ppsilv/Orion68/docs/VGA/pinout_PI_pico_2_01.jpg

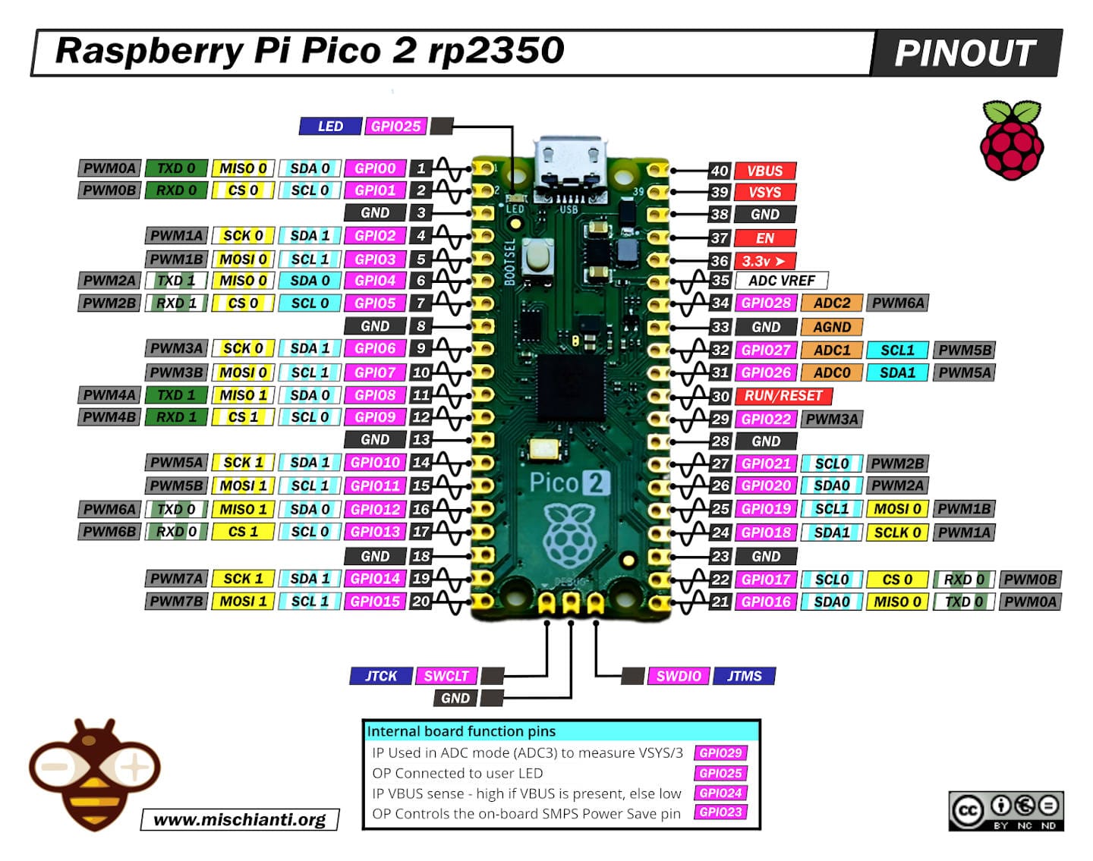
docs/VGA/pinout_PI_pico_2_01.jpg
