ppsilv/Orion68/docs/VGA/pinout_PI_pico_2.jpg

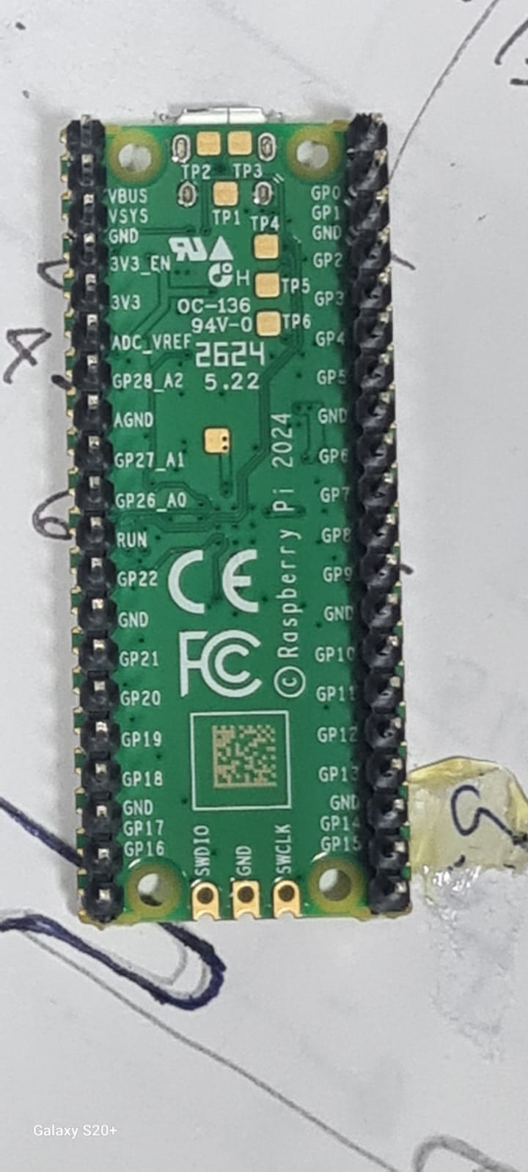
docs/VGA/pinout_PI_pico_2.jpg
