ppsilv/Orion68/README.md

# Orion68
Orion68 a litle system for mc68000

-software

|--dev

|    |--kernel -----> Ambiente de compilação do kernel e de aplicações para o kernel usando libc_pic

|    |--orioncore---> Ambiente de compilação do orioncor e de aplicações para o orioncore usando libcbios nopic

|--include

|--lib

|--libs

     |--libc_pic
     
     |--libm68
     
     |--liborion

2025/10/12: aparentemente essa foi a última versão que kernel carregou e rodou duart.elf
