ppsilv/Orion68/hardware/schematics/Readme.md

Terminação Passiva no Backplane:

    Mantenha o barramento "limpo" nas placas periféricas.
    No final do barramento físico (Slot 9), coloque as redes resistivas de 10k.
    Isso garante que, mesmo com o Orion68K vazio, os sinais críticos de controle não fiquem flutuando.

A Interface de Disco (MIDE/IDE):

    Hardware: Dois 74HC245 fazendo a ponte entre o barramento de dados do 68000 e o conector IDE.
    Byte-Swap: Desenhe as conexões invertidas entre os 245 e o conector (D15-D8 do 68k no D7-D0 do IDE).
    Atenção: No esquema, coloque uma nota bem visível sobre essa inversão para que, no futuro, você saiba que o acesso aos registros de 8 bits do IDE será feito via endereços pares (UDS ativo).
