ppsilv/Orion68/software/src/kernel/Docs/structure.md

## 🎯 **Resposta Curta:**

**A VFS (Virtual File System) e os drivers (NULL, zero, serial) DEVEM ficar no KERNEL.**

O que fica na **lib para usuário** são as **wrappers** (`fopen()`, `fwrite()`, `read()`, etc.) que fazem chamadas de sistema (syscalls) para o kernel.

---

## 🏗️ **Arquitetura Correta:**

```
+------------------------------------------+
|           PROGRAMA DE USUÁRIO             |
|  fopen(), fread(), fwrite(), fclose()     | ← Biblioteca C (libc)
+------------------+-----------------------+
                   | syscall (trap)
                   ↓
+------------------------------------------+
|              KERNEL (Orion68DOS)          |
|  sys_open(), sys_read(), sys_write()      | ← Sistema de Chamadas
+------------------+-----------------------+
|  VFS Layer (abstração)                    | ← Gerencia todos os arquivos
|  - mount points                           |
|  - file descriptors                       |
+------------------+-----------------------+
|  Drivers (device files)                   | ← Driver específico do hardware
|  - driver_null.c                          |
|  - driver_zero.c                          |
|  - driver_serial.c                        |
|  - driver_disk.c                          |
+------------------+-----------------------+
|           HARDWARE                        |
|  - UART, Disco, NULL, Zero               |
+------------------------------------------+
```

---

## 📚 **O que cada camada faz:**

### **1. Kernel: VFS + Drivers**

```c
// NO KERNEL (Orion68DOS):

// ============================================================
// VFS Layer - Gerencia todos os arquivos
// ============================================================
typedef struct {
    char name[32];
    int (*open)(const char *path, int flags);
    int (*read)(int fd, void *buf, size_t count);
    int (*write)(int fd, const void *buf, size_t count);
    int (*close)(int fd);
    // ...
} vfs_ops_t;

typedef struct {
    vfs_ops_t *ops;
    void *private_data;  // Dados específicos do driver
    int ref_count;
} file_handle_t;

// Tabela de arquivos abertos (no kernel)
file_handle_t file_table[MAX_FILES];

// ============================================================
// Drivers (implementam as operações VFS)
// ============================================================

// Driver NULL - /dev/null
int null_open(const char *path, int flags) { return 0; }
int null_read(int fd, void *buf, size_t count) { return 0; }  // Sempre 0 bytes
int null_write(int fd, const void *buf, size_t count) { return count; } // "Suce$$o"

vfs_ops_t null_ops = {
    .open = null_open,
    .read = null_read,
    .write = null_write,
    .close = null_close,
};

// Driver ZERO - /dev/zero
int zero_read(int fd, void *buf, size_t count) {
    memset(buf, 0, count);  // Preenche com zeros
    return count;
}

vfs_ops_t zero_ops = {
    .read = zero_read,
    // write não implementado (retorna erro)
};

// Driver SERIAL - /dev/ttyS0
int serial_open(const char *path, int flags) {
    // Inicializa UART
    uart_init();
    return 0;
}

int serial_read(int fd, void *buf, size_t count) {
    // Lê da UART
    return uart_read(buf, count);
}

int serial_write(int fd, const void *buf, size_t count) {
    // Escreve na UART
    return uart_write(buf, count);
}

vfs_ops_t serial_ops = {
    .open = serial_open,
    .read = serial_read,
    .write = serial_write,
    .close = serial_close,
};

// ============================================================
// Tabela de drivers registrados no VFS
// ============================================================
typedef struct {
    const char *path;
    vfs_ops_t *ops;
} device_table_t;

device_table_t devices[] = {
    {"/dev/null", &null_ops},
    {"/dev/zero", &zero_ops},
    {"/dev/ttyS0", &serial_ops},
    // ...
};

// ============================================================
// Chamadas de sistema (syscalls)
// ============================================================
int sys_open(const char *path, int flags) {
    // Procura o driver pelo path
    for (int i = 0; i < NUM_DEVICES; i++) {
        if (strcmp(path, devices[i].path) == 0) {
            // Encontrou! Abre o arquivo
            int fd = find_free_fd();
            file_table[fd].ops = devices[i].ops;
            file_table[fd].ops->open(path, flags);
            return fd;
        }
    }
    return -1;  // Arquivo não encontrado
}

int sys_read(int fd, void *buf, size_t count) {
    if (fd < 0 || fd >= MAX_FILES) return -1;
    if (file_table[fd].ops == NULL) return -1;
    return file_table[fd].ops->read(fd, buf, count);
}

int sys_write(int fd, const void *buf, size_t count) {
    if (fd < 0 || fd >= MAX_FILES) return -1;
    if (file_table[fd].ops == NULL) return -1;
    return file_table[fd].ops->write(fd, buf, count);
}

int sys_close(int fd) {
    if (fd < 0 || fd >= MAX_FILES) return -1;
    if (file_table[fd].ops == NULL) return -1;
    file_table[fd].ops->close(fd);
    file_table[fd].ops = NULL;
    return 0;
}
```

---

### **2. Biblioteca de Usuário (libc)**

```c
// NA LIBC (biblioteca do usuário):

// ============================================================
// Wrappers para syscalls (em assembly ou C)
// ============================================================
int open(const char *path, int flags) {
    // Chama syscall SYS_OPEN
    return syscall(SYS_OPEN, path, flags);
}

int read(int fd, void *buf, size_t count) {
    return syscall(SYS_READ, fd, buf, count);
}

int write(int fd, const void *buf, size_t count) {
    return syscall(SYS_WRITE, fd, buf, count);
}

int close(int fd) {
    return syscall(SYS_CLOSE, fd);
}

// ============================================================
// Funções de alto nível (usam as syscalls)
// ============================================================
FILE *fopen(const char *path, const char *mode) {
    int flags = mode_to_flags(mode);
    int fd = open(path, flags);
    if (fd < 0) return NULL;
    
    FILE *f = malloc(sizeof(FILE));
    f->fd = fd;
    // ... inicializa buffer, etc.
    return f;
}

size_t fread(void *ptr, size_t size, size_t nmemb, FILE *stream) {
    return read(stream->fd, ptr, size * nmemb);
}

size_t fwrite(const void *ptr, size_t size, size_t nmemb, FILE *stream) {
    return write(stream->fd, ptr, size * nmemb);
}

int fclose(FILE *stream) {
    int result = close(stream->fd);
    free(stream);
    return result;
}
```

---

### **3. Programa de Usuário**

```c
// PROGRAMA DE USUÁRIO (usa a libc):

#include <stdio.h>   // fopen, fread, etc.
#include <unistd.h>  // read, write (syscalls)

// Usando funções de alto nível (libc)
void test_high_level() {
    FILE *f = fopen("/dev/ttyS0", "r");
    if (f) {
        char buffer[256];
        fread(buffer, 1, 256, f);
        printf("Lido: %s\n", buffer);
        fclose(f);
    }
}

// Usando syscalls diretamente (também funciona)
void test_low_level() {
    int fd = open("/dev/null", O_WRONLY);
    if (fd >= 0) {
        write(fd, "Isso vai pro /dev/null", 22);
        close(fd);
    }
}
```

---

## ⚖️ **Por que no KERNEL e não na lib?**

| Razão | Explicação |
|---|---|
| **Privilégio** | Drivers acessam hardware (requer privilégio) |
| **Isolamento** | Um driver com bug não deve travar o sistema |
| **Compartilhamento** | Múltiplos processos usam o mesmo driver |
| **Segurança** | O kernel controla quem acessa o quê |
| **Uniformidade** | Todos os arquivos usam a mesma interface (VFS) |

---

## 🔍 **O que fica na lib do usuário?**

+-------------------------------+-----------+-------------------------------------+
| Componente | Onde fica | Exemplo |
|---|---|---|
| **VFS + Drivers** | KERNEL | open(), read(), write() syscalls |
+-------------------------------+-----------+-------------------------------------+
| **Syscall Wrappers**          | LIBC      | open(), read(), write() (funções C) |
|                               | TRAPS     | chamam as traps do SO               |
+-------------------------------+-----------+-------------------------------------+
| **Bufferização**              | LIBC      | fread(), fwrite() (com buffer)      |
+-------------------------------+-----------+-------------------------------------+
| **Formatação**                | LIBC      | printf(), scanf()                   |
+-------------------------------+-----------+-------------------------------------+
| **Gerenciamento de arquivos** | LIBC      | FILE* (malloc, etc.)                |
+-------------------------------+-----------+-------------------------------------+
---

## 🎯 **Cenário: Seu Orion68DOS**

**Seu sistema DEVE ter:**

```c
// NO KERNEL:
vfs_t vfs;                    // VFS no kernel
device_table_t devices[];     // Drivers no kernel
sys_open(), sys_read(), etc.; // Syscalls no kernel

// NA LIBC:
int open() { return syscall(SYS_OPEN, ...); }
int read() { return syscall(SYS_READ, ...); }
FILE *fopen() { ... }         // Usa open() syscall
```

**NÃO faça:**

```c
// NUNCA! (driver na lib do usuário)
// Isso quebra a segurança e o isolamento
int serial_write(...) {
    // Acessa hardware diretamente da lib!
    UART_DATA = data;  // ← ISSO É PERIGOSO!
}
```

---

## 💡 **Conclusão:**
+----------------------------------+----------------+----------------------------------------+
| Componente | Deve ficar no..| Por quê? |
|---|---|---|
| **VFS** | Kernel | Gerencia todos os arquivos do sistema  |
| **Drivers (NULL, ZERO, SERIAL)** | Kernel | Acessam hardware e recursos do sistema |
| **Syscalls (open, read, write)** | Kernel | Entrada para o kernel |
| **Wrappers (libc)** | Lib de usuário | Interface amigável para programas |
| **Bufferização (fopen, fread)**  | Lib de usuário | Performance (cache) |
+----------------------------------+----------------+----------------------------------------+
**Essa separação é FUNDAMENTAL para qualquer sistema operacional!** 🎯

## kernel structure
orion68dos/
├── kernel/
│   ├── include/
│   │   ├── limits.h     ← Coloque aqui
│   │   └── errno.h      ← Coloque aqui (opcional)
│   └── lib/
│       └── strtol.c
└── ...
