ppsilv/Orion68/docs/DriverInterfaceKernel.odt

Isso é **exatamente** o que o Linux faz e é uma sacada genial. Vou te mostrar como implementar isso no seu Orion68 de forma simples, sem precisar de ELF relocável completo (que é o que o Linux faz de verdade). Você tem **duas abordagens**:

## Abordagem 1: Tabela de símbolos "na mão" (mais simples e didática)

Em vez de exportar via ELF relocável, você cria uma **tabela de ponteiros para funções** com nomes, e o kernel disponibiliza essa tabela para os drivers. O driver faz `lookup("kmalloc")` e recebe o ponteiro.

### Passo 1: Estrutura da tabela

```c

/* kexports.h */

#ifndef KEXPORTS_H

#define KEXPORTS_H

#include <stdint.h>

typedef struct {

const char *nome;

void *endereco;

} kexport_t;

/* O driver chama isso para pegar o endereço de uma função do kernel */

void *kexport_lookup(const char *nome);

#endif

```

### Passo 2: Macro para registrar símbolos

```c

/* kexports.c */

#include "kexports.h"

#include <string.h>

#include <stddef.h>

/* Tabela em .data, preenchida pelo linker via seção .kexports */

extern kexport_t __kexports_start[];

extern kexport_t __kexports_end[];

void *kexport_lookup(const char *nome) {

kexport_t *p = __kexports_start;

while (p < __kexports_end) {

if (strcmp(p->nome, nome) == 0) {

return p->endereco;

}

p++;

}

return NULL;

}

```

### Passo 3: Macro para o kernel exportar

```c

/* kexports.h (continuação) */

#define EXPORT_SYMBOL(nome) \

static kexport_t __kexport_##nome \

__attribute__((section(".kexports"), used)) = { \

#nome, (void *)&nome \

}

```

Uso no kernel:

```c

/* kfunctions.c */

void *kmalloc(uint32_t size) { ... }

EXPORT_SYMBOL(kmalloc);

void kernel_puts(const char *s) { ... }

EXPORT_SYMBOL(kernel_puts);

void kernel_putchar(char c) { ... }

EXPORT_SYMBOL(kernel_putchar);

```

### Passo 4: Linker script coleta a seção

No seu `kernel.ld`, adicione:

```ld

.kexports : {

__kexports_start = .;

KEEP(*(.kexports))

__kexports_end = .;

} > USERRAM :text

```

### Passo 5: O driver consulta

Como o driver vai ser um **processo separado**, você precisa decidir como ele **acessa** essa tabela. Duas opções:

**Opção A: o kernel passa o endereço da tabela via syscall**

```c

/* no driver (user mode) */

typedef struct { const char *nome; void *endereco; } kexport_t;

kexport_t *tabela = (kexport_t *)sys_get_kexports();

void *kmalloc_ptr = NULL;

for (int i = 0; tabela[i].nome; i++) {

if (strcmp(tabela[i].nome, "kmalloc") == 0) {

kmalloc_ptr = tabela[i].endereco;

break;

}

}

```

Mas isso exige que o driver **possa ler a memória do kernel**, o que é OK no seu caso (sem MMU, tudo compartilha o mesmo espaço).

**Opção B: o kernel expõe uma syscall `kexport_lookup(nome)`**

```c

/* no driver (user mode) */

void *kmalloc_ptr = (void *)sys_kexport_lookup("kmalloc");

```

Isso é mais limpo e não expõe a tabela inteira. O kernel faz o lookup e devolve o ponteiro.

**Recomendo a Opção B** — é mais elegante e mais parecido com o que o Linux faz (o kernel resolve os símbolos, o módulo não precisa varrer nada).

Para o Orion68, dado o estágio atual:

| Abordagem | Complexidade | Quando usar |

| **Tabela de símbolos + `sys_kexport_lookup`** | Baixa | Agora, para aprender o conceito |

| **ELF relocável + relocação** | Alta | Depois, quando quiser o "estilo Linux" de verdade |

**Recomendo começar pela Abordagem 1 (Opção B)**. É simples, didática, e te dá 90% do benefício. Você:

1. Cria a tabela `.kexports` no kernel

2. Exporta `kmalloc`, `kernel_puts`, `kernel_putchar`, etc.

3. Adiciona uma syscall `sys_kexport_lookup(nome)` que devolve o ponteiro

4. O driver (rodando como processo) chama a syscall e guarda o ponteiro

5. O driver chama a função do kernel **diretamente** pelo ponteiro

Isso é **exatamente** o que o Linux faz, só que sem o ELF relocável. O driver pega o endereço via syscall em vez de via relocação no carregamento.

## Detalhe importante: chamar função do kernel de user mode

Se o driver roda em **modo usuário**, chamar diretamente uma função do kernel (via ponteiro) **pode não funcionar** se:

- A função do kernel usa instruções privilegiadas

- A função do kernel acessa a pilha do supervisor (SSP), não a do usuário

- A função do kernel depende de estar em modo supervisor

No seu caso, como você **não tem MMU** e provavelmente **tudo roda em supervisor** (você mesmo confirmou antes), chamar direto funciona. Mas se um dia você implementar modo usuário de verdade, vai precisar que essas funções sejam **syscalls** (trap) em vez de chamadas diretas.

**Ou seja**: a tabela de exportados é útil para **drivers que rodam em modo supervisor** (kernel modules). Para **drivers que rodam em modo usuário**, o acesso tem que ser via **syscall** (trap), não via ponteiro direto.

## Exemplo completo, mínimo

```c

/* kexports.h */

#ifndef KEXPORTS_H

#define KEXPORTS_H

#include <stdint.h>

typedef struct {

const char *nome;

void *endereco;

} kexport_t;

void *kexport_lookup(const char *nome);

#define EXPORT_SYMBOL(nome) \

static kexport_t __kexport_##nome \

__attribute__((section(".kexports"), used)) = { \

#nome, (void *)&nome \

}

#endif

```

```c

/* kexports.c */

#include "kexports.h"

#include <string.h>

extern kexport_t __kexports_start[];

extern kexport_t __kexports_end[];

void *kexport_lookup(const char *nome) {

kexport_t *p = __kexports_start;

while (p < __kexports_end) {

if (strcmp(p->nome, nome) == 0)

return p->endereco;

p++;

}

return NULL;

}

```

```ld

/* kernel.ld -- dentro de SECTIONS */

.kexports : {

__kexports_start = .;

KEEP(*(.kexports))

__kexports_end = .;

} > USERRAM :text

```

```c

/* kfunctions.c */

#include "kexports.h"

void *kmalloc(uint32_t size) { /* ... */ }

EXPORT_SYMBOL(kmalloc);

void kernel_putchar(char c) { /* ... */ }

EXPORT_SYMBOL(kernel_putchar);

```

```c

/* syscall no kernel */

void *sys_kexport_lookup(const char *nome) {

return kexport_lookup(nome);

}

```

```c

/* driver (user mode) */

void *(*meu_kmalloc)(uint32_t);

void driver_init(void) {

meu_kmalloc = (void *(*)(uint32_t))syscall(SYS_KEXPORT_LOOKUP, "kmalloc");

if (!meu_kmalloc) {

/* erro: kmalloc nao exportado */

}

void *p = meu_kmalloc(100);

/* ... */

}

```

## Resumindo

- **Kernel exporta** funções via macro `EXPORT_SYMBOL` numa seção `.kexports`.

- **Tabela** é coletada pelo linker e varrida em runtime.

- **Driver** pega o endereço via **syscall** `sys_kexport_lookup(nome)` (ou via tabela exposta, se preferir).

- **Driver chama** a função diretamente pelo ponteiro — funciona porque não há MMU e tudo está em supervisor.

- **Estilo Linux** (ELF relocável + relocação no `insmod`) é o próximo nível, bem mais complexo.

Isso te dá o mesmo poder do Linux (drivers carregáveis que usam funções do kernel) com **muito menos** código. Quando você tiver tempo e quiser o desafio, aí sim parte para o ELF relocável de verdade.

Se quiser, te ajudo a implementar a syscall `sys_kexport_lookup` e adaptar o `spawn` para passar a tabela de exports para o driver.
