ppsilv/Orion68/docs/SegundoHardDisk.odt

Boa pergunta — e a resposta é mais simples do que parece, porque aqui você não está sujeito às limitações reais de um dispositivo ATA físico. No ata.c os registradores são "feios" (offsets ímpares, CYL_HIGH/CYL_LOW/SECTOR_NUM em vez de LBA direto) porque isso é herança do padrão ATA real, com barramento de 16 bits e byte lane fixo. No seu caso, o Pico2W é firmware seu dos dois lados — você define o protocolo do zero, então pode fazer algo bem mais limpo.

## Por que menos registradores bastam

O SD card já é endereçado nativamente por LBA (bloco), não por CHS. Então você não precisa imitar CYL_HIGH/CYL_LOW/SECTOR_NUM — pode ter direto 3 ou 4 bytes de LBA.

## Mapa de registradores sugerido (base 0xFF9100)

Offset | Nome | R/W | Descrição
+0x00 | SD_REG_DATA | R/W | porta de dados, 1 byte por acesso
+0x01 | SD_REG_LBA0 | W | bits 0–7 do setor
+0x02 | SD_REG_LBA1 | W | bits 8–15
+0x03 | SD_REG_LBA2 | W | bits 16–23
+0x04 | SD_REG_LBA3 | W | bits 24–31 (opcional — só se seu cartão passar de 8GB com 24 bits)
+0x05 | SD_REG_COMMAND / SD_REG_STATUS | W / R | comando ao escrever, status ao ler (igual o ATA_REG_COMMAND/ATA_REG_STATUS do seu ata.c)

Isso dá 6 registradores, cabendo tranquilamente em qualquer faixa que seu 74HC138 decodifique (mesmo a menor faixa de A19-A21 sobra muito espaço).

## Bits sugeridos para COMMAND/STATUS

#define SD_CMD_READ_SECTOR 0x20 // mesmo valor do ATA_CMD_READ_SECTORS, só por familiaridade

#define SD_CMD_WRITE_SECTOR 0x30

#define SD_ST_BUSY 0x80

#define SD_ST_DATA_READY 0x08

#define SD_ST_ERROR 0x01

Você pode até reaproveitar os mesmos bits do ATA_ST_* que já tem — não precisa reinventar.

## O ponto que exige atenção: o BUSY tem que ser de verdade

Isso é o detalhe mais importante e mais fácil de esquecer: no ATA real, o BUSY reflete o hardware fazendo a operação de fato. No seu caso, o Pico2 é quem precisa simular esse comportamento corretamente no firmware:

1. 68k escreve LBA0..LBA3.
2. 68k escreve COMMAND (READ, por exemplo).
3. Pico2 imediatamente deve marcar BUSY=1 no registrador de status (antes de começar a ler o cartão SD).
4. Pico2 lê o setor do SD (isso pode levar alguns ms).
5. Quando os 512 bytes estiverem prontos num buffer interno do Pico, ele seta BUSY=0 e DATA_READY=1.
6. Só então o 68k começa a ler SD_REG_DATA 512 vezes.

Se o Pico não simular esse atraso de forma síncrona com o registrador de status, o seu ATA_WAIT() no lado do 68k vai ler dado lixo (igual aconteceria com um HD real se você ignorasse o BUSY).

## Uma vantagem que você pode aproveitar: 16 bits por acesso

No ata.c seu ATA_REG_DATA de 16 bits só funciona em modo 16-bit por causa de limitação do CF real. No Pico2 você controla os dois lados, então pode simplesmente sempre usar 16 bits no SD_REG_DATA (256 leituras em vez de 512) — mais rápido, sem precisar do go_8bits_mode()/ide_bus_mode que existe só por causa de compatibilidade com hardware ATA de verdade.

## Estrutura de código (paralela ao ata.c)

struct sd_drive drives[SD_MAX_DRIVES];

#define SD_REG_BASE 0x00FF9100

#define SD_REG_DATA ((volatile uint16_t *) (SD_REG_BASE + 0x00))

#define SD_REG_LBA0 ((volatile uint8_t *) (SD_REG_BASE + 0x02))

#define SD_REG_LBA1 ((volatile uint8_t *) (SD_REG_BASE + 0x03))

#define SD_REG_LBA2 ((volatile uint8_t *) (SD_REG_BASE + 0x04))

#define SD_REG_LBA3 ((volatile uint8_t *) (SD_REG_BASE + 0x05))

#define SD_REG_STATUS ((volatile uint8_t *) (SD_REG_BASE + 0x06))

#define SD_REG_COMMAND ((volatile uint8_t *) (SD_REG_BASE + 0x06))

Se quiser, o sd_read_sector()/sd_write_sector() ficam quase idênticos aos do ata.c, só troca o loop de 512 bytes por 256 words e não precisa do go_8bits_mode().

Pergunta antes de eu detalhar mais: você já tem definido o protocolo de comunicação entre o 68k e o Pico2 na ponta física (é bus paralelo tipo o do ATA, ou é SPI/algo serial "traduzido" para parecer bus paralelo pro 68k)? Isso muda um pouco como o BUSY precisa ser tratado no firmware do Pico.

Ótimo, 16+ endereços dá espaço de sobra. Agora dá pra fechar o desenho completo — e tem um ponto de arquitetura importante que aparece exatamente por causa do /DTACK ser controlado por GPIO do Pico.

## O ponto-chave: DTACK rápido ≠ operação rápida

Você pode atrasar o /DTACK à vontade, mas nunca deve atrasá-lo pelo tempo todo de uma leitura de setor do SD (isso pode levar alguns ms). Se você travar o 68k inteiro (via DTACK) por 2-5ms esperando o SD responder, o sistema todo congela — inclusive interrupções, o systick, etc.

Então a divisão de trabalho fica assim, igual você já faz com o ATA_WAIT():

1. DTACK rápido (microssegundos) — cobre só "o Pico leu/escreveu o byte que estava nesse endereço agora". Isso é hardware puro, sempre rápido.
2. BUSY em software (como hoje) — cobre "o SD está de fato lendo o cartão físico". O 68k continua fazendo polling no SD_REG_STATUS, exatamente como o ATA_WAIT() já faz.

Ou seja: escrever no COMMAND retorna rápido (DTACK imediato), o Pico começa a operação de SD em background, e o BUSY no status só cai quando o setor já está pronto num buffer interno do Pico.

## Mapa de registradores final (8 bits cada, endereçável pelas linhas A0-A3+ que você tem)

Addr | Nome | R/W | Descrição
0x0 | SD_REG_DATA | R/W | 1 byte por acesso — porta de dados do setor
0x1 | SD_REG_LBA0 | W | LBA bits 0–7
0x2 | SD_REG_LBA1 | W | LBA bits 8–15
0x3 | SD_REG_LBA2 | W | LBA bits 16–23
0x4 | SD_REG_LBA3 | W | LBA bits 24–31
0x5 | SD_REG_SECTOR_COUNT | W | quantos setores (deixa fixo em 1 por enquanto, mas já sobra espaço pra multi-setor depois)
0x6 | SD_REG_COMMAND / SD_REG_STATUS | W / R | igual seu ATA_REG_COMMAND/ATA_REG_STATUS

7 registradores usados, sobram 9+ endereços livres pra crescer (ex: um SD_REG_DRIVE_SELECT no futuro, já que seu drives[ATA_MAX_DRIVES] sugere que você quer suportar múltiplos dispositivos um dia).

## Fluxo de uma leitura de setor (visto do 68k)

*SD_REG_LBA0 = (uint8_t)(lba);

*SD_REG_LBA1 = (uint8_t)(lba >> 8);

*SD_REG_LBA2 = (uint8_t)(lba >> 16);

*SD_REG_LBA3 = (uint8_t)(lba >> 24);

*SD_REG_SECTOR_COUNT = 1;

*SD_REG_COMMAND = SD_CMD_READ_SECTOR;

while (*SD_REG_STATUS & SD_ST_BUSY) { } // igual seu ATA_WAIT(), mas aqui é o SD de fato trabalhando

if (*SD_REG_STATUS & SD_ST_ERROR) { /* trata erro */ }

for (int i = 0; i < 512; i++) {

buffer[i] = *SD_REG_DATA;

}

Reparou que isso é quase idêntico ao seu ata_read_sector() de hoje — a diferença é que aqui o BUSY é 100% real (o Pico está lendo o cartão), e não precisa do ATA_DELAY() arbitrário porque o /DTACK já garante que cada acesso individual é válido no momento certo.

## Do lado do firmware do Pico

Isso é bem parecido com o que você já fez no seu sistema atual de transferência de arquivo via PIO/FIFO (onde o Orion68DOS pede byte a byte e o Pico alimenta o FIFO) — mesma filosofia: um núcleo (ou a PIO) dedicado a responder o barramento rápido o suficiente pra não perder ciclo do 68k, enquanto o trabalho pesado (aqui, acesso ao SD; lá, TCP/IP) roda por fora, alimentando um buffer.

Faz sentido eu detalhar como estruturar esse lado do Pico (decodificação de endereço via GPIO, quando gerar o /DTACK pra cada tipo de registrador, e como organizar o buffer de 512 bytes)?

Adicionei tudo no final do próprio ata.c, mantendo o padrão que você já usa:

- sd_detect() — espelha o ata_detect()
- sd_read_sector(int sector, char *buffer) / sd_write_sector(int sector, const char *buffer) — mesma assinatura das funções ATA, só troca o BUSY-polling artificial (ATA_DELAY) pelo BUSY real do Pico
- sd_init(), sd_disk_status(), sd_disk_initialize() — espelham ata_init/ata_disk_status/ata_disk_initialize, usando drives[1] em vez de drives[0]

No seu diskio.c, o pdrv decide pra qual conjunto de funções chamar — exatamente como você já sabia:

DSTATUS disk_status(BYTE pdrv) {

switch (pdrv) {

case 0: return ata_disk_status();

case 1: return sd_disk_status();

}

return STA_NOINIT;

}

DRESULT disk_read(BYTE pdrv, BYTE *buff, LBA_t sector, UINT count) {

switch (pdrv) {

case 0: return ata_read_sector(sector, (char *)buff) ? RES_OK : RES_ERROR;

case 1: return sd_read_sector(sector, (char *)buff) ? RES_OK : RES_ERROR;

}

return RES_PARERR;

}

Duas coisas pra verificar antes de testar:

1. Offsets dos registradores — deixei espaçados de 1 byte (SD_REG_BASE + 0x0, +0x1, +0x2...). Se suas linhas de endereço para o Pico estiverem ligadas do mesmo jeito que estão pro ATA_REG_BASE (a partir de A1, pulando A0), você vai precisar multiplicar todos os offsets por 2, senão o Pico vai ver os endereços errados.
2. SD_ST_BUSY real — o SD_WAIT() aqui não tem o ATA_DELAY() de segurança que o ATA_WAIT() tem, porque assumi que o BUSY do Pico é confiável desde o primeiro ciclo depois do COMMAND. Se na prática o Pico levar alguns microssegundos pra sequer levantar o BUSY depois do comando, pode ser que o 68k já passe pelo while antes do bit subir — nesse caso, um pequeno delay entre escrever COMMAND e checar STATUS pela primeira vez resolve.

Principais mudanças em relação ao original:

- Char vs bloco separados dentro de "drivers" — bloco agora tem ide e sd, char ficou com os cinco dispositivos de stream.
- IRQ subindo — a linha tracejada da direita representa a interrupção voltando dos drivers char até o scheduler (tick do systick, dado do teclado chegando, etc.), coisa que não existia no diagrama anterior.
- fatfs entrou como camada entre vfs e o bloco — reflete que quem fala sertor/LBA é o driver, não o VFS.
- net stack entrou entre vfs/syscalls e o w5100 — sem essa camada a aplicação não teria como usar o chip de rede como socket.
- Seta direta syscalls → scheduler — cobre sleep/yield, que hoje não passam pelo task creator.

O que ficou de fora de propósito (pra não virar sopa de setas): o caminho exato char→syscalls (fica implícito, já que char não passa por VFS/FatFS) e a ligação de w5100 de volta pra rede — isso eu deixaria pra um segundo diagrama só de rede, se um dia você for implementar a pilha TCP/IP de verdade.

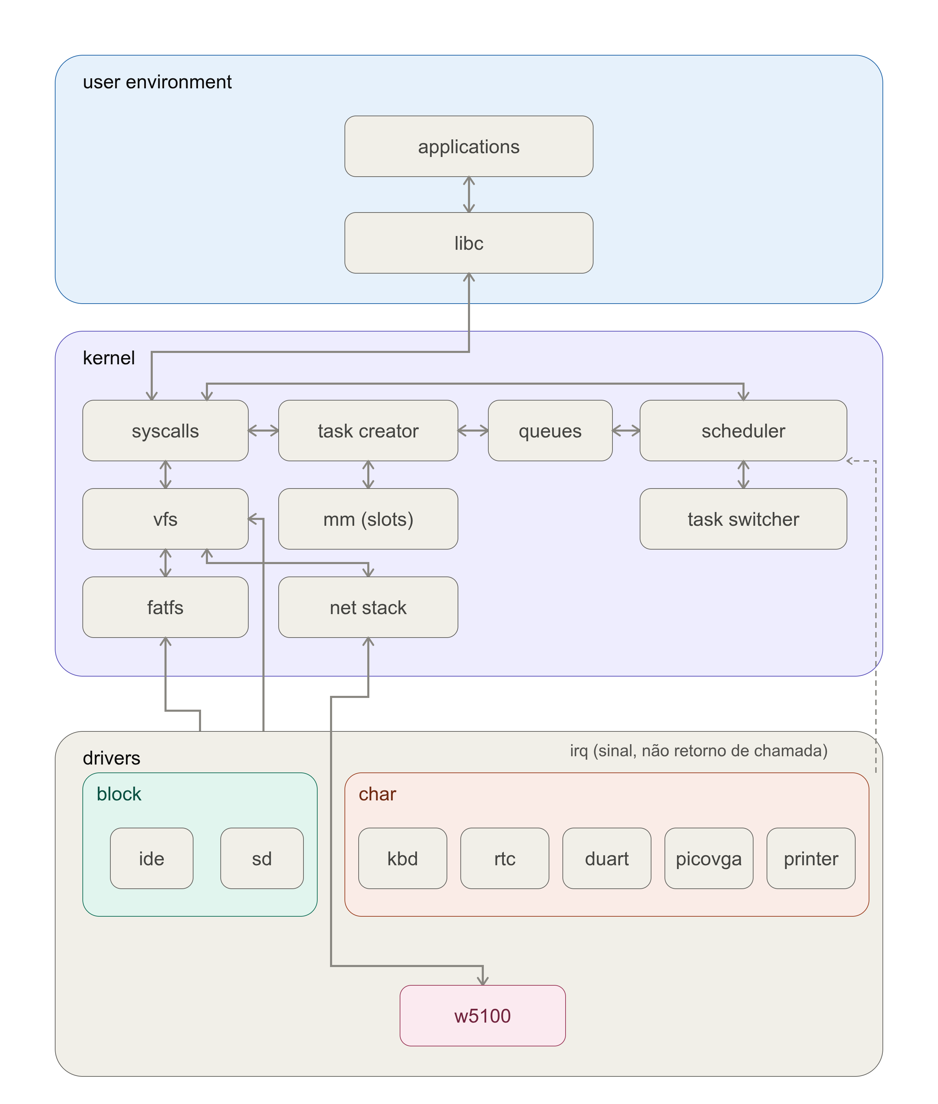
[picture p3: figure]
