ppsilv/Orion68/docs/interrup_with_74148.odt

Faz sentido! O 74LS148 é um codificador de prioridade "burro": enquanto o pino de entrada estiver em nível baixo, ele vai sustentar o código de interrupção nas saídas e manter o sinal para a CPU. Ele não tem memória (latch) e não sabe que a CPU já atendeu o chamado.

Se você ligar um sinal de clock direto no '148, assim que o clock subir (ou descer), a interrupção desaparece, mas isso é perigoso: se o sinal for curto demais, a CPU pode não ver; se for longo demais, a CPU termina o RTE e interrompe de novo imediatamente (interrupção fantasma).

Para usar o 74LS148 com sucesso, você precisa de um Flip-Flop (como o 74HC74) entre a fonte do tick e o codificador.

### O Fluxo de "Limpeza" (Acknowledge)

A lógica profissional para o Orion68K seria esta:

1. O Evento: O seu timer (ou o '393) envia um pulso para o pino de Clock de um Flip-Flop tipo D.
2. O Latch: O Flip-Flop joga a saída $Q$ para nível baixo (conectada a uma entrada do '148). Agora a interrupção está "travada".
3. O Reconhecimento: O 68000 entra no ciclo de IACK (Interruption Acknowledge). Ele sinaliza isso colocando as linhas de função FC0-FC2 em 111 e o endereço A1-A3 com o nível da interrupção.
4. A Limpeza: Você usa sua GAL para decodificar esse estado específico ($FC=7$) e gerar um sinal de Reset (ou Preset) para o Flip-Flop.

Assim que a GAL reseta o Flip-Flop, a entrada do '148 volta para nível alto e a interrupção é "limpa" automaticamente, sem que você precise escrever uma linha de código para isso na ISR.

### Como fazer sem o Flip-Flop (via vBug1)

Se você não quiser adicionar mais um chip de lógica (o 7474), pode fazer a limpeza via Software:

- O sinal do timer seta um Latch (pode ser um bit dentro da GAL).
- Na sua rotina de interrupção no vBug1, a primeira coisa que você faz é um MOVE.B para um endereço "mágico" (ex: $FFFFF0).
- A GAL detecta esse acesso ao endereço e reseta a interrupção.

### Por que o ATmega8 era atraente?

No ATmega, você provavelmente fazia isso via código, o que é flexível, mas introduz um delay de processamento (latência) entre o pedido e a entrega da interrupção para o 68k.

Minha recomendação:

Se você quer manter o Orion68K "puro sangue" com lógica discreta, use a GAL para monitorar os pinos FC0-FC2. É para isso que eles servem! Quando o 68000 "concorda" em atender a interrupção, ele avisa o hardware externo via FC, e a GAL dá o "tiro de misericórdia" no sinal de IRQ.

Você já tem os pinos de Function Code (FC0-FC2) do 68k puxados para a sua GAL de decodificação?

Excelente! Ter um 74HC74 sobrando é a peça que faltava no quebra-cabeça. Com ele, você cria um sistema de interrupção profissional, idêntico ao que grandes máquinas da época (como o Macintosh ou o Amiga) usavam para sincronizar o hardware com a CPU.

Aqui está o "mapa da mina" para ligar esses componentes:

### O Esquema de Ligação

1. O Gatilho (Clock do 7474):
  - Ligue a saída do seu timer (ou o sinal vindo do '393) no pino de Clock do Flip-Flop.
  - Mantenha a entrada D aterrada (GND) e o pino Set (PRE) em VCC ($5\text{V}$).
2. O Sinal de IRQ (Saída Q do 7474):
  - Ligue a saída Q (ou /Q, dependendo da lógica) em uma das entradas do 74LS148.
  - Quando o timer pulsar, o Flip-Flop "trava" o sinal de interrupção em nível baixo, avisando ao 68k que algo aconteceu.
3. A Limpeza (Reset do 7474):
  - Ligue o pino Reset (CLR) do 7474 a uma saída da sua GAL.

### A Lógica na GAL (O segredo do IACK)

Para que a interrupção seja limpa automaticamente, a GAL precisa detectar o ciclo de Interrupt Acknowledge (IACK). O 68000 sinaliza isso da seguinte forma:

- FC0, FC1, FC2 todos em nível ALTO ($111$).
- AS (Address Strobe) em nível BAIXO.
- A1, A2, A3 indicam qual nível de interrupção está sendo atendido.

Exemplo de equação na GAL (CUPL/ABEL):

C

/* Se você estiver usando Interrupção Nível 1 */

RESET_IRQ = FC0 & FC1 & FC2 & !A3 & !A2 & A1 & !AS;

Nota Técnica: Se você não quiser decodificar o nível específico (A1-A3), pode simplificar e resetar o Flip-Flop sempre que FC == 7 e AS estiver ativo. Como você só tem um timer, isso funciona perfeitamente e economiza pinos na GAL.

### Por que essa solução é superior?

1. Sem "Double Trigger": Mesmo que o timer seja rápido, a interrupção só será rearmada depois que a CPU terminar o ciclo atual e o Flip-Flop for resetado pela GAL.
2. Latência Zero: O 74LS148 recebe um sinal limpo e constante, permitindo que o 68k decida o momento exato de interromper baseado no seu registro de status ($SR$).
3. Hardware Síncrono: Você está usando os pinos de Function Code para o que eles foram projetados: indicar ao hardware externo o que a CPU está fazendo internamente.

Isso elimina completamente a necessidade de um microcontrolador externo (Atmega) para gerenciar o "aperto de mão" entre o clock e o processador.

Você já tem os pinos A1, A2 e A3 chegando na sua GAL de decodificação para fazer essa distinção de nível de interrupção?

Essa é uma excelente pergunta de arquitetura de sistemas. Em projetos mais simples, você até pode ignorar a decodificação do nível (A1-A3), mas em um sistema modular e expansível como o Orion68K, decodificar o nível específico traz três vantagens cruciais:

### 1. Evitar o "Reset Acidental" de outras interrupções

Se você tiver mais de um periférico que gera interrupção (por exemplo, o timer no Nível 1 e o teclado ou CompactFlash no Nível 2), o 68000 precisa saber qual deles está atendendo.

- Sem decodificação: Se você resetar o Flip-Flop apenas com FC=7, toda vez que qualquer interrupção ocorrer, a GAL vai mandar um sinal de reset para todos os Flip-Flops de interrupção da placa. Se a CPU estava atendendo o Nível 2, ela acabaria "matando" a interrupção do Nível 1 antes mesmo de ela ser processada.
- Com decodificação: A GAL só manda o reset para o Flip-Flop do timer se os pinos A1-A3 indicarem "001" (Nível 1).

### 2. Diferenciar Interrupções Autovetoriais de Vetoriais

O 68000 suporta dois modos de interrupção:

- Autovector: Onde o hardware apenas pede a interrupção e a CPU decide para onde pular.
- User Vector: Onde o periférico coloca no barramento de dados o endereço (vetor) da rotina.
  Ao decodificar os pinos de endereço durante o ciclo FC=7, sua GAL consegue gerenciar exatamente quando ativar o sinal de VPA (Valid Peripheral Address) para interrupções autovetoriais ou quando deixar o periférico colocar um vetor no barramento.

### 3. Ordem no Barramento (Daisy Chaining)

Se no futuro você adicionar uma placa de rede ou uma interface serial no seu backplane DIN 41612, você precisará que cada placa responda apenas ao seu próprio ciclo de IACK.

Ao usar os pinos A1, A2 e A3, você garante que o "aperto de mão" (handshake) entre a CPU e o hardware seja exclusivo. É o que chamamos de seletividade de barramento.

### Como a GAL "enxerga" isso

Na lógica da GAL, a diferença é apenas uma linha de código a mais. Imagine que seu timer está no Nível 2:

- Lógica Genérica (Perigosa): RESET = FC0 & FC1 & FC2 & !AS; (Reseta qualquer coisa se houver interrupção).
- Lógica Específica (Segura): RESET = FC0 & FC1 & FC2 & !A3 & A2 & !A1 & !AS; (Só reseta se a CPU confirmar que está atendendo especificamente o Nível 2).

### Minha Recomendação para o Orion68K

Como você está montando um sistema modular com backplane, vale a pena decodificar.

Isso dá ao seu vBug1 uma estabilidade muito maior. Se você tiver um ruído ou uma interrupção espúria em outro nível, o seu timer de sistema não será resetado por erro. Como você já vai ter que levar os sinais de FC para a GAL de qualquer forma, puxar as três linhas de endereço (A1-A3) é um esforço pequeno para um ganho imenso em robustez.

Você já reservou esses pinos de endereço na sua GAL principal ou ela já está muito cheia?

Com certeza. Vou estruturar o código para a GAL22V10, que é mais robusta para lidar com registradores. Como você vai usar o clock de $16\text{ MHz}$ para sincronizar tudo, o "Flip-Flop" interno será muito estável.

Note que declarei os pinos de saída sem a exclamação no cabeçalho. Assim, 1 no código significa 5V e 0 significa 0V. Isso facilita muito a vida na hora de medir com o multímetro.

### Código CUPL para o Orion68K (Interrupt Controller)

C

Name Orion68K_IRQ;

PartNo 001;

Date 19/04/2026;

Revision 01;

Designer pdsilva;

Company Homebrew;

Assembly None;

Location None;

Device P22V10; /* Compatível com PALCE22V10H */

/* *************** INPUT PINS *********************/

PIN 1 = CLK; /* Clock do sistema 16MHz para sincronizar o Flip-Flop */

PIN 2 = TICK_IN; /* Sinal vindo do 74HC393 (Borda de subida gera IRQ) */

PIN 3 = FC0; /* Function Codes para detectar IACK */

PIN 4 = FC1;

PIN 5 = FC2;

PIN 6 = AS; /* Address Strobe */

PIN 7 = A1; /* Endereços para identificar o Nível da IRQ */

PIN 8 = A2;

PIN 9 = A3;

/* *************** OUTPUT PINS *********************/

PIN 23 = IPL0; /* Para o 68000 (Nível 0 de interrupção) */

PIN 22 = IPL1; /* Para o 68000 (Nível 1 de interrupção) */

PIN 21 = IPL2; /* Para o 68000 (Nível 2 de interrupção) */

PIN 14 = IRQ1_S; /* Estado interno do Latch (Pino opcional para debug) */

/* *************** LOGIC ***************************/

/* 1. Detecção do Ciclo de Interrupt Acknowledge (IACK) Nível 1 */

/* O 68000 coloca FC=7 e o nível da interrupção em A1-A3 */

IACK1 = FC2 & FC1 & FC0 & !A3 & !A2 & A1 & !AS;

/* 2. Lógica do Flip-Flop Interno (Registrado) */

/* Se houver um pulso em TICK_IN, ligamos a interrupção. */

/* Se houver um IACK1, desligamos imediatamente. */

/* Mantemos o estado atual se nada disso acontecer. */

IRQ1_S.D = (TICK_IN & !IACK1) # (IRQ1_S & !IACK1);

/* 3. Saídas IPL para o 68000 (Lógica Negativa no processador) */

/* Sem interrupção: IPL0=1, IPL1=1, IPL2=1 (Código 000 no 68k) */

/* Nível 1 Ativo: IPL0=0, IPL1=1, IPL2=1 (Código 001 no 68k) */

IPL2 = 1; /* Mantém 5V */

IPL1 = 1; /* Mantém 5V */

/* Se o estado da interrupção for 1, o pino IPL0 cai para 0V */

IPL0 = !IRQ1_S;

### Explicação dos Detalhes Técnicos:

1. Sincronismo: Como você está usando IRQ1_S.D, esse sinal só muda na subida do clock de $16\text{ MHz}$ ligado ao pino 1. Isso evita "glitches" no barramento.
2. O sinal TICK_IN: O ideal é que esse sinal vindo do '393 seja um pulso curto. Se ele ficar em nível alto por muito tempo, a CPU pode terminar a interrupção e encontrar o sinal de "set" ainda ativo, disparando a interrupção de novo. Se notar isso, podemos ajustar a lógica para detectar apenas a borda.
3. A1-A3: O código está configurado para responder especificamente ao Nível 1. Se o seu vBug1 estiver configurado para outro nível, basta mudar a combinação de A1-A3 na linha do IACK1.
4. Tensão de saída: Como declaramos IPL0 = !IRQ1_S, quando a interrupção "acorda" (IRQ1_S = 1), a conta lógica resulta em zero, e a GAL aterra o pino físico, exatamente o que a corrente do 68k precisa para detectar o pedido.

Agora é só compilar no WinCUPL e gravar na sua PALCE22V10H. Como está a pinagem na sua placa? Esses pinos que eu sugeri batem com o que você já tem roteado?
