ppsilv/Orion68/docs/layout_orion68.odt

Boa iniciativa — separar "onde o código é escrito/compilado" de "o que efetivamente vai pro cartão" é exatamente a mesma distinção que existe em qualquer SO real (fonte do kernel Linux vs. / de uma instalação rodando). Aqui vão as duas árvores:

## 1. Árvore de desenvolvimento (repositório GitHub)

Orion68/

├── apps/ # programas de teste/utilitários (duart.c, etc)

├── docs/

├── include/ # headers compartilhados (elf.h, fileio.h, slots.h...)

│

├── kernel/

│ ├── drivers/ # drivers "de alto nível", chamam orioncore por baixo

│ │ ├── ata.c

│ │ ├── fatfs/ # FatFS de terceiros, vendorizado

│ │ └── console.c

│ ├── elf/

│ │ ├── loader_pic.c # (ou elfload+elfreloc_m68k, sua escolha atual)

│ │ └── elfreloc_m68k.c

│ ├── mm/

│ │

│ ├── proc/

│ │ ├── task_create.c # Task_CreateFromElf

│ │ └── spawn.c

│ ├── scheduler/

│ │ ├── ctx_switch.s # OS_StartHighRdy, OS_TickISR

│ │ ├── os_yield.s

│ │ └── scheduler.c

│ ├── sync/

│ │ └── mutex.c

│ ├── syscall/

│ │ ├── syscall_table.c # dispatch via D0

│ │ └── syscall_trap.s # TRAP #0 handler

│ └── vfs/

│ ├── vfs.c # open/read/write/ioctl unificados

│ └── inode.c # struct inode em memória (cache)

│ └── slots.c # Slots_Alloc/Slots_BaseAddr

│

├── libs/

│ ├── klib/ # utilitários só do KERNEL (não expostos a user space)

│ ├── libc/ # libc68k_pic — fopen, printf, malloc...

│ ├── libio/ # I/O de alto nível (puts, putchar...)

│ ├── libm/ # matemática

│ ├── librtc/

│ └── libvideo/

│

├── orioncore/ # bootstrap em ROM/EEPROM (antiga "BIOS")

│ ├── boot.S # primeiro código a rodar, inicializa hardware mínimo

│ ├── vectors.S # tabela de vetores de exceção do 68k

│ └── drivers_raw/ # acesso cru a hardware (serial, ATA, RTC, vídeo)

│ ├── ata_raw.c

│ ├── serial_raw.c

│ ├── rtc_raw.c

│ └── video_raw.c

│

│

├── shell/

│ ├── shell.c # parsing, prompt

│ ├── redir.c # redirecionamento

│ ├── pipeline.c # pipes

│ └── builtins/ # cd, ls, etc

│

│

│

├── tools/ # scripts de build, mkfs, elf2bin, linker scripts

│ └── linker/

│ └── app.ld

│

│

└── Makefile

## 2. Árvore de deploy (o que vai gravado no cartão CompactFlash)

/ (raiz do FatFS, montada pelo orioncore no boot)

├── KERNEL.BIN # imagem do kernel, carregada pelo orioncore

│

├── BIN/ # executáveis .elf prontos pra rodar

│ ├── SHELL.ELF

│ ├── DUART.ELF

│ └── ...

│

├── DEV/ # arquivos de METADADO de device (não são "arquivos" de verdade)

│ ├── SERIAL0 # baudrate=9600 / databits=8 / parity=none...

│ ├── RTC0

│ └── VIDEO0

│

├── ETC/ # configuração do sistema

│ ├── BOOT.CFG # o que o orioncore/kernel carrega automaticamente

│ └── AUTOEXEC # comandos rodados pelo shell no login/boot

│

├── HOME/ # área do usuário

│

└── TMP/

## Por que separei assim

- orioncore/ fica fora da árvore de deploy — ele não é um "arquivo" no disco, é gravado direto na EEPROM/flash, fisicamente separado do cartão CF. Só existe no repositório de desenvolvimento.
- KERNEL.BIN é o único binário "especial" no deploy — o orioncore sabe carregar especificamente esse arquivo (ou nome fixo equivalente) pra iniciar o resto do sistema.
- DEV/ reflete exatamente a ideia que discutimos: arquivos que são metadado de configuração, lidos uma vez no open(), não dados de fluxo real.
- Mantive nomes em maiúsculas de até 8 caracteres na árvore de deploy — se seu FatFS não tiver suporte a nomes longos habilitado, isso evita qualquer restrição de 8.3; se você já tem LFN habilitado, pode usar nomes mais descritivos (serial0.cfg, boot.cfg) sem problema.

Quer que eu ajuste alguma pasta (por exemplo, se seu slots.c deveria ficar em outro lugar, ou se o shell vai ter subpastas de builtins mais elaboradas)?
