ppsilv/Orion68/docs/memory_map.odt

ORION68K MEMORY MAP

1MB I/O I/O 0xF00000 | FFFFFF F00000
Free address space 0x8FFFFF | EFFFFF 600000
Slot 5 1MB RAM RAM 0x500000 | 5FFFFF 500000
Slot 4 1MB RAM RAM 0x400000 | 4FFFFF 400000
Slot 3 1MB RAM RAM 0x300000 | 3FFFFF 300000
Slot 2 1MB RAM RAM 0x200000 | 2FFFFF 200000
Slot 1 1MB RAM RAM 0x100000 | 1FFFFF 080000
Slot 0 64KB ROM 32KWords of rom ROM 0x000000 | 07FFFF 000000
