ppsilv/Orion68/docs/proj_description.odt

## Sobre o hardware — seu projeto está ficando muito interessante

Pelo que você descreveu, o Orion68 já parece um computador modular completo:

CPU

- baseado na Motorola 68000

Memória

- ROM: 16 MB → planejando 64 MB
- SRAM: 1 MB → planejando 2–3 MB

Glue logic

- GAL
- 74HC138

Comunicação

- 4 portas seriais com XR16C554 Quad UART

Expansão

- backplane com 96 pinos
- até 5 ou 9 placas

Vídeo

- interface experimental com Raspberry Pi Pico

Isso é praticamente a arquitetura de mini-computadores modulares clássicos.

## Uma ideia legal para o projeto

Já que você escolheu Orion68, poderia nomear as placas também:

Exemplo:

Orion68-CPU
placa da CPU

Orion68-MEM
placa de RAM/ROM

Orion68-IO
UART / portas seriais

Orion68-VID
placa de vídeo com Pico

Orion68-BP
backplane

Isso é exatamente como sistemas antigos faziam (VME, Multibus, etc).

# 1️⃣ Interface CompactFlash para 68000

A CompactFlash funciona em modo IDE, então ela pode ser ligada quase diretamente ao barramento.

## Conceito

A CF é vista como um dispositivo IDE de 16 bits.

Conexões principais:

68000 CompactFlash

D0–D15 <----> D0–D15

A1–A3 ----> A0–A2

/AS + decode ----> /CS0

/RW ----> /IORD /IOWR

RESET ----> RESET

Como o 68000 usa UDS/LDS em vez de A0, normalmente fazemos:

A1 → CF A0

A2 → CF A1

A3 → CF A2

## Decodificação típica

Exemplo de endereço:

E00000 – E0000F

Mapa interno:

E00000 DATA

E00002 ERROR / FEATURES

E00004 SECTOR COUNT

E00006 SECTOR NUMBER

E00008 CYLINDER LOW

E0000A CYLINDER HIGH

E0000C DRIVE / HEAD

E0000E STATUS / COMMAND

## Circuito mínimo recomendado

Componentes:

CompactFlash socket

74HC245 (buffer de dados)

74HC138 (decode de endereço)

GAL (chip select)

Sinais importantes:

DTACK → gerado quando CF responde

IORD → leitura

IOWR → escrita

Perfeito. Agora estamos entrando na parte realmente interessante de arquitetura de computadores. Vou montar isso pensando especificamente no Orion68, usando o Motorola 68000, de forma que seja realista de construir em hardware.

# 2️⃣ Vídeo estilo workstation 1987 (framebuffer real)

Em vez de usar um chip de vídeo clássico, uma workstation normalmente usa framebuffer na RAM.

Arquitetura simples:

CPU 68000

│

│ memory bus

│

+----+--------------------+

| Framebuffer RAM |

| (ex: 512 KB) |

+----+--------------------+

│

│

Video Controller

│

│

VGA output

Hoje você pode fazer o controlador de vídeo com:

- Raspberry Pi Pico
- ou um CPLD/FPGA.

## Resolução recomendada

Para começar:

640 x 480

8 bits por pixel

Memória necessária:

640 × 480 × 1 byte

= 307200 bytes

≈ 300 KB

Então:

512 KB framebuffer

é perfeito.

## Mapeamento de memória

C00000 – C7FFFF Framebuffer (512 KB)

## Escrita de pixel

Exemplo em C:

uint8_t *fb = (uint8_t*)0xC00000;

fb[y*640 + x] = color;

Isso é muito simples e muito rápido.

# 3️⃣ Sistema de boot estilo BIOS

Computadores dos anos 80 tinham um firmware tipo BIOS.

Estrutura típica:

RESET

│

├─ inicializar hardware

│

├─ testar RAM

│

├─ detectar dispositivos

│

├─ inicializar vídeo

│

├─ inicializar storage

│

└─ carregar sistema operacional

## Fluxo de boot Orion68

ROM Monitor

│

│

detect CF card

│

read sector 0

│

load bootloader

│

jump to OS
