ppsilv/Orion68/docs/Raspi_pi_pico.odt

Sim — essa arquitetura que você descreveu é muito boa e é exatamente como muitos periféricos clássicos funcionavam com o MC68000. Usar A1–A6 como índice de registrador e D0–D7 como barramento de dados cria um periférico de 64 registradores de 8 bits, o que já é bastante espaço para controlar vários subsistemas dentro do RP2040.

Vou estruturar isso para ficar claro.

# 1️⃣ Interface proposta (excelente)

Barramento entre 68000 e RP2040:

A1–A6 → endereço de registrador (64 registradores)

D0–D7 ↔ dados

R/W → direção

/AS → início do ciclo

/LDS → byte baixo válido

CS → seleção do dispositivo

DTACK ← acknowledge

Total de pinos aproximado:

A1–A6 6

D0–D7 8

R/W 1

/AS 1

/LDS 1

CS 1

DTACK 1

20 pinos

Isso cabe tranquilamente no RP2040.

# 2️⃣ Espaço de registradores

Com A1–A6 você tem:

2^6 = 64 registradores

Exemplo de mapa:

00 SYS_STATUS

01 SYS_CONTROL

02 TIMER0_LOW

03 TIMER0_HIGH

04 TIMER1_LOW

05 TIMER1_HIGH

06 IRQ_STATUS

07 IRQ_ENABLE

08 GPIO_DATA

09 GPIO_DIR

10 VGA_CMD

11 VGA_DATA

12 SD_CMD

13 SD_DATA

14 I2C_CMD

15 I2C_DATA

Ainda sobrariam muitos registradores.

# 3️⃣ Escrita na RAM interna do RP2040 (VRAM)

Sua ideia de usar registradores para escrever na memória interna do RP2040 é exatamente o que GPUs antigas faziam.

Exemplo de registradores:

20 VRAM_ADDR_LOW

21 VRAM_ADDR_HIGH

22 VRAM_DATA

23 VRAM_CTRL
24 VIDEO_PAGE_DISPLAY
25 VIDEO_PAGE_DRAW
26 VIDEO_SWAP

Fluxo no MC68000:

MOVE.B #$00,VRAM_ADDR_LOW

MOVE.B #$10,VRAM_ADDR_HIGH

MOVE.B #$FF,VRAM_DATA

O RP2040 grava esse byte na VRAM interna.

# 4️⃣ Melhor ainda: auto-incremento

Você pode criar um registrador que auto incrementa o endereço de VRAM.

Assim o 68000 escreve blocos rapidamente.

VRAM_ADDR_LOW

VRAM_ADDR_HIGH

VRAM_DATA_AUTO

Então o código vira:

loop:

MOVE.B (A0)+,VRAM_DATA_AUTO

DBRA D0,loop

Isso é muito eficiente.

# 5️⃣ VGA controlado pelo RP2040

O RP2040 pode gerar VGA com:

PIO

DMA

RAM interna

Arquitetura:

MC68000 → registradores → RP2040

RP2040 → framebuffer → VGA

O 68000 apenas atualiza a memória de vídeo via registradores.

# 6️⃣ Exemplo de modos gráficos possíveis

Com os 264 KB de RAM do RP2040:

Modo texto:

80x30 caracteres

Modo gráfico simples:

320x240 8-bit

Ou:

640x480 4-bit

# 7️⃣ Detecção do ciclo

O PIO do RP2040 pode observar:

CS = 0

/AS = 0

/LDS = 0

Então:

1. lê A1–A6
2. verifica R/W
3. executa operação
4. gera DTACK

# 8️⃣ Latência

O MC68000 aceita wait states facilmente.

Então o RP2040 pode responder em:

200–400 ns

Sem problemas.

# 9️⃣ O resultado arquitetural

Você cria basicamente um chipset completo:

MC68000

│

│ barramento

│

Pico 2 (RP2350)
├ VGA
├ framebuffer A
├ framebuffer B
├ SD card
├ timers
├ interrupções
├ periféricos

├ GPIO

├ I2C

└ sensores

# 🔟 Uma pequena recomendação

Eu acrescentaria um registrador:

FIFO_DATA

Implementando um FIFO entre o 68000 e o RP2040.

Isso facilita muito para:

- enviar comandos
- transferir dados
- streaming de vídeo.

MC68000

│

├ RAM

├ UARTs

│

└ RP2040

├ VGA

├ SD card

├ timers

├ interrupções

├ I2C

└ sensores

✅ Conclusão:
Sua ideia de interface A1–A6 + D0–D7 + sinais de controle é perfeita para ligar o 68000 ao RP2040 e criar um chipset moderno com poucos pinos.

💡 Se quiser, posso também te mostrar um truque usado em placas 68000 modernas que permite ao RP2040 gerar VGA 640×480 usando menos de 10 pinos e apenas resistores, sem DAC nenhum — é um circuito absurdamente simples e muito elegante.

Perfeito — com essa interface o MC68000 pode acessar a SRAM interna do RP2350 através de registradores de ponte (window registers). Essa técnica é muito usada em GPUs e controladores antigos: o CPU não vê a RAM diretamente, ele escreve endereço + dados em registradores e o chip faz a gravação interna.

Vou mostrar uma implementação limpa.

# 1️⃣ Interface física (como você definiu)

Barramento:

A1–A6 → índice de registrador

D0–D7 ↔ dados

R/W → leitura ou escrita

/AS → ciclo de barramento

/LDS → byte válido

CS → seleciona o Pico

DTACK ← acknowledge

Isso dá 64 registradores de 8 bits.

# 2️⃣ Registradores para acesso à SRAM

Reserve alguns registradores para formar um ponteiro de memória.

Exemplo:

00 MEM_ADDR0 (bits 7..0)

01 MEM_ADDR1 (bits 15..8)

02 MEM_ADDR2 (bits 23..16)

03 MEM_DATA

04 MEM_DATA_AUTO

Isso permite endereçar até:

16 MB

Muito mais do que a SRAM real do Pico.

# 3️⃣ Escrita simples na memória

Fluxo no MC68000:

1️⃣ escrever endereço

MOVE.B #$34,MEM_ADDR0

MOVE.B #$12,MEM_ADDR1

MOVE.B #$00,MEM_ADDR2

Endereço interno:

0x001234

2️⃣ escrever dado

MOVE.B #$AA,MEM_DATA

O RP2350 grava:

sram[0x001234] = 0xAA

# 4️⃣ Escrita sequencial (muito mais rápida)

Crie um registrador com auto incremento:

MEM_DATA_AUTO

Funcionamento:

write data

store byte

addr++

Exemplo no 68000:

MOVE.B #$00,MEM_ADDR0

MOVE.B #$20,MEM_ADDR1

MOVE.B #$00,MEM_ADDR2

loop:

MOVE.B (A0)+,MEM_DATA_AUTO

DBRA D0,loop

Isso permite copiar blocos grandes.

# 5️⃣ Leitura da memória

Mesma lógica.

Registrador:

MEM_DATA

Quando o 68000 lê:

MOVE.B MEM_DATA,D0

O Pico faz:

D0 = sram[address]

# 6️⃣ Mapeamento de registradores (exemplo)

Com A1–A6:

00 MEM_ADDR0

01 MEM_ADDR1

02 MEM_ADDR2

03 MEM_DATA

04 MEM_DATA_AUTO

08 VIDEO_PAGE

09 VIDEO_SWAP

10 TIMER0

11 TIMER1

20 GPIO_DATA

21 GPIO_DIR

Ainda sobra bastante espaço.

# 7️⃣ Lógica dentro do Pico

Quando ocorre um ciclo:

CS = 0

AS = 0

LDS = 0

Fluxo:

reg = A1..A6

if write:

data = D0..D7

execute(reg,data)

if read:

data = read_register(reg)

colocar em D0..D7

Depois:

DTACK = 0

para finalizar o ciclo.

# 8️⃣ Implementação típica do registrador MEM_DATA_AUTO

Pseudo-código:

case MEM_DATA_AUTO:

if write:

sram[mem_addr] = data

mem_addr++

if read:

data = sram[mem_addr]

mem_addr++

# 9️⃣ Performance

Mesmo com barramento de 8 bits, isso funciona bem porque:

- o MC68000 pode operar com wait states
- o Pico executa a gravação em poucos ciclos

Para transferências grandes você pode atingir taxas boas.

# 🔟 Arquitetura resultante

MC68000

│

│ registradores

│

Pico 2

│

SRAM interna

│

framebuffer

O 68000 enxerga a SRAM como uma janela controlada por registradores.

✅ Essa técnica tem várias vantagens:

- usa poucos pinos
- interface simples
- permite acessar qualquer região da SRAM
- fácil de expandir para vídeo, buffers, etc.

💡 Existe um refinamento muito usado em hardware gráfico antigo:
criar duas janelas de memória simultâneas (por exemplo SRC_ADDR e DST_ADDR) para permitir operações como blit e copy block diretamente no Pico. Isso transforma o Pico numa pequena GPU 2D para o 68000. Se quiser, posso te mostrar essa arquitetura porque ela encaixa perfeitamente no seu sistema.
