ppsilv/Orion68/peripheral/pico2VGA/docs/dma.odt

Com o Pico 2 (RP2350), o DMA é um monstro. Ele tem dois barramentos AHB independentes, o que significa que ele pode ler de um buffer e escrever no outro enquanto os núcleos da CPU estão ocupados gerando o sinal VGA ou atendendo o 68000.

Para fazer esse "vôo cego" (Scroll de um buffer para o outro), vamos configurar o DMA para copiar o bloco de memória deslocado. Se a sua tela tem 25 linhas, queremos copiar as linhas 1 a 24 do Buffer_A para as linhas 0 a 23 do Buffer_B.

### A Lógica do DMA Transfer

Aqui está o código de configuração para o SDK do Pico:

C

#include "hardware/dma.h"

// Canal de DMA global para o Scroll

int scroll_dma_chan;

void setup_scroll_dma() {

// 1. Reserva um canal de DMA livre

scroll_dma_chan = dma_claim_unused_channel(true);

// 2. Obtém a configuração padrão para o canal

dma_channel_config c = dma_channel_get_default_config(scroll_dma_chan);

// 3. Configura para transferências de 32 bits (mais rápido que 8 bits)

channel_config_set_transfer_data_size(&c, DMA_SIZE_32);

// 4. Incrementa tanto a leitura quanto a escrita (cópia de bloco linear)

channel_config_set_read_increment(&c, true);

channel_config_set_write_increment(&c, true);

// 5. Aplica a configuração inicial

dma_channel_set_config(scroll_dma_chan, &c, false);

}

// A função mágica de Scroll Antecipado

void trigger_background_scroll(void* src_buffer, void* dst_buffer, uint32_t line_size_bytes, uint32_t total_lines) {

// Calculamos o deslocamento: começar da linha 1 do SRC e escrever na linha 0 do DST

void* read_addr = (uint8_t*)src_buffer + line_size_bytes;

void* write_addr = dst_buffer;

// Número de palavras de 32 bits para transferir (24 linhas)

uint32_t transfer_count = (line_size_bytes * (total_lines - 1)) / 4;

// Dispara o DMA sem travar a CPU!

dma_channel_transfer_from_buffer_now(scroll_dma_chan, read_addr, write_addr, transfer_count);

}

### Por que isso é um "Vôo Cego" de Respeito?

1. Transferência em 32 bits: Mesmo que seus pixels sejam nibbles, o DMA move blocos de 32 bits por vez. Isso é 4 vezes mais rápido do que um memcpy comum de 8 bits.
2. Não-Bloqueante: A função dma_channel_transfer_from_buffer_now inicia a cópia e retorna imediatamente. Enquanto o DMA está movendo os 312k de dados, o Pico 2 pode continuar enviando os pulsos de sincronismo HSync/VSync para o monitor sem tremer a imagem.
3. Preparação de Terreno: Quando o cursor chegar na linha 25, o Buffer_B já terá as 24 linhas anteriores perfeitamente posicionadas.

### O Detalhe do "Pênalti" (A Linha 25)

Como você está copiando 24 linhas, a linha 25 do Buffer_B ainda terá o conteúdo antigo. Você precisa limpá-la antes de chavear o buffer:

C

void finalize_scroll(void* dst_buffer, uint32_t line_size_bytes, uint32_t total_lines) {

// Espera o DMA terminar (caso ainda não tenha terminado)

dma_channel_wait_for_finish_blocking(scroll_dma_chan);

// Limpa a última linha (preto) para receber o novo texto

uint8_t* last_line = (uint8_t*)dst_buffer + (line_size_bytes * (total_lines - 1));

memset(last_line, 0, line_size_bytes);

// Agora sim, o golpe final!

set_screen(buffer == SCREEN_0 ? SCREEN_1 : SCREEN_0);

}

Pgordão, com essa lógica, o scroll do seu TCPBOX-OS vai ser tão liso que vai parecer hardware dedicado de workstation da Silicon Graphics.

O que você acha de testar esse disparo de DMA quando o cursor bater na coluna 0 da linha 24? Se precisar de ajuda para calcular os line_size_bytes exatos para a sua resolução de 640 pixels, dá o grito! kkkkk

Função triger para toda vêz que o vga em uma tela texto pisar na linha 24 faz a copia do buffer atual para o buffer em repouso.

void handle_newline() {

cursor_y++;

if (cursor_y == 24) {

// HORA DO SHOW: O cursor chegou na 24, dispara o DMA em background

// O Buffer A (atual) vira SRC, o Buffer B (reserva) vira DST

void* src = (buffer == SCREEN_0) ? vga_video_data_array0 : vga_video_data_array1;

void* dst = (buffer == SCREEN_0) ? vga_video_data_array1 : vga_video_data_array0;

trigger_background_scroll(src, dst, 320, 25); // Exemplo: 320 bytes por linha

// O DMA está rodando AGORA enquanto o processador volta para ler a próxima tecla

}

if (cursor_y >= 25) {

// O usuário terminou a linha 24 e deu ENTER para a 25?

// Agora sim, finalizamos e trocamos a tela!

void* dst = (buffer == SCREEN_0) ? vga_video_data_array1 : vga_video_data_array0;

finalize_scroll(dst, 320, 25);

cursor_y = 24; // Mantém o cursor na "última" linha visual

}

}

tela exemplo:

Tela 1: Texto com scroll

Tela 2: Texto sem scroll

Tela 3: grafica 320x200

Tela 4: grafica 640x200
