ppsilv/Orion68/peripheral/pico2VGA/docs/i2c.odt

Usar os pinos GP26 e GP27 que pertencem ao barramento I2C1.

Para usar esses pinos em C com o Pico SDK, você precisa inicializar o hardware i2c1 e dizer ao SDK que esses pinos específicos devem ser tratados como funções I2C (e não como GPIOs comuns ou entradas analógicas ADC).

### 💻 Exemplo em C (Pico SDK)

Este código configura o I2C1 nos pinos 26 e 27, define uma frequência de 100 kHz e tenta ler o ID de um dispositivo escravo.

C

#include <stdio.h>

#include "pico/stdlib.h"

#include "hardware/i2c.h"

// Definindo os pinos e a instância correta

#define I2C_PORT i2c1

#define PIN_SDA 26

#define PIN_SCL 27

int main() {

stdio_init_all();

// 1. Inicializa o I2C1 a 100kHz

i2c_init(I2C_PORT, 100 * 1000);

// 2. Configura a função dos pinos para I2C

gpio_set_function(PIN_SDA, GPIO_FUNC_I2C);

gpio_set_function(PIN_SCL, GPIO_FUNC_I2C);

// 3. Habilita os pull-ups internos (útil se o módulo não tiver)

gpio_pull_up(PIN_SDA);

gpio_pull_up(PIN_SCL);

printf("I2C inicializado nos pinos GP26 (SDA) e GP27 (SCL)\n");

while (true) {

// Exemplo: Varredura ou leitura de dados aqui

uint8_t data;

int ret = i2c_read_blocking(I2C_PORT, 0x3C, &data, 1, false);

if (ret >= 0) {

printf("Dispositivo respondendo no endereço 0x3C!\n");

}

sleep_ms(1000);

}

return 0;

}

### ⚠️ Notas Importantes para esses pinos:

1. Compartilhamento com ADC: Os pinos GP26 e GP27 também são canais de entrada analógica (ADC0 e ADC1). Quando você usa gpio_set_function(..., GPIO_FUNC_I2C), o Pico desliga a leitura analógica para priorizar a comunicação digital.
2. CMakeLists.txt: Não esqueça de adicionar hardware_i2c na seção target_link_libraries do seu arquivo CMake, senão o código não irá compilar.
3. Tensão: Lembre-se que o Pico opera a 3.3V. Se o seu sensor I2C for de 5V, você precisará de um conversor de nível lógico para não danificar o GP26/27.

Raspberry Pi Pico: Lendo EDID via I2C em C

Se o negócio é performance bruta e controle direto de hardware, vamos de C com o SDK oficial do Raspberry Pi Pico. No mundo dos sistemas embarcados, o C é o "rei" .

Para ler o I2C no Pico usando C, utilizaremos a biblioteca hardware/i2c.h.

### 1. Preparação do Código em C

Aqui está um exemplo funcional para ler os 128 bytes do EDID (endereço 0x50) e despejá-los no terminal serial:

C

#include <stdio.h>

#include "pico/stdlib.h"

#include "hardware/i2c.h"

// Definições de Hardware

#define I2C_PORT i2c0

#define SDA_PIN 4

#define SCL_PIN 5

#define ADDR_MONITOR 0x50

int main() {

stdio_init_all();

// Inicializa o I2C a 100kHz (padrão DDC)

i2c_init(I2C_PORT, 100 * 1000);

gpio_set_function(SDA_PIN, GPIO_FUNC_I2C);

gpio_set_function(SCL_PIN, GPIO_FUNC_I2C);

// Habilita Pull-ups internos (útil se não tiver resistores externos)

gpio_pull_up(SDA_PIN);

gpio_pull_up(SCL_PIN);

uint8_t edid_data[128];

while (true) {

printf("\nTentando ler monitor no endereco 0x%02x...\n", ADDR_MONITOR);

// No I2C do monitor, enviamos o ponteiro 0x00 para começar do início da memória

uint8_t reg = 0x00;

int ret = i2c_write_blocking(I2C_PORT, ADDR_MONITOR, &reg, 1, true);

if (ret < 0) {

printf("Erro: Monitor nao respondeu (NACK).\n");

} else {

// Lê os 128 bytes do bloco EDID

i2c_read_blocking(I2C_PORT, ADDR_MONITOR, edid_data, 128, false);

printf("Dados recebidos:\n");

for (int i = 0; i < 128; i++) {

printf("%02x ", edid_data[i]);

if ((i + 1) % 16 == 0) printf("\n");

}

}

sleep_ms(5000); // Aguarda 5 segundos para a próxima leitura

}

}

### 2. O arquivo CMakeLists.txt

Para compilar isso, você precisa configurar o CMake para incluir a biblioteca de hardware:

CMake

cmake_minimum_required(VERSION 3.13)

include(pico_sdk_import.cmake)

project(read_vga_project C CXX ASM)

pico_sdk_init()

add_executable(read_vga main.c)

# Linkar as bibliotecas necessárias

target_link_libraries(read_vga pico_stdlib hardware_i2c)

pico_add_extra_outputs(read_vga)

### 3. Considerações Críticas (O "Pulo do Gato")

Ao trabalhar com C no Pico para I2C, fique atento a estes pontos que costumam travar o código:

- Pinos: Verifique se os pinos que você escolheu no código (GP4 e GP5) correspondem fisicamente ao barramento i2c0. Se usar GP2/GP3, por exemplo, o código não funcionará sem trocar a porta.
- Timeouts: A função i2c_read_blocking pode travar o processador se o barramento ficar "preso" em nível lógico baixo. Em um ambiente de produção, usamos versões com timeout.
- Nível Lógico: Novamente, lembre-se: o Pico é 3.3V. Se você injetar os 5V diretos do pino 9 do VGA nos pinos de dados sem um divisor de tensão ou level shifter, há um risco real de queimar o GPIO do Pico.

### Como testar:

1. Compile e gere o arquivo .uf2.
2. Arraste para o Pico em modo BOOTSEL.
3. Abra um monitor serial (como o PuTTY ou o Serial Monitor do VS Code) na porta COM do Pico para ver os bytes hexadecimais aparecendo.
