ppsilv/Orion68/peripheral/pico2VGA/docs/LDS_UDS.odt

Barramento de Dados 68000: Byte Alto e Baixo

Vamos lá, esse é o teste real para ver se a lógica do 68000 "clicou" na sua cabeça. Usando o seu exemplo exato:

### O Cenário

- Endereço 0x0001: Contém o dado 0x34.
- Ação: Ler 8 bits (Byte) do endereço 0x0001.

### A Resposta

1. Qual sinal ativa? Ativa o $\overline{LDS}$ (Lower Data Strobe).
2. Em quais bits do barramento de dados o 0x34 aparece? Ele aparece nos bits D0 a D7 (o byte baixo do barramento de 16 bits).

### Por que isso acontece? (A anatomia do 68k)

O 68000 enxerga a memória em "Words" (16 bits), mas ele as organiza de forma Big-Endian. Imagine que o processador olha para o endereço 0x0000 e vê uma Word inteira composta pelos endereços 0x0000 e 0x0001.

- O byte PAR (0x0000) é o "Upper Byte" e viaja pelos fios D15-D8. Ele é controlado pelo $\overline{UDS}$.
- O byte ÍMPAR (0x0001) é o "Lower Byte" e viaja pelos fios D7-D0. Ele é controlado pelo $\overline{LDS}$.

### Como ficaria a Tabela de Verdade para o seu exemplo:

Endereço | Dado | No Barramento de 16 bits | Sinal Ativado
0x0000 | 12 | Aparece em D15-D8 | $\overline{UDS}$
0x0001 | 34 | Aparece em D7-D0 | $\overline{LDS}$
0x0002 | 56 | Aparece em D15-D8 | $\overline{UDS}$
0x0003 | 78 | Aparece em D7-D0 | $\overline{LDS}$

### Onde o seu projeto com o Pico entra nisso?

Se o seu Raspberry Pi Pico estiver conectado apenas aos pinos D0-D7 do 68000 (usando um 74HC245), o 68000 só conseguirá "falar" com ele através de endereços ÍMPARES (0x0001, 0x0003, etc.).

Se o código do 68000 tentar escrever no endereço 0x0000 (Par), o dado vai sair pelos fios D15-D8, e como o seu Pico não estaria ligado neles, o dado se perderia no "vazio".

Dica de mestre: Se você quer usar apenas 8 bits no Pico, mapeie o endereço do periférico na sua GAL para um endereço ímpar. Assim, toda vez que o software do 68000 escrever naquele endereço, o sinal $\overline{LDS}$ será ativado, o 74HC245 abrirá os dados de D7-D0, e o Pico receberá o valor certinho.

Faz sentido essa separação entre o que é o "endereço na memória" e "qual fio o dado usa"? Se quiser, posso te mostrar como a GAL deve filtrar isso para o Pico não ler lixo quando o 68000 estiver falando com o endereço par.
