ppsilv/Orion68/software/dev/kernel/Docs/syscall.odt

Vou ser honesto: eu não "conheço" um OrionOS com syscalls definidas — o que eu tenho é tudo que você foi me contando ao longo das nossas conversas (VFS com open/read/write, redirecionamento com >/>>, FatFS com atributos tipo f_chmod, RTC, o scheduler que acabamos de ligar com sleep/yield indo direto pro scheduler e spawn passando pelo task creator/elfload). Baseado nisso, monto uma proposta de tabela de dispatch por D0 — não é a lista "oficial", é o que dá pra deduzir do que você já construiu, pra você ajustar.

## Processo / task (usa o scheduler que acabamos de ligar)

# | nome | assinatura | o que faz

0 | SYS_EXIT | exit(int code) | chama OS_TaskExit()
1 | SYS_SPAWN | spawn(char *path) | carrega um .elf via seu loader/elfload e cria a task
2 | SYS_SLEEP | sleep(int ticks) | bloqueia a task atual (OS_TaskBlock) por N ticks do systick
3 | SYS_YIELD | yield(void) | força OS_Schedule sem sair da fila de prontas
4 | SYS_WAIT | wait(int pid) | (futuro) espera uma task filha terminar

## Arquivo / VFS (bloco e char passam pelo mesmo caminho — "tudo é arquivo")

# | nome | assinatura | o que faz

10 | SYS_OPEN | open(char *path, int flags) | resolve no VFS; se for /dev/algo, cai no driver char; senão vai pro FatFS
11 | SYS_CLOSE | close(int fd) | libera o descritor
12 | SYS_READ | read(int fd, void *buf, int len)
13 | SYS_WRITE | write(int fd, void *buf, int len)
14 | SYS_SEEK | seek(int fd, int offset, int whence) | só faz sentido pra arquivo de bloco, não pra char
15 | SYS_IOCTL | ioctl(int fd, int cmd, void *arg) | pra configuração específica de driver que não é ler/escrever (baud rate da DUART, modo de vídeo da picoVGA)
16 | SYS_DUP | dup(int fd_old, int fd_new) | pro seu redirecionamento >/>> no shell
17 | SYS_UNLINK | unlink(char *path) | apaga arquivo (FatFS)
18 | SYS_CHMOD | chmod(char *path, int attrs) | bate com o f_chmod/RDO-HID-SYS que você já validou funcionar

## Tempo

# | nome | assinatura | o que faz

20 | SYS_GETTIME | gettime(struct tm *out) | lê a RTC
21 | SYS_SETTIME | settime(struct tm *in) | ajusta a RTC

## O que fica de fora de propósito

- Sem fork — como você não tem MMU e o isolamento é por slot fixo de 256K, fork não tem muito sentido; spawn/exec cobre o caso de uso real que você quer.
- Sem malloc via syscall — cada task já ganha seu slot inteiro na criação; se um dia você quiser heap dinâmico dentro do slot, isso pode ficar só na libc (um sbrk interno da task), sem precisar de trap.
- Threads — você mencionou que quer suporte a threads, mas isso é uma decisão de design que ainda falta (threads dividem o mesmo slot/endereço, task não). Prefiro não inventar SYS_THREAD_CREATE sem saber se pra você "thread" significa dividir o slot da task pai ou é outro conceito.

Quer que eu detalhe primeiro a assinatura em C de alguma dessas structs (tipo struct tm pro RTC, ou os flags do open), ou prefere fechar a lista de nomes/números primeiro e deixar os detalhes de assinatura pra quando for implementar cada trap?

=
