ppsilv/Orion68/software/src/kernel/Docs/videobios.odt

SPECIAL CHARACTERS / CONTROL CODES

Standard ASCII is implemented for the main character set. Extended ASCII codes are implemented the same as for DOS. Control codes are standard ASCII where applicable - other codes added to allow control of the screen. The full implementation is shown below:

Video display control codes:
Hex (Decimal) and meaning
01 (01) - Cursor home (Standard ASCII)
02 (02) - Define cursor character (2nd byte is the curs character, or 00 to turn off) <--New for 3.0
03 (03) - Cursor blinking
04 (04) - Cursor solid
05 (05) - Set graphics pixel (next two bytes = x,y) <--New for 3.0
06 (06) - Reset graphics pixel (next two bytes = x,y) <--New for 3.0
08 (08) - Backspace (Standard ASCII)
09 (09) - Tab (Standard ASCII)
0A (11) - Linefeed (Standard ASCII)
0C (12) - Clear screen (Standard ASCII)
0D (13) - Carriage return (Standard ASCII)
0E (14) - Set column 0 to 79 (2nd byte is the column number) or 0 to 39 for a 40 char line
0F (16) - Set row 0 to 24 (2nd byte is the row number)
10 (16) - Delete start of line
11 (17) - Delete to end of line
12 (18) - Delete to start of screen
13 (19) - Delete to end of screen
14 (20) - Scroll up
15 (21) - Scroll down
16 (22) - Scroll left
17 (23) - Scroll right
18 (24) - Set font attribute for the current line (see elsewhere on this page (http://searle.x10host.com/MonitorKeyboard/index.html#FontAttributes) for details) <--New for 3.0
1A (26) - Treat next byte as a character (to allow PC DOS char codes 1 to 31 to be displayed on screen)
1B (27) - ESC - reserved for ANSI sequences
1C (28) - Cursor right
1D (29) - Cursor Left
1E (30) - Cursor up
1F (31) - Cursor down
20 (32) to 7E (126) - Standard ASCII codes
7F (127) - Delete
80 (128) to FF (255) - PC (DOS) extended characters

So, to print "Hello" at column 18, row 10 on the monitor in BASIC would be as follows:
PRINT CHR$(14) ; CHR$(17) ; CHR$(15) ; CHR$(9) ; "HELLO"

Some ANSI/VT100 escape sequences have been implemented to allow programs such as Wordstar etc. to run on the CPM machine. The ones implemented are shown below (Esc = character 1B Hex, 27 decimal):
Esc[Line;ColumnH or Esc[Line;Cf moves cursor to that coordinate
Esc[J=clear from cursor down
Esc[1J=clear from cursor up
Esc[2J=clear complete screen
Esc[K = erase to end of line
Esc[1K = erase to start of line
Esc[L = scroll down
Esc[M = scroll up
Esc- = turn off ANSI interpreter - NEEDED IF USING GRAPHICS otherwise char 1B can't be sent to the display <--New for 3.0

The above example can also be implemented using escape sequences instead...
PRINT CHR$(27) ; "[18;10H" ; "HELLO"

The character font is not the same as supplied by Daryl. I recreated the complete normal and bold fonts from a bitmap of 8x8 characters for a CGA PC display (using a small VB program). Most appear identical, so I assume we used a similar source. However, I have included all characters, including those normally reserved for control codes.

ASCII codes 00 to 1F (and 7F) are reserved for control. However, the character map also has display characters with these values. These characters can be displayed by sending code 1A (26 decimal) before sending the code for the character. This prefix tells the display processor to store the actual character into the display and not treat it as a control code.
eg. in BASIC, to display the heart symbol (at 03) you can use the following...
PRINT CHR$(26) ; CHR$(3)

FONT ATTRIBUTES

Each line can have it's own font defined. Cannot have mixed font types on the same line.
This can be:
40 Character normal
80 Character normal
40 Character bold
80 Character bold
40 Character normal double-height
80 Character normal double-height
40 Character bold double-height
80 Character bold double-height
