ppsilv/Orion68/software/dev/orioncore/README.md

Orioncor: Nessa versão carrega o kernel.sys que executa 3 task A,B e C.
