ppsilv/Orion68/software/dev/orioncore/apps_env_orioncor/apps_orioncor/README.md

## 2026-09-08
        Orioncor: seu shell roda aplicação nopic
        para rodar aplicação fPIC tem que carregar um shell compilado nopic que
        esteja preparado para rodar aplicação fPIC.

##  2026-09-08
#   Applications on this directory are compiling an running OK
        all aplications here works well when you press Delete when
        orioncore start to run, this is offline mode of the system
        you can run software from harddisk to start, configure
        system.
