ppsilv/Orion68/hardware/schematics/board_mem/RELEASE.md

Pitfalls para Rev.: B
 pino 29 memoria at28c256 não tem configuração para VCC
