ppsilv/Orion68/docs/SchematicDescriptions.odt

① - CPU reset

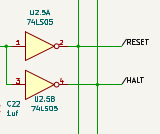
[picture p12: figure]

Figure: 1

The reset system for M68K must held the cpu at least 300ms in zero state.

CPU HALT and RESET pins receive the same signal at begining but from a 74LS05 diferent pins, this means that the reset signal is applied to 2 pins of 74LS05. See figure 1.

When Atmega8 receive a ZERO in PC4 it will wait at least 300ms and them assert PC5 to ONE.

② The /VPA signal is generated whan FC0,FC1 and FC2 are all in ONEs states.

③ The CHIP U2.2 must have:
* Motherboard code wk/year project code(4 digits) rev(letter+number A0)

* Bios code wk/year project code(4 digits) rev(letter+number A0)

*

① ② ③ ④ ⑤ ⑥ ⑦ ⑧ ⑨ ⑩
⑪ ⑫ ⑬ ⑭ ⑮ ⑯ ⑰ ⑱ ⑲ ⑳

㉑ ㉒ ㉓ ㉔ ㉕ ㉖ ㉗ ㉘ ㉙ ㉚
㉛ ㉜ ㉝ ㉞ ㉟

㊱ ㊲ ㊳ ㊴ ㊵
㊶ ㊷ ㊸ ㊹ ㊺
㊻ ㊼ ㊽ ㊾ ㊿
