ppsilv/Orion68/peripheral/pico2VGA/docs/pinout_vga.odt

Pinagem VGA DB15: Guia Completo

Entender a pinagem de um conector VGA (DB15) é essencial para quem precisa consertar cabos, criar adaptadores ou entender como o sinal de vídeo analógico funciona.

Embora o padrão digital (HDMI/DisplayPort) domine hoje, o VGA ainda é o "guerreiro" em muitos projetores e monitores industriais. O conector é tecnicamente um DE-15 (3 linhas de 5 pinos), mas popularmente chamado de DB15.

### Pinagem Detalhada (Padrão de Cores)

Aqui está o que cada pino faz e as cores de fio mais comuns encontradas dentro de um cabo padrão:

Pino | Função | Descrição | Cor Comum
1 | RED | Vídeo Vermelho (75 ohm) | Vermelho (Grosso/Coaxial)
2 | GREEN | Vídeo Verde (75 ohm) | Verde (Grosso/Coaxial)
3 | BLUE | Vídeo Azul (75 ohm) | Azul (Grosso/Coaxial)
4 | ID2/RES | Reservado (ou Monitor ID 2) | —
5 | GND | Terra (Geral/Digital) | Preto
6 | RGND | Terra do Vermelho | Malha do Vermelho
7 | GGND | Terra do Verde | Malha do Verde
8 | BGND | Terra do Azul | Malha do Azul
9 | KEY/PWR | +5V DC (Alimentação DDC) | Amarelo ou Laranja
10 | SGND | Terra do Sincronismo | Branco
11 | ID0/RES | Reservado (ou Monitor ID 0) | —
12 | SDA | Dados I²C (DDC) | Verde (fino)
13 | HSYNC | Sincronismo Horizontal | Cinza ou Marrom
14 | VSYNC | Sincronismo Vertical | Roxo ou Transparente
15 | SCL | Clock I²C (DDC) | Amarelo (fino)

### Dicas para Manutenção ou Soldagem

1. Sinais Analógicos de Cor (1, 2, 3): Esses fios costumam ser mini-coaxiais. A "alma" (fio central) vai no pino, e a malha externa (blindagem) vai no pino de terra correspondente (6, 7 e 8). Isso evita fantasmas na imagem.
2. Sincronismo (13 e 14): Se a imagem está "rolando" ou não fixa na tela, o problema geralmente está nestes dois pinos. Eles são sinais TTL que dizem ao monitor onde cada quadro começa.
3. DDC (Canal de Dados): Os pinos 12 e 15 permitem que o monitor diga ao computador qual é a sua resolução nativa. Sem eles, o Windows pode identificar o monitor apenas como "Monitor Genérico PnP" e limitar a resolução.

Nota: Se você estiver montando um cabo e a imagem ficar amarelada, o pino 3 (Azul) provavelmente está com solda fria ou rompido. Se ficar ciano (azul-piscina), o pino 1 (Vermelho) falhou.
