ppsilv/Orion68/docs/elfload_SO.odt

Você não está errado — o modelo que descreveu é exatamente correto, e bate mais com Windows/DLL do que com Linux/.so mesmo, porque Windows tradicionalmente não usa GOT dinâmica calculada em runtime com resolução de nome complexa a cada carga — ele usa uma tabela de importação (IAT) que aponta pra endereços que o loader do sistema já sabe de antemão (ou resolve uma vez, no LoadLibrary), e depois é só ligação direta. É praticamente o seu cenário.

## Onde seu elfload já ajuda, e onde falta uma peça

Seu elfreloc_m68k.c (o el_applyrela que escrevemos) já faz a parte mecânica certa: percorre as entradas de relocação, olha o tipo (R_68K_GOT16O), e escreve um valor no slot da GOT. O que falta é só de onde vem esse valor quando o símbolo não é interno ao programa.

Hoje, o código assume (via r_addend + task_base) que o símbolo já é conhecido dentro do próprio binário. Pra símbolo de uma lib compartilhada, a entrada de relocação teria um símbolo indefinido (st_shndx == SHN_UNDEF na tabela de símbolos) — ou seja: "essa GOT slot precisa do endereço de printf, mas printf não está definido aqui dentro, vai procurar em outro lugar".

## O fluxo completo, seguindo exatamente sua ideia

1. Boot do kernel: carrega libc.so (ou o nome que você quiser) uma vez, endereço físico fixo, monta a tabela nome_da_função → endereço em memória do kernel
2. elfload carregando o programa: ao encontrar uma relocação GOT16O cujo símbolo é SHN_UNDEF, em vez de calcular task_base + valor_interno, ele lê o nome do símbolo (você já faz isso no seu process_relocations antigo — sym_name via strtab_offset) e dispara uma trap nova (SYS_RESOLVE_SYMBOL ou algo assim), passando o nome
3. Kernel responde com o endereço já conhecido daquela função (lookup na tabela montada no boot)
4. elfload escreve esse endereço no slot da GOT — pronto, ligação feita, sem nunca reabrir o arquivo da lib

## O ajuste concreto que falta em el_applyrela

case R_68K_GOT16O:

if (símbolo é SHN_UNDEF) {

uint32_t addr = trap_resolve_symbol(sym_name); // nova syscall

*patch_addr = addr;

} else {

*patch_addr = rela->r_addend + ctx->base_load_paddr; // caso atual, símbolo interno

}

break;

Isso exige que el_applyrela também tenha acesso à tabela de símbolos (symtab/strtab) pra ler o nome — hoje ele só recebe a entrada de relocação (Elf_RelA), não o contexto de símbolos completo. É uma extensão de assinatura, não um redesenho.

## Um atalho que seu sistema (sem ASLR, sem MMU) te permite, mais simples que tudo isso

Como você mesmo notou antes: seus endereços são fixos e conhecidos. Isso significa que você nem precisa de lookup em runtime — poderia resolver isso em tempo de link, criando uma "lib de import" no seu toolchain (um .a fininho com só declarações extern apontando pros endereços fixos conhecidos da libc.so residente), e o m68k-elf-ld já resolveria isso estaticamente, sem trap nenhuma, sem elfload precisar saber nada de símbolo externo em runtime. Isso é mais parecido com "linkagem estática contra endereço fixo" do que com dynamic linking de verdade — mais simples de implementar, ao custo de exigir recompilação se o endereço da lib mudar algum dia.

Pergunta prática pra decidir o esforço: você prevê que o endereço/versão da libc.so residente vá mudar com frequência (o que justificaria o lookup dinâmico via trap), ou ela seria "gravada uma vez, endereço fixo pra sempre" nessa fase do projeto (o que justificaria o atalho mais simples)?
