ppsilv/Orion68/docs/Gal_boot.odt

Sobre o seu mapa de memória, você tocou no ponto clássico do MC68000: ele exige que os vetores de reset (SSP e PC) estejam no endereço $000000 na inicialização, mas para rodar um sistema operacional como o CP/M-68K, é muito mais prático ter RAM no início do mapa.

Para resolver isso com uma GAL22V10, precisamos implementar um Flip-Flop de sobreposição (Overlay).

### A Lógica do Projeto

1. Estado de Reset: No momento do hardware reset, um sinal (que chamaremos de BOOT_MODE) deve ser ativado. Enquanto ele estiver ativo, qualquer acesso à faixa baixa ($000000) é desviado para a ROM.
2. Troca de Contexto: Assim que o código da ROM rodar as primeiras instruções, ele faz um acesso a um endereço específico de I/O (ou uma escrita em um registrador) que desativa o BOOT_MODE.
3. Estado Normal: Com o BOOT_MODE desativado, a SRAM assume o endereço $000000 e a ROM fica fixa em $E00000.

### Sugestão de Arquivo GALasm

Assumindo que você usará uma saída da GAL para manter o estado do "Boot" (usando um pino como registrador/flip-flop):

GAL16V8

ORION68K

; Entradas

; 1 2 3 4 5 6 7 8 9 10

4MHZ A20 A21 A22 A23 AS RW RESETIN BOOTIN GND

; Saídas (Pinos 12 a 19)

; 11 12 13 14 15 16 17 18 19 20

NC D1 DTACK RESET RD KILLBT IOCS RAMCS ROMCS VCC

;EQUATIONS

; Saída para "matar" o boot no 74HC74 (Pino 15)

; Ativa quando acessa o espaço de I/O em F00000

KILLBT = A23 & A22 & A21 & A20 & !AS

; ROM_CS (Ativa em 0xE00000 ou em 0x000000 se BOOTIN=1)

; Nota: Usei BOOTIN (vinda do 74HC74) no lugar de BOOT interno

; ROM_CS (Ativa em E00000 ou no endereço 0 se BOOTIN=1)

!ROMCS = !AS & A23 & A22 & A21 & !A20 # !AS & !A23 & !A22 & !A21 & !A20 & BOOTIN

; RAM_CS (Ativa se for área 000000-1FFFFF E NÃO for a janela de BOOT da ROM)

!RAMCS = !AS & !A23 & !A22 & !A21 & !BOOTIN # !AS & !A23 & !A22 & !A21 & A20

; Exemplo de IOCS para periféricos em F00000

!IOCS = A23 & A22 & A21 & A20 & !AS

; Na GAL16V8 modo registrado: Pino 1 = Clock (4MHz), Pino 11 = /OE (GND)

; Criamos um "shift register" interno

; D1 vai a zero assim que o AS desce, mas sincronizado com o clock

D1.R = AS

; DTACK só desce um ciclo de clock depois de D1

DTACK.R = D1

RESET = !RESETIN

!RD = RW

DESCRIPTION

Decodificador combinacional para Orion68k usando Flip-Flop externo.

Mudanças:

O Mapa de Memória do Orion68 ficou assim:

Faixa de Endereço Dispositivo Sinal Ativo

0x000000 - 0x0FFFFF ROM (se BOOT=1) / RAM (se BOOT=0) !ROMCS / !RAMCS

0x100000 - 0x1FFFFF RAM (Sempre) !RAMCS

0xE00000 - 0xEFFFFF ROM (Sempre - Espaço de BIOS) !ROMCS

0xF00000 - 0xFFFFFF I/O (CH376, VGAPico, etc) !IOCS

Síntese

galasm orion68kV1_0.pld

Gravação

minipro -p GAL16V8B -w orion68kV1_0.jed

Logo no início do seu código de inicialização (em Assembly ou C), após configurar o básico, você deve "matar" o sinal de boot para liberar a RAM:

C

// Se a lógica da GAL for desarmar o BOOT no primeiro acesso a I/O:

#define DUMMY_IO_BASE 0xF00000

volatile uint16_t *kill_boot = (uint16_t *)DUMMY_IO_BASE;

void _start() {

// Configurações iniciais de hardware...

// O primeiro acesso ao espaço de I/O (F00000)

// fará o pino BOOT da GAL ir para 0.

*kill_boot = 0;

// Agora a RAM está disponível em 0x000000

}

### Observações Técnicas:

- Tensão: Lembre-se que se estiver usando componentes de tensão diferente (ex: Pi Pico 3.3V vs 68000 5V), a GAL22V10 (se for a série C ou VC) costuma tolerar bem, mas verifique os níveis lógicos $V_{IH}$ e $V_{IL}$ no datasheet.
- A20: Note que usei A20 na lógica da RAM para limitar os 2 MB. Como $2^{21} = 2$ MB, os pinos A21, A22 e A23 devem estar em 0 para acessar essa faixa.
- Reset: O pino BOOT.AR (Asynchronous Reset) na GAL garante que, assim que a tensão subir e o sinal de Reset for acionado, o sistema comece obrigatoriamente lendo a ROM.

### 1. A Técnica do Espelhamento (A mais segura)

Como no seu mapa de memória a ROM também está em 0xE00000, você faz o seguinte:

1. O sistema reseta e começa em 0x000000 (Modo BOOT ativo).
2. A primeira instrução do seu código de BIOS deve ser um Salto Absoluto para o endereço correspondente na faixa alta.
  - Exemplo: Se o código está em 0x000008, você pula para 0xE00008.
3. A partir daí, o 68000 está executando o código através do endereço 0xE00000.
4. Agora você pode desativar o sinal de BOOT tranquilamente. A ROM em 0x000000 vai sumir e a RAM vai aparecer lá, mas como o processador está "olhando" para a ROM através do endereço 0xE00000, ele não toma um susto.
5. Depois disso, você pode carregar os vetores de interrupção na RAM (0x000000 em diante) e seguir a vida.

Sua lógica está 100% correta. O processo é exatamente esse "malabarismo" entre os endereços.

Sobre a sua dúvida crucial (onde será a próxima instrução?): se você simplesmente disparar o acesso ao I/O que desliga o BOOT, o PC (Program Counter) do 68000 ainda estará apontando para um endereço baixo (ex: 0x000102). No momento em que o pino BOOT muda de 1 para 0, a ROM "some" dali e entra a RAM. Se você não tiver copiado o código exatamente para a mesma posição na RAM, o processador vai ler lixo e travar (crash).

Existem duas formas clássicas de resolver isso no Orion68:

### 1. A Técnica do Espelhamento (A mais segura)

Como no seu mapa de memória a ROM também está em 0xE00000, você faz o seguinte:

1. O sistema reseta e começa em 0x000000 (Modo BOOT ativo).
2. A primeira instrução do seu código de BIOS deve ser um Salto Absoluto para o endereço correspondente na faixa alta.
  - Exemplo: Se o código está em 0x000008, você pula para 0xE00008.
3. A partir daí, o 68000 está executando o código através do endereço 0xE00000.
4. Agora você pode desativar o sinal de BOOT tranquilamente. A ROM em 0x000000 vai sumir e a RAM vai aparecer lá, mas como o processador está "olhando" para a ROM através do endereço 0xE00000, ele não toma um susto.
5. Depois disso, você pode carregar os vetores de interrupção na RAM (0x000000 em diante) e seguir a vida.

### 2. A Técnica da Cópia Identica (Shadowing)

1. Você copia o trecho do código de inicialização da ROM para a RAM (no mesmo endereço relativo).
2. Executa o acesso ao I/O.
3. A memória troca sob os pés do processador, mas como o código que estava na ROM é idêntico ao que você acabou de copiar para a RAM, a próxima instrução que ele buscar será exatamente a que deveria ser.

### Exemplo de fluxo no código (Assembly/C):

Para o seu projeto, recomendo a Opção 1. Veja como seria a lógica do código de boot:

Snippet de código

ORG $000000

DC.L $10000 ; Stack Pointer inicial

DC.L START ; Endereço de Reset

START:

; 1. Pular para a ROM no endereço alto imediatamente

JMP $E00000 + CONTINUA.L

CONTINUA:

; 2. Aqui o PC já está na casa do 0xE00000...

; 3. Agora acessamos o I/O para matar o BOOT

MOVE.B #0, $F00000 ; Isso dispara o clock na GAL, BOOT vai para 0

; 4. Agora 0x000000 é RAM e 0xE00000 continua sendo ROM.

; 5. Podemos copiar os vetores de interrupção da BIOS para a RAM.

LEA $E00000, A0 ; Origem (ROM)

LEA $000000, A1 ; Destino (RAM)

; ... rotina de cópia ...

### O impacto no Hardware (GAL)

Certifique-se de que a sua equação da ROM_CS na GAL mantenha a ROM ativa no endereço E00000 independentemente do estado do pino de BOOT. No código que passei anteriormente, a linha:

ROM_CS = !( (!AS * A23 * A22 * A21 * !A20) + ... )

Garante exatamente isso! O endereço que começa com 1110 (E) sempre ativará a ROM, permitindo que você "fuja" para lá antes de puxar o tapete do endereço 0x000000.

Como estão as conexões do seu vgapico? Se ele estiver mapeado no espaço de I/O (0xF00000), o primeiro comando que você enviar para ele (como um comando de "Clear Screen" ou "Init") já pode servir automaticamente como o gatilho para desligar o modo de boot, economizando código!

Peço desculpas pelo "nó"! No mundo do silício, às vezes a gente tem tantas opções que acaba tropeçando nelas. Vamos desatar esse nó agora mesmo.

Existem duas formas de usar o 74HC74. A que eu sugeri por último é a mais "limpa" para o design do Orion68. Veja a diferença:

### A sua ideia inicial (Clock Externo)

Você usaria o 74HC74 para criar um pulso de clock que entra na GAL.

- Problema: A GAL ainda precisaria estar no modo "Registrado" (Flip-Flops internos ligados). Você teria dois Flip-Flops em série (um no 74HC74 e outro na GAL). É redundante e gasta mais energia e pinos.

### A minha sugestão (Sinal de Estado Externo)

O 74HC74 assume o papel de "cérebro" do estado de Boot, e a GAL vira apenas uma "calculadora" de endereços.

Como funciona na prática:

1. O 74HC74 guarda o segredo: Ele sozinho decide se o sistema está em MODO_BOOT (1) ou MODO_NORMAL (0).
2. A GAL obedece: Ela recebe esse sinal do 74HC74 em um pino de entrada comum (como se fosse um pino de endereço).
3. Vantagem Máxima: Se você quiser mudar a lógica de quem ativa a RAM ou a ROM no futuro, você só mexe no código da GAL. O hardware do 74HC74 fica lá, quietinho, fazendo o papel dele de "chave liga-desliga".

### Por que isso simplifica sua vida no Protoboard?

Se você usar o 74HC74 como a "chave", a sua GAL22V10 fica no modo Combinacional. Isso é ótimo porque:

- Não precisa se preocupar com o Pino 1 (Clock) da GAL. Todos os pinos de 1 a 11 viram entradas comuns.
- A lógica fica imune a problemas de temporização (skew) entre o clock da CPU e o clock da GAL.
- Você pode medir com um multímetro a saída do 74HC74 e saber exatamente em que modo o Orion68 está.

### Como conectar o 74HC74 para o Orion68:

1. Sinal de RESET: Conecte no pino PRE (Preset) do 74HC74. Quando a tensão de Reset cair (Low), a saída Q vai para 1 imediatamente. (O modo Boot está ligado).
2. Sinal de Gatilho (Kill): Conecte uma saída da GAL (ex: IO_SELECT) no pino CLK do 74HC74.
3. Sinal de Dados (D): Aterre o pino D (GND).
4. A Mágica: Quando o 68000 acessar o I/O, a GAL dá um pulso no CLK do 74HC74. Ele olha para o pino D, vê que é 0, e joga esse 0 para a saída Q. O Boot morreu.

### O novo (e definitivo) código da GAL:

Plaintext

CHIP ORION_LOGIC GAL22V10

; --- Entradas ---

PIN 1 AS

PIN 2 A23

PIN 3 A22

PIN 4 A21

PIN 5 A20

PIN 6 BOOT_STATE ; <--- Vem do pino Q do 74HC74!

PIN 7 RW

; --- Saídas ---

PIN 14 ROM_CS

PIN 15 RAM_CS

PIN 16 KILL_BOOT_TRIG ; <--- Vai para o CLK do 74HC74

EQUATIONS

; Ativa quando o 68000 acessa o espaço F00000

KILL_BOOT_TRIG = !(A23 * A22 * A21 * A20 * !AS)

; ROM_CS: Ativa no endereço E00000 OU no 000000 se o 74HC74 disser que é BOOT

ROM_CS = !( (!AS * A23 * A22 * A21 * !A20) + \

(!AS * !A23 * !A22 * !A21 * !A20 * BOOT_STATE) )

; RAM_CS: RAM de 2MB, mas respeita o espaço da ROM se BOOT_STATE for 1

RAM_CS = !( (!AS * !A23 * !A22 * !A21) * !(BOOT_STATE * !A20) )

Ficou mais claro agora? Você usa o melhor dos dois mundos: a robustez física do flip-flop 74HC74 para guardar o estado e a flexibilidade da GAL para gerenciar a memória.

O que acha dessa separação de tarefas para o Orion68?
