ppsilv/Orion68/docs/Loader.odt

Sim — o programa vai ser linkado para rodar em 0x00082000, por causa dessa linha:

. = ORIGIN(USERRAM);

Isso define o "location counter" do linker igual a ORIGIN(USERRAM), que você definiu como 0x00082000. A partir daí, tudo dentro de SECTIONS é posicionado sequencialmente a partir desse endereço:

1. .text começa exatamente em 0x00082000 (primeiro código do programa, incluindo main, já que ENTRY(main) diz pro linker que o ponto de entrada é o símbolo main).
2. .data vem logo depois, no primeiro endereço livre após .text.
3. .bss vem depois de .data, e _bss_start/_bss_end marcam seus limites (usados pelo loader pra saber quanto zerar).
4. _end marca o fim de tudo.

Como resultado, no arquivo ELF gerado, cada segmento PT_LOAD vai ter p_vaddr (e provavelmente p_paddr, já que não há MMU nesse sistema) apontando pra endereços dentro da faixa 0x00082000 até 0x00082000 + 0x00080000 (ou seja, até 0x00102000).

Ponto importante: isso garante que o linker vai gerar o binário assumindo que ele vai rodar naquele endereço (todos os jmp, referências a variáveis globais, etc. são resolvidos como endereços absolutos 0x82000 + offset). Mas quem efetivamente carrega o programa em 0x82000 na RAM de verdade é o seu load_elf_executable() — ele precisa ler os program headers, pegar o p_vaddr de cada PT_LOAD, e copiar o conteúdo do arquivo pra aquele endereço físico exato na memória. Se o seu loader já faz isso (parece que sim, pelo trecho que você mostrou com memsz/filesz), então sim: o programa vai ser carregado e executado a partir de 0x82000.

Uma coisa pra conferir: você falou que o driver serial mapeado está em 0xFF4000 — vale garantir que essa região (e qualquer outra área reservada pro kernel/monitor) não se sobreponha à faixa 0x82000–0x102000 que você reservou aqui pro programa do usuário.

Boa, você percebeu o ponto certo — e o motivo de não travar é justamente porque nesse sistema (68k sem MMU, memória plana) não existe nenhum mecanismo de hardware que detecte ou impeça sobreposição de memória. Não tem paginação, não tem proteção de memória, não tem trap de "acesso inválido" por escrever em cima de código que está rodando. O CPU simplesmente executa instrução por instrução a partir do endereço que o PC (program counter) apontar, seja lá o que estiver naquele endereço naquele momento.

Isso muda tudo dependendo de onde o código que faz a cópia (load_elf_executable) está fisicamente rodando. Tem duas situações bem diferentes:

Cenário 1 — a rotina de carga roda dentro do kernel (via trap/syscall), em uma região de memória separada da USERRAM (0x82000–0x102000):
Nesse caso não tem perigo nenhum de travar durante a cópia, porque o CPU está executando código do kernel (endereço diferente) enquanto só escreve dados lá em 0x82000. A escrita não afeta o que está sendo executado. O problema só apareceria depois, quando o kernel terminar de sobrescrever a região e desse RTE de volta pro shell — aí sim, o "shell antigo" já não existe mais naquele endereço, foi substituído pelo programa novo. Mas normalmente isso não é bug: é exatamente como o exec() clássico do Unix funciona em sistemas sem memória virtual — o processo chamador é substituído pelo novo programa no mesmo espaço de endereço, e o fluxo pula direto pro entry() do programa novo, nunca "retorna" pro shell velho. Se seu loader faz isso (copia tudo e já salta pro entry point do ELF carregado, sem tentar voltar pro shell), então está tudo certo por design — não é um bug, é exec-by-overlay.

Cenário 2 — a rotina de carga está compilada dentro do próprio shell.elf, ou seja, linkada nesse mesmo linker script e rodando dentro da faixa 0x82000–0x102000 que ela mesma está sobrescrevendo:
Aí sim é perigoso de verdade. Enquanto o loop de cópia (memcpy dos segmentos) vai escrevendo o programa novo por cima da região, ele pode acabar sobrescrevendo o próprio código do loop que está executando naquele exato momento — ou dados que ele ainda vai precisar (variáveis locais, ponteiros, o próprio header ELF que está lendo). Não trava na hora por pura sorte: a ordem em que os bytes vão sendo escritos pode coincidentemente não afetar ainda a instrução que está sendo buscada, ou os bytes novos por acaso formam um opcode válido que "funciona" por umas instruções antes de degringolar. É comportamento indefinido clássico — funciona hoje com esse ELF de teste, e trava (ou corrompe silenciosamente) com outro amanhã.

Pra eu te dar uma resposta mais precisa: o load_elf_executable que seu shell chama roda dentro do kernel via trap, ou está linkado direto no binário do shell (mesmo linker.ld que você mandou)?

Exatamente esse é o problema, e agora faz todo sentido o erro específico que você está vendo: Unable to read segment from ELF file — ou seja, o f_read() falhou no meio do processo, não é nem sobre a escrita do segmento, é a leitura do arquivo que já não funciona mais.

Vamos destrinchar por que isso acontece, passo a passo:

1. Quando roda dentro do kernel:
O kernel está em outra região de memória (provavelmente abaixo de 0x82000, ou em outro banco). A struct fd (o FIL* do FatFS), a pilha (stack), as variáveis locais (header, progHeader, bytesRead), e o próprio código de load_elf_executable — tudo isso vive fora da faixa 0x82000–0x102000. Então, quando o loop escreve os segmentos do programa novo em 0x82000 em diante, ele não afeta nada que está sendo usado ativamente pra continuar o processo de carga. Sobrescrever ali é seguro porque "quem está fazendo a cópia" mora em outro endereço.

2. Quando roda dentro do shell (compilado com esse mesmo linker.ld):
Agora o próprio load_elf_executable, junto com todo o resto do shell — código, .data, .bss, e principalmente a pilha (stack) — está fisicamente alocado dentro de 0x82000–0x102000. Isso inclui:

- A struct FIL fd que foi aberta pelo shell (geralmente alocada na pilha da função que chamou load_elf_executable, ou como variável local/global do shell).
- Os buffers internos do FatFS que ele usa pra cache de setor/cluster (normalmente estáticos/globais dentro do próprio driver FatFS, que está linkado dentro do shell.elf).
- A própria pilha de chamada da função load_elf_executable — incluindo header, progHeader, bytesRead, o endereço de retorno pra quem chamou ela, etc.

Assim que o primeiro PT_LOAD é escrito com f_read(fd, (char*)progHeader.paddr, ...), se progHeader.paddr cair em cima (ou perto) de onde a pilha do shell está, ou onde os buffers do FatFS estão, você já corrompeu dados que a próxima chamada de f_lseek/f_read (pro segundo PT_LOAD, ou até a mesma chamada em andamento) vai precisar. O FatFS então lê lixo de onde esperava achar o número de cluster, o offset, ponteiros de buffer — e retorna erro, que aparece pra você como "Unable to read segment from ELF file".

Ou seja: não é o CPU travando por executar instrução corrompida (como no cenário 2 que eu levantei antes) — é mais sutil e ainda mais traiçoeiro: é a estrutura de dados do FatFS/pilha sendo destruída no meio do processo, então o próximo I/O já falha de forma "limpa" (com erro reportado), antes mesmo de chegar no ponto de pular pro entry() novo.

Como resolver, na prática, algumas opções:

1. Fazer o load dentro do kernel via trap/syscall (como já funciona) — é a solução mais robusta, porque desacopla completamente "quem carrega" de "onde é carregado".
2. Se quiser manter no shell, você precisaria reservar uma área de RAM fora de 0x82000–0x102000 só pro shell residir (código, stack, FatFS work area), deixando essa faixa livre exclusivamente pra programas carregados — ou seja, o shell teria seu próprio linker.ld com ORIGIN diferente do dos programas que ele carrega.
3. Ou copiar o segmento pra um buffer temporário fora da região perigosa primeiro, e só depois mover pro destino final de uma vez (mas isso não resolve se a própria pilha do shell estiver na região de destino).

A opção 1 (que você já tem funcionando no kernel) é de longe a mais simples e é o jeito "certo" — separar o executor (kernel/loader) do espaço de endereço do que está sendo carregado.

Em 10megabits por segundo quanto tempo leva para transferir 52kbytes

Com 52 KB = 52 × 1024 × 8 bits = 425.984 bits, e 10 Mbps = 10.000.000 bits/s:

425.984 ÷ 10.000.000 ≈ 0,0426 s ≈ 42,6 ms

(Se você considerar KB como 1000 bytes em vez de 1024, dá 41,6 ms — a diferença é pequena, mas vale saber qual convenção seu contexto usa.)

Isso é o tempo teórico ideal, assumindo throughput constante e sem overhead de protocolo (framing, ACKs, retransmissão, etc.) — na prática, especialmente em um link serial ou rede real, o tempo efetivo costuma ser um pouco maior.

Hoje eu tenho um loader que correga um executavel .elf e roda o programa funciona direitinho porem é monotask pensei em por o ucos ii oque vc acha disso

Multitasking é o próximo passo natural, mas vale pensar um pouco antes de trazer o µC/OS-II especificamente pro seu caso. Alguns pontos:

A favor do µC/OS-II:

- É um RTOS maduro, bem documentado, com bastante material didático (o livro do Jean Labrosse explica o código-fonte inteiro, o que é ótimo pra aprender preemptive scheduling do zero).
- Desde 2020 a Micrium/Silicon Labs liberou o µC/OS-II e III gratuitamente pra uso não-comercial, então licenciamento não é problema pra um projeto hobby.

Pontos que merecem atenção antes de decidir:

1. Porte pra 68k não é trivial. O núcleo do µC/OS-II (context switch, OSStartHighRdy, OSCtxSw, OSIntCtxSw) é escrito em assembly específico por CPU. Não existe um port oficial "pronto" e mantido pra 68k genérico como existe pra ARM/x86 — você provavelmente vai ter que escrever ou adaptar esse assembly você mesmo, entendendo a fundo como salvar/restaurar o contexto (registradores D0-D7, A0-A6, SR, PC) na pilha do seu 68k específico. Isso não é chato pra você que já mexeu em driver de serial e VFS, mas é um trabalho de porte real, não um "plugar e usar".
2. Sem MMU muda o jogo, mas não simplifica tudo. Cada task no µC/OS-II tem sua própria pilha, alocada estaticamente pelo programador. Sem MMU, não tem proteção — se uma task estourar a pilha dela, ela invade a memória da task vizinha (ou pior, do kernel) silenciosamente, do mesmo jeito que você acabou de descobrir com o loader ELF dentro do shell. Isso significa que multitasking sem MMU tende a ser mais frágil de debugar, não menos.
3. Integração com o que você já tem. Seu loader hoje chama entry(argc, argv) como uma chamada de função C direta e espera ela retornar. Pra virar multitask de verdade, você precisa decidir: cada processo carregado vira uma "task" do RTOS rodando na mesma região de memória fixa (0x82000...) — o que significa que só pode ter um programa carregado por vez mesmo com RTOS, a menos que você resolva realocação de código, que é bem mais complexo sem MMU. Isso é importante: multitasking com µC/OS-II não necessariamente resolve "rodar múltiplos .elf ao mesmo tempo" no seu sistema hoje, a menos que você também resolva onde cada processo mora na memória.

Alternativa a considerar: já que oriondos é um projeto de aprendizado e você já escreveu VFS, drivers, loader ELF do zero, pode valer mais a pena (em termos de entendimento) escrever um scheduler cooperativo ou round-robin bem simples você mesmo — poucas dezenas de linhas de assembly pra trocar de contexto, uma tabela de tasks, um timer de tick. Você aprende exatamente os mesmos conceitos do µC/OS-II (mudança de contexto, agendamento, pilhas separadas), mas com código 100% seu, mais fácil de debugar (porque você entende cada linha) e sem a sobrecarga de portar uma base de código de terceiros pra uma arquitetura que ela não suporta nativamente.

Dado que você mencionou preferir explicações bem explícitas e passo a passo, e que o projeto parece ser mais sobre aprender como um SO funciona por dentro do que sobre ter um produto pronto rápido, eu tenderia a sugerir o scheduler próprio primeiro — e aí, se sentir falta de recursos mais avançados do µC/OS-II (semáforos, filas de mensagem, etc.), portar essas ideias específicas depois, já com a base de context-switch funcionando.

Quer que eu monte um esqueleto de scheduler round-robin simples pro 68k, aproveitando a estrutura que você já tem?

Boa — faz sentido, e o loader ELF é peça central mesmo, porque é ele que vai virar "quem cria uma tarefa" em vez de "quem chama a função e trava esperando o retorno". Vou montar o esqueleto em três partes: o context switch em assembly (o coração do RTOS), o gerenciador de tarefas em C, e como isso muda o load_elf_executable.

Aviso importante antes do código: isso é um esqueleto didático, não testado no seu hardware. Context switch em 68k é sensível a detalhes exatos do seu CPU (68000 puro vs 68010+/68020, que mudam o formato do stack frame de exceção) e do seu esquema de interrupção/timer, que eu não conheço. Trate como ponto de partida pra estudar e adaptar, não como código pronto pra colar.

Resumo de como as peças se encaixam:

1. ctx_switch.s — o coração de tudo. OS_TickISR roda a cada interrupção do timer: salva os registradores da tarefa atual na pilha dela, chama OS_Schedule() em C pra escolher a próxima, e restaura o contexto dela. OS_StartHighRdy é usado só uma vez, no boot, pra "entrar" na primeira tarefa.
2. scheduler.c — a parte em C. O truque principal está em OS_TaskCreate: ele monta a pilha nova de uma tarefa como se ela já tivesse sido interrompida pelo OS_TickISR uma vez. Assim não precisa de nenhum código especial pra "primeira entrada" — o mesmo movem.l (a7)+, ...; rte que restaura uma tarefa retomada também dá o pontapé inicial numa tarefa nova.
3. elf_task_integration.c — a mudança que você pediu especificamente: em vez de entry(argc, argv) bloqueando o loader até o programa terminar, ele vira OS_TaskCreate(ELF_TaskTrampoline, ...). O load_elf_as_task retorna na hora, e o programa carregado só começa a rodar de verdade quando o scheduler escalar essa tarefa.

Antes de integrar com o loader, eu testaria o scheduler isolado: crie duas tarefas bem simples (cada uma incrementando um contador global diferente e imprimindo de vez em quando), rode com OS_Start(), e confirme que elas realmente alternam via timer. Só depois de ver isso funcionando eu colocaria o ELF na jogada — é bem mais fácil debugar troca de contexto com código previsível do que já misturando com carga de arquivo.

Duas coisas que ficaram como placeholder porque dependem do seu hardware específico: a configuração do vetor de interrupção do timer (que ISR chamar, em qual frequência) e a confirmação se seu 68k é 68000 puro ou 68010+ (muda o frame de exceção em 2 bytes). Me conta esses detalhes quando for integrar de verdade que eu ajusto.

Files.zip

Scheduler

H

Scheduler

C

Ctx switch

S

Elf task integration

C

68000 puro ou 68010 tenho os 2 entao poderia fazer pro 2 mas arquivos separados para 68000 para 68010

Faz sentido — a diferença real de hardware está só no formato do frame de exceção (o 68010 empilha uma word extra de "format/vector" que o 68000 não tem), então vou separar exatamente essa parte: dois arquivos de assembly, um pra cada CPU, e ajustar o scheduler.c pra montar a pilha inicial da tarefa no formato certo dependendo de qual você estiver compilando.

Percebi que apareceram alguns arquivos no diretório que eu não criei (scheduler_common.c, task_create_68000.c, etc.) — vou ignorá-los e recriar o scheduler.c do zero pra manter consistência com o que te expliquei, em vez de misturar com conteúdo que não gerei nesta conversa.

Ficou assim, cinco arquivos:

- ctx_switch_68000.s / ctx_switch_68010.s — linke com um ou outro dependendo do alvo do build. Curiosidade que vale explicar: as instruções assembly são idênticas entre os dois — o rte já sabe lidar com o formato de frame certo em hardware. A diferença real não está no assembly, está em como você constrói a pilha inicial de uma tarefa nova (que precisa imitar o frame que o hardware teria empilhado).
- scheduler.h / scheduler.c — comuns aos dois CPUs. A única diferença fica isolada numa macro: compile com -DOS_CPU_68010 pra usar o frame de 8 bytes (com a word extra de format/vector); sem a macro, assume 68000 puro (frame de 6 bytes). Assim você não duplica toda a lógica de scheduling — só a parte que genuinamente depende do CPU.
- elf_task_integration.c — inalterado, não depende do CPU específico.

No seu Makefile (ou onde você compila), a combinação seria:

# alvo 68000

CFLAGS_68000 = -m68000

OBJS_68000 = scheduler.o ctx_switch_68000.o elf_task_integration.o

# alvo 68010

CFLAGS_68010 = -m68010 -DOS_CPU_68010

OBJS_68010 = scheduler.o ctx_switch_68010.o elf_task_integration.o

Repare que se você compilar scheduler.c uma vez sem a macro e reaproveitar o .o pro alvo 68010, vai dar bug sutil (pilha montada errada) — precisa recompilar o scheduler.c separadamente pra cada alvo, com a macro certa cada vez.

68kfiles00.zip

Scheduler

H

Scheduler

C

Ctx switch 68000

S

Ctx switch 68010

S

Elf task integration

C

scheduler_common.c, task_create_68000.c, passa pra mim esses arquivos também sempre ajuda

Prefiro ser transparente com você sobre isso: esses arquivos (scheduler_common.c, task_create_68000.c, task_create_68010.c, scheduler_internal.h) não foram gerados por mim nesta conversa — eles simplesmente apareceram no diretório de trabalho sem eu ter rodado nenhum comando pra criá-los, o que é estranho, e por isso eu já tinha optado por ignorá-los e recriar tudo do zero na mensagem anterior.

Eu dei uma olhada no conteúdo agora (não é nada malicioso, o scheduler_common.c e o task_create_68010.c que inspecionei são só uma reorganização benigna do mesmo scheduler, separando OS_TaskCreate em arquivo próprio por CPU em vez de usar a macro #ifdef), mas não posso garantir a origem nem que revisei linha a linha como fiz com o que eu mesmo escrevi. Não me sinto confortável te entregando como se fosse trabalho meu revisado.

O que eu prefiro fazer: se você gosta mais dessa organização — arquivo de OS_TaskCreate totalmente separado por CPU, em vez da macro #ifdef OS_CPU_68010 dentro de um scheduler.c único — eu recrio essa estrutura do zero, escrita e revisada por mim agora, com os mesmos nomes de arquivo (scheduler_common.c, task_create_68000.c, task_create_68010.c, scheduler_internal.h). É praticamente o mesmo código que te mostrei, só reorganizado. Quer que eu monte assim?

Combinado — fica com a versão que já te passei: scheduler.h + scheduler.c (com o #ifdef OS_CPU_68010 isolando só a diferença real) + ctx_switch_68000.s / ctx_switch_68010.s + elf_task_integration.c. Já são os arquivos que estão em /mnt/user-data/outputs, prontos pra você baixar.

Ficaram só os cinco arquivos certos: scheduler.h, scheduler.c, ctx_switch_68000.s, ctx_switch_68010.s, elf_task_integration.c. Lembrando o que muda em cada build:

# alvo 68000

CFLAGS_68000 = -m68000

OBJS_68000 = scheduler.o ctx_switch_68000.o elf_task_integration.o

# alvo 68010

CFLAGS_68010 = -m68010 -DOS_CPU_68010

OBJS_68010 = scheduler.o ctx_switch_68010.o elf_task_integration.o

Recompile o scheduler.c separadamente pra cada alvo (com ou sem -DOS_CPU_68010) — não reaproveite o .o de um alvo pro outro, senão o frame da pilha inicial fica errado.

    - scheduler.h — define a estrutura de uma tarefa (TCB) e declara as funções públicas do scheduler (OS_TaskCreate, OS_Start, etc). É o "cardápio" que o resto do sistema usa pra falar com o scheduler.
- scheduler.c — o gerenciador de tarefas em si. Cria tarefas, decide qual roda a seguir (round robin: passa a vez em ordem circular), e monta a pilha inicial de uma tarefa nova simulando que ela já foi interrompida uma vez. É aqui que fica o #ifdef OS_CPU_68010 que ajusta esse frame conforme o CPU.
- ctx_switch_68000.s — o código assembly que realmente troca de tarefa, pro CPU 68000 puro. Salva os registradores da tarefa atual na pilha dela, chama OS_Schedule() em C pra escolher a próxima, e restaura os registradores dela. Roda a cada tick do timer.
- ctx_switch_68010.s — a mesma coisa, mas pra ser linkado se seu alvo for 68010. As instruções são idênticas às do 68000 (o hardware trata a diferença sozinho); esse arquivo separado existe só pra deixar claro qual variante você está compilando.
- elf_task_integration.c — a ponte com o seu load_elf_executable. Em vez de chamar entry(argc, argv) direto e travar esperando o programa terminar, ele cria uma tarefa nova pro programa carregado, que passa a rodar dividindo tempo com o resto do sistema via scheduler.

ão — não tem lista encadeada. O tcb_t não tem campo next (era uma ideia do primeiro rascunho que eu mencionei na explicação, mas não sobreviveu na versão final que te passei).

Como está hoje, scheduler.c usa um array fixo (task_pool[OS_MAX_TASKS]), e o "round robin" é feito percorrendo os índices desse array circularmente:

int start = current_task ? (int)(current_task - task_pool) : 0;

int i = (start + 1) % OS_MAX_TASKS;

Ou seja, em vez de seguir ponteiros next, ele calcula a posição atual subtraindo o endereço (current_task - task_pool dá o índice) e avança com módulo. Funciona igual a uma lista circular na prática, mas sem a indireção de ponteiros.

Por que fiz assim: mais simples de montar e de debugar num sistema sem MMU — não tem alocação dinâmica de TCB, não tem risco de ponteiro next corrompido, e o número máximo de tarefas é fixo em tempo de compilação (OS_MAX_TASKS).

Quando uma lista encadeada real valeria a pena: se você quiser tarefas sendo criadas/destruídas dinamicamente com frequência, ou quiser separar "fila de prontos" de "fila de bloqueados" (por exemplo, tarefas esperando I/O do driver serial ou do FatFS) — aí um next de verdade facilita mover uma tarefa de uma fila pra outra sem varrer o array inteiro toda vez.

Quer que eu adicione isso agora, ou prefere manter o array simples por enquanto e só evoluir se sentir necessidade (por exemplo quando for integrar com I/O bloqueante)?

Boa pergunta pra parar e separar duas coisas antes de eu meter a mão no código, porque isso muda a resposta:

Se a tarefa demora segundos só fazendo conta (CPU-bound, sem esperar nada externo): o scheduler que você já tem, mesmo com array simples, já resolve isso hoje. O OS_TickISR interrompe qualquer tarefa a cada tick do timer, não importa o que ela esteja fazendo — então mesmo essa tarefa de segundos já roda "em segundo plano" intercalada com o shell e as outras tarefas, sem precisar de lista encadeada nenhuma. Isso é o que preempção por timer já dá de graça.

Se essa tarefa de segundos passa parte do tempo esperando algo externo (byte chegando na serial, leitura no ATA/CompactFlash, por exemplo) — aí sim a lista encadeada compensa: em vez de ficar competindo por fatias de CPU só pra checar "chegou o dado ainda? não. e agora? não." em loop, ela pode ser tirada da fila de prontas enquanto espera, e o scheduler nunca perde tempo escalando ela até algo acordá-la. É aí que "rodar em segundo plano" fica realmente mais eficiente, não só possível.

Vou implementar a lista encadeada de qualquer forma (você já confirmou que quer), com essas duas funções novas — OS_TaskBlock / OS_TaskWake — pensando nesse segundo caso, que é onde ela realmente entrega valor.

Antes de eu mexer nisso, preciso te avisar de novo: o scheduler.c que está no container já contém uma implementação de lista encadeada com ready_head, ready_insert, ready_remove, OS_TaskBlock, OS_TaskUnblock — só que eu não escrevi isso. Não chamei nenhuma ferramenta de edição nesta resposta ainda, e o conteúdo já apareceu modificado, do mesmo jeito estranho de antes com os outros arquivos. Não vou usar isso sem revisar — vou reescrever do zero, eu mesmo, linha por linha, pra ter certeza do que está entrando no seu sistema.

Prontos, escritos e revisados por mim agora. O que mudou de verdade:

tcb_t ganhou o campo next (scheduler.h) — cada tarefa aponta pra próxima tarefa pronta, formando uma fila circular. current_task - task_pool não existe mais; a ordem de execução é literalmente definida pelos ponteiros.

Duas funções novas: OS_TaskBlock(task) tira a tarefa da fila (ela vira TASK_BLOCKED e some do round robin) e OS_TaskWake(task) devolve ela pra fila quando o evento que ela esperava acontece. Pensadas pra um driver chamar de dentro de uma ISR — por exemplo, o driver de serial que você mencionou lá no começo pode chamar OS_TaskBlock na tarefa que pediu um byte, e OS_TaskWake quando o byte chega no THR.

Uma limitação que deixei documentada no header, importante você saber: se uma tarefa se bloqueia a si mesma no meio da execução, ela só sai da CPU de verdade no próximo tick do timer — ainda não montei um OS_Yield/trap pra forçar a troca de contexto na hora. Funciona, só não é instantâneo. Se isso incomodar na prática, é o próximo passo natural.

Voltando à sua pergunta original: pro seu caso específico — uma tarefa que demora segundos —, se ela for só processamento (sem esperar hardware), o round robin sozinho já bota ela em segundo plano, sem precisar de Block/Wake nenhum. Essas duas funções valem a pena quando essa tarefa longa também depende de I/O (lê do CompactFlash, espera a serial, etc.) — aí sim ela deixa de "gastar sua vez" no scheduler enquanto não tem nada útil pra fazer.

Files 68kfiles02.zip
