ppsilv/Orion68/docs/orion_bus2.odt

Boa, e a intuição de separar em outra PIO/SM está certa — na verdade é necessária, não só desejável. Deixa eu explicar o porquê antes de ir pro código, porque tem uma pegadinha de hardware que vale a pena resolver direito.

### Por que não dá pra simplesmente ligar o DMA na FIFO atual

Hoje o TX FIFO da sua orion_bus é compartilhado entre todos os registradores (0x00 a 0x15+). Quem decide o que entra nesse FIFO é o software, register a register, a cada pio_sm_get_blocking/pio_sm_put. Se você colocar um DMA "empurrando" bytes do arquivo nesse mesmo FIFO, ele vai competir com as respostas de status/CRC/setor/etc., e não tem como o DMA saber "agora é a vez do arquivo, agora não é". Ou seja: FIFO compartilhado = tem que ser mediado por software. Pra tirar o core do caminho, o case 0x00: precisa ter FIFO próprio, alimentado só pelo DMA, sem ninguém mais escrevendo nele.

Isso confirma que você já pensou certo: SM dedicada só pra isso.

### O problema real: quem decide qual SM responde

O ponto chato não é a PIO em si, é o barramento físico. Hoje seu /CS (GPIO18) cobre o bloco inteiro de registradores (A1–A6 = 0x00 a 0x15). Se a nova SM também escutar esse mesmo /CS, as duas vão tentar responder ao mesmo ciclo — conflito elétrico em D0–D7 e no DTACK.

Duas soluções:

A) Decodificação extra em hardware (recomendo — é a "simples e funcional")
Você já tem um 74HC138 no board, então adicionar mais um pouco de lógica combinacional é natural pra você. A ideia:

Duas soluções:

A) Decodificação extra em hardware (recomendo — é a "simples e funcional")
Você já tem um 74HC138 no board, então adicionar mais um pouco de lógica combinacional é natural pra você. A ideia:

- /CS_DATA = /CS AND (A1..A6 == 0) → só ativa quando o endereço é exatamente o registrador 0x00
- /CS_OTHERS = /CS AND NOT (A1..A6 == 0) → tudo que não é 0x00

Dá pra fazer isso com um NOR de 6 entradas (ou cascata de 74HC32/74HC02) nas linhas A1–A6, combinado por um AND com o /CS original. A orion_bus (a que você já tem) passa a receber /CS_OTHERS no GPIO18 em vez do /CS cru — não precisa mudar nada no programa PIO dela. A nova SM dedicada recebe /CS_DATA num GPIO livre (você tem 48 no RP2350B, sobra à vontade).

Com isso, a nova SM nem precisa decodificar endereço — o hardware já garante que ela só é acordada quando é exatamente o ciclo certo. Isso mantém a PIO nova extremamente simples e evita mexer no código que já funciona.

(Existe a alternativa 100% em software — comparar o endereço dentro da própria PIO com jmp x!=y/jmp !x — mas isso obriga a editar o programa principal também, pra ele "pular" quando reg==0, e tem mais risco de sutileza de timing/arbitração. Não recomendo pra esse caso, prefiro o gate.)

### Cuidado com DTACK e D0–D7 (isso é importante!)

Repara que no seu programa atual, o DTACK (GPIO14) fica sempre configurado como saída (set pindirs,1 no fim do wrap), não tri-estado. Se a nova SM também tentar dirigir esse mesmo pino como saída permanente, vai haver curto entre as duas SMs sempre que uma estiver em nível diferente da outra — mesmo com /CS mutuamente exclusivos, porque o "idle" de cada uma fica sempre driving.

Solução simples: faça a nova SM tri-estar o DTACK também quando não está em ciclo (igual já faz com D0–D7), e habilite pull-up interno no GPIO14 (gpio_pull_up) pra manter o nível inativo quando nenhuma das duas está dirigindo. Isso é suficiente porque os /CS são mutuamente exclusivos por hardware — nunca duas SMs "acham" que é a vez delas ao mesmo tempo.

Se a margem de timing do 68k for apertada e o pull-up for lento demais pra subir o DTACK a tempo, aí sim vale considerar uma porta AND física combinando os dois DTACKs — mas comece com o pull-up, que é mais simples e deve funcionar tranquilo no clock que você está usando.

### Programa PIO novo, dedicado (bem mais simples que o original)

pioasm

.program orion_data_fast

.wrap_target

set pins, 1 ; DTACK inativo enquanto ocioso (mas com pindirs=input, ver init)

wait 0 gpio 20 ; espera /CS_DATA ativo (escolha o GPIO que você cabear)

pull block ; pega o próximo byte do arquivo (FIFO alimentada só pelo DMA)

mov pindirs, y ; habilita D0-D7 + DTACK como saída (mesmo truque do y que você já usa)

out pins, 8 ; coloca o byte no barramento

nop [16] ; assentamento, mesmo tempo do original

set pins, 0 ; DTACK ativo (dado pronto)

wait 1 gpio 20 ; espera /CS_DATA subir (68k terminou o ciclo)

mov osr, null

mov pindirs, osr ; tri-estado tudo de novo (D0-D7 e DTACK)

.wrap

Não precisa tratar escrita (/WR) nem decodificar endereço — o gate de hardware já garante que só chega aqui leitura do registrador certo. Bem mais enxuto que a orion_bus original.

### DMA alimentando essa SM

DMA configuration em C

uint dma_chan_arquivo = dma_claim_unused_channel(true);
dma_channel_config c = dma_channel_get_default_config(dma_chan_arquivo);

channel_config_set_transfer_data_size(&c, DMA_SIZE_8);
channel_config_set_read_increment(&c, true);
channel_config_set_write_increment(&c, false);
channel_config_set_dreq(&c, pio_get_dreq(pio_data, sm_data, true)); // true = TX

dma_channel_configure(
dma_chan_arquivo, &c,
&pio_data->txf[sm_data], // FIFO da nova SM dedicada
arquivo_buffer,
arquivo_tamanho,
true
);

Quando chegar um arquivo novo, em vez do ponteiro_leitura = 0, você reprograma esse canal (novo endereço de origem se o buffer mudar, novo arquivo_tamanho, dma_channel_set_read_addr + dma_channel_set_trans_count + trigger).

### Um detalhe que você vai precisar ajustar: status/tamanho (0x01, 0x02, 0x03)

Como o ponteiro_leitura deixa de ser incrementado por software, os cases 0x01/0x02/0x03 (que hoje leem ponteiro_leitura) precisam calcular o progresso a partir do próprio canal de DMA:

uint32_t restantes_dma = dma_channel_hw_addr(dma_chan_arquivo)->transfer_count;

uint32_t no_fifo = pio_sm_get_tx_fifo_level(pio_data, sm_data); // bytes já no FIFO mas não lidos ainda pelo 68k

uint32_t ponteiro_leitura = arquivo_tamanho - restantes_dma - no_fifo;

Isso é importante porque o DMA "adianta" bytes pro FIFO antes do 68k realmente pedir — então transfer_count sozinho superestima quanto já foi entregue de fato. Subtraindo o que ainda está sentado no FIFO você pega o valor real consumido, e isso também te dá o EOF certinho.

### Resumo prático

1. Um gate simples pra gerar /CS_DATA (reg==0) e /CS_OTHERS (resto) a partir do seu /CS atual.
2. orion_bus original não muda nada — só troca a entrada do GPIO18 pra /CS_OTHERS.
3. SM/PIO nova, minimalista, dedicada, ligada em /CS_DATA, tri-estando DTACK igual ao barramento de dados.
4. Um canal de DMA alimentando o TX FIFO dessa SM nova, disparado pelo DREQ dela, reprogramado a cada arquivo novo.
5. Status/tamanho recalculados a partir do transfer_count do DMA + nível do FIFO, não mais por um contador manual.

Isso tira o core completamente do caminho crítico de leitura de arquivo — a resposta ao 68k passa a depender só da latência do próprio silício PIO+DMA, bem mais rápida e sem jitter de IRQ.
