ppsilv/Orion68/docs/template.odt

==================================================

SISTEMA PDS317

Manual Técnico do Módulo ==================================================

Autor: pdsilva(aka pgordao)

Data: Junho de 2026

Versão: 1.0

Índice:

SISTEMA COMPUTACIONAL PDS317 Módulo CPU PDSxxx — Manual Técnico Rev. 1.0

PDS317 – Especificação técnica pag.: 5 / 8
