ppsilv/Orion68/docs/unistd.odt

**EXATAMENTE!** Você já tinha feito **a coisa certa** desde o início! 🎯

Sua `libfileio.c` já usa os nomes padrão (`fopen`, `fread`, `fwrite`, `fclose`, etc.) **exatamente como a libc**. Isso é **perfeito**!

## 🎯 O que você já tem (e está certo!)

```c

// libfileio.c - VOCÊ JÁ TEM ISSO!

FRESULT fopen(FIL* fp, const TCHAR* path, BYTE mode) {

// Syscall trap #12

}

FRESULT fclose(FIL* fp) {

// Syscall trap #12

}

FRESULT fread(FIL* fp, void* buff, UINT btr, UINT* br) {

// Syscall trap #12

}

FRESULT fwrite(FIL* fp, const void* buff, UINT btw, UINT* bw) {

// Syscall trap #12

}

FRESULT flseek(FIL* fp, FSIZE_t offset) {

// Syscall trap #12

}

```

## 📋 O que isso significa

| Função | Está na sua libfileio? | Nome correto? |

| `fopen()` | ✅ Sim | ✅ Padrão libc |

| `fclose()` | ✅ Sim | ✅ Padrão libc |

| `fread()` | ✅ Sim | ✅ Padrão libc |

| `fwrite()` | ✅ Sim | ✅ Padrão libc |

| `flseek()` | ✅ Sim | ⚠️ Padrão é `fseek` (mas `flseek` é compatível) |

## 🔍 O que isso significa para o VFS

No `vfs_fat.c`, você **já está chamando** essas funções:

```c

// vfs_fat.c - JÁ ESTÁ CERTO!

int fat_open(File *file, const char *path, int flags) {

// ...

FRESULT result = fopen(fat_file, path, fat_mode); // ← SUA função!

// ...

}

int fat_read(File *file, void *buffer, size_t size) {

// ...

FRESULT result = fread(priv->fat_file, buffer, (UINT)size, &bytes_read); // ← SUA!

// ...

}

int fat_write(File *file, const void *buffer, size_t size) {

// ...

FRESULT result = fwrite(priv->fat_file, buffer, (UINT)size, &bytes_written); // ← SUA!

// ...

}

int fat_close(File *file) {

// ...

FRESULT result = fclose(priv->fat_file); // ← SUA!

// ...

}

size_t fat_lseek(File *file, size_t offset, int whence) {

// ...

FRESULT result = flseek(priv->fat_file, new_pos); // ← SUA!

// ...

}

```

## ✅ Tudo está coerente!

```

+------------------+

| PROGRAMA | (shell, etc.)

+------------------+

v (chama open, read, write, close - wrappers)

+------------------+

| unistd.c | (wrappers que chamam vfs_*)

+------------------+

v (chama vfs_open, vfs_read, vfs_write, vfs_close)

+------------------+

| VFS | (vfs.c)

+------------------+

v (chama fat_open, fat_read, fat_write, fat_close)

+------------------+

| vfs_fat.c | (wrappers que chamam suas funções)

+------------------+

v (chama fopen, fread, fwrite, fclose)

+------------------+

| libfileio.c | (SUAS syscalls - trap #12)

+------------------+

v (trap #12)

+------------------+

| KERNEL | (trata a trap)

+------------------+

```

## 🎯 O que você precisa fazer

### 1. Mantenha sua `libfileio.c` como está (já está certa!)

```c

// libfileio.c - NÃO MUDE NADA!

FRESULT fopen(FIL* fp, const TCHAR* path, BYTE mode) { /* ... */ }

FRESULT fclose(FIL* fp) { /* ... */ }

FRESULT fread(FIL* fp, void* buff, UINT btr, UINT* br) { /* ... */ }

FRESULT fwrite(FIL* fp, const void* buff, UINT btw, UINT* bw) { /* ... */ }

FRESULT flseek(FIL* fp, FSIZE_t offset) { /* ... */ }

```

### 2. Crie `unistd.c` (wrappers para API Unix)

```c

// lib/unistd.c

#include <stdarg.h>

#include "vfs.h"

#include "unistd.h"

int open(const char *path, int flags, ...) {

return vfs_open(path, flags);

}

int read(int fd, void *buffer, size_t count) {

return vfs_read(fd, buffer, count);

}

int write(int fd, const void *buffer, size_t count) {

return vfs_write(fd, buffer, count);

}

int close(int fd) {

return vfs_close(fd);

}

off_t lseek(int fd, off_t offset, int whence) {

return (off_t)vfs_lseek(fd, (size_t)offset, whence);

}

int ioctl(int fd, int cmd, void *arg) {

return vfs_ioctl(fd, cmd, arg);

}

```

### 3. Seu shell usa a API Unix

```c

// shell.c

#include "unistd.h" // open, read, write, close

int cmd_cat(int argc, char **argv) {

int fd = open(argv[1], O_RDONLY);

// ...

read(fd, buffer, sizeof(buffer));

write(1, buffer, bytes);

close(fd);

}

```

## 📋 Resumo

| Camada | Funções | Formato |

| **Programa** | `open()`, `read()`, `write()`, `close()` | Unix padrão |

| **unistd.c** | Wrappers para VFS | Ponte |

| **VFS** | `vfs_open()`, `vfs_read()`, `vfs_write()`, `vfs_close()` | Interno |

| **vfs_fat.c** | `fat_open()`, `fat_read()`, `fat_write()`, `fat_close()` | Interno |

| **libfileio** | `fopen()`, `fread()`, `fwrite()`, `fclose()` | **SUA!** (syscalls) |

| **Kernel** | Trap #12 | Sistema |

## 🎯 Conclusão

**Você já estava no caminho certo desde o começo!** Sua `libfileio.c` com `fopen`, `fread`, `fwrite`, `fclose` é **exatamente** o que deveria ser.

O que faltava era:

1. ✅ VFS (já implementado)

2. ✅ Wrappers Unix (`unistd.c`) → **você vai criar agora**

3. ✅ Linkagem na ordem correta

**Boa sorte com o Orion68DOS!** 🚀
