ppsilv/Orion68/docs/Yield.odt

Boa, essa é a peça que fecha o ciclo. A ideia: usar a própria instrução TRAP do 68k pra gerar, por software, o mesmo tipo de "frame de exceção" que uma interrupção de hardware gera — assim o handler de OS_Yield pode ser praticamente uma cópia do seu OS_TickISR, e o rte no final funciona exatamente igual.Dois pontos pra você confirmar antes de plugar isso no seu kernel:

1. Registro do vetor no boot. TRAP #15 corresponde ao vetor de exceção número 47 na tabela do 68k (fórmula: 32 + n para TRAP #n). Onde quer que você já registre OS_TickISR no vetor do timer, você precisa da mesma coisa pra OS_YieldTrap no vetor 47 — só um move.l #OS_YieldTrap, vetor_47 (ou equivalente, dependendo de como você monta sua tabela).

2. Se TRAP #15 já estiver ocupada por outra coisa no seu sistema, troca o número (qualquer TRAP #0–#15 livre serve) — só precisa bater entre o trap #15 no OS_Yield e o vetor que você registrar.

Com isso, o fluxo completo do mutex fecha assim: Mutex_Lock bloqueia a task e chama OS_Yield → OS_Yield dispara TRAP #15 → OS_YieldTrap salva o contexto dela (que já está marcada como TASK_BLOCKED, então OS_Schedule não vai escolhê-la de novo) → escalona outra task pronta → quando Mutex_Unlock marcar essa task como TASK_READY de novo e ela for escolhida pelo scheduler, a execução retoma exatamente depois do trap #15, dentro de OS_Yield, que dá rts — e do ponto de vista de quem chamou Mutex_Lock, ela simplesmente "demorou" e voltou já com o mutex na mão.
