ppsilv/Orion68/docs/VFS/OrionDOS.odt

Perfeito! Vou te enviar **todo o conteúdo em formato estruturado** para o LibreOffice, com:

1. **Capítulos e subcapítulos** (para sumário automático)

2. **Tabelas** bem formatadas

3. **Código com fonte monoespaçada**

4. **Diagramas ASCII** (para visualização)

5. **Marcadores e numeração** clara

# 📄 DOCUMENTO COMPLETO - VFS DO MEUSO

## "Tudo é um Arquivo" - Implementação Completa

**Autor:** Projeto MeuSO

**Data:** Agosto 2026

**Versão:** 1.0

**Status:** Implementado e Testado

# SUMÁRIO

1. [INTRODUÇÃO](#1-introdução)

2. [ARQUITETURA DO SISTEMA](#2-arquitetura-do-sistema)

3. [ESTRUTURAS DE DADOS](#3-estruturas-de-dados)

4. [DRIVERS IMPLEMENTADOS](#4-drivers-implementados)

5. [API DO VFS](#5-api-do-vfs)

6. [SHELL E COMANDOS](#6-shell-e-comandos)

7. [CÓDIGO FONTE COMPLETO](#7-código-fonte-completo)

8. [COMPILAÇÃO E INSTALAÇÃO](#8-compilação-e-instalação)

9. [TESTES E VALIDAÇÃO](#9-testes-e-validação)

10. [REFERÊNCIAS](#10-referências)

# 1. INTRODUÇÃO

## 1.1 Objetivo

Implementar o paradigma **"Tudo é um arquivo"** no sistema operacional MeuSO (m68k), permitindo que dispositivos, informações do sistema e arquivos reais sejam acessados através das mesmas funções padronizadas.

## 1.2 Conceito

No Linux/Unix, tudo pode ser tratado como um arquivo:

| Tipo | Exemplo | Descrição |

| Arquivos de disco | `/boot.bat` | Dados armazenados em FATFS |

| Dispositivos de hardware | `/dev/tty` | Terminal (vídeo/teclado) |

| Dispositivos virtuais | `/dev/null` | Descarta dados |

| Informações do sistema | `/proc/meminfo` | Memória disponível |

## 1.3 Benefícios

- **Padronização**: Uma única API para tudo

- **Simplicidade**: Código mais limpo e reutilizável

- **Flexibilidade**: Fácil adicionar novos dispositivos

- **Redirecionamento**: Suporte a `>` e `<` no shell

- **Pipes**: Base para comunicação entre processos (futuro)

# 2. ARQUITETURA DO SISTEMA

## 2.1 Visão Geral

```

+------------------------------------------+

| APLICAÇÃO (shell) |

+------------------------------------------+

v

+------------------------------------------+

| VFS (Virtual File System) |

| vfs_open(), vfs_read(), vfs_write() |

+------------------------------------------+

+------------+------------+

v v v

+-----------+ +-----------+ +-----------+

| FATFS | | DEVICES | | PROC |

| (disco) | | (/dev) | | (/proc) |

+-----------+ +-----------+ +-----------+

v v v

+-----------+ +-----------+ +-----------+

| SD Card | | Hardware | | Sistema |

| (FATFS) | | (UART, | | (memória, |

| | | Video) | | CPU) |

+-----------+ +-----------+ +-----------+

```

## 2.2 Camadas do Sistema

### Camada 1: Aplicação (Shell)

- Interface com o usuário

- Comandos como `cat`, `echo`, `ls`

- Não sabe se está lendo de arquivo, TTY ou /proc

### Camada 2: VFS (Virtual File System)

- Gerencia descritores de arquivos (FD)

- Roteia chamadas para o driver correto

- Mantém tabela de arquivos abertos

### Camada 3: Drivers

- **FATFS**: Arquivos em disco (usa libfileio)

- **TTY**: Terminal (getchar/putchar)

- **NULL**: Dispositivo nulo

- **ZERO**: Gerador de zeros

- **PROC**: Informações do sistema

### Camada 4: Hardware/Sistema

- SD Card (via FATFS)

- UART/Teclado (via getchar)

- Vídeo (via putchar)

- Memória/CPU (para /proc)

# 3. ESTRUTURAS DE DADOS

## 3.1 Estrutura File

```c

typedef struct File {

char *name; // Nome do arquivo/dispositivo

int type; // FILE_TYPE_REGULAR, DEVICE, PROC

size_t position; // Posição atual de leitura/escrita

int ref_count; // Quantos processos usam

void *private_data; // Dados específicos do driver

// Operações (polimorfismo)

int (*open)(struct File *file, const char *path, int flags);

int (*read)(struct File *file, void *buffer, size_t size);

int (*write)(struct File *file, const void *buffer, size_t size);

int (*close)(struct File *file);

int (*ioctl)(struct File *file, int cmd, void *arg);

size_t (*lseek)(struct File *file, size_t offset, int whence);

} File;

```

| Campo | Tipo | Descrição |

| `name` | `char*` | Nome do arquivo (ex: "/boot.bat") |

| `type` | `int` | FILE_TYPE_REGULAR, FILE_TYPE_DEVICE, FILE_TYPE_PROC |

| `position` | `size_t` | Posição atual de leitura/escrita |

| `ref_count` | `int` | Número de processos usando este arquivo |

| `private_data` | `void*` | Dados internos do driver (ex: FIL*) |

| `read` | `function pointer` | Função de leitura do driver |

| `write` | `function pointer` | Função de escrita do driver |

| `close` | `function pointer` | Função de fechamento do driver |

## 3.2 Estrutura DeviceDriver

```c

typedef struct {

const char *path; // Caminho do dispositivo

int (*open)(File *, const char *, int);

int (*read)(File *, void *, size_t);

int (*write)(File *, const void *, size_t);

int (*close)(File *);

int (*ioctl)(File *, int, void *);

size_t (*lseek)(File *, size_t, int);

} DeviceDriver;

```

| Campo | Tipo | Descrição |

| `path` | `const char*` | Caminho do dispositivo (ex: "/dev/tty") |

| `open` | `function pointer` | Abre o dispositivo |

| `read` | `function pointer` | Lê do dispositivo |

| `write` | `function pointer` | Escreve no dispositivo |

| `close` | `function pointer` | Fecha o dispositivo |

| `ioctl` | `function pointer` | Controle do dispositivo |

| `lseek` | `function pointer` | Move posição (se suportado) |

## 3.3 Tabela de Descritores

```c

static File *fd_table[256]; // Máximo 256 arquivos abertos

static int fd_count = 0; // Quantos estão em uso

```

| Descritor | Uso | Dispositivo |

| 0 | stdin (entrada padrão) | `/dev/tty` |

| 1 | stdout (saída padrão) | `/dev/tty` |

| 2 | stderr (saída de erro) | `/dev/tty` |

| 3-255 | Arquivos abertos | Vários |

# 4. DRIVERS IMPLEMENTADOS

## 4.1 Driver FATFS (vfs_fat.c)

**Função:** Acessar arquivos no sistema FATFS

**Dependências:** `libfileio.a` (suas syscalls)

**Operações:**

| Função | Syscall usada | Descrição |

| `fat_open()` | `fopen()` | Abre arquivo no disco |

| `fat_read()` | `fread()` | Lê do arquivo |

| `fat_write()` | `fwrite()` | Escreve no arquivo |

| `fat_close()` | `fclose()` | Fecha o arquivo |

| `fat_lseek()` | `flseek()` | Move posição |

**Estrutura privada:**

```c

typedef struct {

FIL *fat_file; // Ponteiro para o FIL (alocado no heap)

BYTE mode; // Modo de abertura (FA_READ, FA_WRITE, etc.)

FSIZE_t size; // Tamanho do arquivo (cache)

} FatPrivate;

```

**Mapeamento de flags:**

| VFS Flag | FATFS Flag |

| `O_RDONLY` | `FA_READ` |

| `O_WRONLY` | `FA_WRITE` |

| `O_RDWR` | `FA_READ | FA_WRITE` |

| `O_CREAT` | `FA_CREATE_ALWAYS` |

| `O_APPEND` | `FA_OPEN_APPEND` |

## 4.2 Driver TTY (vfs_tty.c)

**Função:** Terminal de texto (vídeo/teclado)

**Dependências:** `getchar()`, `putchar()` do sistema

**Operações:**

| Função | Descrição |

| `tty_open()` | Sempre sucesso |

| `tty_read()` | Lê do teclado (getchar) com echo |

| `tty_write()` | Escreve no vídeo (putchar) |

| `tty_close()` | Sempre sucesso |

| `tty_ioctl()` | Comandos especiais (limpar tela) |

| `tty_lseek()` | Não suportado (retorna -1) |

**Comandos ioctl:**

| Comando | Valor | Descrição |

| `TIOC_CLEAR` | 0x01 | Limpa a tela |

| `TIOC_GETXY` | 0x02 | Obtém posição do cursor |

| `TIOC_SETXY` | 0x03 | Define posição do cursor |

**Comportamento especial:**

- Echo automático dos caracteres digitados

- Suporte a backspace (apaga caractere)

- Conversão de `\n` para `\r\n` na escrita

## 4.3 Driver NULL (vfs_null.c)

**Função:** Dispositivo nulo (descarta dados)

**Operações:**

| Função | Comportamento |

| `null_open()` | Sempre sucesso |

| `null_read()` | Retorna 0 (fim de arquivo) |

| `null_write()` | Retorna `size` (descarta dados) |

| `null_close()` | Sempre sucesso |

| `null_lseek()` | Suporta seek |

**Uso típico:**

```bash

# Descartar saída

echo "texto" > /dev/null

# Ler nada (fim de arquivo)

cat /dev/null

```

## 4.4 Driver ZERO (vfs_zero.c)

**Função:** Gerador de zeros

**Operações:**

| Função | Comportamento |

| `zero_open()` | Sempre sucesso |

| `zero_read()` | Preenche buffer com zeros |

| `zero_write()` | Retorna `size` (descarta) |

| `zero_close()` | Sempre sucesso |

| `zero_lseek()` | Suporta seek |

**Uso típico:**

```bash

# Gerar 100 zeros

dd if=/dev/zero of=zeros.bin bs=100 count=1

```

## 4.5 Driver PROC (vfs_proc.c)

**Função:** Informações do sistema

**Arquivos suportados:**

| Arquivo | Conteúdo | Função |

| `/proc/meminfo` | Informações de memória | `proc_meminfo_open()` |

| `/proc/cpuinfo` | Informações da CPU | `proc_cpuinfo_open()` |

| `/proc/uptime` | Tempo desde o boot | `proc_uptime_open()` |

**Estrutura de dados:**

```c

typedef struct {

char *data; // Dados gerados dinamicamente

size_t size; // Tamanho dos dados

size_t position; // Posição atual de leitura

} ProcData;

```

**Comportamento:**

- Dados são gerados no `open()`

- Leitura é feita dos dados gerados

- Não suporta escrita

- Suporta seek

**Exemplo de saída (/proc/meminfo):**

```

MemTotal: 1024 KB

MemFree: 512 KB

MemUsed: 512 KB

MemAvail: 256 KB

```

**Exemplo de saída (/proc/cpuinfo):**

```

CPU: Motorola 68000

Clock: 8 MHz

Features: FPU (sim)

Cores: 1

Family: m68k

```

# 5. API DO VFS

## 5.1 vfs_open()

**Prototype:**

```c

int vfs_open(const char *path, int flags);

```

**Parâmetros:**

| Parâmetro | Tipo | Descrição |

| `path` | `const char*` | Caminho do arquivo/dispositivo |

| `flags` | `int` | Flags de abertura (O_RDONLY, O_WRONLY, etc.) |

**Retorno:**

| Valor | Significado |

| `>= 0` | Descritor de arquivo (FD) |

| `-1` | Erro (arquivo não encontrado) |

**Comportamento:**

1. Tenta abrir como arquivo FATFS

2. Se falhar, tenta como dispositivo especial

3. Se sucesso, aloca um descritor

4. Retorna o FD

**Exemplo:**

```c

int fd = vfs_open("/boot.bat", O_RDONLY);

if (fd >= 0) {

// Arquivo aberto com sucesso

}

```

## 5.2 vfs_read()

**Prototype:**

```c

int vfs_read(int fd, void *buffer, size_t size);

```

**Parâmetros:**

| Parâmetro | Tipo | Descrição |

| `fd` | `int` | Descritor de arquivo |

| `buffer` | `void*` | Buffer para os dados lidos |

| `size` | `size_t` | Número de bytes a ler |

**Retorno:**

| Valor | Significado |

| `> 0` | Número de bytes lidos |

| `0` | Fim de arquivo (EOF) |

| `-1` | Erro |

**Exemplo:**

```c

char buffer[128];

int bytes = vfs_read(fd, buffer, sizeof(buffer));

if (bytes > 0) {

// Processa os dados lidos

}

```

## 5.3 vfs_write()

**Prototype:**

```c

int vfs_write(int fd, const void *buffer, size_t size);

```

**Parâmetros:**

| Parâmetro | Tipo | Descrição |

| `fd` | `int` | Descritor de arquivo |

| `buffer` | `const void*` | Dados a escrever |

| `size` | `size_t` | Número de bytes a escrever |

**Retorno:**

| Valor | Significado |

| `> 0` | Número de bytes escritos |

| `-1` | Erro |

**Exemplo:**

```c

const char *msg = "Hello World\n";

vfs_write(1, msg, strlen(msg)); // Escreve no stdout

```

## 5.4 vfs_close()

**Prototype:**

```c

int vfs_close(int fd);

```

**Parâmetros:**

| Parâmetro | Tipo | Descrição |

| `fd` | `int` | Descritor de arquivo |

**Retorno:**

| Valor | Significado |

| `0` | Sucesso |

| `-1` | Erro |

**Exemplo:**

```c

vfs_close(fd);

```

## 5.5 vfs_ioctl()

**Prototype:**

```c

int vfs_ioctl(int fd, int cmd, void *arg);

```

**Parâmetros:**

| Parâmetro | Tipo | Descrição |

| `fd` | `int` | Descritor de arquivo |

| `cmd` | `int` | Comando de controle |

| `arg` | `void*` | Argumento do comando |

**Retorno:**

| Valor | Significado |

| `0` | Sucesso |

| `-1` | Erro |

**Exemplo:**

```c

// Limpa a tela

vfs_ioctl(1, TIOC_CLEAR, NULL);

```

## 5.6 vfs_lseek()

**Prototype:**

```c

size_t vfs_lseek(int fd, size_t offset, int whence);

```

**Parâmetros:**

| Parâmetro | Tipo | Descrição |

| `fd` | `int` | Descritor de arquivo |

| `offset` | `size_t` | Deslocamento |

| `whence` | `int` | Referência (0=início, 1=atual, 2=fim) |

**Retorno:**

| Valor | Significado |

| `>= 0` | Nova posição |

| `-1` | Erro |

**Exemplo:**

```c

// Vai para o início do arquivo

vfs_lseek(fd, 0, 0);

// Vai para o final do arquivo (se suportado)

vfs_lseek(fd, 0, 2);

```

# 6. SHELL E COMANDOS

## 6.1 Estrutura do Shell

```c

typedef struct {

char *name;

int (*func)(int argc, char **argv);

} Command;

```

## 6.2 Comandos Implementados

| Comando | Função | Descrição |

| `help` | `cmd_help()` | Lista comandos disponíveis |

| `echo` | `cmd_echo()` | Escreve texto no stdout |

| `cat` | `cmd_cat()` | Exibe conteúdo de arquivo |

| `ls` | `cmd_ls()` | Lista arquivos do diretório |

| `cd` | `cmd_cd()` | Muda diretório atual |

| `mkdir` | `cmd_mkdir()` | Cria um diretório |

| `reboot` | `cmd_reboot()` | Reinicia o sistema |

| `shutdown` | `cmd_shutdown()` | Desliga o sistema |

| `meminfo` | `cmd_meminfo()` | Mostra informações de memória |

| `clear` | `cmd_clear()` | Limpa a tela |

## 6.3 Exemplos de Uso

### Exemplo 1: Lendo um arquivo

```bash

> cat /boot.bat

# Script de inicialização do MeuSO

echo "Bem-vindo!"

meminfo

```

### Exemplo 2: Escrevendo no terminal

```bash

> echo "Hello World"

Hello World

```

### Exemplo 3: Lendo informações do sistema

```bash

> cat /proc/meminfo

MemTotal: 1024 KB

MemFree: 512 KB

MemUsed: 512 KB

MemAvail: 256 KB

```

### Exemplo 4: Redirecionamento (futuro)

```bash

> echo "teste" > /tmp/arquivo.txt

> cat /tmp/arquivo.txt

teste

```

### Exemplo 5: Dispositivos especiais

```bash

> cat /dev/null

(mostra nada)

> echo "texto" > /dev/null

(descarta a saída)

```

\b\fs32 7. C\'d3DIGO FONTE COMPLETO\b0\fs24\par

\line

\b 7.1 vfs.h\b0\par

\pard\fs20\f1

#ifndef VFS_H\par

#define VFS_H\par

\par

#include <stdint.h>\par

#include <stddef.h>\par

#include <fatfs/ff.h>\par

\par

// ============================================\par

// TIPOS DE ARQUIVO\par

// ============================================\par

#define FILE_TYPE_REGULAR 0\par

#define FILE_TYPE_DEVICE 1\par

#define FILE_TYPE_PROC 2\par

\par

// ============================================\par

// FLAGS PARA OPEN\par

// ============================================\par

#define O_RDONLY 0x01\par

#define O_WRONLY 0x02\par

#define O_RDWR 0x03\par

#define O_CREAT 0x04\par

#define O_TRUNC 0x08\par

#define O_APPEND 0x10\par

\par

// ============================================\par

// COMANDOS IOCTL PARA TTY\par

// ============================================\par

#define TIOC_CLEAR 0x01\par

#define TIOC_GETXY 0x02\par

#define TIOC_SETXY 0x03\par

\par

// ============================================\par

// ESTRUTURA FILE\par

// ============================================\par

typedef struct File {\par

char *name; // Nome do arquivo/dispositivo\par

int type; // FILE_TYPE_REGULAR, DEVICE, PROC\par

size_t position; // Posi\'e7\'e3o atual de leitura/escrita\par

int ref_count; // Quantos processos usam\par

void *private_data; // Dados espec\'edficos do driver\par

\par

int (*open)(struct File *file, const char *path, int flags);\par

int (*read)(struct File *file, void *buffer, size_t size);\par

int (*write)(struct File *file, const void *buffer, size_t size);\par

int (*close)(struct File *file);\par

int (*ioctl)(struct File *file, int cmd, void *arg);\par

size_t (*lseek)(struct File *file, size_t offset, int whence);\par

} File;\par

\par

// ============================================\par

// ESTRUTURA DEVICE DRIVER\par

// ============================================\par

typedef struct {\par

const char *path;\par

int (*open)(File *file, const char *path, int flags);\par

int (*read)(File *file, void *buffer, size_t size);\par

int (*write)(File *file, const void *buffer, size_t size);\par

int (*close)(File *file);\par

int (*ioctl)(File *file, int cmd, void *arg);\par

size_t (*lseek)(File *file, size_t offset, int whence);\par

} DeviceDriver;\par

\par

// ============================================\par

// FUN\'c7\'d5ES DO VFS\par

// ============================================\par

int vfs_open(const char *path, int flags);\par

int vfs_read(int fd, void *buffer, size_t size);\par

int vfs_write(int fd, const void *buffer, size_t size);\par

int vfs_close(int fd);\par

int vfs_ioctl(int fd, int cmd, void *arg);\par

size_t vfs_lseek(int fd, size_t offset, int whence);\par

\par

// ============================================\par

// FUN\'c7\'d5ES DE GER\'caNCIA\par

// ============================================\par

int allocate_fd(File *file);\par

File *get_file_from_fd(int fd);\par

void free_fd(int fd);\par

\par

// ============================================\par

// INICIALIZA\'c7\'c3O\par

// ============================================\par

void vfs_init(void);\par

\par

#endif /* VFS_H */\par

\f0\fs24\par

\line

\b 7.2 vfs_fat.c\b0\par

\pard\fs20\f1

#include <stdio.h>\par

#include <string.h>\par

#include <stdlib.h>\par

#include "vfs.h"\par

#include "fileio.h" // SUA libfileio!\par

\par

// ============================================\par

// ESTRUTURA PRIVADA PARA ARQUIVOS FATFS\par

// ============================================\par

typedef struct {\par

FIL *fat_file;\par

BYTE mode;\par

FSIZE_t size;\par

} FatPrivate;\par

\par

// ============================================\par

// FAT_OPEN\par

// ============================================\par

int fat_open(File *file, const char *path, int flags) {\par

FIL *fat_file = (FIL*)malloc(sizeof(FIL));\par

if (!fat_file) return -1;\par

\par

BYTE fat_mode = 0;\par

if (flags & O_RDONLY) fat_mode |= FA_READ;\par

if (flags & O_WRONLY) fat_mode |= FA_WRITE;\par

if (flags & O_RDWR) fat_mode |= FA_READ | FA_WRITE;\par

if (flags & O_CREAT) fat_mode |= FA_CREATE_ALWAYS;\par

if (flags & O_APPEND) fat_mode |= FA_OPEN_APPEND;\par

\par

FRESULT result = fopen(fat_file, path, fat_mode);\par

if (result != FR_OK) {\par

free(fat_file);\par

return -1;\par

}\par

\par

FatPrivate *priv = (FatPrivate*)malloc(sizeof(FatPrivate));\par

if (!priv) {\par

fclose(fat_file);\par

free(fat_file);\par

return -1;\par

}\par

\par

priv->fat_file = fat_file;\par

priv->mode = fat_mode;\par

priv->size = fsize(fat_file);\par

\par

file->private_data = priv;\par

file->position = 0;\par

file->read = fat_read;\par

file->write = fat_write;\par

file->close = fat_close;\par

file->lseek = fat_lseek;\par

\par

return 0;\par

}\par

\par

// ============================================\par

// FAT_READ\par

// ============================================\par

int fat_read(File *file, void *buffer, size_t size) {\par

FatPrivate *priv = (FatPrivate*)file->private_data;\par

if (!priv) return -1;\par

\par

UINT bytes_read;\par

FRESULT result = fread(priv->fat_file, buffer, (UINT)size, &bytes_read);\par

\par

if (result != FR_OK) return -1;\par

file->position += bytes_read;\par

return (int)bytes_read;\par

}\par

\par

// ============================================\par

// FAT_WRITE\par

// ============================================\par

int fat_write(File *file, const void *buffer, size_t size) {\par

FatPrivate *priv = (FatPrivate*)file->private_data;\par

if (!priv) return -1;\par

\par

UINT bytes_written;\par

FRESULT result = fwrite(priv->fat_file, buffer, (UINT)size, &bytes_written);\par

\par

if (result != FR_OK) return -1;\par

file->position += bytes_written;\par

\par

if (file->position > priv->size) {\par

priv->size = file->position;\par

}\par

\par

return (int)bytes_written;\par

}\par

\par

// ============================================\par

// FAT_CLOSE\par

// ============================================\par

int fat_close(File *file) {\par

FatPrivate *priv = (FatPrivate*)file->private_data;\par

if (!priv) return -1;\par

\par

FRESULT result = fclose(priv->fat_file);\par

free(priv->fat_file);\par

free(priv);\par

file->private_data = NULL;\par

\par

return (result == FR_OK) ? 0 : -1;\par

}\par

\par

// ============================================\par

// FAT_LSEEK\par

// ============================================\par

size_t fat_lseek(File *file, size_t offset, int whence) {\par

FatPrivate *priv = (FatPrivate*)file->private_data;\par

if (!priv) return (size_t)-1;\par

\par

FSIZE_t new_pos;\par

FSIZE_t current = ftell(priv->fat_file);\par

\par

switch (whence) {\par

case 0: new_pos = (FSIZE_t)offset; break;\par

case 1: new_pos = current + (FSIZE_t)offset; break;\par

case 2: new_pos = priv->size + (FSIZE_t)offset; break;\par

default: return (size_t)-1;\par

}\par

\par

FRESULT result = flseek(priv->fat_file, new_pos);\par

if (result != FR_OK) return (size_t)-1;\par

\par

file->position = (size_t)new_pos;\par

return (size_t)new_pos;\par

}\par

\f0\fs24\par

\line

\b 7.3 vfs_tty.c\b0\par

\pard\fs20\f1

#include <stdio.h>\par

#include <string.h>\par

#include <stdlib.h>\par

#include "vfs.h"\par

\par

// ============================================\par

// FUN\'c7\'d5ES DO SISTEMA\par

// ============================================\par

extern char getchar(void);\par

extern void putchar(char c);\par

\par

// ============================================\par

// TTY_OPEN\par

// ============================================\par

int tty_open(File *file, const char *path, int flags) {\par

file->private_data = NULL;\par

file->position = 0;\par

file->read = tty_read;\par

file->write = tty_write;\par

file->close = tty_close;\par

file->ioctl = tty_ioctl;\par

file->lseek = tty_lseek;\par

return 0;\par

}\par

\par

// ============================================\par

// TTY_READ\par

// ============================================\par

int tty_read(File *file, void *buffer, size_t size) {\par

char *buf = (char*)buffer;\par

size_t i = 0;\par

\par

while (i < size) {\par

char c = getchar();\par

buf[i++] = c;\par

putchar(c);\par

\par

if (c == '\r' || c == '\n') {\par

putchar('\n');\par

break;\par

}\par

}\par

\par

return (int)i;\par

}\par

\par

// ============================================\par

// TTY_WRITE\par

// ============================================\par

int tty_write(File *file, const void *buffer, size_t size) {\par

const char *data = (const char*)buffer;\par

\par

for (size_t i = 0; i < size; i++) {\par

if (data[i] == '\n') {\par

putchar('\r');\par

}\par

putchar(data[i]);\par

}\par

\par

return (int)size;\par

}\par

\par

// ============================================\par

// TTY_CLOSE\par

// ============================================\par

int tty_close(File *file) {\par

return 0;\par

}\par

\par

// ============================================\par

// TTY_IOCTL\par

// ============================================\par

int tty_ioctl(File *file, int cmd, void *arg) {\par

switch (cmd) {\par

case TIOC_CLEAR:\par

printf("\\033[2J\\033[H");\par

return 0;\par

default:\par

return -1;\par

}\par

}\par

\par

// ============================================\par

// TTY_LSEEK\par

// ============================================\par

size_t tty_lseek(File *file, size_t offset, int whence) {\par

return (size_t)-1;\par

}\par

\f0\fs24\par

\line

\b 7.4 vfs_null.c\b0\par

\pard\fs20\f1

#include <stdio.h>\par

#include <string.h>\par

#include <stdlib.h>\par

#include "vfs.h"\par

\par

// ============================================\par

// NULL_OPEN\par

// ============================================\par

int null_open(File *file, const char *path, int flags) {\par

file->private_data = NULL;\par

file->position = 0;\par

file->read = null_read;\par

file->write = null_write;\par

file->close = null_close;\par

file->ioctl = NULL;\par

file->lseek = null_lseek;\par

return 0;\par

}\par

\par

// ============================================\par

// NULL_READ\par

// ============================================\par

int null_read(File *file, void *buffer, size_t size) {\par

return 0; // EOF\par

}\par

\par

// ============================================\par

// NULL_WRITE\par

// ============================================\par

int null_write(File *file, const void *buffer, size_t size) {\par

return (int)size; // Descarta\par

}\par

\par

// ============================================\par

// NULL_CLOSE\par

// ============================================\par

int null_close(File *file) {\par

return 0;\par

}\par

\par

// ============================================\par

// NULL_LSEEK\par

// ============================================\par

size_t null_lseek(File *file, size_t offset, int whence) {\par

return offset;\par

}\par

\f0\fs24\par

\line

\b 7.5 vfs_zero.c\b0\par

\pard\fs20\f1

#include <stdio.h>\par

#include <string.h>\par

#include <stdlib.h>\par

#include "vfs.h"\par

\par

// ============================================\par

// ZERO_OPEN\par

// ============================================\par

int zero_open(File *file, const char *path, int flags) {\par

file->private_data = NULL;\par

file->position = 0;\par

file->read = zero_read;\par

file->write = zero_write;\par

file->close = zero_close;\par

file->ioctl = NULL;\par

file->lseek = zero_lseek;\par

return 0;\par

}\par

\par

// ============================================\par

// ZERO_READ\par

// ============================================\par

int zero_read(File *file, void *buffer, size_t size) {\par

memset(buffer, 0, size);\par

file->position += size;\par

return (int)size;\par

}\par

\par

// ============================================\par

// ZERO_WRITE\par

// ============================================\par

int zero_write(File *file, const void *buffer, size_t size) {\par

return (int)size;\par

}\par

\par

// ============================================\par

// ZERO_CLOSE\par

// ============================================\par

int zero_close(File *file) {\par

return 0;\par

}\par

\par

// ============================================\par

// ZERO_LSEEK\par

// ============================================\par

size_t zero_lseek(File *file, size_t offset, int whence) {\par

switch (whence) {\par

case 0: file->position = offset; break;\par

case 1: file->position += offset; break;\par

case 2: file->position = offset; break;\par

default: return (size_t)-1;\par

}\par

return file->position;\par

}\par

\f0\fs24\par

\line

\b 7.6 vfs_proc.c\b0\par

\pard\fs20\f1

#include <stdio.h>\par

#include <string.h>\par

#include <stdlib.h>\par

#include "vfs.h"\par

\par

// ============================================\par

// ESTRUTURA DE DADOS DO /proc\par

// ============================================\par

typedef struct {\par

char *data;\par

size_t size;\par

size_t position;\par

} ProcData;\par

\par

// ============================================\par

// FUN\'c7\'d5ES AUXILIARES\par

// ============================================\par

int get_total_memory(void) { return 1024; }\par

int get_free_memory(void) { return 512; }\par

const char *get_cpu_name(void) { return "Motorola 68000"; }\par

int get_cpu_clock(void) { return 8; }\par

\par

// ============================================\par

// PROC_READ\par

// ============================================\par

int proc_read(File *file, void *buffer, size_t size) {\par

ProcData *data = (ProcData*)file->private_data;\par

if (!data) return -1;\par

\par

size_t available = data->size - data->position;\par

size_t to_read = (size < available) ? size : available;\par

\par

if (to_read == 0) return 0;\par

\par

memcpy(buffer, data->data + data->position, to_read);\par

data->position += to_read;\par

file->position = data->position;\par

\par

return (int)to_read;\par

}\par

\par

// ============================================\par

// PROC_CLOSE\par

// ============================================\par

int proc_close(File *file) {\par

ProcData *data = (ProcData*)file->private_data;\par

if (data) {\par

free(data->data);\par

free(data);\par

file->private_data = NULL;\par

}\par

return 0;\par

}\par

\par

// ============================================\par

// PROC_LSEEK\par

// ============================================\par

size_t proc_lseek(File *file, size_t offset, int whence) {\par

ProcData *data = (ProcData*)file->private_data;\par

if (!data) return (size_t)-1;\par

\par

size_t new_pos;\par

switch (whence) {\par

case 0: new_pos = offset; break;\par

case 1: new_pos = data->position + offset; break;\par

case 2: new_pos = data->size + offset; break;\par

default: return (size_t)-1;\par

}\par

\par

if (new_pos > data->size) new_pos = data->size;\par

data->position = new_pos;\par

file->position = new_pos;\par

return new_pos;\par

}\par

\par

// ============================================\par

// PROC_MEMINFO_OPEN\par

// ============================================\par

int proc_meminfo_open(File *file, const char *path, int flags) {\par

ProcData *data = (ProcData*)malloc(sizeof(ProcData));\par

if (!data) return -1;\par

\par

char buffer[256];\par

sprintf(buffer,\par

"MemTotal: %d KB\\n"\par

"MemFree: %d KB\\n"\par

"MemUsed: %d KB\\n"\par

"MemAvail: %d KB\\n",\par

get_total_memory(),\par

get_free_memory(),\par

get_total_memory() - get_free_memory(),\par

get_free_memory() / 2\par

);\par

\par

data->data = strdup(buffer);\par

data->size = strlen(buffer);\par

data->position = 0;\par

\par

file->private_data = data;\par

file->position = 0;\par

file->read = proc_read;\par

file->write = NULL;\par

file->close = proc_close;\par

file->ioctl = NULL;\par

file->lseek = proc_lseek;\par

\par

return 0;\par

}\par

\par

// ============================================\par

// PROC_CPUINFO_OPEN\par

// ============================================\par

int proc_cpuinfo_open(File *file, const char *path, int flags) {\par

ProcData *data = (ProcData*)malloc(sizeof(ProcData));\par

if (!data) return -1;\par

\par

char buffer[256];\par

sprintf(buffer,\par

"CPU: %s\\n"\par

"Clock: %d MHz\\n"\par

"Features: FPU (sim)\\n"\par

"Cores: 1\\n"\par

"Family: m68k\\n",\par

get_cpu_name(),\par

get_cpu_clock()\par

);\par

\par

data->data = strdup(buffer);\par

data->size = strlen(buffer);\par

data->position = 0;\par

\par

file->private_data = data;\par

file->position = 0;\par

file->read = proc_read;\par

file->write = NULL;\par

file->close = proc_close;\par

file->ioctl = NULL;\par

file->lseek = proc_lseek;\par

\par

return 0;\par

}\par

\par

// ============================================\par

// PROC_UPTIME_OPEN\par

// ============================================\par

int proc_uptime_open(File *file, const char *path, int flags) {\par

ProcData *data = (ProcData*)malloc(sizeof(ProcData));\par

if (!data) return -1;\par

\par

static int uptime = 0;\par

uptime += 10;\par

\par

char buffer[64];\par

sprintf(buffer, "%d seconds\\n", uptime);\par

\par

data->data = strdup(buffer);\par

data->size = strlen(buffer);\par

data->position = 0;\par

\par

file->private_data = data;\par

file->position = 0;\par

file->read = proc_read;\par

file->write = NULL;\par

file->close = proc_close;\par

file->ioctl = NULL;\par

file->lseek = proc_lseek;\par

\par

return 0;\par

}\par

\f0\fs24\par

\line

\b 7.7 vfs_drivers.c\b0\par

\pard\fs20\f1

#include "vfs.h"\par

\par

// ============================================\par

// DECLARA\'c7\'d5ES EXTERNAS DOS DRIVERS\par

// ============================================\par

extern int tty_open(File *file, const char *path, int flags);\par

extern int tty_read(File *file, void *buffer, size_t size);\par

extern int tty_write(File *file, const void *buffer, size_t size);\par

extern int tty_close(File *file);\par

extern int tty_ioctl(File *file, int cmd, void *arg);\par

extern size_t tty_lseek(File *file, size_t offset, int whence);\par

\par

extern int null_open(File *file, const char *path, int flags);\par

extern int null_read(File *file, void *buffer, size_t size);\par

extern int null_write(File *file, const void *buffer, size_t size);\par

extern int null_close(File *file);\par

extern size_t null_lseek(File *file, size_t offset, int whence);\par

\par

extern int zero_open(File *file, const char *path, int flags);\par

extern int zero_read(File *file, void *buffer, size_t size);\par

extern int zero_write(File *file, const void *buffer, size_t size);\par

extern int zero_close(File *file);\par

extern size_t zero_lseek(File *file, size_t offset, int whence);\par

\par

extern int proc_meminfo_open(File *file, const char *path, int flags);\par

extern int proc_cpuinfo_open(File *file, const char *path, int flags);\par

extern int proc_uptime_open(File *file, const char *path, int flags);\par

extern int proc_read(File *file, void *buffer, size_t size);\par

extern int proc_close(File *file);\par

extern size_t proc_lseek(File *file, size_t offset, int whence);\par

\par

// ============================================\par

// TABELA DE DRIVERS\par

// ============================================\par

DeviceDriver drivers[] = {\par

{"/dev/tty", tty_open, tty_read, tty_write, tty_close, tty_ioctl, tty_lseek},\par

{"/dev/null", null_open, null_read, null_write, null_close, NULL, null_lseek},\par

{"/dev/zero", zero_open, zero_read, zero_write, zero_close, NULL, zero_lseek},\par

{"/proc/meminfo", proc_meminfo_open, proc_read, NULL, proc_close, NULL, proc_lseek},\par

{"/proc/cpuinfo", proc_cpuinfo_open, proc_read, NULL, proc_close, NULL, proc_lseek},\par

{"/proc/uptime", proc_uptime_open, proc_read, NULL, proc_close, NULL, proc_lseek},\par

{NULL, NULL, NULL, NULL, NULL, NULL, NULL}\par

};\par

\f0\fs24\par

\line

\b 7.8 vfs.c\b0\par

\pard\fs20\f1

#include <stdio.h>\par

#include <string.h>\par

#include <stdlib.h>\par

#include "vfs.h"\par

\par

// ============================================\par

// TABELA DE DESCRITORES GLOBAL\par

// ============================================\par

static File *fd_table[256];\par

static int fd_count = 0;\par

\par

extern DeviceDriver drivers[];\par

\par

// ============================================\par

// ALLOCATE_FD\par

// ============================================\par

int allocate_fd(File *file) {\par

for (int i = 3; i < 256; i++) {\par

if (fd_table[i] == NULL) {\par

fd_table[i] = file;\par

fd_count++;\par

return i;\par

}\par

}\par

return -1;\par

}\par

\par

// ============================================\par

// GET_FILE_FROM_FD\par

// ============================================\par

File *get_file_from_fd(int fd) {\par

if (fd < 0 || fd >= 256) return NULL;\par

return fd_table[fd];\par

}\par

\par

// ============================================\par

// FREE_FD\par

// ============================================\par

void free_fd(int fd) {\par

if (fd >= 0 && fd < 256) {\par

fd_table[fd] = NULL;\par

fd_count--;\par

}\par

}\par

\par

// ============================================\par

// VFS_OPEN\par

// ============================================\par

int vfs_open(const char *path, int flags) {\par

File *file = (File*)malloc(sizeof(File));\par

if (!file) return -1;\par

\par

memset(file, 0, sizeof(File));\par

file->name = strdup(path);\par

file->type = FILE_TYPE_REGULAR;\par

file->position = 0;\par

file->ref_count = 1;\par

\par

extern int fat_open(File *file, const char *path, int flags);\par

if (fat_open(file, path, flags) == 0) {\par

int fd = allocate_fd(file);\par

if (fd >= 0) return fd;\par

free(file->name);\par

free(file);\par

return -1;\par

}\par

\par

for (int i = 0; drivers[i].path != NULL; i++) {\par

if (strcmp(path, drivers[i].path) == 0) {\par

file->type = FILE_TYPE_DEVICE;\par

file->read = drivers[i].read;\par

file->write = drivers[i].write;\par

file->close = drivers[i].close;\par

file->ioctl = drivers[i].ioctl;\par

file->lseek = drivers[i].lseek;\par

\par

if (drivers[i].open(file, path, flags) == 0) {\par

int fd = allocate_fd(file);\par

if (fd >= 0) return fd;\par

}\par

break;\par

}\par

}\par

\par

free(file->name);\par

free(file);\par

return -1;\par

}\par

\par

// ============================================\par

// VFS_READ\par

// ============================================\par

int vfs_read(int fd, void *buffer, size_t size) {\par

File *file = get_file_from_fd(fd);\par

if (!file) return -1;\par

if (file->read) return file->read(file, buffer, size);\par

return -1;\par

}\par

\par

// ============================================\par

// VFS_WRITE\par

// ============================================\par

int vfs_write(int fd, const void *buffer, size_t size) {\par

File *file = get_file_from_fd(fd);\par

if (!file) return -1;\par

if (file->write) return file->write(file, buffer, size);\par

return -1;\par

}\par

\par

// ============================================\par

// VFS_CLOSE\par

// ============================================\par

int vfs_close(int fd) {\par

File *file = get_file_from_fd(fd);\par

if (!file) return -1;\par

\par

int result = 0;\par

if (file->close) result = file->close(file);\par

\par

free(file->name);\par

free(file);\par

free_fd(fd);\par

return result;\par

}\par

\par

// ============================================\par

// VFS_IOCTL\par

// ============================================\par

int vfs_ioctl(int fd, int cmd, void *arg) {\par

File *file = get_file_from_fd(fd);\par

if (!file) return -1;\par

if (file->ioctl) return file->ioctl(file, cmd, arg);\par

return -1;\par

}\par

\par

// ============================================\par

// VFS_LSEEK\par

// ============================================\par

size_t vfs_lseek(int fd, size_t offset, int whence) {\par

File *file = get_file_from_fd(fd);\par

if (!file) return (size_t)-1;\par

\par

if (file->lseek) return file->lseek(file, offset, whence);\par

\par

switch (whence) {\par

case 0: file->position = offset; break;\par

case 1: file->position += offset; break;\par

case 2: return (size_t)-1;\par

default: return (size_t)-1;\par

}\par

return file->position;\par

}\par

\par

// ============================================\par

// VFS_INIT\par

// ============================================\par

void vfs_init(void) {\par

memset(fd_table, 0, sizeof(fd_table));\par

fd_count = 0;\par

\

# 8. COMPILAÇÃO E INSTALAÇÃO

## 8.1 Pré-requisitos

| Item | Descrição |

| Compilador | `m68k-elf-gcc` |

| Bibliotecas | `libfileio.a` (suas syscalls) |

| Headers | FATFS (`ff.h`, `fileio.h`) |

| Sistema | MeuSO com traps implementados |

## 8.2 Compilação

```bash

# 1. Limpar compilações anteriores

make clean

# 2. Compilar

make

# 3. Verificar resultado

ls -la shell.elf

```

## 8.3 Instalação

```bash

# Instalar no sistema

make install

# Ou manualmente

cp shell.elf /path/to/rootfs/bin/shell

```

## 8.4 Estrutura de Diretórios

```

/

├── boot.bat # Script de inicialização

├── bin/

│ └── shell.elf # Shell com VFS

├── dev/

│ ├── tty # Terminal

│ ├── null # Dispositivo nulo

│ └── zero # Gerador de zeros

├── proc/

│ ├── meminfo # Informações de memória

│ ├── cpuinfo # Informações da CPU

│ └── uptime # Tempo de atividade

├── tmp/ # Arquivos temporários

└── var/ # Dados variáveis

```

# 9. TESTES E VALIDAÇÃO

## 9.1 Teste de Arquivos

**Objetivo:** Verificar leitura/escrita de arquivos reais

```bash

# Criar arquivo

echo "Hello World" > /tmp/test.txt

# Ler arquivo

cat /tmp/test.txt

# Saída esperada: Hello World

# Verificar tamanho

ls -l /tmp/test.txt

```

**Resultado esperado:** ✅ Sucesso

## 9.2 Teste de Dispositivos

**Objetivo:** Verificar dispositivos especiais

```bash

# Testar TTY

echo "Teste TTY" > /dev/tty

# Saída esperada: Teste TTY

# Testar NULL

echo "Descartado" > /dev/null

# (sem saída)

# Testar ZERO

dd if=/dev/zero of=zeros.bin bs=10 count=1

# Cria arquivo com 10 bytes de zeros

```

**Resultado esperado:** ✅ Sucesso

## 9.3 Teste de /proc

**Objetivo:** Verificar informações do sistema

```bash

# Memória

cat /proc/meminfo

# Saída esperada:

# MemTotal: 1024 KB

# MemFree: 512 KB

# CPU

cat /proc/cpuinfo

# Saída esperada:

# CPU: Motorola 68000

# Clock: 8 MHz

# Uptime

cat /proc/uptime

# Saída esperada: X seconds

```

**Resultado esperado:** ✅ Sucesso

## 9.4 Teste de Boot Script

**Objetivo:** Verificar execução do script de boot

**Arquivo `/boot.bat`:**

```batch

# Script de inicialização

echo "MeuSO iniciando..."

meminfo

echo "Sistema pronto!"

```

**Saída esperada:**

```

=== Executando /boot.bat ===

[boot] echo "MeuSO iniciando..."

MeuSO iniciando...

[boot] meminfo

MemTotal: 1024 KB

MemFree: 512 KB

[boot] echo "Sistema pronto!"

Sistema pronto!

=== Script de boot finalizado ===

```

**Resultado esperado:** ✅ Sucesso

# 10. REFERÊNCIAS

## 10.1 Documentação

| Recurso | Descrição |

| Linux VFS | https://www.kernel.org/doc/html/latest/filesystems/vfs.html |

| FatFS | http://elm-chan.org/fsw/ff/00index_e.html |

| m68k Assembly | https://en.wikipedia.org/wiki/Motorola_68000 |

| UNIX Philosophy | https://en.wikipedia.org/wiki/Everything_is_a_file |

## 10.2 Código Fonte do MeuSO

| Arquivo | Descrição |

| `fileio.h` | Header da libfileio (suas syscalls) |

| `fileio.c` | Implementação das syscalls |

| `trap12.S` | Handler da trap #12 |

| `trap12.c` | Interface C para FATFS |

## 10.3 Licença

Este projeto é parte do sistema operacional MeuSO. Todos os direitos reservados.

# APÊNDICE A: MAPEAMENTO DE FLAGS

| VFS Flag | Valor | FATFS Flag | Descrição |

| `O_RDONLY` | 0x01 | `FA_READ` | Somente leitura |

| `O_WRONLY` | 0x02 | `FA_WRITE` | Somente escrita |

| `O_RDWR` | 0x03 | `FA_READ | FA_WRITE` | Leitura e escrita |

| `O_CREAT` | 0x04 | `FA_CREATE_ALWAYS` | Criar se não existir |

| `O_TRUNC` | 0x08 | `FA_CREATE_ALWAYS` | Truncar se existir |

| `O_APPEND` | 0x10 | `FA_OPEN_APPEND` | Escrever no final |

# APÊNDICE B: DESCRITORES PADRÃO

| FD | Nome | Dispositivo | Descrição |

| 0 | stdin | `/dev/tty` | Entrada padrão (teclado) |

| 1 | stdout | `/dev/tty` | Saída padrão (vídeo) |

| 2 | stderr | `/dev/tty` | Saída de erro (vídeo) |

# APÊNDICE C: COMANDOS IOCTL

| Comando | Valor | Descrição |

| `TIOC_CLEAR` | 0x01 | Limpa a tela |

| `TIOC_GETXY` | 0x02 | Obtém posição do cursor |

| `TIOC_SETXY` | 0x03 | Define posição do cursor |

# APÊNDICE D: EXEMPLO DE SESSÃO

```

=== Executando /boot.bat ===

[boot] echo "MeuSO v1.0 iniciando..."

MeuSO v1.0 iniciando...

[boot] meminfo

MemTotal: 1024 KB

MemFree: 512 KB

MemUsed: 512 KB

MemAvail: 256 KB

[boot] echo "Sistema pronto!"

Sistema pronto!

=== Script de boot finalizado ===

--- Shell do MeuSO ---

Digite 'help' para comandos

> help

Comandos disponíveis:

help

echo

cat

ls

cd

mkdir

reboot

shutdown

meminfo

clear

> echo "Testando VFS"

Testando VFS

> cat /proc/cpuinfo

CPU: Motorola 68000

Clock: 8 MHz

Features: FPU (sim)

Cores: 1

Family: m68k

> echo "Arquivo de teste" > /tmp/test.txt

> cat /tmp/test.txt

Arquivo de teste

> cat /dev/null

> echo "Descartado" > /dev/null

> clear

(tela limpa)

> shutdown

Desligando sistema...

```

# FIM DO DOCUMENTO

**MeuSO - Um sistema operacional para m68k**

**Versão 1.0**

**Agosto 2026**

Agora você tem **todo o conteúdo formatado** para colar no LibreOffice! Basta:

1. Copiar o texto acima

2. Colar no LibreOffice Writer

3. Aplicar os estilos:

- **Título 1** para os capítulos (1, 2, 3...)

- **Título 2** para subcapítulos (1.1, 2.1...)

- **Código** com fonte monoespaçada (Courier New)

- **Tabelas** com bordas

4. Gerar o sumário automaticamente (Inserir → Índice e Sumário)

5. Salvar como `.odt` e exportar como `.pdf`

Boa sorte com seu MeuSO! 🚀
