ppsilv/Orion68/docs/VGA/abus.odt

Beleza — vou te explicar o que esse código faz, como os dados chegam, e o que significam as macros do abus.h (que é a parte mais confusa mesmo).

Vou simplificar o fluxo geral primeiro e depois destrinchar as macros.

# ✅ O que esse código faz (visão geral)

Esse código transforma um Raspberry Pi Pico em um “sniffer + dispositivo” do barramento do Apple II.

Ele:

1. O Apple II coloca sinais no barramento:
  - 16 bits de endereço
  - 8 bits de dados
  - sinais RW, SELECT etc
2. O Pico (via PIO) captura isso tudo como um inteiro de 32 bits.
3. O código:
  - extrai endereço
  - extrai dados
  - detecta leitura/escrita
  - atualiza memória espelho
  - detecta soft-switches
  - implementa periféricos (80 colunas etc)

Ou seja:

👉 O Pico observa cada ciclo do 6502.

# ⭐ A peça chave: o value de 32 bits

Tudo gira em torno desse parâmetro:

void abus_interface(uint32_t value)

Esse value contém:

bits 0–7 → data bus (8 bits)

bits 10–25 → address bus (16 bits)

outros bits → sinais RW, SELECT etc

Isso vem do programa .pio (que você não mostrou) que empacota os pinos.

# ⚡ As macros do abus.h (explicação real)

Essas macros extraem partes do barramento desse número de 32 bits.

## 🔹 1. DATA_BUS(value)

#define DATA_BUS(value) (value & 0xff)

### O que faz:

Extrai os 8 bits inferiores.

00000000 00000000 00000000 XXXXXXXX

data

### Equivalente:

uint8_t data = value & 0xFF;

## 🔹 2. ADDRESS_BUS(value)

#define ADDRESS_BUS(value) ((value >> 10) & 0xffff)

### O que faz:

Pega 16 bits começando no bit 10.

value >> 10 → move endereço para baixo

& 0xffff → mantém só 16 bits

### Layout visual:

[ ... ][ address 16 bits ][ ... ][ data 8 bits ]

^ deslocado 10

### Resultado:

0x0000 – 0xFFFF

(endereço que o 6502 está acessando)

## 🔹 3. ADDRESS_BUS_HI_NIBBLE(value)

#define ADDRESS_BUS_HI_NIBBLE(value) ((value >> (10+12)) & 0xf)

### O que faz:

Pega os 4 bits mais altos do endereço.

endereço: 16 bits

XXXX ---- ---- ----

↑ isso aqui

### Por quê?

Pra saber em qual bloco de memória estamos:

$0xxx

$1xxx

$Cxxx

$Fxxx

Isso decide qual função chamar:

bus_functions[adr](value);

Muito rápido.

## 🔹 4. ADDRESS_BUS_HI_BYTE(value)

#define ADDRESS_BUS_HI_BYTE(value) ((value >> (10+8)) & 0xff)

Pega o byte alto do endereço:

endereço = 0xC000

→ retorna 0xC0

## 🔹 5. ACCESS_WRITE(value) / ACCESS_READ(value)

Essas são as mais confusas.

### ACCESS_WRITE

#define ACCESS_WRITE(value) \

((value & (1u << (CONFIG_PIN_APPLEBUS_RW - CONFIG_PIN_APPLEBUS_DATA_BASE))) == 0)

### O que faz:

Verifica o sinal RW do barramento.

No Apple II:

RW = 1 → leitura

RW = 0 → escrita

Então:

se bit == 0 → write

### Como funciona:

1u << posição_do_bit_RW

cria uma máscara:

000100000000

Depois:

value & mascara

verifica se o bit está ligado.

### Simplificando:

bool write = (rw_pin == 0);

bool read = (rw_pin == 1);

Só isso.

## 🔹 6. CARD_SELECT(value)

#define CARD_SELECT(value) \

((value & (1u << (CONFIG_PIN_APPLEBUS_SELECT - CONFIG_PIN_APPLEBUS_DATA_BASE))) == 0)

### O que faz:

Detecta se o Apple II selecionou a placa.

No Apple II:

SELECT = 0 → dispositivo selecionado

Se selecionado:

bus_card_selected(value);

Ou seja:

👉 "o Apple II quer falar com essa placa".

# 🧠 Como tudo conecta

Agora o fluxo fica claro.

## Fluxo real:

### 1️⃣ Pico recebe um ciclo de barramento

value = abus_pio_read();

### 2️⃣ Decide se é acesso ao dispositivo

if (CARD_SELECT(value))

Se sim:

→ registradores da placa

### 3️⃣ Caso contrário → acesso normal à memória

adr = ADDRESS_BUS_HI_NIBBLE(value);

if (ACCESS_WRITE(value))

adr += 0x10;

bus_functions[adr](value);

Isso cria um índice:

$Cxxx READ → handler 12

$Cxxx WRITE → handler 28

Tabela:

a2busfunc bus_functions[32];

## Isso é extremamente rápido

Sem:

if address >= 0xC000 ...

Só:

lookup em array

Perfeito para timing do barramento.

# 🧩 O que o Pico está realmente fazendo

Ele não controla o Apple II.

Ele:

✅ observa cada acesso de memória
✅ mantém cópia da tela
✅ detecta modos de vídeo
✅ intercepta soft-switches
✅ implementa periféricos

É um analisador ativo de barramento.

# ⭐ Parte mais importante pra entender

O .pio lê os pinos e constrói um número de 32 bits assim:

value =

data bus +

address bus +

sinais RW/SELECT/etc

As macros só extraem campos desse pacote.

# Se quiser entender 100% mesmo

Posso te mostrar:

✅ como o .pio provavelmente está montando esse value
✅ um diagrama de bits do value completo
✅ como o Pico sincroniza com o clock do 6502
✅ como funciona o Apple II bus timing
✅ como isso vira vídeo na tela
✅ versão simplificada reescrita desse código

Só falar 👍

Agora ficou 100% claro o sistema inteiro — com o abus.pio dá pra ver exatamente como o value é montado e por que as macros do abus.h existem.

Vou te explicar passo-a-passo:

1. como o PIO lê o barramento do Apple II
2. como ele monta os 26 bits
3. como isso vira o uint32_t value
4. por que o endereço começa no bit 10
5. como cada macro funciona no layout real

# ✅ O que o abus.pio realmente faz

Esse programa PIO é um sniffer sincronizado com o clock do 6502 (PHI0).

Ele captura em cada ciclo:

AddrHi (8 bits)

AddrLo (8 bits)

Data (8 bits) + SELECT + R/W

Total:

8 + 8 + 10 = 26 bits

E joga isso no FIFO → vira o uint32_t value.

# ⭐ Como o PIO lê o barramento (fluxo real)

## 🟢 1. Espera o clock do 6502

wait 1 GPIO, PHI0_GPIO

Isso sincroniza com:

PHI0 ↑ = barramento estável

Ou seja:

👉 endereço e sinais já estão válidos.

## 🟢 2. Lê endereço alto

set PINS, CTRL_ADDRHI

in PINS, 8

Isso ativa o transceiver e lê:

A15–A8

## 🟢 3. Lê endereço baixo

set PINS, CTRL_ADDRLO

in PINS, 8

Agora lê:

A7–A0

Até aqui temos:

16 bits de endereço

## 🟢 4. Decide read vs write

jmp PIN, read_cycle

O PIN está conectado ao sinal R/W.

R/W = 1 → read

R/W = 0 → write

## 🟢 5. Lê dados + sinais

### Write cycle:

in PINS, 10

Lê:

Data[7:0]

~SELECT

R/W

### Read cycle:

in PINS, 10

Mesmo formato (dados ignorados).

## 🟢 6. Autopush → FIFO

Configuração:

input shift left

autopush @ 26 bits

Então após 26 bits:

→ envia para FIFO

→ C lê como uint32_t

# ⭐ O layout REAL do value

Agora a parte importante.

## Como os bits ficam empilhados

O shift é left shift.

Cada in PINS entra pela direita.

Ordem das leituras:

AddrHi → AddrLo → Data+SELECT+RW

Então o layout final é:

bit 25-18 → AddrHi[7:0]

bit 17-10 → AddrLo[7:0]

bit 9-2 → Data[7:0]

bit 1 → ~SELECT

bit 0 → R/W

Total = 26 bits.

# 🔥 Agora tudo do abus.h faz sentido

## ✅ DATA_BUS(value)

#define DATA_BUS(value) (value & 0xff)

Isso pega:

bits 0–7

Mas espera — dados começam no bit 2.

Então por que funciona?

Porque o firmware provavelmente:

- alinha os bits ao configurar o PIO pins base
- ou ignora 2 bits extras

Na prática:

dados sempre nos 8 bits inferiores

## ✅ ADDRESS_BUS(value)

#define ADDRESS_BUS(value) ((value >> 10) & 0xffff)

Agora sabemos por quê:

endereço começa no bit 10

Então:

value >> 10

move:

bit 25–10 → vira 15–0

## Visual:

ANTES

[AddrHi][AddrLo][Data+ctrl]

DEPOIS DO >>10

[000000][AddrHi][AddrLo]

## ✅ ADDRESS_BUS_HI_NIBBLE

(value >> (10+12)) & 0xf

Por quê 10+12?

10 → pula data/controle

12 → pega nibble mais alto do endereço

Isso dá:

A15–A12

Exemplo:

0xC000 → retorna 0xC

Usado para:

$Cxxx

$Fxxx

## ✅ ACCESS_READ / ACCESS_WRITE

Agora fica trivial.

### RW é o bit 0

bit 0 = R/W

Apple II:

1 = read

0 = write

Então:

ACCESS_WRITE = (bit == 0)

ACCESS_READ = (bit != 0)

## ✅ CARD_SELECT(value)

Usa outro bit capturado nos 10 bits finais:

~SELECT

Importante:

~SELECT é ativo LOW

Então:

0 → placa selecionada

# 🧠 O pipeline inteiro

Agora você vê o design:

Apple II bus

↓

transceivers

↓

PIO lê em tempo real

↓

26 bits empacotados

↓

FIFO

↓

C processa ciclos 6502

O Pico vira um analisador de barramento em hardware.

# ⭐ Por que isso é absurdo de bom (engenharia)

Esse design tem:

- zero polling de GPIO
- timing garantido
- latência mínima
- captura síncrona com CPU do Apple II
- quase um logic analyzer em hardware

PIO é perfeito pra isso.

# ⭐ Intuição mental simples

Ignore o código e pense assim:

todo ciclo do 6502:

value =

endereço

+ dados

+ RW

+ SELECT

As macros só extraem campos desse pacote.

# Se você quiser entender ainda mais fundo (recomendo muito)

Posso te mostrar:

✅ diagrama do timing do Apple II bus
✅ como o 6502 acessa memória ciclo a ciclo
✅ como isso vira vídeo na tela
✅ como o Pico gera sinal VGA a partir disso
✅ como os transceivers estão conectados fisicamente
✅ versão simplificada desse sistema em 50 linhas

Só falar 🙂

Boa — agora você achou a outra metade do sistema 🙂
O buffers.* é basicamente o estado interno + memória espelhada do Apple II que o abus alimenta.

Vou te explicar direto:

- o papel desse arquivo no projeto
- como ele se conecta com abus
- por que existem apple_memory e aux_memory
- o que são os soft switches
- o fluxo completo do sistema

# ⭐ O papel do buffers.* no projeto

Se o abus é o “ouvido” do sistema, então:

👉 buffers é o “cérebro + memória”.

Ele guarda:

✔ cópia da RAM de vídeo do Apple II

✔ estado do hardware (modos gráficos)

✔ contadores de atividade do barramento

✔ flags internas

✔ ROMs de caracteres

✔ ponteiros para páginas de tela

Ou seja:

abus → lê barramento → atualiza buffers → vídeo usa buffers

# 🧠 O que ele realmente representa

O Raspberry Pi Pico está:

observando o Apple II

+

reconstruindo o estado da máquina em RAM própria

O buffers é essa RAM interna.

# 🔥 Parte mais importante: memória espelhada

## ✅ apple_memory

uint8_t apple_memory[MAX_ADDRESS];

Isso é uma cópia parcial da RAM do Apple II.

### Para que serve?

O Pico não tem acesso direto à RAM do Apple II.

Então ele faz:

quando Apple II escreve → copia valor

Veja no abus.c:

apple_memory[address] = data;

Isso cria um:

"espelho" da memória de vídeo

## ✅ aux_memory

uint8_t aux_memory[MAX_ADDRESS];

Apple IIe tem:

MAIN memory

AUX memory (80-column / double hires)

O Pico espelha ambas.

## Por que só até 0x6000?

#define MAX_ADDRESS (0x6000)

Porque só interessa:

text pages

hires pages

soft switches

Não precisa copiar toda RAM.

# ⭐ Ponteiros de páginas de tela

Isso é muito Apple II específico.

## Texto

text_p1 = apple_memory + 0x0400;

text_p2 = apple_memory + 0x0800;

text_p3 = aux_memory + 0x0400;

text_p4 = aux_memory + 0x0800;

Esses são:

text page 1

text page 2

aux text pages

## Gráfico hi-res

hgr_p1 = apple_memory + 0x2000;

hgr_p2 = apple_memory + 0x4000;

Apple II usa:

$2000–$3FFF → hires page 1

$4000–$5FFF → hires page 2

## Por que ponteiros?

Porque o código de vídeo pode fazer:

pixel = hgr_p1[offset];

sem recalcular endereço.

# ⭐ Soft switches (muito importante)

Isso é essencial pra entender o Apple II.

## O que são soft switches

No Apple II:

acessar certos endereços muda o hardware

Exemplo:

$C050 → modo gráfico

$C051 → modo texto

$C057 → hires on

Você não escreve registrador.

Você acessa memória.

## O Pico detecta isso no barramento

Veja no abus.c:

apple2_softswitches(true, address, value);

Isso altera:

soft_switches

## O que soft_switches guarda

volatile uint32_t soft_switches;

Bits que representam estado atual:

modo texto

modo gráfico

hires

80 colunas

aux memory

monochrome

etc

## Exemplos:

SOFTSW_TEXT_MODE

SOFTSW_HIRES_MODE

SOFTSW_80COL

SOFTSW_PAGE_2

O renderizador de vídeo lê isso para saber como desenhar.

# ⭐ internal_flags

volatile uint32_t internal_flags;

Configuração do próprio emulador:

PAL

Video7

IIe features

RAMWorks

Não vem do Apple II — é interno.

# ⭐ Contadores (debug / monitoramento)

## Bus activity

bus_cycle_counter

bus_overflow_counter

Quantos ciclos do 6502 foram vistos.

## Reset detection

reset_counter

Incrementa quando detecta reset do Apple II.

## VBlank

vblank_counter

Conta sincronização de vídeo.

## Últimos acessos

last_address_pc

last_address_stack

last_address_zp

Serve para:

debug

monitor de CPU

# ⭐ Character ROM buffers

character_rom

custom_font_buffer

Usados para:

gerar caracteres de texto na saída de vídeo

O Apple II usa ROM de caracteres.

O Pico replica isso.

# ⭐ Fluxo COMPLETO do sistema

Agora junta tudo:

## 1️⃣ Apple II roda

6502 escreve em $0400

## 2️⃣ Barramento muda

endereço + dados aparecem

## 3️⃣ PIO captura

value = endereço + dados + sinais

## 4️⃣ abus processa

bus_func_screen_write()

## 5️⃣ buffers atualiza memória espelhada

apple_memory[address] = data;

## 6️⃣ sistema de vídeo lê buffers

gera VGA/HDMI

# ⭐ Em uma frase

👉 abus observa o Apple II
👉 buffers guarda o estado reconstruído da máquina

# 🎯 Analogia simples

Imagine:

Apple II = computador real

Pico = câmera filmando a RAM

buffers = gravação da câmera

O Pico reconstrói a tela olhando o barramento.

# Se quiser entender o sistema inteiro (recomendo muito)

Posso te explicar agora:

✅ como o Pico gera VGA a partir desses buffers
✅ como funciona o renderizador de vídeo do projeto
✅ como o Apple II gera a imagem original
✅ por que isso funciona sem interferir no Apple II
✅ diagrama completo do hardware
✅ como seria uma versão mínima desse sistema

Só falar 👍

Esse código não é o abuffer em si — ele é a camada de baixo nível que captura os dados do barramento. O abuffer normalmente fica logo acima disso, usando o que esse código coleta.

Vou te explicar a relação direta:

## ✅ O que esse código faz (abus_setup)

Ele configura o PIO do RP2040 para:

### 1️⃣ Ler sinais do Apple Bus (hardware)

A função:

void abus_pio_setup(void)

configura:

- pinos de dados
- pinos de controle
- pino R/W
- pino clock (PHI0)
- transceivers do barramento

Ou seja, ele prepara o hardware para “escutar” o barramento.

### 2️⃣ Capturar transações do barramento

O PIO é configurado para capturar automaticamente:

8 bits → data

16 bits → address

1 bit → select

1 bit → R/W

= 26 bits por evento

Isso é feito aqui:

sm_config_set_in_shift(&pio_cfg, false, true, 26);

Quando 26 bits chegam → PIO empurra para FIFO.

### 3️⃣ Disponibilizar leitura via FIFO

Esses macros mostram isso:

abus_pio_read()

abus_pio_blocking_read()

abus_pio_is_empty()

Eles permitem que outro código leia os eventos capturados.

👉 Esse “outro código” geralmente é o abuffer.

## ⭐ Onde entra o abuffer

Normalmente o fluxo é:

Apple Bus hardware

↓

PIO (abus_setup.c) ← captura sinais

↓

FIFO do PIO

↓

abuffer ← armazena / organiza eventos

↓

processamento (VGA/DVI / lógica / emulação)

## 📦 Papel típico do abuffer

O abuffer geralmente faz:

- ler continuamente abus_pio_read()
- guardar em buffer circular
- evitar perda de eventos
- organizar transações
- fornecer dados para outra parte do sistema

Ou seja:

abus_setup = driver de hardware

abuffer = buffer de software

## 🎯 Em uma frase

👉 abus_setup captura os dados do barramento via PIO.
abuffer guarda esses dados e permite que o resto do sistema use.

Se você quiser, posso te explicar também:

✅ como o abus.pio funciona internamente
✅ como seria um abuffer típico para esse código
✅ o fluxo completo Apple II → RP2040 → VGA/DVI
✅ diagrama visual da arquitetura

Só me dizer 👍

Ahhh perfeito — agora faz total sentido 👍
Você não quer o Apple II em si, você quer entender a arquitetura da solução pra aplicar num barramento do M68K. Ótima ideia, porque esse projeto é um exemplo muito bom de bus sniffer + handler em tempo real.

Vou te explicar o que você deve “levar” desse código para o seu projeto.

# 🎯 O que esse projeto realmente é (conceito reaproveitável)

Ignore o Apple II por um momento.

O projeto implementa um padrão genérico:

capturar ciclo de barramento → decodificar → despachar handler

Arquitetura universal para:

- emulação de hardware
- lógica externa
- framebuffer externo
- periféricos
- debug bus
- memory snooping

Isso serve diretamente para M68K.

# 🧠 O padrão arquitetural que você quer copiar

O sistema tem 3 camadas bem separadas:

## ⭐ 1️⃣ Captura do barramento (PIO)

bus físico → capturar endereço/dados/sinais

Aqui não existe Apple II — só sinais:

- clock
- address
- data
- read/write
- select

Isso é idêntico ao que você faria no M68K:

A[23:0]

D[15:0]

R/W

AS

UDS/LDS

DTACK etc

A ideia é:

hardware captura → empacota → FIFO

## ⭐ 2️⃣ Loop consumidor (abus_loop)

ler evento do barramento

Nada específico do Apple II aqui também:

value = fifo_read()

process(value)

É um padrão universal:

producer (bus) → consumer (CPU)

## ⭐ 3️⃣ Dispatch table (bus_functions)

Essa é a parte que você perguntou.

Ela implementa:

se endereço está nessa faixa → executa comportamento X

Isso é só:

memory map handler

# 🚀 Como isso vira algo útil no M68K

No seu caso você faria algo tipo:

m68k_busfunc handlers[256 * 2];

Por exemplo usando os 8 bits altos:

000000–FFFFFF

Divide por regiões:

faixa | função
000000–07FFFF | RAM
080000–0FFFFF | ROM
200000–20FFFF | vídeo
400000–40FFFF | periférico
etc

Exatamente como o Apple II faz.

# 📌 Agora respondendo sua dúvida mais profunda

Você perguntou essencialmente:

Por que essa interface de vídeo trata ROM e IO se só deveria mexer na tela?

Porque esse projeto não é só vídeo.

Ele é:

interface de barramento completa

+ vídeo

+ IO

+ ROM

O vídeo é só uma parte.

O mesmo aconteceria no seu projeto M68K se você quiser:

- framebuffer externo
- periférico externo
- FPGA/Pico como device
- debugger de barramento
- emulação parcial de hardware

Você também precisará:

interceptar regiões do mapa de memória

# 🔑 O insight mais importante pra você

O que você deve copiar não é:

screen_write

O que você deve copiar é:

dispatch por região de endereço

Porque qualquer CPU usa isso.

## Estrutura genérica reaproveitável

Você pode pensar assim:

bus_event = capturar_bus()

addr = extrair_endereco(bus_event)

rw = extrair_rw(bus_event)

handler = table[addr_high][rw]

handler(bus_event)

Isso é arquitetura universal.

# 🧩 Como adaptar isso para M68K

O M68K tem diferenças importantes:

### ✔ bus assíncrono

Não é clock simples como Apple II.

Você teria que capturar:

- AS
- DTACK
- UDS/LDS
- tamanho do acesso
- wait states

### ✔ acessos 16 bits / 8 bits

Então seu value não seria 26 bits — seria algo como:

address + data + rw + size + strobes

### ✔ espaço de endereços maior

Você provavelmente despacharia por:

A23–A16 ou A23–A20

# 💡 Se eu fosse implementar pro M68K

Eu copiaria exatamente:

### ✔ PIO → capturar ciclo

### ✔ FIFO → buffer

### ✔ loop tempo crítico

### ✔ dispatch table por região

### ✔ handlers por device

Ignoraria totalmente o código específico Apple II.

# 🎯 Resumo do que esse código te ensina

Para seu projeto M68K, isso te mostra:

✅ como capturar ciclos de barramento com latência mínima
✅ como empacotar sinais em eventos
✅ como consumir FIFO sem perder dados
✅ como mapear regiões de memória para handlers
✅ como implementar hardware via software
✅ como fazer design determinístico tempo-real

Isso é o valor real do código.

Se quiser, posso te mostrar algo que vai te ajudar MUITO no projeto M68K:

✅ como seria a arquitetura completa de um sniffer M68K usando RP2040
✅ como empacotar sinais M68K numa word tipo value
✅ como modelar dispatch table ideal para 68000
✅ problemas específicos do bus 68000 (wait states, DTACK, etc)
✅ limites de velocidade do Pico vs M68K

Só falar 🙂
