ppsilv/Orion68/peripheral/pico2VGA/docs/AddressDecode.odt

68000: UDS, LDS e Endereços

Você tem razão em questionar, porque a nomenclatura do 68000 é famosa por causar confusão mental, especialmente porque ele é um processador Big-Endian.

Vamos alinhar os conceitos, pois aqui a lógica inverte o que estamos acostumados em processadores como o Z80 ou x86:

### 1. A Regra do 68000 (Big-Endian)

No MC68000, o Byte Mais Significativo (Most Significant Byte - MSB) fica no endereço PAR, e o Byte Menos Significativo (Least Significant Byte - LSB) fica no endereço ÍMPAR.

- D8 - D15 (Barramento de Dados Alto): Conecta-se ao Byte de endereço PAR (ex: 0x0000, 0x0002).
- D0 - D7 (Barramento de Dados Baixo): Conecta-se ao Byte de endereço ÍMPAR (ex: 0x0001, 0x0003).

### 2. O papel dos Strobes ($\overline{UDS}$ e $\overline{LDS}$)

Agora, veja como os nomes dos strobes se conectam aos pinos de dados:

- $\overline{UDS}$ (Upper Data Strobe): Controla os bits D8-D15. Como esses bits representam o endereço PAR, o $\overline{UDS}$ é ativado para endereços PARES.
- $\overline{LDS}$ (Lower Data Strobe): Controla os bits D0-D7. Como esses bits representam o endereço ÍMPAR, o $\overline{LDS}$ é ativado para endereços ÍMPARES.

Resumo da Tabela de Verdade:

| Endereço | Tipo de Acesso | $\overline{UDS}$ (Pino 7) | $\overline{LDS}$ (Pino 8) | Barramento Ativo |

| :--- | :--- | :--- | :--- | :--- |

| 0x0000 | Byte (Par) | 0 (Ativo) | 1 (Inativo) | D15 - D8 |

| 0x0001 | Byte (Ímpar) | 1 (Inativo) | 0 (Ativo) | D7 - D0 |

| 0x0000 | Word (16-bit) | 0 (Ativo) | 0 (Ativo) | D15 - D0 |

### 3. Por que a confusão?

Muitas vezes pensamos: "Se o endereço é 0 (Low), o sinal deveria ser LDS (Low Data Strobe)". Mas no 68000, a palavra "Lower" e "Upper" refere-se à posição do bit no barramento de dados de 16 bits, e não ao valor numérico do endereço.

- Upper = Bits altos (D15-D8) = Endereço Par (porque é Big-Endian).
- Lower = Bits baixos (D7-D0) = Endereço Ímpar.

### Como isso afeta sua GAL?

Se o seu Raspberry Pi Pico estiver mapeado em um endereço PAR (por exemplo, 0x400000), o 68000 vai descer o $\overline{UDS}$ para falar com ele. Se estiver no ÍMPAR (0x400001), será o $\overline{LDS}$.

Se você quer que o Pico responda independentemente de ser um acesso de Byte ou Word, a lógica que discutimos antes continua valendo:

!DTACK = !CS_PICO & (!UDS # !LDS) & PICO_READY;

Isso garante que, se o 68000 "encostar" em qualquer um dos strobes (seja para o byte par ou ímpar), o $\overline{DTACK}$ será gerado.

Ficou mais claro agora? Essa inversão "Upper = Par" e "Lower = Ímpar" é um dos primeiros "nós" que todo mundo tem que desatar quando estuda a arquitetura 68k.
