ppsilv/Orion68/peripheral/pico2VGA/docs/cga.odt

Vamos deixar esse Vpico2 312k com o visual clássico "sangue puro" da IBM.

Como estou usando o formato 3-3-2 (RGB) no buffer de vídeo, precisamos converter as 16 cores da paleta CGA (IRGB) para os valores de 8 bits que o hardware entende.

No sistema 3-3-2, o byte é dividido assim:

- Bits 7, 6, 5: Vermelho (Red) - 8 níveis.
- Bits 4, 3, 2: Verde (Green) - 8 níveis.
- Bits 1, 0: Azul (Blue) - 4 níveis.

### Tabela de Cores CGA para 3-3-2 (RGB)

Aqui está a tradução dos nibbles (0-15) para os valores hexadecimais que você vai jogar no buffer:

Índice (Nibble) | Cor CGA | Nome Original | Valor Hex (3-3-2) | Binário (RRRGGGBB)
0 | Black | Preto | 0x00 | 0b00000000
1 | Blue | Azul | 0x03 | 0b00000011
2 | Green | Verde | 0x1C | 0b00011100
3 | Cyan | Ciano | 0x1F | 0b00011111
4 | Red | Vermelho | 0xE0 | 0b11100000
5 | Magenta | Magenta | 0xE3 | 0b11100011
6 | Brown | Marrom (Laranja Escuro) | 0x90 | 0b10010000
7 | Light Gray | Cinza Claro | 0xB6 | 0b10110110
8 | Dark Gray | Cinza Escuro | 0x49 | 0b01001001
9 | Light Blue | Azul Brilhante | 0x57 | 0b01010111
10 | Light Green | Verde Brilhante | 0x3D | 0b00111101
11 | Light Cyan | Ciano Brilhante | 0x3F | 0b00111111
12 | Light Red | Vermelho Brilhante | 0xF0 | 0b11110000
13 | Light Magenta | Magenta Brilhante | 0xF3 | 0b11110011
14 | Yellow | Amarelo | 0xFC | 0b11111100
15 | White | Branco Puro | 0xFF | 0b11111111

### Dica de Implementação no Pico 2

Se você estiver renderizando os pixels e quiser aplicar a cor, você pode criar uma "Lookup Table" (LUT) rápida no código do Pico:

C

// Paleta CGA convertida para 332

const uint8_t palette_cga_332[16] = {

0x00, 0x03, 0x1C, 0x1F, 0xE0, 0xE3, 0x90, 0xB6,

0x49, 0x57, 0x3D, 0x3F, 0xF0, 0xF3, 0xFC, 0xFF

};

// Exemplo de como pintar um pixel usando o índice (0-15)

void draw_pixel_cga(int x, int y, uint8_t color_index) {

uint8_t color_332 = palette_cga_332[color_index & 0x0F];

put_pixel_332(x, y, color_332);

}

### O que essa tabela faz pelo seu projeto?

- O Amarelo (0xFC) vai brilhar exatamente como na BIOS de um PC antigo.
- O Ciano (0x1F) é aquele azul esverdeado clássico que você usou no copyright da foto.
- O Marrom (0x90) é o ajuste mais chato de fazer no 3-3-2, mas esse valor dá um tom bem próximo do real.

Com isso, o seu VGA BIOS VRP2350 vai ficar idêntico ao padrão industrial.

Quer que eu te ajude a criar a função de "Scroll de Bloco" agora, já usando essa lógica de bytes/pixels para o Pico 2 limpar a tela bem rápido? Seria o "checkmate" dessa placa de vídeo!
