ppsilv/Orion68/peripheral/pico2VGA/docs/dissecando_vga_rgb_pio.odt

POR favor me explique com detalhes esse codigo abaixo, ele está funcionando, mas eu vi uma nota no codigo que eu não entendi, no codigo diz que está

define TXCOUNT 153600 // Total pixels/2 (since we have 2 pixels per byte)

char vga_video_data_array0[TXCOUNT];

char vga_video_data_array1[TXCOUNT];

char *active_buffer = (char *)&vga_video_data_array0[0];

essa nota: Total pixels/2 (since we have 2 pixels per byte)

eu não entendi, segue o codigo para sua analise:

.program rgb

; define the pixel hold times which depend on clock freq

; pixel1hold should be 5 for 150 MHz (4 for 125 MHz)

; pixel2hold should be 3 for 150 MHz (2 for 125 MHz)

.define pixel1hold 5

.define pixel2hold 3

.define PUBLIC vid_freq 250

pull block ; Pull from FIFO to OSR (only once)

mov y, osr ; Copy value from OSR to y scratch register

.wrap_target

set pins, 0 ; Zero RGB pins in blanking

mov x, y ; Initialize counter variable

wait 1 irq 1 [3] ; Wait for vsync active mode (starts 5 cycles after execution)

colorout:

pull block ; Pull color value

out pins, 4 [pixel1hold] ; Push out to pins (first pixel)

out pins, 4 [pixel2hold] ; Push out to pins (next pixel)

jmp x-- colorout ; Stay here thru horizontal active mode

.wrap

O que está acontecendo aqui é uma técnica clássica de otimização de memória em sistemas embarcados. Para entender a nota "2 pixels per byte", precisamos olhar para como o hardware do PIO e o seu array de dados conversam.

### 1. A Anatomia do Byte (O "Pulo do Gato")

A nota faz todo o sentido quando olhamos para a instrução out pins, 4 no seu código PIO.

- 1 Byte possui 8 bits.
- Sua instrução out pins, 4 retira apenas 4 bits do OSR (Output Shift Register) e joga para os pinos a cada vez.
- Como $4 + 4 = 8$, você consegue "empacotar" as informações de cor de dois pixels dentro de um único char (que é 1 byte) no seu array de C.

### 2. Análise Detalhada do Fluxo de Dados

Vamos seguir o caminho que o dado percorre desde o seu array até o monitor:

1. No C: Você define char vga_video_data_array0. Cada posição desse array guarda 8 bits.
2. No DMA: O DMA pega esse byte e envia para a FIFO do PIO.
3. No PIO (pull block): O PIO puxa esse dado para o registrador OSR.
4. Primeiro Pixel (out pins, 4): O PIO pega os 4 bits "da direita" e manda para os pinos RGB. Ele segura esse valor pelo tempo pixel1hold.
5. Segundo Pixel (out pins, 4): O PIO pega os 4 bits restantes "da esquerda" do mesmo dado e manda para os pinos. Ele segura pelo tempo pixel2hold.

### 3. Por que isso é bom?

Se você usasse um byte inteiro para cada pixel (mesmo precisando de apenas 4 bits de cor), você precisaria do dobro de memória RAM:

- Com 2 pixels por byte: 153.600 bytes de RAM.
- Com 1 pixel por byte: 307.200 bytes de RAM.

Como o Raspberry Pi Pico tem 264KB de RAM, a segunda opção provavelmente faria seu código travar ou nem compilar por falta de memória, já que você tem dois buffers (array0 e array1).

### 4. Explicação do Código PIO (Passo a Passo)

pull block ; Ocorre apenas no início para configurar o tamanho da linha

mov y, osr ; Salva o número de pixels (contagem) no registrador Y

.wrap_target

set pins, 0 ; Garante que não saia cor durante o blanking (preto)

mov x, y ; Reseta o contador X para o valor da linha cheia

wait 1 irq 1 [3] ; Sincronia: espera o sinal do código C/Vsync para começar a desenhar

colorout:

pull block ; Puxa 32 bits (4 bytes) da FIFO para o OSR

out pins, 4 [pixel1hold] ; Envia os primeiros 4 bits (Pixel A)

out pins, 4 [pixel2hold] ; Envia os próximos 4 bits (Pixel B do mesmo byte!)

jmp x-- colorout ; Repete até desenhar a linha toda

.wrap

### O que isso significa para você no código C?

Quando você for "desenhar" no seu vga_video_data_array0, você não pode simplesmente dar um valor de 0 a 255 para um pixel. Você precisa combinar dois pixels em um:

C

// Exemplo: Pixel 1 tem cor 0x01 e Pixel 2 tem cor 0x02

vga_video_data_array0[0] = (0x02 << 4) | 0x01;

Ficou claro como o bit-shifting funciona para economizar sua RAM? Se quiser, posso te ajudar a criar uma função em C para "pintar" um pixel individualmente nesse formato compactado.

Poxa agora eu entendi, isso significa que a frequência do horizontal também levou isso em consideração?

Sim, você matou a charada! A frequência horizontal (H-Sync) e o "Pixel Clock" estão intimamente ligados a essa lógica de 2 pixels por byte.

Quando você compacta 2 pixels em um único byte no lado do processador (C), o seu State Machine (SM) do PIO precisa trabalhar o dobro da velocidade ou processar os dados de forma que o monitor VGA receba o sinal no tempo correto (os famosos 25,175 MHz para a resolução padrão 640x480 @ 60Hz).

Aqui estão os três pontos onde essa compactação afeta o tempo:

### 1. O Clock do PIO vs. Pixel Clock

No seu código, você definiu .define PUBLIC vid_freq 250. Isso significa que o PIO está rodando a 250 MHz.

Para gerar um sinal VGA padrão, cada pixel deve durar cerca de 39,7 nanossegundos.

Como o PIO é extremamente rápido (250 MHz), ele usa os "Delay Cycles" (aqueles números entre colchetes [pixel1hold]) para "segurar" o sinal de cada pixel pelo tempo exato, garantindo que o monitor consiga ler a cor antes que ela mude.

### 2. A "Marcha" do código PIO

Observe o fluxo de tempo no seu loop colorout:

- out pins, 4 [pixel1hold]: O PIO gasta 1 ciclo para executar + pixel1hold ciclos esperando.
- out pins, 4 [pixel2hold]: O PIO gasta mais 1 ciclo + pixel2hold ciclos esperando.

Se o seu código C enviasse 1 byte por pixel, o loop do PIO teria que fazer um pull block a cada pixel. Fazendo 2 pixels por pull, você reduz o tráfego no barramento de dados e dá fôlego para o PIO manter a frequência horizontal estável sem "engasgar".

### 3. A Frequência Horizontal (H-Sync)

A frequência horizontal é o tempo que o "canhão de elétrons" (ou o controlador do LCD) leva para desenhar uma linha inteira e voltar para o início da próxima.

- Se você tem 640 pixels visíveis;
- O PIO processa isso como 320 iterações do loop colorout (porque cada iteração desenha 2 pixels).
- O tempo total dessas 320 iterações, somado ao tempo de Front Porch, Sync Pulse e Back Porch, tem que ser exatamente 31,46 kHz (para 640x480).

### Como conferir se o tempo está certo?

A conta que o autor do código fez foi:

$$(1 + pixel1hold) + (1 + pixel2hold) = \text{Total de ciclos por byte (2 pixels)}$$

Com os valores que você tem:

$$(1 + 5) + (1 + 3) = 10 \text{ ciclos do PIO para cada 2 pixels.}$$

Se o PIO está a 250 MHz, 10 ciclos levam 40 nanosegundos. Como são 2 pixels, cada um dura 20 ns.

Nota de peer: 20 ns por pixel daria uma resolução horizontal bem maior que a 640x480 padrão (que pede ~40 ns por pixel). Isso sugere que seu monitor está rodando em uma resolução customizada ou em uma frequência de atualização (Hz) bem mais alta!

Você quer que eu te ajude a calcular os valores exatos de pixel1hold e pixel2hold para uma resolução específica, como 640x480 ou 800x600?

Porch, tem que ser exatamente 31,46 kHz (para 640x480).

por isso os delays pixel1hold e pixel2hold, senão ele desenharia na metade do tempo, certo?

Exatamente! Você pegou a lógica central da temporização de vídeo. Se você removesse os delays (os números entre colchetes), o PIO cuspiria os dados na velocidade máxima do clock (250 MHz), e o monitor não entenderia absolutamente nada.

Pense nos delays como o freio necessário para manter o "ritmo" da música que o monitor está tentando dançar.

### O que aconteceria sem os Delays?

1. A Imagem Encolheria: Como o PIO terminaria de enviar os 640 pixels muito rápido, a "linha" ocuparia apenas uma fração minúscula da tela no sentido horizontal.
2. Perda de Sincronia: O monitor espera que a linha dure um tempo fixo (cerca de 31,77 microssegundos para 640x480). Se você terminar a linha em 2 microssegundos, o monitor vai achar que o sinal acabou ou está corrompido e exibirá "Sem Sinal" ou uma imagem toda "rasgada" (o famoso ruído de sincronismo).

### Por que dois delays diferentes (pixel1hold e pixel2hold)?

Você notou que um é 5 e o outro é 3? Isso acontece por causa do "custo" das outras instruções no loop. Vamos contar os ciclos de clock do PIO para cada byte (2 pixels):

Instrução | O que faz | Ciclos Gastos | Total de Ciclos nesta linha
pull block | Puxa o byte da FIFO | 1 | 1
out pins, 4 [5] | Manda Pixel 1 + espera | 1 + 5 | 6
out pins, 4 [3] | Manda Pixel 2 + espera | 1 + 3 | 4
jmp x-- colorout | Volta para o início | 1 | 1 (contado no próximo pull)

A conta mágica:

- Pixel 1: Gasta o tempo do pull (1) + o out com delay (6) = 7 ciclos.
- Pixel 2: Gasta o tempo do out com delay (4) + o jmp (1) = 5 ciclos.

Dica de mestre: O autor original provavelmente ajustou esses números (5 e 3) de forma assimétrica para tentar compensar o tempo que o PIO gasta fazendo o pull e o jmp. O objetivo final é que a duração visual do Pixel 1 na tela seja o mais próxima possível da duração do Pixel 2. Se ambos tivessem o mesmo delay, um pixel pareceria ligeiramente mais "largo" que o outro na imagem!

### Os "Porches" (As bordas invisíveis)

O colorout cuida apenas da parte colorida (Active Video). Para a conta fechar nos 31,46 kHz, o seu código em C ou outra State Machine precisa gerar:

1. Front Porch: Um pequeno silêncio antes do pulso de sincronia.
2. Sync Pulse: O sinal que diz ao monitor "volte para o início da linha".
3. Back Porch: Um pequeno silêncio antes de começar a desenhar as cores novamente.

Sem esses tempos mortos, a imagem ficaria deslocada para o lado ou simplesmente não estabilizaria.

Você quer que eu ajude a calcular se esses tempos de delay (5 e 3) estão resultando em pixels perfeitamente quadrados na sua resolução atual?
