ppsilv/Orion68/peripheral/pico2VGA/docs/dtack.odt

Como funciona DTACK no 68000

Essa é uma excelente pergunta de "arqueologia digital"! Você tocou no ponto que tornava o design de placas com o 68000 um pouco mais complexo (e elegante) do que com processadores como o Z80 ou o 6502.

Como as memórias RAM e ROM/EPROM são componentes passivos (elas não "sabem" que terminaram de ler, apenas disponibilizam o dado após um tempo $t_{ACC}$), os projetistas usavam a Lógica de Decodificação de Endereço para "mentir" ou confirmar para o processador que o dado estava pronto.

Aqui estão as três formas principais como isso era resolvido:

### 1. O DTACK "Direto" (0 Wait States)

Se a memória fosse rápida o suficiente para responder dentro do ciclo de clock do 68000, o projetista simplesmente ligava a saída da lógica de seleção (o sinal $\overline{CS}$ ou $\overline{CE}$ da memória) diretamente ao $\overline{DTACK}$ do processador.

- Como funcionava: Assim que o 68000 colocava o endereço no barramento e a lógica de decodificação (geralmente um chip 74LS138) reconhecia que era um acesso à RAM, ela ativava o chip da RAM e, ao mesmo tempo, puxava o $\overline{DTACK}$ para nível baixo.
- Resultado: O 68000 seguia na velocidade máxima, sem esperar nenhum ciclo extra.

### 2. Geradores de Wait States (O "Atrasador")

Quando a memória era mais lenta que o processador (muito comum com as EPROMs antigas), os projetistas usavam um Shift Register (como o 74LS164) ou um contador para atrasar o sinal de $\overline{DTACK}$.

- O truque: 1. O sinal $\overline{AS}$ (Address Strobe) disparava o contador/shift register.
  2. Após 1, 2 ou 3 pulsos de clock do sistema, uma das saídas do contador ia para nível baixo.
  3. Essa saída era conectada ao $\overline{DTACK}$.
- Resultado: O processador entrava em um estado de espera (Wait State) até que o contador desse o "ok", garantindo que a memória lenta tivesse tempo de colocar os dados no barramento.

### 3. Circuitos com Flip-Flops

Muitas vezes, usava-se um flip-flop (como o 74LS74) para sincronizar o sinal de seleção de chip com o clock do sistema. O $\overline{AS}$ "setava" o flip-flop, e o próximo pulso de clock (ou o seguinte) enviava o $\overline{DTACK}$. Isso garantia que o sinal de confirmação fosse perfeitamente síncrono com o coração do processador.

### Por que o 68000 era assim?

Diferente de outros chips, o 68000 foi desenhado para ser assíncrono. Isso significa que, teoricamente, você poderia ter uma memória que demora 10 segundos para responder; o processador simplesmente ficaria parado esperando o $\overline{DTACK}$.

Isso permitia:

- Misturar memórias rápidas e lentas no mesmo sistema.
- Interconectar periféricos de velocidades completamente diferentes (como o seu Pico!).
- Criar sistemas multi-processados onde um processador espera o outro liberar o barramento.

### O Perigo: O "Bus Error" ($\overline{BERR}$)

Se um projetista cometesse um erro e o processador tentasse acessar um endereço onde não havia nada (e, portanto, ninguém responderia o $\overline{DTACK}$), o 68000 ficaria travado para sempre. Por isso, as placas profissionais tinham um circuito de Watchdog que, se o $\overline{DTACK}$ demorasse demais, ativava o pino $\overline{BERR}$ para forçar uma exceção de erro de barramento no software.

Usando um GAL para gerar DTACK

Com uma GAL única "dona" da linha de DTACK (ou seja, nenhum outro componente ou periférico está ligado fisicamente a esse pino no 68000 além da saída da GAL), você não precisa se preocupar com conflitos de barramento (o famoso bus contention).

Nesse caso, você pode usar a saída da GAL no modo Totem-Pole (saída ativa comum), o que simplifica o código e garante transições de sinal bem rápidas e limpas.

### Como fica o seu código final (WinCUPL):

Considerando que a GAL é a única enviando o sinal para a CPU, a lógica que você validou é a definitiva:

Snippet de código

/* Definindo que o pino DTACK é uma saída combinacional comum */

PIN 15 = DTACK;

/* A lógica direta (Active Low) */

!DTACK = (!CS_RAM & !AS)

# (!CS_ACIA & !AS)

# (!CS_PICO & !AS & PICO_READY);

### Por que isso é uma vantagem no seu projeto?

1. Velocidade: Saídas ativas (Totem-Pole) conseguem "puxar" o sinal para 5V muito mais rápido do que um resistor de pull-up faria sozinho. Isso ajuda o 68000 a encerrar o ciclo de barramento o mais rápido possível.
2. Simplicidade de Hardware: Você elimina a necessidade de transistores extras ou portas externas. A GAL recebe os sinais de 5V e o sinal de 3.3V do Pico e resolve tudo internamente.
3. Confiabilidade: Como você centralizou o $\overline{DTACK}$ em um único chip, se o 68000 travar, você sabe exatamente onde olhar: na lógica da GAL ou no sinal de PICO_READY.

### Dica de Layout para a GAL

Como você vai lidar com sinais de alta frequência do 68000 (mesmo que seja de 8MHz ou 10MHz, as bordas de subida são rápidas), tente manter a GAL o mais próxima possível do processador.

Isso evita que a linha de $\overline{DTACK}$ vire uma "antena" e capte ruído, o que poderia causar um "Double DTACK" e confundir o contador de estados interno do 68000.

DTACK com LDS/UDS

Exatamente! Você pode usar o $\overline{LDS}$ ou o $\overline{UDS}$ para gerar o $\overline{DTACK}$ tanto na leitura quanto na escrita sem problemas. Na verdade, em muitos designs de computadores baseados no 68000, isso é considerado uma boa prática.

Aqui está o porquê de usar os Data Strobes ser uma escolha inteligente para o seu projeto:

### 1. Garantia de Sincronismo

Como discutimos, o $\overline{AS}$ indica que o endereço é válido, mas os Data Strobes ($\overline{LDS}/\overline{UDS}$) indicam que o barramento de dados está pronto para a ação.

- Na Escrita: Usar os strobes garante que o Pico só responda o $\overline{DTACK}$ após o 68000 ter colocado os dados no barramento.
- Na Leitura: Garante que o 68000 está realmente "aberto" para receber o que o periférico tem a dizer.

### 2. Compatibilidade com Byte e Word

O 68000 pode ler ou escrever um Word (16 bits) ou apenas um Byte (8 bits).

- Se ele acessa um byte no endereço par, ele desce o $\overline{UDS}$.
- Se ele acessa um byte no endereço ímpar, ele desce o $\overline{LDS}$.
- Se ele acessa um word, desce ambos.

Se você usar apenas o $\overline{AS}$ na sua GAL, o $\overline{DTACK}$ será gerado mesmo que o 68000 esteja tentando falar com "o outro byte" (o que ele não quer no momento). Usando os strobes na lógica da GAL, você garante que o $\overline{DTACK}$ só ocorra quando o byte correto estiver sendo acessado.

### A Lógica "Universal" para a sua GAL

Se você quer que a GAL responda para qualquer acesso ao Pico (seja byte alto, baixo ou word), a equação ideal seria:

!DTACK = !CS_PICO & (!UDS # !LDS) & PICO_READY;

(Assumindo que sua decodificação CS_PICO já leva o AS em conta, o que é comum).

### Um detalhe importante sobre o 68000 (Leitura vs Escrita)

Embora você possa usar os strobes para ambos, há uma pequena diferença técnica no comportamento do processador que você deve conhecer:

- Na Leitura: O $\overline{AS}$ e os Strobes descem quase juntos. Não há "atraso" útil aqui.
- Na Escrita: Existe aquele atraso de segurança (mencionado antes) onde o $\overline{AS}$ desce primeiro e os Strobes descem depois, quando o dado já está "limpo" no barramento.

Por que isso é bom para você?

Como o seu Pico vai atuar como um periférico de escrita, usar o $\overline{LDS}/\overline{UDS}$ na GAL dá ao seu código no Pico alguns nanossegundos preciosos a mais para detectar que o ciclo começou antes de ter que "assinar" o recebimento com o $\overline{DTACK}$.

### Resumo da ópera

Sim, usar $\overline{LDS}$ ou $\overline{UDS}$ para gerar o $\overline{DTACK}$ é mais seguro e mais robusto do que usar apenas o $\overline{AS}$. Você evita que o 68000 encerre o ciclo antes que os dados tenham tido tempo de se estabilizar eletricamente nos pinos do Pico (através do seu buffer 74HC245).
