ppsilv/Orion68/software/src/kernel/Docs/open-fopen-buffering-shell.odt

# open() vs fopen() e a cadeia de I/O no Linux

Notas de estudo — referência para o projeto Orion68

## 1. Diferença entre open() e fopen()

open() é uma syscall POSIX/Linux: chama o kernel diretamente e retorna um file descriptor (inteiro). fopen() é uma função da biblioteca padrão C, que internamente usa open(), mas retorna um FILE* com buffering e outras funcionalidades por cima.

Aspecto | open() | fopen()
Nível | Baixo nível (syscall) | Alto nível (biblioteca C)
Retorno | int (file descriptor) | FILE*
Buffering | Nenhum (I/O direto) | Sim (buffered I/O)
Header | <fcntl.h> | <stdio.h>
Portabilidade | Específico de POSIX/Unix | Padrão ANSI C, portável
Funções associadas | read(), write(), close(), lseek(), ioctl() | fread(), fwrite(), fclose(), fseek(), fprintf()
Modo de abertura | Flags (O_RDONLY, O_CREAT, …) | Strings ("r", "w", "a", …)
Erros | Retorna -1, usa errno | Retorna NULL, usa errno

Buffering é a diferença mais relevante na prática: fopen() acumula dados em um buffer interno e só faz a syscall real quando o buffer enche, quando há fflush(), ou no fclose(). Isso reduz o número de syscalls.

Uso típico: fopen() para a maioria dos casos (texto, logs, parsing); open() quando é preciso controle fino (O_DIRECT, O_NONBLOCK, select()/poll()/epoll(), pipes, sockets, dispositivos). É possível converter um fd de open() em FILE* com fdopen().

## 2. Como funciona o buffer do fopen()

Ao abrir um arquivo, a libc aloca um buffer interno (tipicamente BUFSIZ, 4096 ou 8192 bytes) associado à struct FILE, evitando uma syscall a cada operação pequena.

### Os três modos de buffering

int setvbuf(FILE *stream, char *buf, int mode, size_t size);

Modo | Constante | Comportamento
Totalmente bufferizado | _IOFBF | Só escreve/lê quando o buffer enche
Linha a linha | _IOLBF | Escreve ao encontrar \n
Sem buffer | _IONBF | Cada operação é uma syscall imediata

Regra padrão da glibc: arquivo regular → _IOFBF; terminal (tty) → _IOLBF; stderr → _IONBF.

### Fluxo de escrita

1. Dados vão para o buffer em memória (sem syscall ainda).
2. Buffer acumula até encher, encontrar \n (line-buffered), ou fflush().
3. Quando estoura, a libc faz um write() real com o conteúdo inteiro.
4. fclose() força um flush antes de liberar a estrutura.

### Fluxo de leitura

1. Na primeira leitura, a libc faz um read() do tamanho do buffer.
2. Leituras seguintes (fgetc(), etc.) vêm do buffer, sem syscall.
3. Quando o buffer esvazia, novo read() reabastece.

### Funções de controle

setbuf(fp, buffer);

setvbuf(fp, buffer, mode, size); // deve ser chamado antes de qualquer I/O no stream

fflush(fp);

### Exemplo do efeito prático

FILE *f = fopen("log.txt", "w");

fprintf(f, "linha 1\n");

sleep(10); // nada foi escrito no disco ainda

fprintf(f, "linha 2\n");

fclose(f); // só agora os dados vão pro disco (ou antes, se o buffer encher)

Se o programa crashar durante o sleep, os dados só no buffer são perdidos — por isso, em código crítico, usa-se fflush() explícito ou setvbuf(f, NULL, _IONBF, 0).

## 3. Como a libc decide o buffering de stdin/stdout/stderr

stdin, stdout e stderr são variáveis FILE* criadas e inicializadas pela própria libc (na fase de inicialização do runtime C, antes do main()), associadas manualmente aos fds 0, 1 e 2 — que por sua vez são uma convenção do kernel/shell.

Simplificação de como a glibc decide o modo de cada um na inicialização:

// stdin e stdout: decisão dinâmica

if (isatty(fd))

mode = _IOLBF; // terminal → linha a linha

else

mode = _IOFBF; // arquivo/pipe → totalmente bufferizado

// stderr: fixo no código-fonte, sem checar isatty

stderr->_flags |= _IONBF; // sempre sem buffer

- stdin/stdout: decisão dinâmica via isatty(fd) — muda conforme o programa roda no terminal ou é redirecionado.
- stderr: hardcoded para _IONBF sempre, independente do destino — garante que mensagens de erro apareçam imediatamente, mesmo que o programa trave logo depois.

## 4. Quem faz o redirecionamento (>, |)

Redirecionamento não é feito pela libc — é feito pelo shell, antes mesmo do programa começar a rodar.

Exemplo com programa > saida.txt, o shell faz, antes do exec:

1. fork() — cria processo filho.
2. No filho: open("saida.txt", O_WRONLY|O_CREAT|O_TRUNC) → retorna, por exemplo, fd 3.
3. dup2(3, 1) — faz o fd 1 (stdout) apontar para o mesmo arquivo do fd 3.
4. close(3) — fecha o fd temporário.
5. execve("programa", ...) — só então o programa começa.

Quando o main() roda, o fd 1 já não é mais o terminal — o programa nem sabe que houve redirecionamento.

Pipes (programa1 | programa2) funcionam de forma parecida: o shell cria um pipe(), faz fork() duas vezes e usa dup2() para ligar o stdout do primeiro processo ao stdin do segundo — tudo antes do exec.

### Onde a libc entra

A libc apenas reage ao estado dos fds já recebidos do kernel/shell, usando isatty() (uma syscall, via ioctl) para perguntar ao kernel que tipo de coisa está por trás de cada descritor.

Quem | Faz o quê
Shell | Interpreta >, <, \|; faz open()/pipe() + dup2() antes do exec
Kernel | Mantém a tabela de file descriptors do processo
libc | Chama isatty() na inicialização e decide o buffering com base nisso

## 5. Quem põe o shell no ar

Cadeia completa, do boot até o prompt de comando:

Kernel → init/systemd → login/getty → shell → seus programas

### Kernel dá vida ao PID 1

Após a inicialização do kernel (montar root filesystem, etc.), ele faz execve("/sbin/init", ...) — o único processo criado “do nada”; todo o resto vem de fork() a partir daí. Hoje isso costuma ser systemd (ou init, openrc, etc.).

### systemd/init sobe os serviços

O PID 1 faz fork() + exec() de todos os serviços: rede, daemons, e gerenciadores de terminal.

### Como o shell é iniciado, por tipo de acesso

Terminal físico/virtual (TTY): - systemd sobe um getty/agetty por terminal virtual. - getty abre /dev/ttyN, mostra login:. - Usuário autentica → getty faz exec() de /bin/login. - login valida a senha e faz exec() do shell definido em /etc/passwd.

SSH: - sshd (subido pelo systemd) recebe a conexão, autentica o usuário. - Faz fork() e no filho dá exec() no shell do usuário.

Terminal gráfico: - O display manager (gdm/sddm sobre Xorg/Wayland) já autenticou o usuário antes. - O app de terminal cria um pseudo-terminal (pty) e faz fork()+exec() do shell dentro dele.

### Padrão que se repete

Em todos os casos: fork() cria uma cópia do processo pai, exec() substitui essa cópia pelo programa novo (o shell). O shell então repete o padrão para cada comando digitado: fork() + redirecionamentos (dup2) + exec().

## Notas para o Orion68

- Numa libc própria, a política de buffering de stdin/stdout/stderr (quais fds existem, o que é bufferizado e como) é uma decisão de design a ser tomada na inicialização do runtime.
- Redirecionamento é responsabilidade do shell/loader, não da libc — a libc só reage ao que já está montado quando o programa começa.
- Para um shell de comando simples num OS 68k, pode fazer sentido dispensar toda a cadeia de getty/login (que existe para suportar multiusuário) e simplesmente rodar o shell direto após a inicialização do sistema.
