ppsilv/Orion68/software/dev/kernel/Docs/syscall_001.odt

Você está certo na divisão de responsabilidade (setup de registrador + trap na libc do usuário, dispatch por tabela no kernel), mas falta uma peça no meio, e tem um buraco de segurança que é bem a cara do seu hábito que a gente já discutiu (lembra do topics/coding-style? "faz funcionar sem checar limites primeiro") — apareceu de novo aqui, e dessa vez é sério porque quem controla trap_num é o programa do usuário.

## A peça que falta: o trap #0 não pode ir direto pro C

Quando a CPU executa trap #0, ela empilha só SR+PC (igual qualquer exceção) e pula pro vetor — ela não sabe nada sobre "chamar uma função C com 4 argumentos". Seu kernel_syscall_dispatcher espera os argumentos na pilha, do jeito que o GCC monta uma chamada C normal. Isso não acontece sozinho; precisa do mesmo tipo de stub em assembly que você já fez pro Int2Handler — só que aqui, em vez de trocar de task, ele monta a chamada pro dispatcher:

.global kernel_trap0_entry

.extern kernel_syscall_dispatcher

kernel_trap0_entry:

movem.l %d0-%d7/%a0-%a6,-(%sp) | salva contexto do usuario; D0 (trap_num) fica em 0(sp)

move.l %d3,-(%sp) | arg2

move.l %d2,-(%sp) | arg1

move.l %d1,-(%sp) | arg0

move.l %d0,-(%sp) | trap_num

jsr kernel_syscall_dispatcher

adda.l #16,%sp | limpa os 4 argumentos empilhados

move.l %d0,0(%sp) | sobrescreve o D0 salvo com o valor de retorno

movem.l (%sp)+,%d0-%d7/%a0-%a6 | restaura contexto -- D0 agora e' o retorno da syscall

rte

O ponto mais fácil de errar aqui é o move.l %d0,0(%sp): sem isso, o movem.l (%sp)+ no final restaura o D0 original (o número da trap), não o valor de retorno — a aplicação acharia que write() "retornou" o próprio número da syscall.

## O buraco de segurança: sem bounds check no trap_num

long kernel_syscall_dispatcher(long trap_num, long arg0, long arg1, long arg2) {

sys_call_t func = sys_call_table[trap_num]; // <- trap_num vem direto do usuario, sem checagem

return func(arg0, arg1, arg2);

}

Qualquer aplicação (de propósito ou por bug) pode botar 999999 em D0 antes do trap #0 — isso lê bem além do fim do sys_call_table, pega um "ponteiro de função" que é lixo de memória, e pula pra lá. Não é hipotético: como não tem MMU, isso é o kernel inteiro travando por causa de uma app comum, não um crash isolado dela. Correção simples:

#define SYS_CALL_COUNT (sizeof(sys_call_table) / sizeof(sys_call_table[0]))

long kernel_syscall_dispatcher(long trap_num, long arg0, long arg1, long arg2) {

if ((unsigned long) trap_num >= SYS_CALL_COUNT)

return -1; /* syscall invalida */

sys_call_t func = sys_call_table[trap_num];

return func(arg0, arg1, arg2);

}

Antes de você testar: o vetor da TRAP #0 (vetor 32, offset 0x80 na tabela) já está apontando pro kernel_trap0_entry, do mesmo jeito que você fez pro Int2Handler (set_ram_vector/entrada direta na _vectors), ou isso ainda falta?
