ppsilv/Orion68/software/src/kernel/Docs/Multitask.odt

Analisando os dois códigos, você está certo na ideia geral (SP no topo do slot de 256K), mas tem uma peça faltando que é crítica: não basta só definir o SP — você precisa pré-construir um "frame falso" na pilha da task, no mesmo formato que seu OS_TickISR cria quando salva contexto. Sem isso, OS_StartHighRdy vai fazer movem.l (%A7)+ e rte em cima de lixo.

## Por que o call_with_a5 atual não serve pra multitarefa real

Hoje, load_pic_elf_standalone chama call_with_a5() de forma síncrona — é um jsr normal, o loader "empresta" a própria pilha dele pro programa carregado rodar, e só retorna quando o programa termina. Isso funciona bem pra rodar um programa "de forma bloqueante", mas não é multitarefa — o scheduler não pode trocar de contexto pra outra task no meio disso, porque essa execução não existe como TCB nenhum, é só uma chamada de função aninhada dentro da task do loader/shell.

Pra virar multitarefa de verdade, o programa carregado precisa virar sua própria task (seu próprio TCB, seu próprio SP, entra na fila do OS_Schedule), e ser iniciado via rte pelo OS_StartHighRdy, não via jsr.

## O que precisa ser montado na pilha da task nova

Olhando seu ctx_switch.s, o formato que OS_StartHighRdy espera, do endereço mais baixo (SP) pro mais alto, é:

tcb->sp → [D0][D1][D2][D3][D4][D5][D6][D7][A0][A1][A2][A3][A4][A5][A6] (60 bytes)

[SR (2 bytes)][PC (4 bytes)] (6 bytes)

Isso é o que movem.l (%A7)+ e rte consomem. Depois disso, o SP fica apontando pra logo acima do PC — e é exatamente aí que entry() vai procurar seus argumentos, porque a ABI do m68k passa argc/argv empilhados (não em registrador). Então, logo acima do bloco de contexto, você precisa deixar:

[endereço de retorno falso (4 bytes)]

[argc (4 bytes)]

[argv (4 bytes, ponteiro)]

## Boa notícia: A5 (GOT) já fica coberto de graça

Repare que seu ctx_switch.s salva/restaura A0-A6 — e A5 está nesse intervalo. Isso significa que, uma vez que você grave o valor certo de a5_value (task_base + got_addr_saved) no slot de A5 dentro do frame inicial, toda troca de contexto futura já preserva A5 automaticamente, sem precisar de nenhum truque extra tipo o register ... __asm__("a5") que o call_with_a5 usa. Isso resolve elegante o problema do PIC em multitarefa.

## Cuidado que falta no seu plano original

argv é um ponteiro — e hoje ele provavelmente aponta pra pilha do processo que chamou loader_pic (o shell). Se a task nova roda de forma independente/escalonada, essa memória pode não existir mais (ou mudar) quando a task nova de fato executar. Você vai precisar copiar os argumentos (strings + array de ponteiros) pra dentro do próprio slot de 256K da task nova, não só passar o ponteiro original.

## Esqueleto de como ficaria

uint32_t stack_top = task_base + SLOT_SIZE; // 256K, topo, cresce pra baixo

// 1. copia argv/strings pro final do slot (abaixo do topo, reservando espaço)

// monta um argv_copy[] apontando pra essas strings já dentro do slot

// 2. monta a área "abaixo" do frame: ret_addr fake, argc, argv_copy

uint32_t *sp = (uint32_t *)(stack_top - área_reservada_pros_argv);

*--sp = (uint32_t)argv_copy;

*--sp = argc;

*--sp = 0; // endereço de retorno falso -- entry() nunca deve dar rts nele

// 3. monta o frame de contexto (SR+PC, depois os 15 registradores)

uint16_t *sr_pc = (uint16_t *)sp - 3; // 6 bytes: SR(2)+PC(4)

sr_pc[0] = 0x2000; // SR inicial (supervisor, sem trace)

*(uint32_t *)&sr_pc[1] = task_base + entry; // PC

uint32_t *regs = (uint32_t *)sr_pc - 15; // D0..D7,A0..A6

memset(regs, 0, 15 * 4);

regs[13] = task_base + got_addr_saved; // slot de A5 (14º da lista D0..D7,A0..A6 => índice 13)

tcb->sp = (uint32_t)regs; // isso é o que OS_StartHighRdy vai usar

(Os índices exatos de A5 dentro do array dependem da ordem exata que seu movem grava — vale conferir com um kprintf de teste antes de confiar cegamente.)

Quer que eu escreva essa função completa (tipo Task_Create_From_Elf) integrada ao seu load_pic_elf_standalone, mantendo call_with_a5 como fallback síncrono pra quando você não quiser multitarefa? Ou prefere primeiro só testar esse frame inicial manualmente com uma task bem simples antes de mexer no loader?

Sem problema, é bastante coisa mesmo — vou escrever com comentários fartos pra te ajudar a estudar enquanto lê, e deixar separado do fluxo síncrono existente (não quebra o que já funciona).Prontinho. Uns pontos pra guiar sua leitura, do mais importante pro menos:

1. A premissa 3 do comentário (ordem que movem.l %D0-%D7/%A0-%A6,-(%A7) empilha) é a parte que mais vale você confirmar antes de confiar — se estiver invertida, o programa vai "acordar" com registradores trocados e vai parecer bug aleatório e intermitente. Um jeito bom de testar: escreva valores conhecidos e diferentes em cada registrador antes de forçar um OS_TickISR, depois inspecione a pilha manualmente (dump de memória) e confira se bate com o que documentei.
2. 0xDEADBEEF como endereço de retorno falso — isso é proposital: se seu programa algum dia der rts sem passar por exit(), ele vai tentar pular pra esse endereço inválido, o que (dependendo do seu handler de exceção) vai gerar um bus error/address error. É melhor travar visivelmente ali do que pular pra lixo silencioso. Se você tiver handler de exceção, pode inclusive tratar esse endereço específico como "task esqueceu de chamar exit()".
3. kmalloc e a struct TCB são só placeholders — troquei pelo que faz sentido dado o ctx_switch.s que você mostrou (sp tem que ser o primeiro campo), mas o resto (fila do scheduler, alocador de TCB) é você quem sabe o formato real.
4. Deixei comentado no final como isso se encaixa no load_pic_elf_standalone — a mudança de fundo é que o loader deixa de ser bloqueante (jsr + espera) e passa a ser "spawna e volta na hora", que é o comportamento certo pra multitarefa.

Estuda com calma, e quando for testar, sugiro começar bem pequeno: uma task que só faz um loop incrementando uma variável, sem I/O nenhum — isolar o problema do frame de contexto de qualquer bug de ELF/GOT.

Fica no kernel, junto com o scheduler — não no shell. Deixa eu justificar, porque a linha de separação aqui é importante pro resto do seu projeto:

## Por que é kernel

Task_CreateFromElf faz duas coisas que só fazem sentido dentro do domínio do kernel:

1. Mexe direto na struct TCB e a insere na fila do OS_Schedule — isso é estado interno do scheduler. Se o shell (user space) pudesse chamar isso diretamente, ele estaria manipulando estruturas internas do kernel sem trap nenhum, o que quebra toda a separação de privilégio que discutimos lá atrás (sem MMU você já abre mão de proteção de memória, mas isso não significa que a arquitetura/organização do código deva ignorar a fronteira).
2. Monta manualmente um frame de exceção (SR + PC no formato que rte espera) — isso é íntimo do funcionamento da CPU em modo supervisor. É a mesma categoria de coisa que sys_open() — lógica que só existe do lado kernel.

## Onde fica o loader_pic (ELF parsing)

Essa é a parte interessante: o parsing do ELF em si (ler header, program headers, relocações, patch de GOT) é uma lógica relativamente neutra — não depende de privilégio de CPU, só faz leitura de arquivo e aritmética de ponteiro. Ela poderia viver nos dois lados, mas eu recomendo fortemente que ela também fique do lado do kernel, por um motivo prático:

O loader_pic de hoje já escreve diretamente na memória do slot ((char *)actual_addr) e mexe na GOT calculando endereços absolutos — isso é escrita direta em memória física de outro "processo" (a task sendo carregada). Sem MMU, tecnicamente o shell até consegue fazer isso (não tem proteção que impeça), mas conceitualmente é o kernel quem deveria ter a responsabilidade de carregar programas na memória — é análogo ao execve() no Linux, que é syscall, não uma função de biblioteca em user space.

## Como fica a divisão, então

┌─────────────── SHELL (user space, projeto 1) ───────────────┐

│ parseia linha de comando │

│ decide args, redirecionamento, pipes │

│ chama algo tipo: spawn("/programa.elf", argv, stdin, stdout) │

└────────────────────────┬──────────────────────────────────────┘

│ syscall (trap)

┌─────────────── KERNEL (projeto 2) ──────────────────────────┐

│ sys_spawn() recebe a chamada │

│ → chama load_pic_elf_standalone() (parsing do ELF) │

│ → chama Task_CreateFromElf() (monta TCB + frame) │

│ → Scheduler_AddReady() │

│ scheduler / ctx_switch.s / OS_TickISR │

└─────────────────────────────────────────────────────────────┘

## O que muda pro loader_pic.elf que você tem hoje

Hoje ele parece ser um programa/comando separado (argv[0] sendo checado, roda como um .elf independente chamado pelo shell) — ou seja, hoje ele já roda como um processo de user space que carrega outro processo. Isso é um modelo válido (é como execve é implementado indiretamente via um helper), mas se você migrar Task_CreateFromElf pro kernel, faz sentido migrar load_pic_elf_standalone inteiro junto, viraria uma função interna do kernel chamada a partir de uma syscall nova (spawn), e o loader_pic.elf como programa autônomo deixaria de existir (ou viraria só um utilitário de debug/teste).

Isso bate com como você está organizando os dois projetos, ou seu plano era manter o loader_pic como programa separado mesmo?

kkkkk é um nome bom mesmo, curto e já carrega o significado certo.

Faz total sentido a decisão, e ela desenha uma arquitetura bem mais limpa daqui pra frente. Pra fechar o raciocínio:

## Como fica a fronteira, na prática

O shell vai continuar tendo a parte "inteligente" da linha de comando — parsing, redirecionamento, pipe, encadeamento — mas na hora de efetivamente rodar um programa, ele vai fazer algo tipo:

// dentro do shell, hoje provavelmente é:

loader_pic(argc, argv); // chama a função direto, no mesmo espaço

// vira:

spawn(path, argv, stdin_fd, stdout_fd, stderr_fd); // "syscall" pro kernel

E o spawn, do lado do kernel, é quem internamente vai:

1. chamar a lógica de parsing de ELF (que hoje é load_pic_elf_standalone)
2. chamar Task_CreateFromElf (o que escrevi antes)
3. inserir a task na fila do scheduler
4. retornar pro shell (rápido, sem esperar o programa terminar — já que agora é assíncrono/escalonado)

## Sobre o trap "de verdade"

Vale lembrar uma coisa que a gente discutiu lá atrás: pra essa fronteira shell↔kernel ser real (não só uma chamada de função direta dentro do mesmo binário/espaço), você vai precisar de uma instrução TRAP no 68k conectada a um vetor de exceção que aponte pro seu dispatcher de "syscalls" no kernel — senão spawn() do lado do shell vira só um jsr disfarçado, sem trocar de modo de CPU nem nada. Isso talvez já exista no seu kernel (você mencionou multitarefa e scheduler rodando), mas vale confirmar se o mecanismo de trap/syscall table já está montado, ou se essa é mais uma peça que falta antes do spawn fazer sentido de ponta a ponta.

Isso já existe no seu kernel hoje, ou é outro item pra lista?

## Sobre organizar as traps de forma profissional

Ter uma trap por categoria de driver (1=console, 2=vídeo, 4=RTC, 12=fatfs) é o modelo que sistemas antigos tipo TOS/GEMDOS (Atari ST) usavam — funciona, mas escala mal: cada novo tipo de recurso (rede, USB, etc) exige registrar mais um vetor de exceção novo, e no futuro você tem 20 traps espalhadas sem relação lógica entre si.

O jeito Linux/Unix faz diferente: 1 única trap, N syscalls.

TRAP #0 → vetor único de "syscall gate"

O número da operação (open, read, write, spawn, etc) vai num registrador, não no número da trap. A libc, antes de disparar o trap, coloca:

- D0 = número da syscall (ex: SYS_OPEN = 5)
- D1, D2, D3... = argumentos

E o handler da trap único faz um dispatch baseado em D0:

trap_handler:

; D0 = numero da syscall

cmp.l #SYS_MAX, %D0

bhi invalid_syscall

move.l syscall_table(%pc,%D0.l*4), %A0

jsr (%A0)

rte

void *syscall_table[] = {

[SYS_OPEN] = sys_open,

[SYS_READ] = sys_read,

[SYS_WRITE] = sys_write,

[SYS_CLOSE] = sys_close,

[SYS_SPAWN] = sys_spawn,

[SYS_IOCTL] = sys_ioctl,

[SYS_EXIT] = sys_exit,

// ...

};

## Por que isso é melhor pro seu caso

1. Escala infinitamente sem gastar vetores de exceção novos — adicionar rede, socket, o que for, é só adicionar uma entrada na tabela, não uma trap nova
2. Unifica a abstração de "arquivo" que você já decidiu seguir (VFS) — hoje sua trap 12 (fatfs) e trap 1 (conin/conout) são coisas separadas, mas conceitualmente ambas deveriam passar por sys_open/sys_read/sys_write genéricos, delegando pro driver certo por dentro (é a essência do VFS que você já gosta)
3. Bate com o padrão que todo Unix usa — mais fácil de explicar/documentar, e mais fácil de você mesmo debugar depois (D0=5 sempre significa a mesma coisa, documentado numa tabela só)

## Migração sugerida, sem quebrar tudo de uma vez

Você pode manter as traps 2/4 (video, RTC) como estão por enquanto se forem coisas mais "diretas" (ioctl-like), e migrar 1 e 12 pra dentro da tabela de syscall única, já que são exatamente as que fazem sentido debaixo do guarda-chuva VFS (open/read/write/close unificados pra console e fatfs). Migração incremental, sem parar tudo.

Organograma do sistema

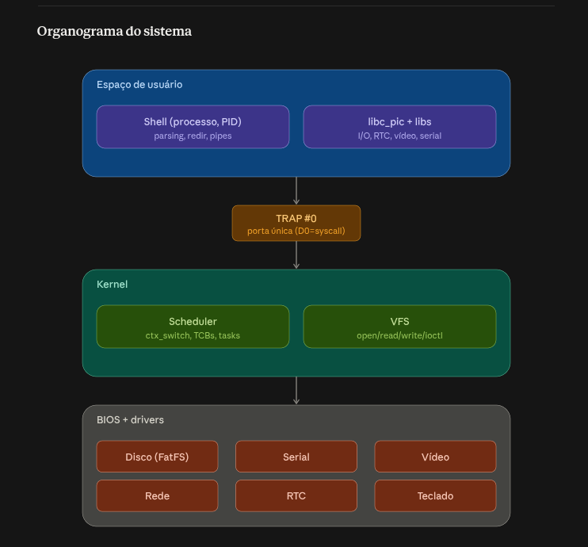
[picture p13: figure]

## Nome pro que vai morar na EEPROM/flash

Faz todo sentido abandonar "BIOS" — carregar bagagem semântica de outro sistema (com convenções bem diferentes das suas) confunde mais do que ajuda. Algumas opções, com o motivo de cada uma:

1. HAL (Hardware Abstraction Layer) — termo já consagrado (Windows NT usa isso), significado imediato pra qualquer programador: "camada que esconde os detalhes do hardware". Neutro, sem bagagem de nenhum SO específico.
2. OrionCore — segue a linha de nome que você já gosta (oriondos, spawn), sugere "o núcleo mais fundamental, o que vem primeiro". Puxa pra ideia de "raiz do sistema", que é fisicamente verdade (é o que roda antes de tudo).
3. Firmware (sem sigla chique, só o nome genérico mesmo) — termo neutro que já significa exatamente "código gravado em ROM/flash que fala direto com hardware", sem trazer nenhuma metáfora de outro SO específico.
4. OrionPROM ou OrionBoot — se a função dele for principalmente inicializar hardware e entregar controle pro kernel (modelo Sun/Unix que mencionei), esse nome já deixa claro que o papel dele é mais estreito: boot + baixo nível, não uma "plataforma" enorme.

Minha sugestão: se o papel dele vai ser "camada fina que sabe falar com UART, RTC, controlador de disco fisicamente, e o kernel chama essas rotinas por cima" (modelo Atari ST que discutimos) — eu iria de HAL. É o termo mais preciso tecnicamente pro que você está descrevendo, e ninguém vai confundir com "BIOS do PC" porque HAL nunca teve essa conotação de "firmware de terceiros genérico".

Se você quiser algo com mais a sua cara/diversão (você claramente gosta de nomes com identidade, tipo spawn), OrionCore eu acho o mais gostoso de falar e escrever no código (corebios.c viraria orioncore.c ou só core.c).

## Sobre PID — o scheduler "já dá" um número único?

Não automaticamente por natureza — mas você está certo que é o lugar natural onde isso deveria acontecer, e quase todo scheduler acaba fazendo isso como efeito colateral de precisar de uma tabela de processos.

Como normalmente funciona: o scheduler mantém uma tabela/array de TCBs (você já tem isso, pelo current_task que vi no seu ctx_switch.s). Quando uma task nova é criada (no seu caso, dentro do futuro sys_spawn), a rotina de criação:

1. Acha um slot livre nessa tabela (ou um índice de array, ou aloca dinamicamente)
2. Esse índice pode virar o PID diretamente (mais simples) — ex: TCB tasks[MAX_TASKS], e pid = índice dentro do array
3. Ou você mantém um contador incremental separado (next_pid++), desacoplado do índice físico na tabela — mais parecido com Unix real, onde PID nunca é reaproveitado imediatamente mesmo que o slot da tabela seja (evita confusão se algo guardou o PID antigo por engano)

Diferença prática entre as duas abordagens:

- PID = índice do array: simples, direto, mas se a task 5 morre e uma task nova nasce, ela também vira PID 5 — pode causar bug sutil se algum código antigo ainda referenciava "PID 5" esperando ser o processo anterior
- PID = contador incremental: nunca reutiliza (até dar overflow do contador, o que leva muito tempo pra acontecer), mais seguro, mas exige uma tabela de tradução PID→slot (ou busca linear)

Pra você, nesse estágio (projeto homebrew, provavelmente poucos processos simultâneos, sem preocupação de segurança entre processos hostis): eu iria de PID = índice do array de TCBs. É a implementação mais simples, resolve exatamente o que você precisa agora, e você sempre pode evoluir pra contador incremental depois se sentir necessidade (é uma mudança pequena e isolada, não afeta o resto da arquitetura).

Isso te dá de graça, sem esforço extra: ps-like (listar processos = percorrer o array), kill <pid> (acessar direto por índice), e cada TCB já pode guardar o próprio PID como campo, preenchido no momento da criação.

Os dois termos existem e significam coisas relacionadas mas distintas — não é erro de digitação nem um substituindo o outro. Vale a pena separar bem, porque no seu contexto (loader que já trata patch de GOT) a diferença importa de verdade.

## PIC — Position Independent Code

É a propriedade do código gerado — o que a flag -fPIC do seu compilador produz. Significa que as instruções não têm endereços absolutos "chumbados": todo acesso a dado global, string, ou função externa passa por uma indireção (a GOT, que você já está patchando). Por isso o mesmo binário pode ser carregado em qualquer endereço de memória sem precisar reescrever instrução nenhuma — só a GOT precisa ser ajustada (que é exatamente o que seu loader_pic.elf faz).

PIC é uma propriedade de um pedaço de código — normalmente usado pra bibliotecas compartilhadas (.so no Linux, .dylib no Mac), porque uma lib pode acabar carregada em endereços diferentes dependendo de quem já usa o espaço de memória.

## PIE — Position Independent Executable

É um executável inteiro construído com código PIC. A diferença não é técnica (o mecanismo de GOT é o mesmo) — é sobre o que o resultado final é usado pra fazer: um PIE é o main do programa, o ET_DYN que o kernel carrega diretamente pra rodar (em vez de um ET_EXEC tradicional com endereço fixo).

Por que PIE existe (motivação histórica): segurança — especificamente ASLR (Address Space Layout Randomization). Se todo executável carrega sempre no mesmo endereço fixo (0x400000 no Linux tradicional), um atacante explorando um buffer overflow sabe exatamente onde as coisas estão na memória. Com PIE, o kernel escolhe um endereço-base aleatório a cada execução — só é possível fazer isso se o próprio executável (não só as libs) for PIC por dentro. É por isso que Linux moderno, por padrão, compila tudo como PIE (até o gcc puro sem flag nenhuma já gera PIE hoje em dia na maioria das distros).

## Resumindo a relação

PIC = a técnica/propriedade do código (GOT, sem endereço fixo)

PIE = um binário EXECUTÁVEL INTEIRO, construído usando a técnica PIC

Todo PIE é PIC. Nem todo PIC é PIE (uma lib .so é PIC, mas não é um "executável" — não tem main que o kernel invoca diretamente).

## Qual termo é "mais usado"? Depende do contexto

- Falando do mecanismo (GOT, relocação, patch de endereço) → PIC é o termo certo, é dele que você está tratando
- Falando do resultado final que roda como programa independente com ASLR → PIE é o termo certo

## No seu caso específico

Seu loader_pic.elf está tecnicamente correto ao se chamar assim — você está carregando código PIC (o mecanismo de GOT que você patcheia). Mas repare: o que você está fazendo — carregar o mesmo binário em endereços diferentes por task (task_base variável por slot) — é exatamente o caso de uso que motivou PIE existir. Seus programas .elf compilados com -fPIC -msep-data, do jeito que você está usando (executável completo carregado em endereço variável), estão comportando-se como PIEs na prática, mesmo que você não tenha usado a flag -pie do linker nem marcado o ELF como ET_DYN (seu header ainda diz ET_EXEC, você mesmo checa isso no loader).

Isso não é errado pro seu propósito — você não precisa da flag -pie/ET_DYN porque é você quem escreveu o loader e decide como carregar, não está dependendo do carregador padrão do kernel Unix entender ET_DYN. Mas linguisticamente, o que você tem hoje é: "um ET_EXEC compilado com código PIC, carregado como se fosse um PIE por um loader customizado seu". Se um dia você quiser ficar 100% fiel à nomenclatura Unix, seria questão de o linker marcar o ELF final como ET_DYN em vez de ET_EXEC — mas isso é só formalidade de nome de campo no header, não muda nada do que seu loader já faz na prática.

Boa, você identificou exatamente o ponto onde as coisas quebram de verdade — e a resposta é: sim, sem cuidado nenhum, isso corrompe dados. Vamos separar o que está em jogo.

## Duas coisas diferentes que parecem a mesma pergunta

1) A task ser trocada pelo timer no meio da leitura — isso, sozinho, não quebra nada (como vimos: ela retoma de onde parou, o hardware continua trabalhando fisicamente enquanto ela está fora da CPU).

2) Uma SEGUNDA task começar sua própria operação de disco enquanto a primeira ainda não terminou a dela — isso sim quebra, e é o cerne real da sua pergunta.

## Por que quebra

Um controlador ATA físico normalmente tem um único conjunto de registradores (registrador de comando, registrador de dados, registrador de status) — não tem "dois canais" pra duas operações simultâneas num mesmo drive. Se:

- Task A programa "leia setor 100", começa a puxar bytes do registrador de dados num loop PIO
- No meio disso, é trocada pra Task B
- Task B, sem saber que Task A está no meio de uma transferência, programa "leia setor 500" no mesmo controlador

Você acabou de sobrescrever o comando em andamento. O disco agora está confuso sobre o que fazer, e os bytes que Task A vai continuar lendo no loop dela vão ser bytes do comando de Task B (ou lixo) — corrompendo os dois.

## A solução: região crítica / lock em volta da operação inteira

O padrão é: enquanto uma task estiver "dona" da operação de disco, nenhuma outra task pode iniciar uma nova operação no mesmo controlador — mesmo que o scheduler troque o contexto dela pra fora da CPU no meio do caminho.

Isso normalmente é feito com um mutex/semáforo protegendo o driver ATA:

diskread(...) {

disk_mutex_lock(); // se outra task já tem o lock, ESTA task bloqueia aqui

// ... programa comando, faz o loop PIO lendo os dados ...

// (pode ser preemptada pelo timer no meio, sem problema --

// o lock continua "segurado" por ela mesmo fora da CPU)

disk_mutex_unlock();

}

Se Task B chamar diskread() enquanto Task A está no meio (mesmo que A esteja "fora da CPU" naquele instante, trocada pelo scheduler), Task B bloqueia em disk_mutex_lock() — o scheduler marca B como esperando, escolhe outra task pronta pra rodar, e só devolve B pra fila quando A soltar o lock no final. Ou seja: o lock é o que garante que a semântica seja "uma operação de disco de cada vez", independente de quantas trocas de contexto aconteçam no meio dela.

## O que isso exige que talvez você ainda não tenha

Um mutex de verdade precisa de: um terceiro estado de task (bloqueada, como discutimos antes) + uma fila de quem está esperando aquele lock + a operação de lock/unlock ser atômica (não pode ser interrompida no meio de "verificar se está livre" e "marcar como ocupado", senão dois pode passar ao mesmo tempo). Isso geralmente se resolve desabilitando interrupções bem rapidinho só durante o teste-e-marcação do lock (poucas instruções), não durante a operação inteira.

## Alternativa mais simples pro seu estágio atual (sem mutex de verdade ainda)

Se seu scheduler ainda não tem fila de bloqueados, uma saída temporária e mais bruta: desabilitar preempção (mascarar a interrupção do timer) durante toda a operação de disco — a task que está lendo do disco vira, por aquele instante, "não interrompível". Isso é mais simples de implementar, mas o custo é: nenhuma outra task roda enquanto o disco está sendo acessado (não é multitarefa de verdade durante I/O, mas é seguro e evita corrupção). É um degrau intermediário legítimo antes de implementar mutex/fila de bloqueados — muitos RTOS pequenos fazem exatamente isso no início.

## Resumindo a resposta pra sua pergunta original

Não, não se resolve sozinho — você precisa explicitamente de exclusão mútua em volta de qualquer recurso compartilhado que tenha estado (o controlador ATA é exatamente isso: tem "memória" de qual comando está em andamento). Sem isso, duas tasks acessando disco "ao mesmo tempo" (intercaladas pelo scheduler) vão corromper uma a operação da outra, mais cedo ou mais tarde.

A ideia central que mudei em relação ao seu esboço: hoje você tem shell → traps individuais → kernel/bios como se fossem 4 caminhos separados. No diagrama, tudo passa por uma única porta (TRAP #0), e é dentro do kernel que a decisão "isso é disco, isso é serial, isso é vídeo" acontece — via tabela de syscall (que despacha pro subsistema certo) e via VFS (que unifica open/read/write pros dispositivos que fazem sentido como "arquivo").

Repare também que separei visualmente kernel de BIOS+drivers — isso reflete uma pergunta que talvez valha você mesmo responder: seu scheduler/VFS chamam as rotinas da BIOS diretamente (função a função, já que estão no mesmo binário/modo), ou existe outra fronteira aí também? Pelo que você descreveu (kernel <----> bios) parece que já são camadas conceitualmente separadas, então deixei como dois blocos armados um em cima do outro, com o kernel conversando com a BIOS por baixo, sem o shell nunca pular essa camada.
