ppsilv/Orion68/software/src/kernel/Docs/mutex.odt

Vamos com calma, construindo peça por peça — a intenção é você entender cada engrenagem, não só copiar código.

## A ideia central, antes do código

Um mutex tem só dois estados relevantes: livre ou travado, e — essa é a parte que resolve o problema que o "disable interrupts" também resolve, mas de forma mais grosseira — quando alguém tenta travar um mutex já travado, essa task specificamente vira "bloqueada" e sai da fila de prontos, sem precisar desligar interrupção nenhuma pro resto do sistema.

## As duas operações, em pseudocódigo primeiro

Lock(mutex):

se mutex está livre:

marca mutex como travado, dono = task atual

senão:

coloca a task atual na fila de espera DESSE mutex

marca a task atual como BLOQUEADA

chama o scheduler pra rodar outra coisa

(quando essa task voltar a rodar, é porque ganhou o mutex)

Unlock(mutex):

se tem alguém esperando na fila desse mutex:

tira o primeiro da fila, marca ele como dono, marca ele como PRONTO

senão:

marca mutex como livre

```Repare em três coisas que espero que desarmem o "medo" dele:

**1. A região crítica (`disable interrupts`) não desaparece — ela só encolhe.** Você continua usando exatamente a técnica que já decidiu usar, só que agora protegendo *poucas instruções* (mexer numa lista encadeada), não a operação de disco inteira. Ou seja, mutex não é "outra coisa" — é a sua solução atual, só que aplicada com um alvo mais preciso.

**2. O pulo do gato que costuma confundir todo mundo:** no `Mutex_Unlock`, quando tem alguém esperando, o mutex **nunca fica realmente "livre"** — ele passa direto de uma dona pra outra, sem um instante intermediário onde uma terceira task poderia furar a fila. É por isso que a lista de espera existe: sem ela, você teria uma janela onde duas tasks poderiam achar "está livre!" ao mesmo tempo.

**3. `OS_Yield()` é a peça que você provavelmente ainda não tem.** Hoje seu `ctx_switch.s` só troca de contexto quando o timer interrompe (`OS_TickISR`). Pra mutex funcionar, uma task precisa poder dizer "cedo a CPU agora, de propósito" — sem esperar o próximo tick. Isso normalmente é implementado com um software trap que só faz `jsr` pra praticamente o mesmo código do `OS_TickISR` (salva contexto, chama `OS_Schedule`, restaura contexto da escolhida) — só que disparado por código, não por timer.

Quer que eu escreva esse `OS_Yield` em assembly, no estilo do seu `ctx_switch.s`, pra fechar a peça que falta?

Boa, vamos rastrear com um exemplo concreto, passo a passo, exatamente como você descreveu antes (duas tasks disputando o disco ATA).

## Cenário: Task A e Task B, as duas chamam diskread()

void diskread(...) {

Mutex_Lock(&disk_mutex);

// ... acessa o hardware ATA ...

Mutex_Unlock(&disk_mutex);

}

O mutex em si é só uma struct compartilhada na memória — igual uma variável global qualquer, só que com uma "etiqueta de dono" e uma fila. Todo processo que quer usar o disco chama as mesmas duas funções (Mutex_Lock/Mutex_Unlock) em cima do mesmo disk_mutex.

## Passo a passo

t=0 — Task A roda primeiro, chama diskread():

- Entra em Mutex_Lock(&disk_mutex)
- disk_mutex.locked está 0 (ninguém usou ainda) → caminho feliz: marca locked=1, owner=TaskA, retorna na hora
- Task A segue executando normalmente o código de acessar o ATA

t=1 — Timer interrompe, scheduler troca pra Task B (isso é só uma troca de contexto normal, o mutex nem sabe que isso aconteceu):

- Task B também chama diskread()
- Entra em Mutex_Lock(&disk_mutex)
- disk_mutex.locked está 1 (Task A ainda está usando) → Task B não consegue pegar
- Task B entra na fila de espera do mutex, vira TASK_BLOCKED
- Task B chama OS_Yield() → dispara o TRAP #15 → contexto de B é salvo, OS_Schedule escolhe outra task pronta (pode ser uma Task C qualquer, ou de volta pra Task A se ela ainda estava pronta)

Repare o pulo do gato aqui: Task B não fica num loop testando se está livre. Ela literalmente "desaparece" da CPU — o scheduler nem considera ela candidata a rodar, porque o estado dela é TASK_BLOCKED, não TASK_READY. Isso é bem diferente de "esperar ocupado" — é esperar de graça, sem gastar CPU nenhuma enquanto espera.

t=2 — eventualmente Task A volta a rodar (trocas de contexto normais continuam acontecendo o tempo todo, isso é transparente pro mutex), termina de usar o disco, chama Mutex_Unlock:

- Mutex_Unlock olha a fila de espera: tem a Task B lá
- Em vez de simplesmente "liberar" o mutex, ele já entrega direto pra Task B: owner = TaskB, marca Task B como TASK_READY, coloca ela de volta na fila de prontos do scheduler
- disk_mutex.locked continua 1 — só trocou de dono

t=3 — em algum momento o scheduler escolhe Task B de novo pra rodar:

- A execução dela retoma exatamente onde parou: dentro de OS_Yield(), logo depois do trap #15, que dá rts
- Isso devolve pra dentro de Mutex_Lock(), que já tinha colocado ela na fila antes de ceder — não tem mais nada pra checar, ela já é a dona (foi o Mutex_Unlock da Task A que decidiu isso)
- Mutex_Lock() retorna, e o código de diskread() da Task B continua, agora com exclusividade garantida sobre o disco

## O que o processo "sente"

Do ponto de vista de quem escreveu diskread(), a experiência é: chamei Mutex_Lock(), e ele só voltou quando era seguro eu continuar. Pode ter voltado na hora (ninguém usando) ou pode ter "demorado" um tempo (ficou esperando escondido, sem a task saber quanto tempo passou nem quantas outras tasks rodaram nesse meio tempo). É transparente — o programador do driver ATA não precisa pensar em scheduler, filas, nem TRAP nenhum. Só precisa lembrar de sempre envolver a seção que mexe no hardware compartilhado entre Lock/Unlock.

## Resumindo a régua mental

- Mutex = crachá de acesso único a um recurso
- Pegar o crachá (Lock) — se está livre, pega na hora; se não, você "sai de cena" até ser sua vez, sem gastar CPU esperando
- Devolver o crachá (Unlock) — se tem fila, passa direto pro próximo da fila; se não tem, fica disponível pro próximo que pedir

É código seu, escrito uma única vez — não é algo que "nasce" dinamicamente nem que cada task cria a sua própria cópia. É literalmente uma variável global dentro do driver ATA, no kernel:

/* dentro do seu driver_ata.c, por exemplo */

static Mutex disk_mutex; /* uma única instância, compartilhada por TODO MUNDO */

void ATA_Init(void) {

Mutex_Init(&disk_mutex); /* chamado UMA VEZ, no boot do kernel,

antes de qualquer task poder rodar */

}

void diskread(...) {

Mutex_Lock(&disk_mutex);

/* ... */

Mutex_Unlock(&disk_mutex);

}

## O ponto chave: é UMA variável, referenciada por TODAS as tasks

Task A e Task B não têm cada uma o seu disk_mutex — as duas chamam diskread(), que por dentro sempre aponta pro mesmo endereço de memória (&disk_mutex, estático, fixo). É exatamente por isso que o mecanismo funciona: se cada task tivesse sua própria cópia do mutex, elas nunca "se veriam", e a exclusão mútua não aconteceria — seria como cada pessoa ter seu próprio cadeado, sem travar porta nenhuma de verdade.

## Onde/quando inicializar

Mutex_Init() precisa rodar antes de qualquer task poder chamar diskread() — normalmente dentro da rotina de boot do seu kernel, junto com a inicialização dos outros drivers (RTC, vídeo, etc), antes do scheduler começar a rodar tasks de verdade:

void kernel_main(void) {

ATA_Init(); /* chama Mutex_Init(&disk_mutex) por dentro */

RTC_Init();

Video_Init();

/* ... */

OS_StartHighRdy(); /* só agora começa a rodar tasks */

}

## Regra geral: um mutex por recurso compartilhado, não por task

Cada recurso físico ou estrutura de dados compartilhada que pode ser acessada por mais de uma task ganha o seu próprio mutex, criado uma vez, vivendo pelo tempo de vida do sistema todo:

- disk_mutex — protege o controlador ATA
- se você tiver uma tabela de fds global compartilhada entre tasks, ela também precisaria do seu próprio mutex (fdtable_mutex, por exemplo)
- console/serial, se mais de uma task puder escrever nele ao mesmo tempo, idem

Não existe "mutex por processo" — existe "mutex por coisa que precisa ser protegida", e processos diferentes competem pelo mesmo mutex quando querem a mesma coisa.

Exatamente isso — você resumiu perfeitamente. O kernel (você, escrevendo o driver) decide onde a exclusão mútua é necessária e cria o mutex correspondente, uma única vez, no boot. Os processos (as tasks que você vai rodar depois) nunca criam mutex nenhum — eles só chamam Lock/Unlock em cima de algo que já existia antes deles.

É a mesma lógica de outras coisas que vimos: o VFS já existe antes de qualquer open() acontecer; a tabela de syscall já existe antes de qualquer TRAP disparar. Mutex segue o mesmo padrão — é infraestrutura do sistema, não algo que o "programa do usuário" instancia.

Se um dia você quiser dar essa capacidade pro programa do usuário também (ex: duas threads dentro do mesmo processo, ou dois processos cooperando por vontade própria, tipo produtor-consumidor), aí sim você exporia algo tipo mutex_create() como uma syscall nova — mas isso é uma necessidade bem mais avançada, o mutex do disco que construímos aqui é 100% interno ao kernel, e você nem precisa se preocupar com isso agora.
