ppsilv/Orion68/software/src/kernel/Docs/Seq_Uso_FD.odt

Vou te dar a sequência genérica estilo Unix/Linux (é o modelo que você está usando de referência), passo a passo, do que acontece entre você escrever fd = open(...) e o valor voltar pronto pra uso.

## Sequência de eventos

1. Compilação/link — antes de rodar O open() que você chamou no seu código C na verdade não existe no seu programa. É um símbolo que o linker resolveu pra apontar pra uma função dentro da libc (glibc, no Linux). Seu binário só tem uma chamada (call/jsr) pro endereço dessa função.

2. Chamada de função normal — ainda em user space Em tempo de execução, seu programa faz um jsr/call comum pra dentro da libc. Isso ainda é código rodando com os mesmos privilégios do seu programa (modo usuário). Nada de kernel envolvido ainda.

3. libc prepara a syscall A função open() da libc pega seus argumentos (path, flags, mode), coloca eles nos registradores que a convenção de chamada de syscall espera (em x86-64 Linux, por exemplo: rax = número da syscall, rdi, rsi, rdx = argumentos), e então executa uma instrução especial de trap (syscall em x86-64, int 0x80 era o modo antigo, TRAP #n no 68k).

4. Trap — troca de modo de CPU Essa instrução causa uma exceção de hardware controlada. A CPU:

- salva o contexto de user space (PC, registradores, stack pointer)
- muda o modo de privilégio de usuário pra supervisor/kernel
- pula pro endereço fixo do syscall handler do kernel (definido antecipadamente numa tabela de vetores/exceções)

Isso é o ponto exato onde "sai" do seu programa e "entra" no oriondos.

5. Kernel: dispatch da syscall O handler de trap lê o número da syscall (que a libc colocou num registrador) e usa isso pra indexar numa tabela de syscalls (array de function pointers dentro do kernel) — algo tipo syscall_table[SYS_open]. Isso chama a implementação real de sys_open() dentro do oriondos.

6. Kernel: VFS entra em ação sys_open() (ou equivalente) é onde mora sua lógica de VFS:

- resolve o path (qual arquivo/dispositivo é esse)
- decide qual driver/backend deve tratar (FatFS/CompactFlash? UART mapeada em memória? outro?)
- aloca uma entrada na tabela de file descriptors da tarefa atual
- monta a estrutura interna (equivalente ao seu struct file) ligando esse fd ao driver certo
- retorna o número do fd (um inteiro pequeno, tipo 3, 4, 5...)

7. Retorno do kernel pro user space O kernel executa uma instrução de retorno de exceção (RTE no 68k), que:

- restaura o modo usuário
- restaura o contexto salvo no passo 4
- retoma a execução logo depois do TRAP, dentro da libc

8. libc devolve o valor A função open() da libc pega o valor retornado pelo kernel (o fd, ou -1 com errno setado em caso de erro) e devolve isso como valor de retorno da função C normal.

9. Seu programa recebe fd agora contém o inteiro. Só isso — é só um número, um índice numa tabela que só o kernel entende de verdade.

## Resumindo em uma linha por camada

seu código → jsr open() [user space, chamada normal]

libc → monta registradores + TRAP [ainda user space]

--- trap: troca de modo de CPU ---

kernel → syscall handler → syscall_table[SYS_open]

kernel/VFS → sys_open(): resolve path, escolhe driver, aloca fd

--- RTE: volta pro modo user ---

libc → retorna o valor pro seu código

seu código → fd = <valor>

Sobre a sua struct File *fd — no Unix real, open() (a syscall crua) retorna um int, não um File*. Quem retorna FILE* é o fopen() da libc, que por baixo chama open() e embrulha o fd num buffer com bufferização própria (stdio). Isso é uma camada inteiramente em user space, sem trap nenhum — só existe pra dar buffering e conveniência (fprintf, fgets, etc) por cima do fd cru.

No seu oriondos, você já tem essa distinção entre "fd cru do kernel" e "FILE* com buffer da libc", ou ainda está tudo misturado numa coisa só?

Não é o conteúdo que vira os dados que trafegam pela serial. O conteúdo do arquivo /dev/serial0 seria só metadado de configuração — baudrate, bits de dado, paridade, stop bits — não o fluxo de dados em si. Tipo:

baudrate=9600stopbits=1

Aí o fluxo seria:

1. open("/dev/serial0", ...) → seu vsopen detecta que é device, lê esse arquivo de config do FatFS uma vez, usa os valores pra programar os registradores da UART (baudrate, etc)
2. Depois disso, o fd retornado não aponta mais pro arquivo no FatFS — aponta pro driver de serial de verdade (que lê/escreve direto nos registradores mapeados em 0xFF4000)
3. read()/write() nesse fd vão direto pro hardware, nunca mais tocam o FatFS

Ou seja: o arquivo no FatFS serve só como "arquivo de configuração com nome de device" — ele é lido no open() pra parametrizar o driver, mas o tráfego de dados real depois disso é 100% via driver, sem I/O em disco no meio (senão cada read() de um byte serial ia gerar acesso a cartão CF, o que seria terrível pra performance/latência).

É basicamente como o Linux faz com stty/termios — só que ao invés de uma ioctl em runtime, no seu caso a config mora persistida como arquivo, e é aplicada no momento do open.

Isso bate com o que você tinha em mente?

### Por que ioctl existe

open, read, write, close cobrem bem o caso genérico de "fluxo de bytes". Mas devices têm operações que não são leitura/escrita de dados — são configuração, controle, status. Não dá pra forçar isso no formato de read/write sem gambiarra.

Exemplos clássicos:

- Serial: mudar baudrate, paridade, stop bits em runtime (o que você simulou via arquivo de config no open — ioctl seria a versão "dinâmica" disso, sem precisar reabrir o fd)
- Terminal/tty: modo raw vs cooked, tamanho da janela (TIOCGWINSZ), echo on/off
- Disco/bloco: pegar tamanho da partição, forçar flush do cache, ejetar mídia
- Rede (socket): configurar modo non-blocking, pegar MTU da interface
- Framebuffer/vídeo: mudar resolução, consultar formato de pixel

### Como funciona

c

int ioctl(int fd, unsigned long request, ...);

É basicamente uma porta genérica de "comando arbitrário" pro driver. O request é um número mágico que cada driver define e interpreta do seu jeito — o kernel só repassa pro driver certo (via o mesmo dispatch de file_operations que vimos antes, só que agora chamando ->ioctl() em vez de ->read()).

No seu struct file_operations estilo Linux, ficaria:

c

struct file_operations {

ssize_t (*read)(...);

ssize_t (*write)(...);

int (*ioctl)(struct file *f, unsigned long cmd, void *arg);

// ...

};

E cada driver seu implementa os cmds que fazem sentido pra ele — a serial entende SET_BAUDRATE, o driver de CF entende GET_SIZE, etc. É essencialmente um escape hatch pra tudo que não se encaixa na abstração simples de bytes.

### Relação com o que você fez

Você já resolveu o caso da serial de um jeito elegante (config lida do arquivo no open). Mas isso só funciona pra config estática, decidida na abertura. Se um dia você quiser, por exemplo, mudar o baudrate enquanto o fd já está aberto (sem fechar e reabrir), aí sim ioctl vira necessário — é o mecanismo pra "falar com o driver" fora do fluxo normal de dados.

fd (file descriptor) é um número inteiro — um índice numa tabela que o kernel mantém por processo. É a coisa mais "crua" possível: não tem buffer, não tem posição de leitura em cache, não tem noção de texto/binário. Só um handle que o kernel entende.

stream (FILE*) é uma struct da libc, em user space, que embrulha um fd e adiciona conveniências por cima:

| fd | stream (FILE*)
O que é | int | struct FILE * (ponteiro)
Onde vive a lógica | kernel | libc (user space)
Buffer | não tem — cada read()/write() é uma syscall de verdade | tem buffer interno — várias fputc() só uma syscall no fim
Funções que usam | open, read, write, close, dup2 | fopen, fread, fwrite, fprintf, fgets, fclose
Erro/EOF | você lê via errno, na hora | guardado como flag persistente na struct (ferror/feof)
Formatação | nenhuma — só bytes crus | tem, ex: fprintf faz parsing de %d, %s etc

## Relação entre os dois

Um FILE* contém um fd internamente. Mais ou menos assim (simplificado):

struct FILE {

int fd; // o fd cru por baixo

unsigned char *buf; // buffer interno

size_t buf_pos;

size_t buf_len;

int flags; // _IOERR, _IOEOF, etc (o que vimos com ferror)

};

Quando você faz:

FILE *f = fopen("arquivo.txt", "r");

Por baixo, a libc faz:

int raw_fd = open("arquivo.txt", O_RDONLY); // syscall de verdade

FILE *f = malloc(sizeof(struct FILE));

f->fd = raw_fd;

f->buf = malloc(BUFSIZ);

// ...

## Por que o buffer importa (a razão de existir o stream)

Sem buffer, fgetc() chamado 1000 vezes seria 1000 syscalls (lento — trap pro kernel é caro). Com buffer, a libc faz 1 syscall que lê um bloco grande (ex: 4KB) pra dentro do buffer, e as próximas 999 chamadas de fgetc() só leem da memória local, sem trap nenhum. Só quando o buffer esgota é que rola outra syscall.

## Você pode ter os dois ao mesmo tempo

Dá pra pegar o fd cru de dentro de um FILE* com fileno(f), e usar direto com read()/write() — mas aí você tem que tomar cuidado pra não misturar acesso bufferizado com acesso cru no mesmo fd (dessincroniza).

## No seu oriondos

Se seu open() hoje retorna um int cru (fd), e você quiser FILE* com buffer depois, é exatamente essa camada extra que você vai adicionar — sem precisar mexer no kernel, só na sua libc.

Ótima pegadinha, e faz total sentido você ter estranhado. O problema é que "open/read/write/close" tem duas metades, e eu as misturei na tabela sem deixar claro. Vamos separar:

## As duas metades de open()

open() = [metade 1: wrapper na libc] + [metade 2: syscall real no kernel]

Metade 1 — a função open() que você chama: Isso é código da libc, sim, 100%. É uma função C normal, compilada, rodando em user space, que só faz: pegar seus argumentos, colocar nos registradores certos, disparar TRAP/syscall. Ela é "fina" (poucas linhas), mas existe e mora na libc.

Metade 2 — o que acontece depois do trap: Isso é o sys_open() dentro do kernel — a lógica de verdade (VFS, resolver path, alocar entrada na tabela de fds, etc). Essa parte não é libc, é kernel puro.

## Onde eu confundi você

Quando eu disse "open/read/write/close/dup2 são funções que fd usa, e fd é do kernel" — eu estava me referindo à metade 2 (a lógica real de manipular a tabela de fds). Mas o nome da função que você chama no seu código C é da libc (metade 1). São duas coisas com o mesmo nome, em lados opostos do trap.

## Tabela corrigida, sendo explícito

Camada | O que tem lá
Seu código | chama open(...)
libc (user space) | função open() — monta registradores, dispara TRAP
— trap: troca de modo —
kernel | sys_open() — VFS, resolve path, mexe na tabela de fds, devolve o número

## E o "kernel não tem libc" — isso é outra afirmação, sem relação direta

Essa frase queria dizer: o kernel não linka com glibc pra suas próprias necessidades internas (tipo, quando o código do kernel precisa de memcpy internamente, ele usa a implementação própria dele, não chama a glibc). Isso é sobre o kernel não depender de uma libc externa pra funcionar.

Isso é diferente de dizer que o kernel não fornece a syscall que a função open() da libc acaba chamando. O kernel implementa sys_open() (o handler da syscall) — só que essa implementação é escrita com as próprias ferramentas internas do kernel, não usando glibc.

## Resumindo o mistério

- open() (a função que você chama) → é da libc, roda em user space
- sys_open() (o que resolve de verdade, mexe na tabela de fd) → é do kernel
- "kernel não tem libc" → é sobre o kernel não depender da glibc pra suas próprias rotinas internas, não sobre quem fornece a syscall

Os dois open's têm o mesmo nome por convenção (fica transparente pro programador), mas são binários completamente separados, em espaços de memória e privilégio diferentes, conectados só pelo mecanismo de trap.

Você tem MMU/paginação no oriondos? Se não tiver, eu sinceramente sugeriria pular fork() clássico e implementar algo mais parecido com spawn() direto — resolve 90% do que você precisa (rodar programas, redirecionar fds, pipes) com uma fração da complexidade, e evita a dor de cópia de memória inteira sem COW.

Rapidamente sobre isso: não tenho registro de ter feito um scheduler pra você em conversas anteriores — pode ter sido em outra sessão que não ficou salva aqui, então se quiser retomar aquilo, me dá um resumo do que já tinha ficado combinado.

Sobre inode no OrionDOS:

## Primeiro, o que você realmente precisa decidir

Inode "de verdade" (estilo Unix) é uma estrutura que separa nome (no diretório) de metadado+dados (o inode em si), permitindo hard links, múltiplos nomes pro mesmo arquivo, etc. Isso é poder que FatFS não tem nativamente — FAT já mistura nome e metadado na entrada de diretório. Então a pergunta chave é: você quer inode de verdade (com toda a semântica Unix) ou só quer usar o nome "inode" pra uma struct de metadado em memória, sem virar Unix completo?

Pela conversa até aqui (você gostou da ideia de /dev/serial0 ter sentido, curiosidade genuína de fazer "certinho"), acho que seu objetivo real é a segunda opção: ter uma abstração de metadado desacoplada do FatFS puro, não necessariamente hard links e todo o resto.

## Caminho recomendado — Inode simplificado em memória (cache), não persistido como estrutura própria

struct inode {

uint32_t ino; // número identificador único

uint16_t type; // FILE, DIR, CHAR_DEV, BLOCK_DEV

uint32_t size;

uint16_t major, minor; // só relevante se for device

void *fs_data; // ponteiro pra info específica do FatFS (cluster, etc)

struct file_operations *ops; // tabela de funções pro tipo certo

};

Como isso convive com FatFS:

- Pra arquivos normais: seu vsopen lê a entrada do FatFS, monta um struct inode em RAM (cache, não gravado em disco em formato próprio), preenche fs_data com o que o FatFS precisa pra manipular aquele arquivo (cluster inicial, etc), e ops aponta pras funções do driver FatFS
- Pra devices: você já resolveu isso (interceptar /dev/* antes do FatFS) — nesse caso o inode é montado sem nunca tocar o FatFS, com ops apontando pro driver do hardware

## Por que essa é a melhor opção pro seu caso

1. Não exige mudar o FatFS — ele continua sendo só o "backend de armazenamento", você não precisa reescrever a lib
2. Te dá a interface uniforme (inode + file_operations) que faz o VFS ficar elegante e escalável, igual o que discutimos com major/minor
3. Custo baixo de implementação — é essencialmente uma struct que você preenche na hora do open(), não uma reforma estrutural
4. Path de evolução natural: se um dia você quiser mais (cache de inode, hard links dentro do seu próprio filesystem custom), já tem o esqueleto pronto

## O que eu não recomendaria agora

Tentar fazer o inode "viver" persistido em disco como estrutura própria (like ext2 faz) — isso significa abandonar FatFS ou rodar dois sistemas de arquivo em paralelo, complexidade grande pra ganho que você não citou precisar (compatibilidade com cartão CF lido em PC via FAT é provavelmente algo que você quer manter).

## Passo prático seguinte

Se quiser, posso te ajudar a desenhar o struct file_operations que unifica FatFS + drivers de device por baixo do mesmo inode — é o pedaço que realmente amarra tudo (VFS, inode, device, FatFS) numa interface só, do jeito Linux-like que você está gostando de seguir.
