ppsilv/Orion68/docs/68000_dip.jpg

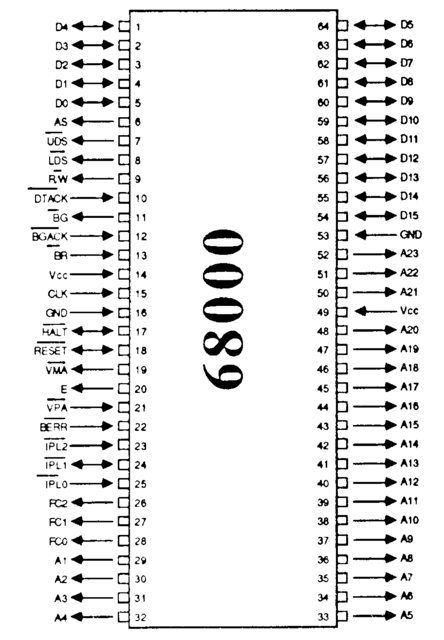
docs/68000_dip.jpg
