ppsilv/Orion68/docs/pictures/AS_DTACK.jpeg

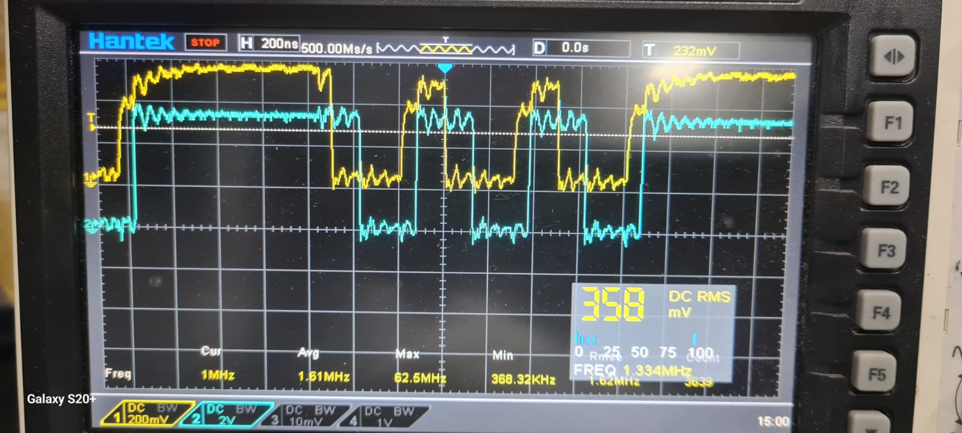
docs/pictures/AS_DTACK.jpeg
