ppsilv/Orion68/docs/pictures/backplaneV2/bpv2_03.jpeg

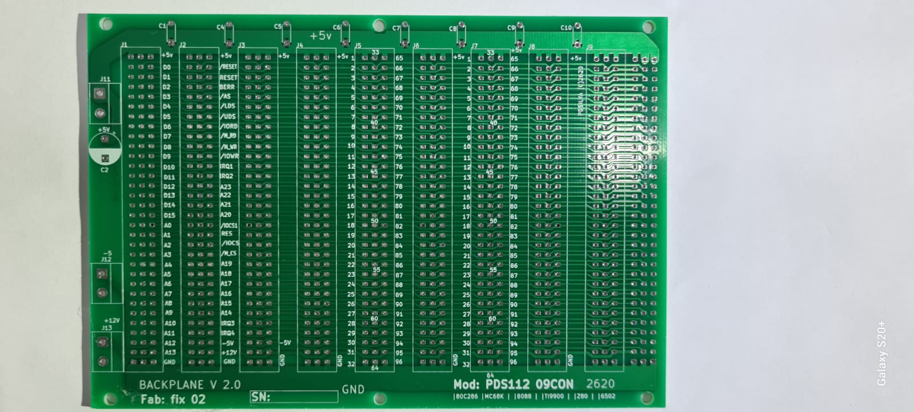
docs/pictures/backplaneV2/bpv2_03.jpeg
