ppsilv/Orion68/docs/pictures/backplaneV2/bpv2_05.jpeg

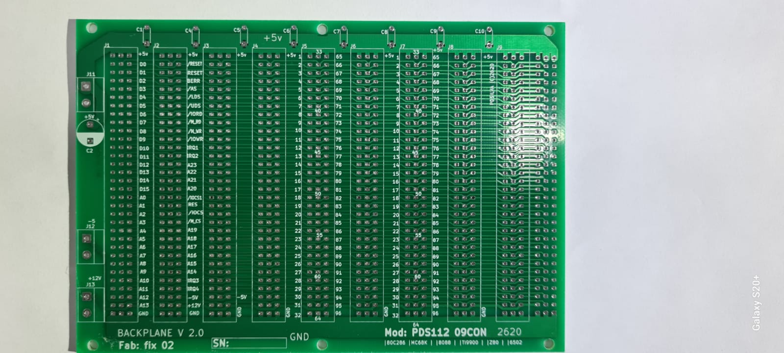
docs/pictures/backplaneV2/bpv2_05.jpeg
