ppsilv/Orion68/docs/pictures/backplaneV2/bpv2_06.jpeg

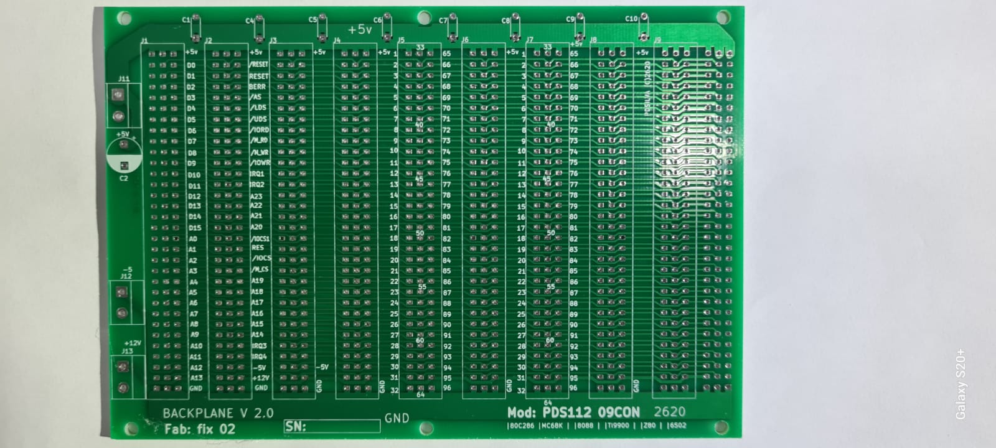
docs/pictures/backplaneV2/bpv2_06.jpeg
