ppsilv/Orion68/docs/pictures/backplaneV2/bpv2_07.jpeg

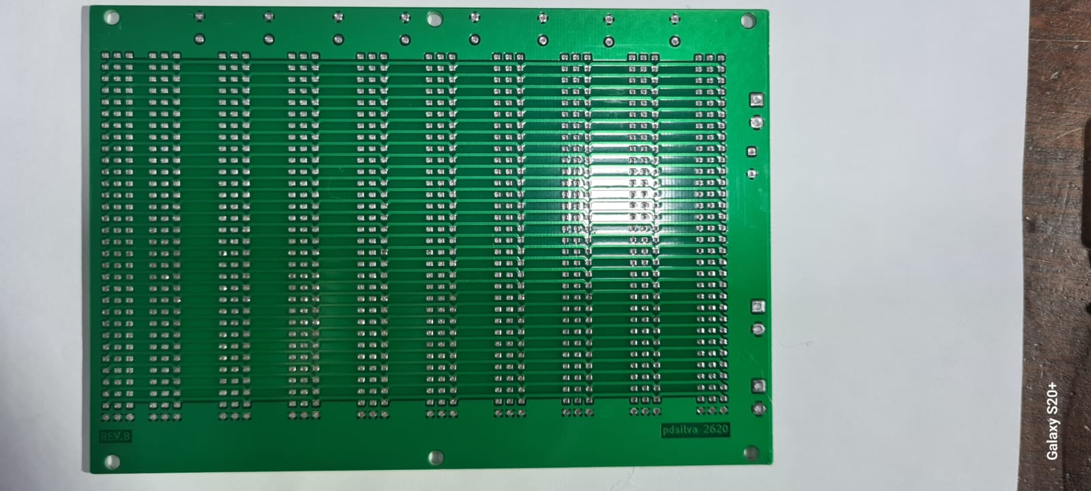
docs/pictures/backplaneV2/bpv2_07.jpeg
