ppsilv/Orion68/docs/pictures/backplaneV2/detalhe01.png

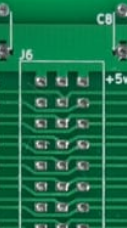
docs/pictures/backplaneV2/detalhe01.png
