ppsilv/Orion68/docs/pictures/backplaneV2/detalhe02.png

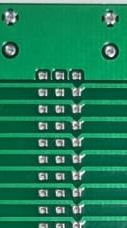
docs/pictures/backplaneV2/detalhe02.png
