ppsilv/Orion68/docs/pictures/board_orion68.jpeg

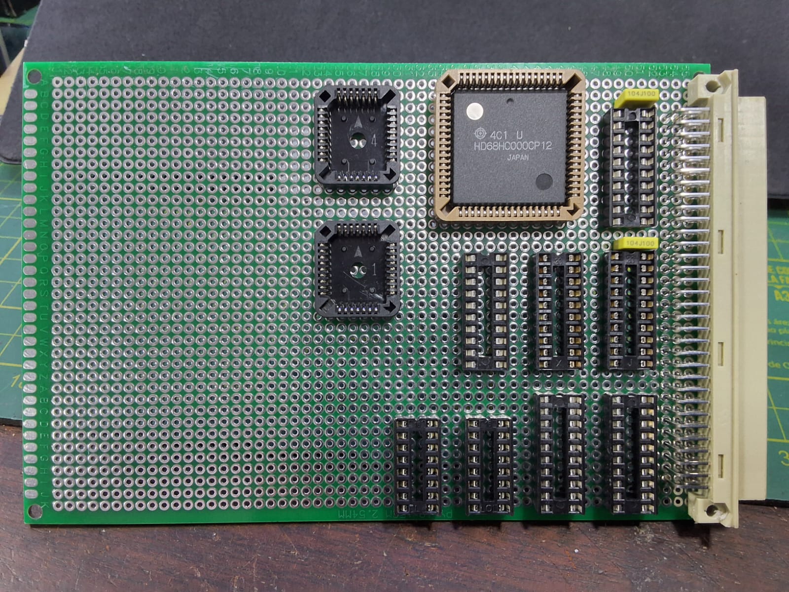
docs/pictures/board_orion68.jpeg
