ppsilv/Orion68/docs/pictures/boards/board_cpu_00.jpeg

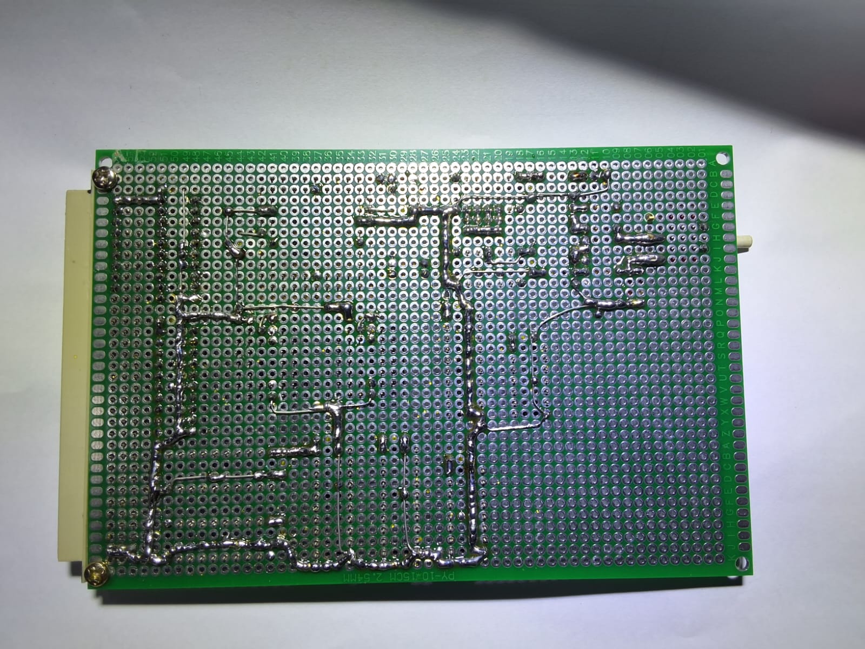
docs/pictures/boards/board_cpu_00.jpeg
