ppsilv/Orion68/docs/pictures/boards/board_cpu_01.jpeg

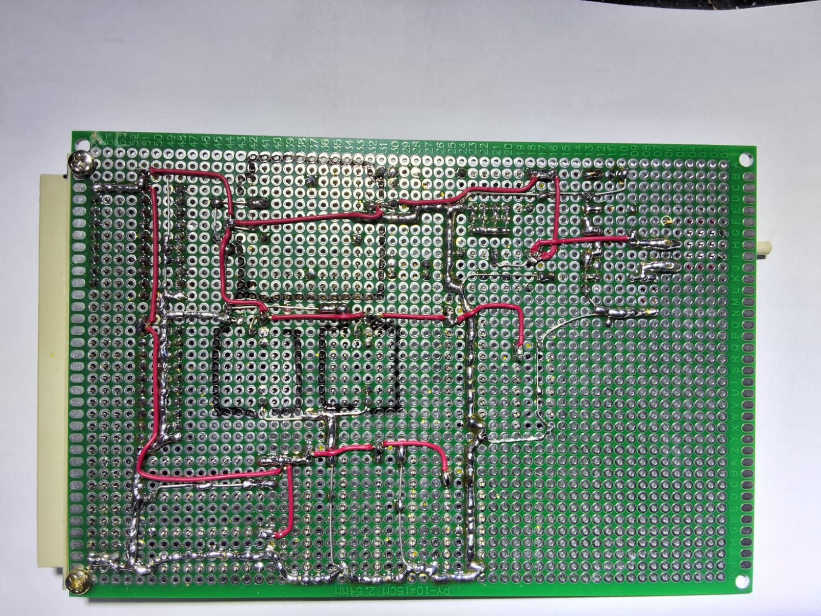
docs/pictures/boards/board_cpu_01.jpeg
