ppsilv/Orion68/docs/pictures/boards/board_cpu_02.jpeg

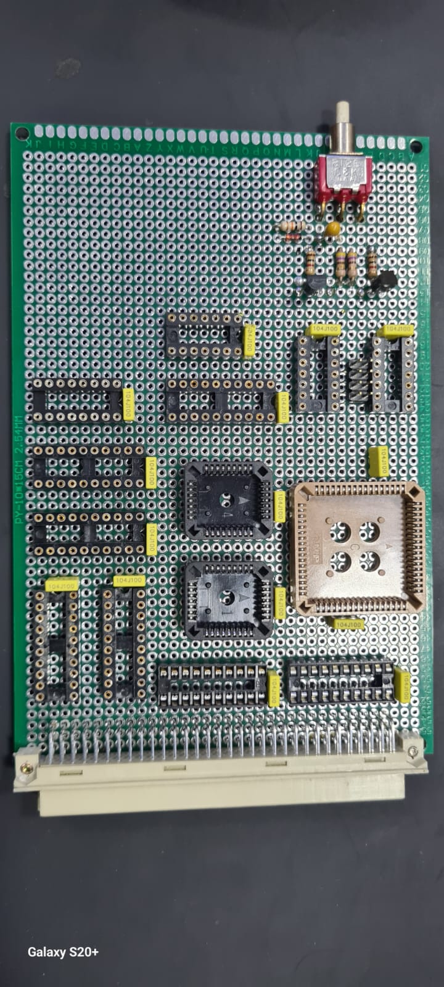
docs/pictures/boards/board_cpu_02.jpeg
