ppsilv/Orion68/docs/pictures/boards/board_cpu_03.jpeg

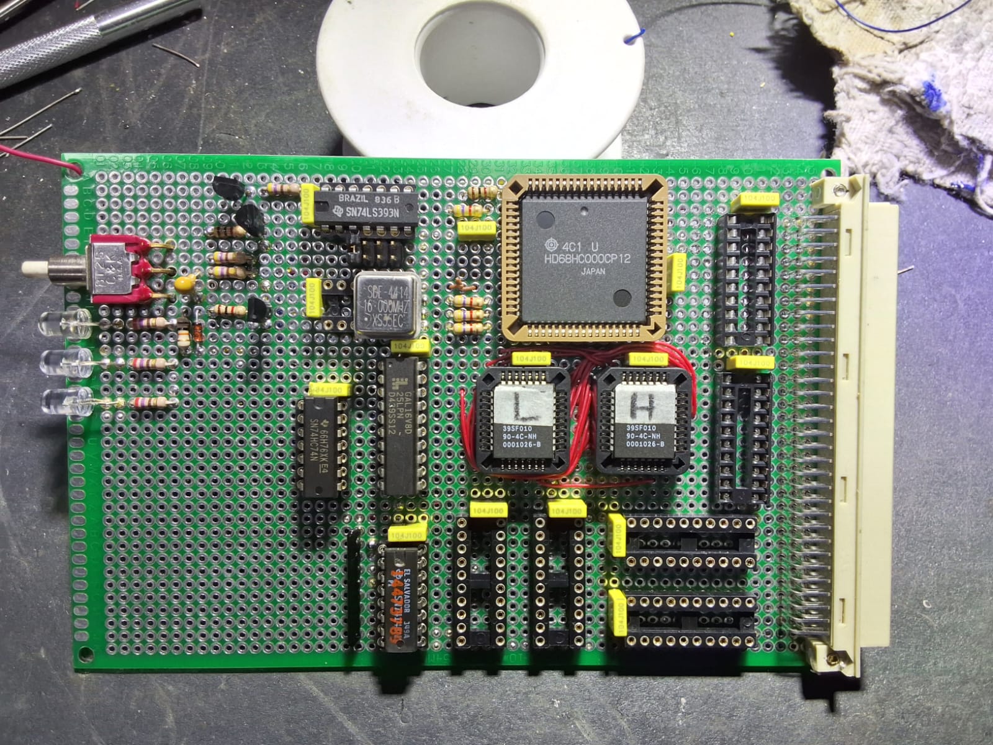
docs/pictures/boards/board_cpu_03.jpeg
