ppsilv/Orion68/docs/pictures/boards/board_cpu_04.jpeg

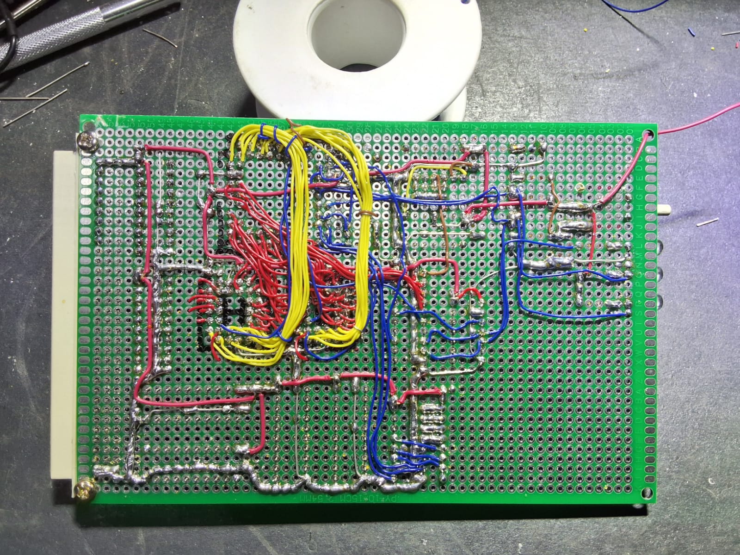
docs/pictures/boards/board_cpu_04.jpeg
