ppsilv/Orion68/docs/pictures/boards/board_sram01.jpeg

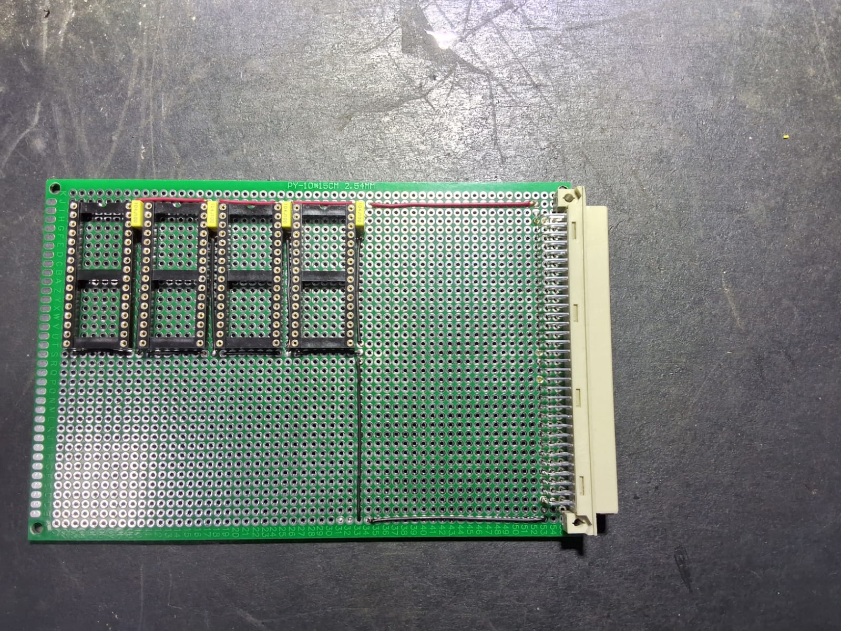
docs/pictures/boards/board_sram01.jpeg
