ppsilv/Orion68/docs/pictures/boards/board_sram02.jpeg

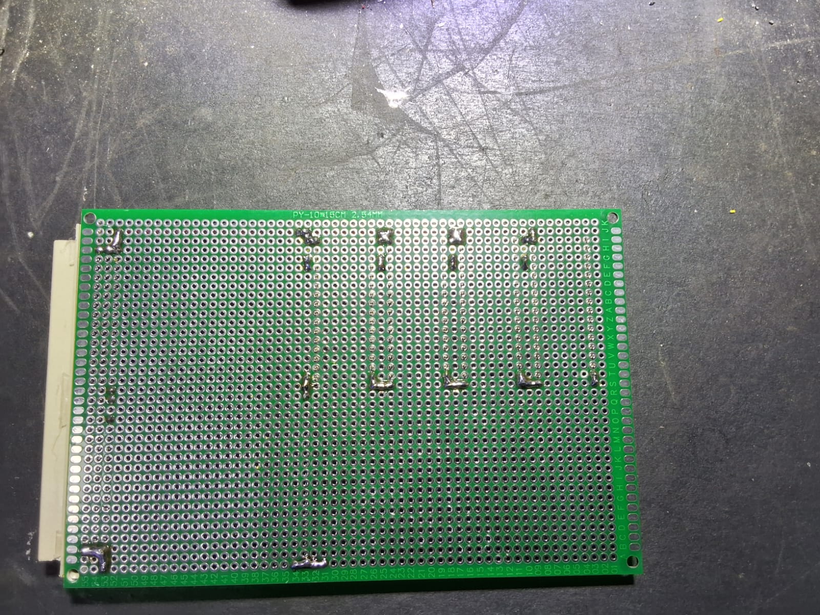
docs/pictures/boards/board_sram02.jpeg
