ppsilv/Orion68/docs/pictures/boards/board_sram03.jpeg

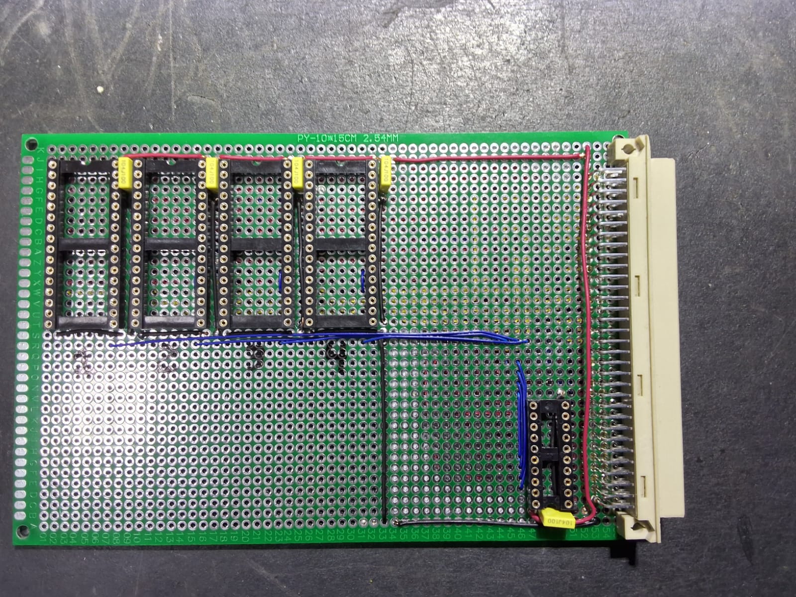
docs/pictures/boards/board_sram03.jpeg
