ppsilv/Orion68/docs/pictures/boards/board_sram04.jpeg

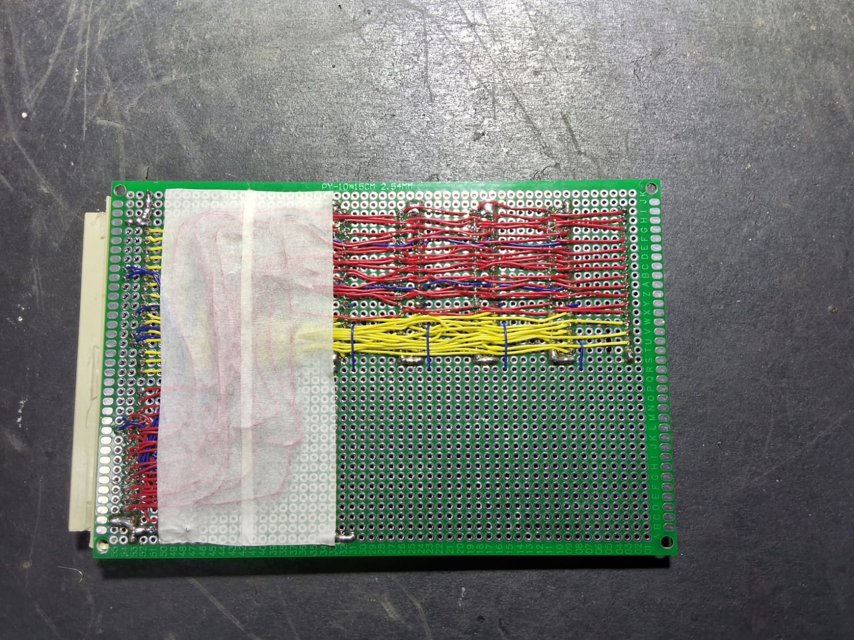
docs/pictures/boards/board_sram04.jpeg
