ppsilv/Orion68/docs/pictures/boards/clock_1MHZ.jpeg

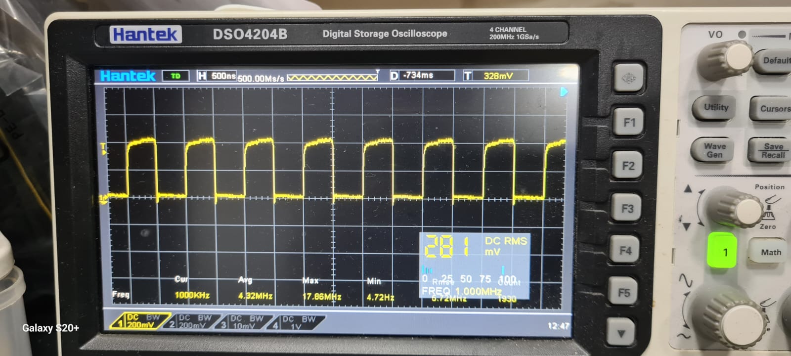
docs/pictures/boards/clock_1MHZ.jpeg
