ppsilv/Orion68/docs/pictures/boards/pds112_00.png

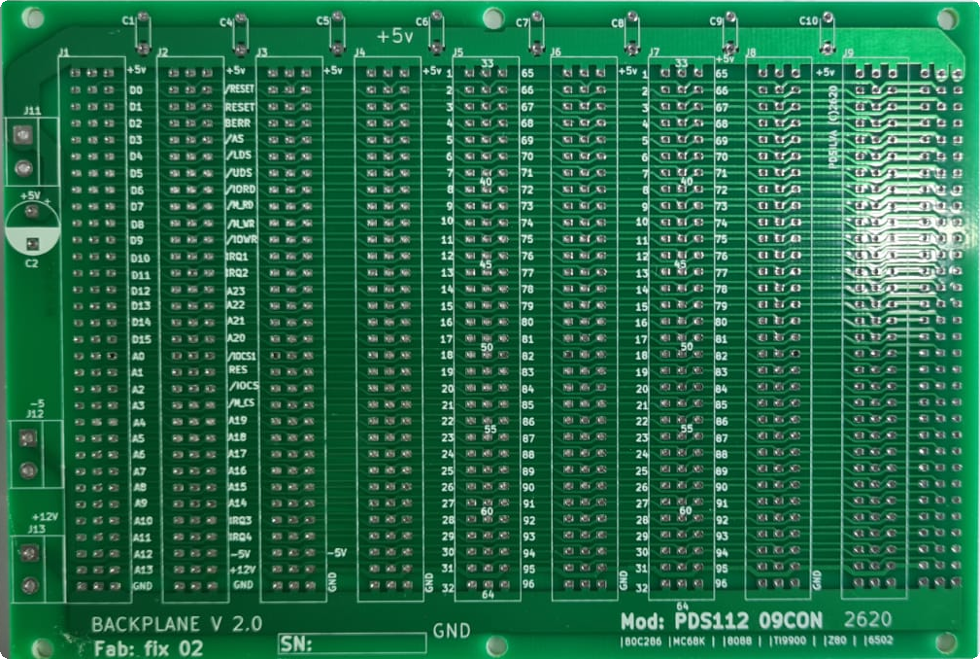
docs/pictures/boards/pds112_00.png
