ppsilv/Orion68/docs/pictures/boards/pds112_01.png

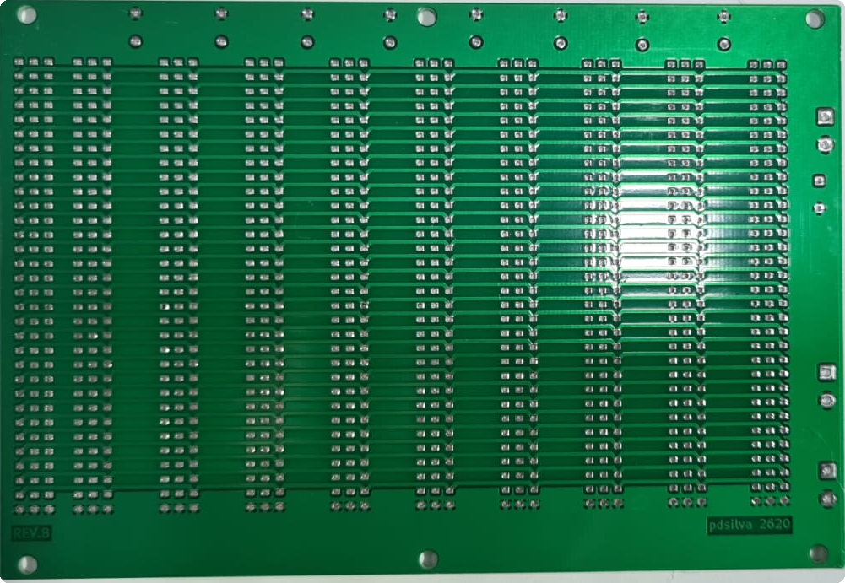
docs/pictures/boards/pds112_01.png
