ppsilv/Orion68/docs/pictures/boards/pds600.png

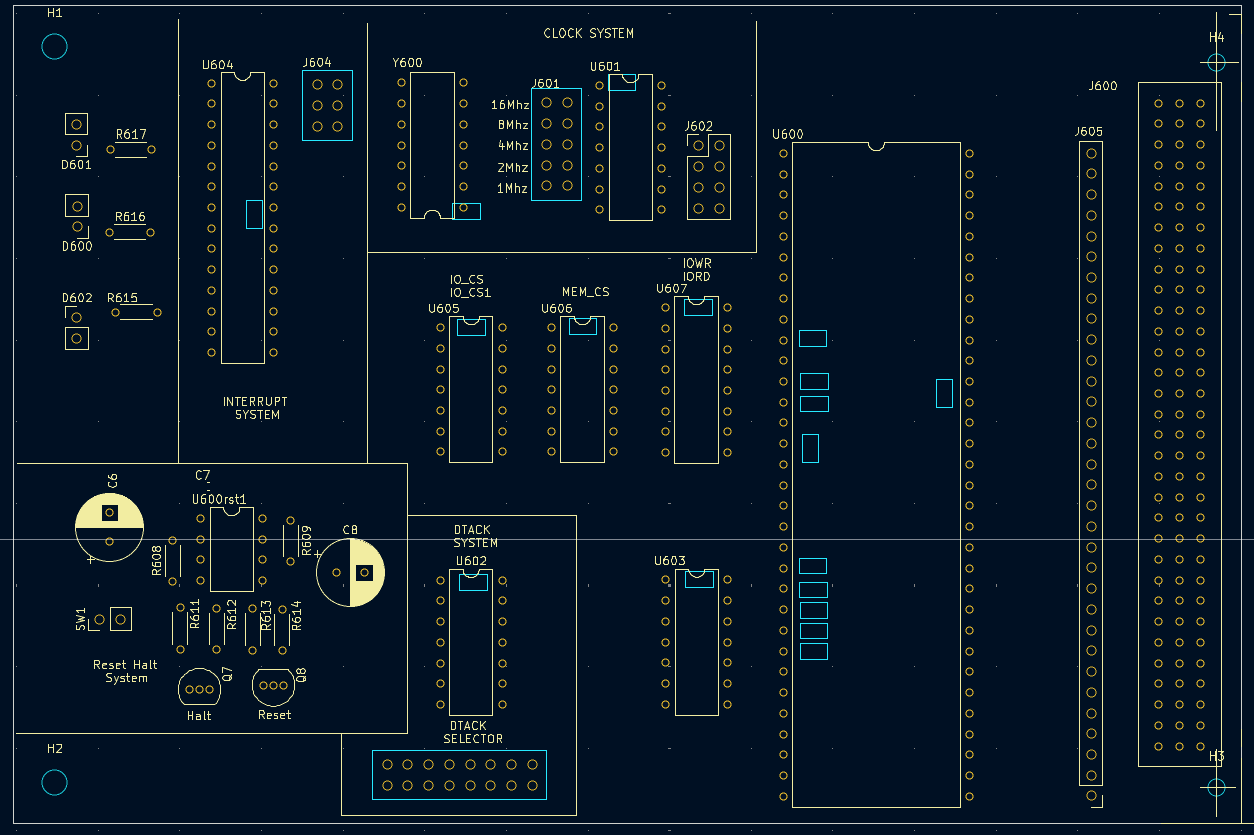
docs/pictures/boards/pds600.png
