ppsilv/Orion68/docs/pictures/boards/pds600_boardComplete.png

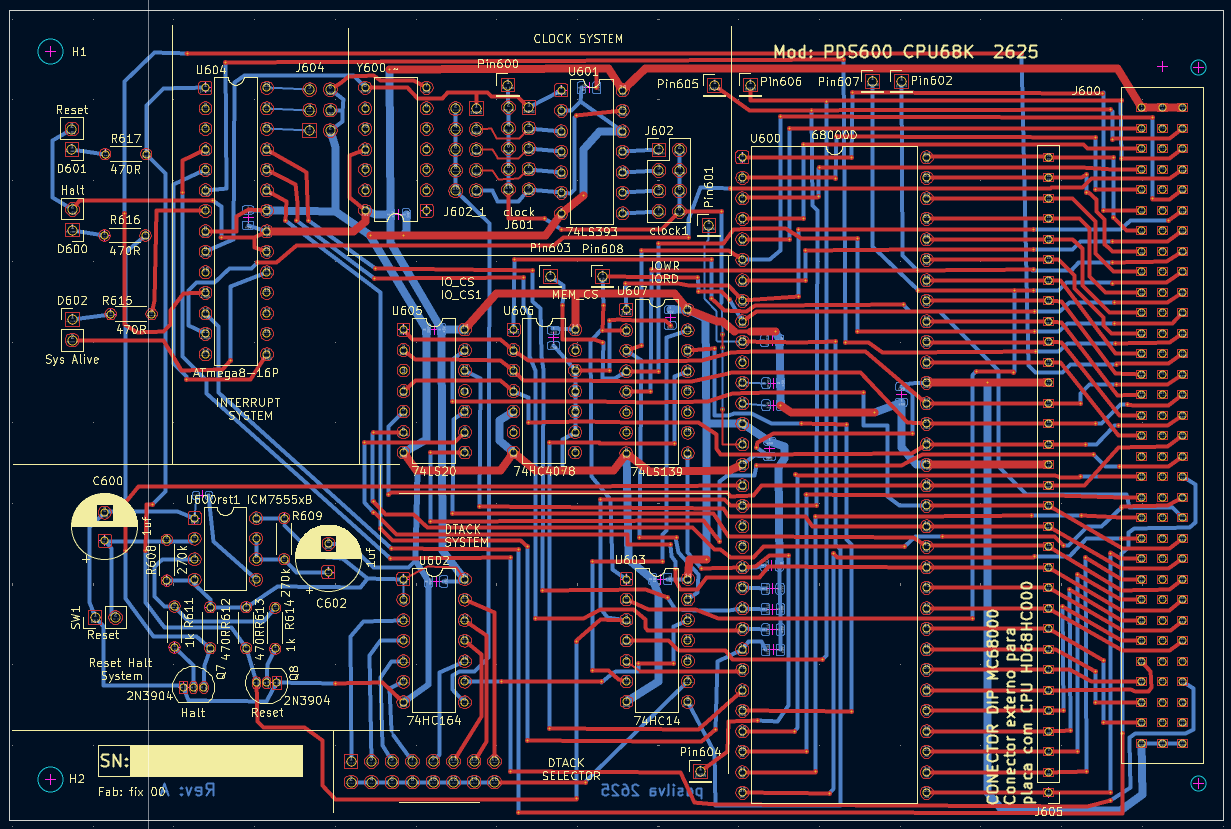
docs/pictures/boards/pds600_boardComplete.png
