ppsilv/Orion68/docs/pictures/boards/pds600_pcb001.png

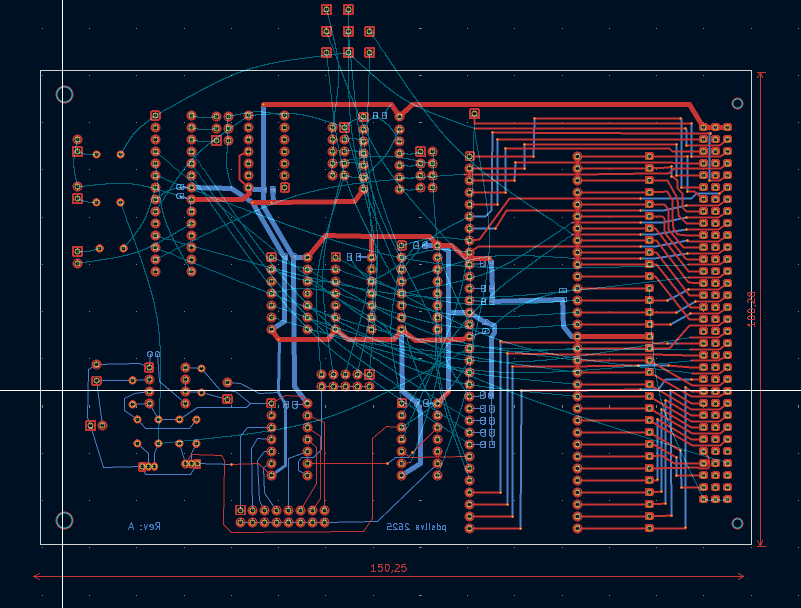
docs/pictures/boards/pds600_pcb001.png
