ppsilv/Orion68/docs/pictures/boards/pds600_pcb001_fab_00.png

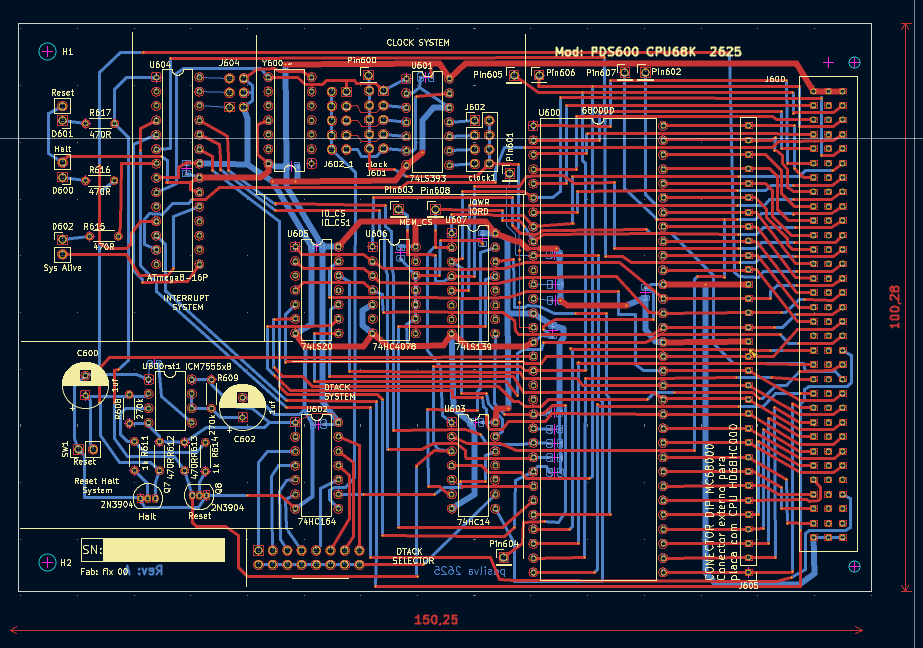
docs/pictures/boards/pds600_pcb001_fab_00.png
