ppsilv/Orion68/docs/pictures/bootin1.png

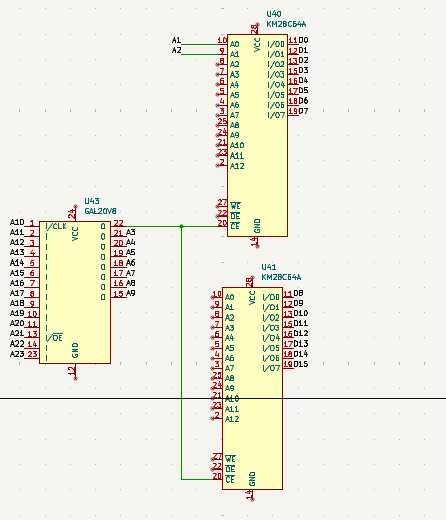
docs/pictures/bootin1.png
