ppsilv/Orion68/docs/pictures/BOOTIN.png

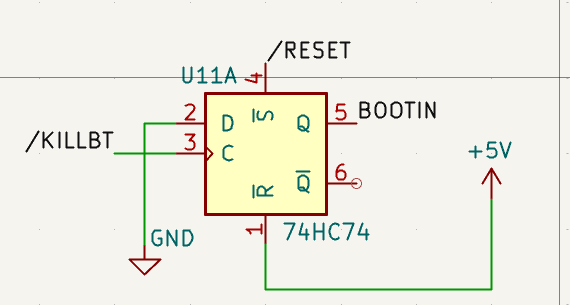
docs/pictures/BOOTIN.png
