ppsilv/Orion68/docs/pictures/bootin.png

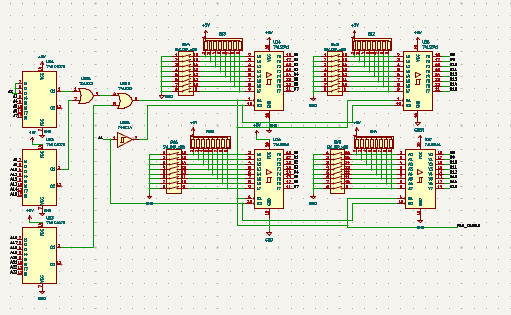
docs/pictures/bootin.png
