ppsilv/Orion68/docs/pictures/clock.jpeg

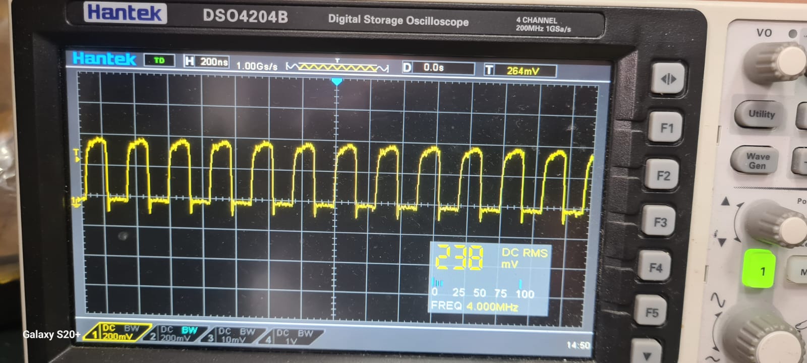
docs/pictures/clock.jpeg
