ppsilv/Orion68/docs/pictures/CS_dtack_tempoFuncao_pico.jpeg

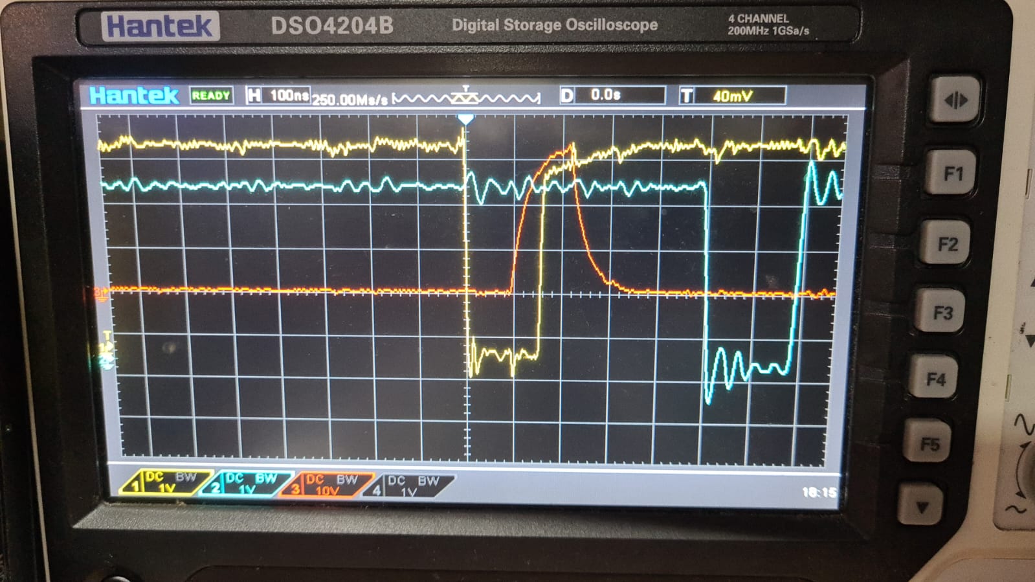
docs/pictures/CS_dtack_tempoFuncao_pico.jpeg
