ppsilv/Orion68/docs/pictures/cs_serial.png

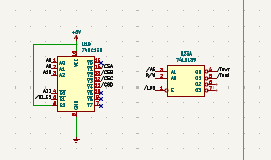
docs/pictures/cs_serial.png
