ppsilv/Orion68/docs/pictures/CS_WR_FunTemp_DTACK_pico.jpeg

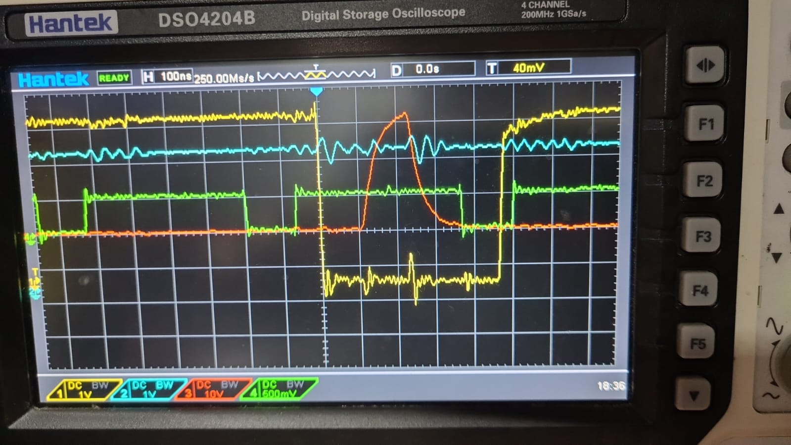
docs/pictures/CS_WR_FunTemp_DTACK_pico.jpeg
