ppsilv/Orion68/docs/pictures/dtack.jpeg

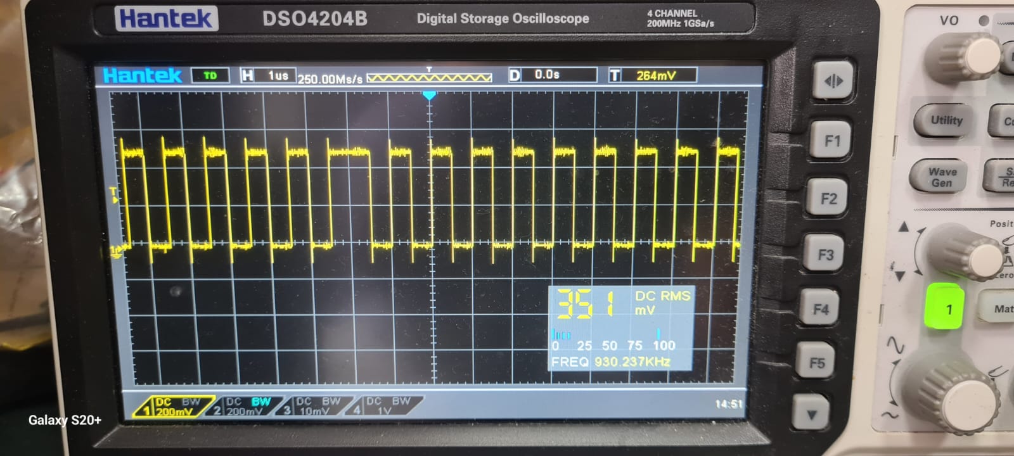
docs/pictures/dtack.jpeg
