ppsilv/Orion68/docs/pictures/dtack_pico.jpeg

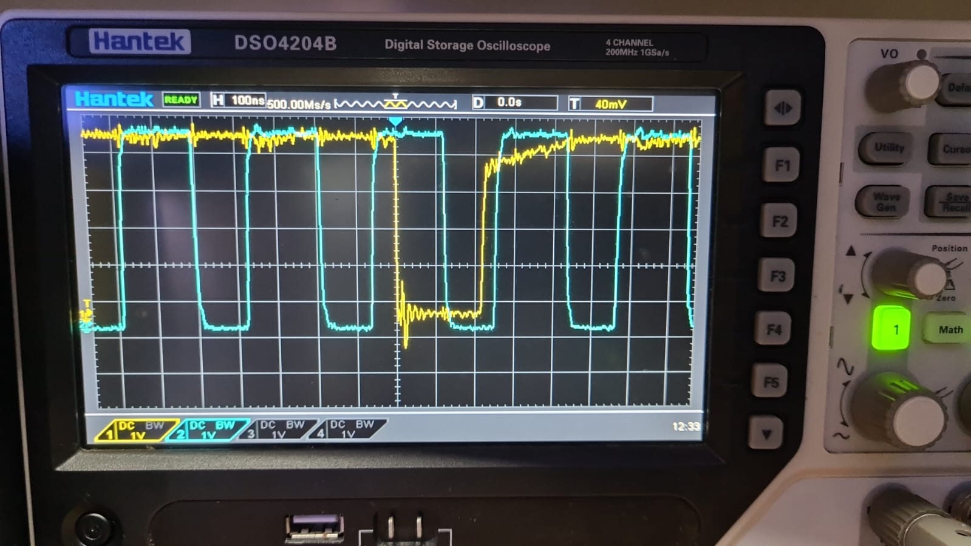
docs/pictures/dtack_pico.jpeg
