ppsilv/Orion68/docs/pictures/fita01.jpeg

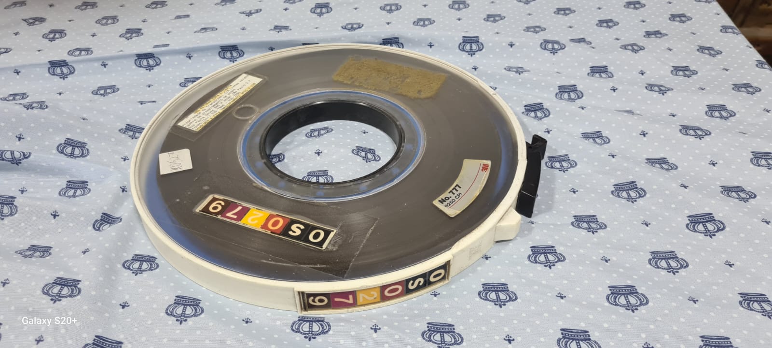
docs/pictures/fita01.jpeg
