ppsilv/Orion68/docs/pictures/intr01.png

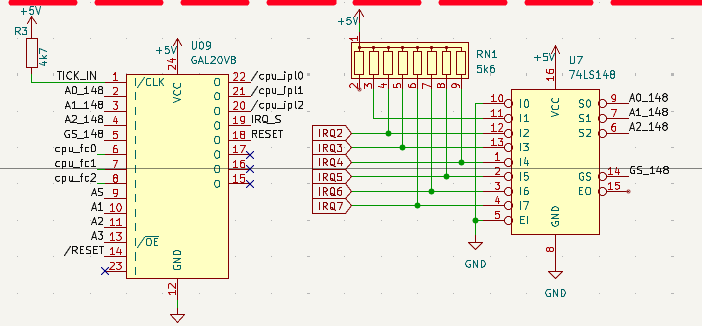
docs/pictures/intr01.png
