ppsilv/Orion68/docs/pictures/lds.jpeg

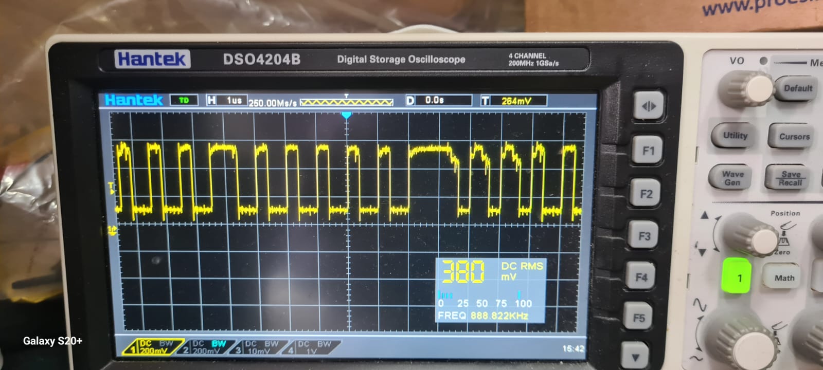
docs/pictures/lds.jpeg
