ppsilv/Orion68/docs/pictures/memdecode.png

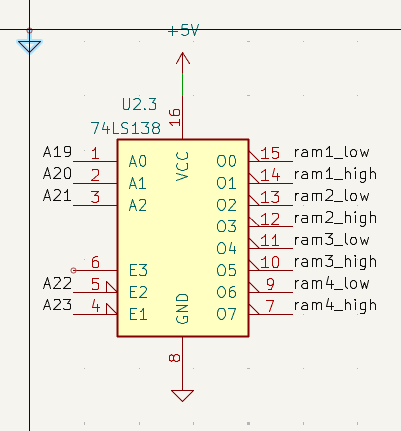
docs/pictures/memdecode.png
