ppsilv/Orion68/docs/pictures/pds200_proto01.jpg

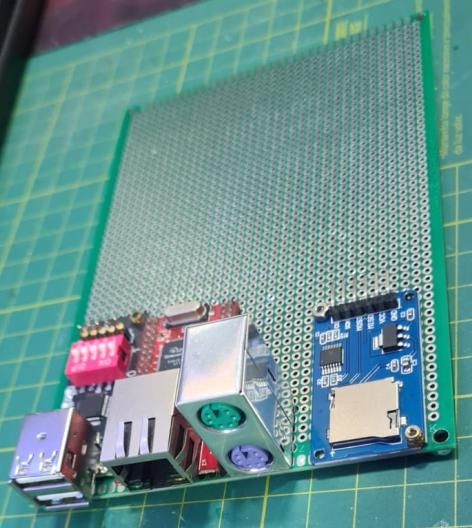
docs/pictures/pds200_proto01.jpg
