ppsilv/Orion68/docs/pictures/picoVGAgal.png

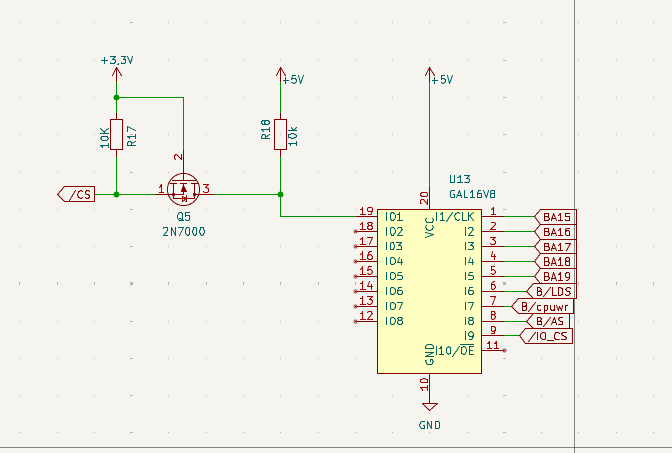
docs/pictures/picoVGAgal.png
