ppsilv/Orion68/docs/pictures/PS2.jpg

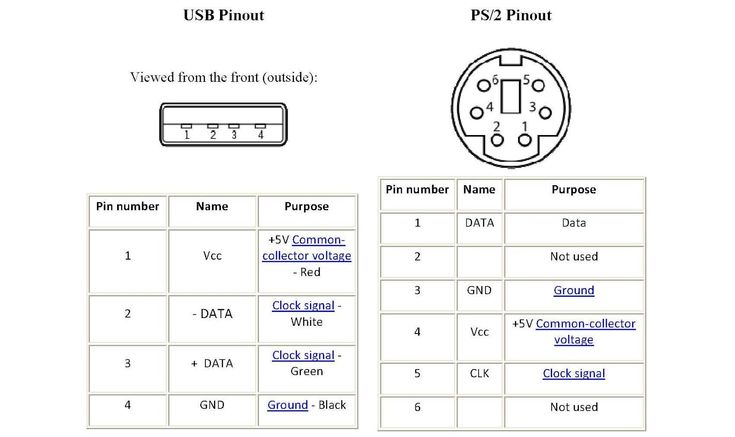
docs/pictures/PS2.jpg
