ppsilv/Orion68/docs/pictures/pwr_good.png

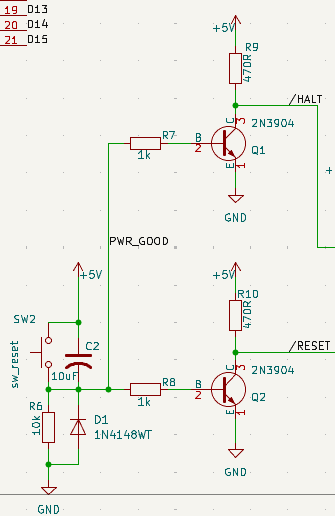
docs/pictures/pwr_good.png
