ppsilv/Orion68/docs/pictures/r-w.jpeg

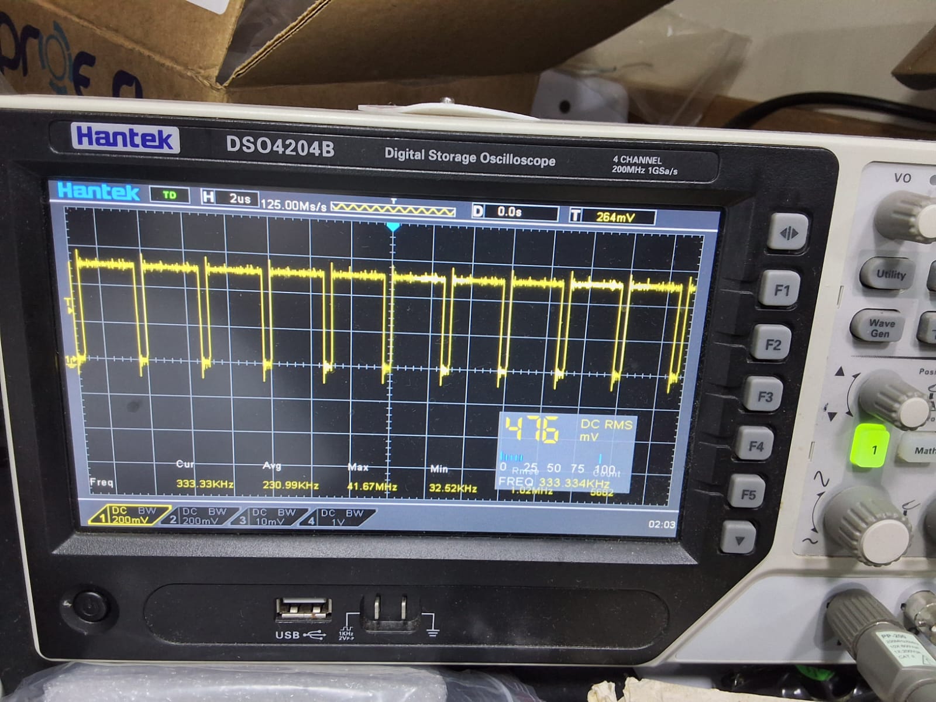
docs/pictures/r-w.jpeg
