ppsilv/Orion68/docs/pictures/rbw.jpeg

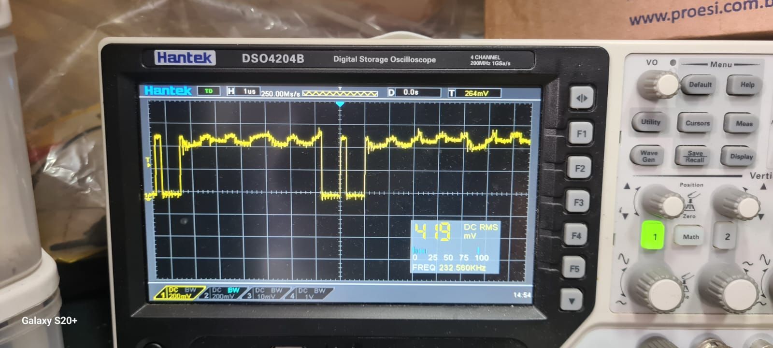
docs/pictures/rbw.jpeg
