ppsilv/Orion68/docs/pictures/rp5c01.png

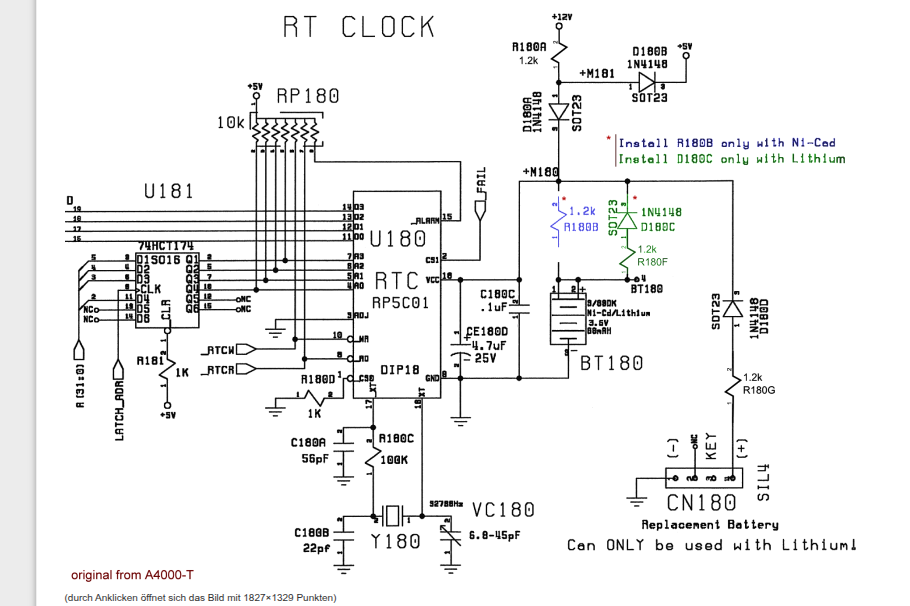
docs/pictures/rp5c01.png
