ppsilv/Orion68/docs/pictures/rp5c01A.png

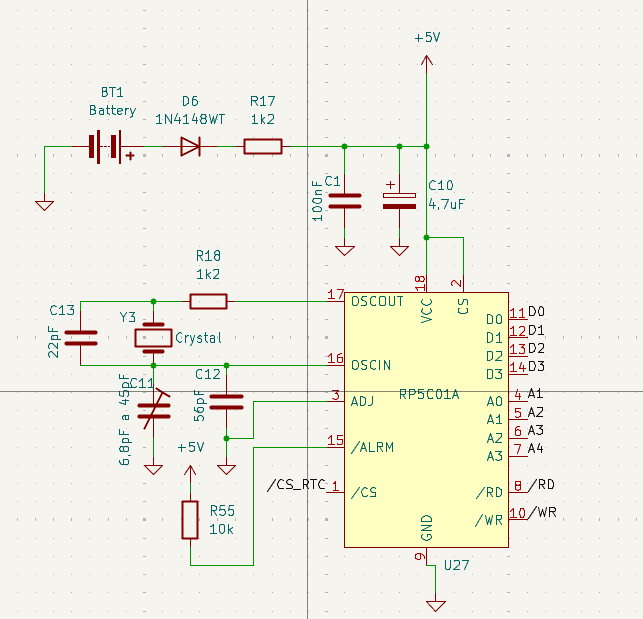
docs/pictures/rp5c01A.png
