ppsilv/Orion68/docs/pictures/shift_register.png

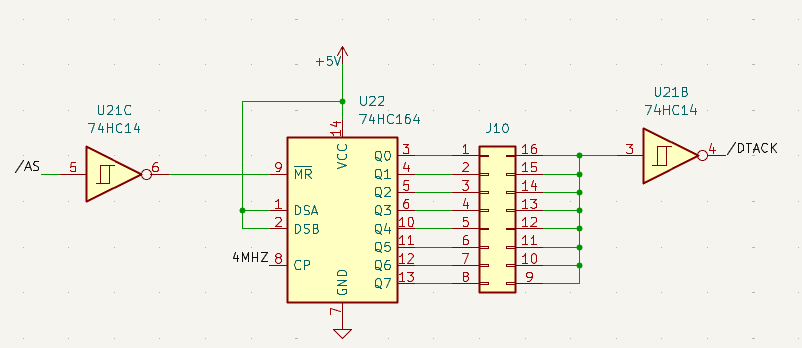
docs/pictures/shift_register.png
