ppsilv/Orion68/docs/pictures/u8.png

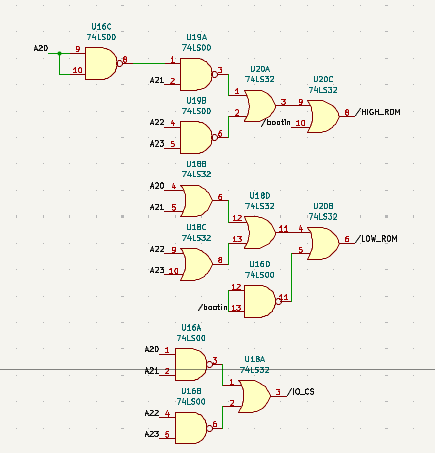
docs/pictures/u8.png
