ppsilv/Orion68/docs/pictures/uart01.jpeg

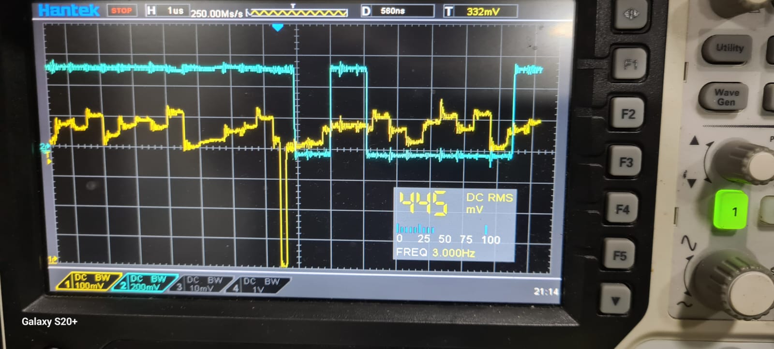
docs/pictures/uart01.jpeg
