ppsilv/Orion68/docs/pictures/uart02.jpeg

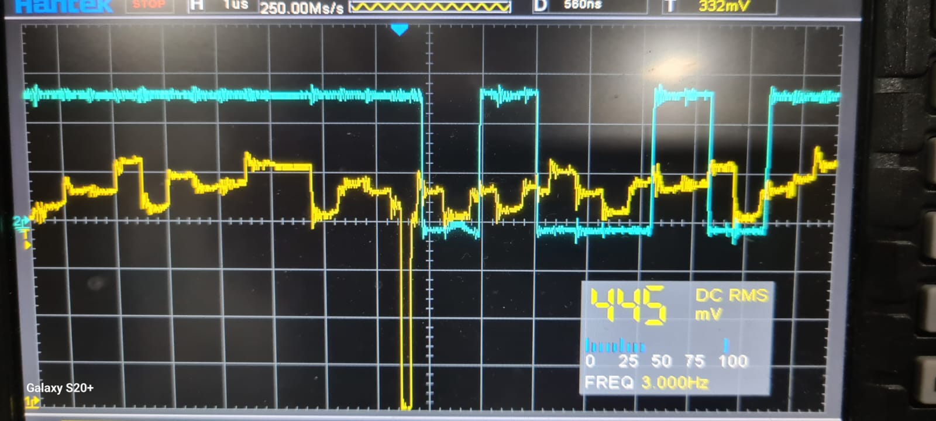
docs/pictures/uart02.jpeg
