ppsilv/Orion68/docs/pictures/uart03.jpeg

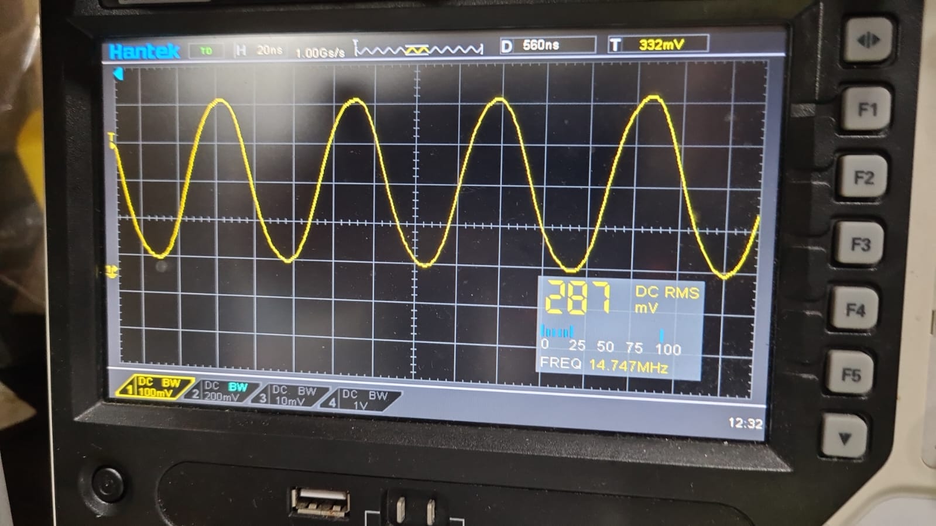
docs/pictures/uart03.jpeg
