ppsilv/Orion68/docs/pictures/uart04.jpeg

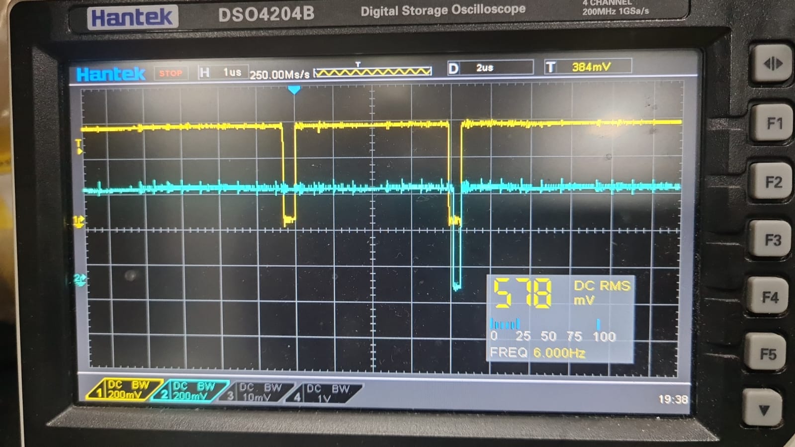
docs/pictures/uart04.jpeg
