ppsilv/Orion68/docs/pictures/uart05.jpeg

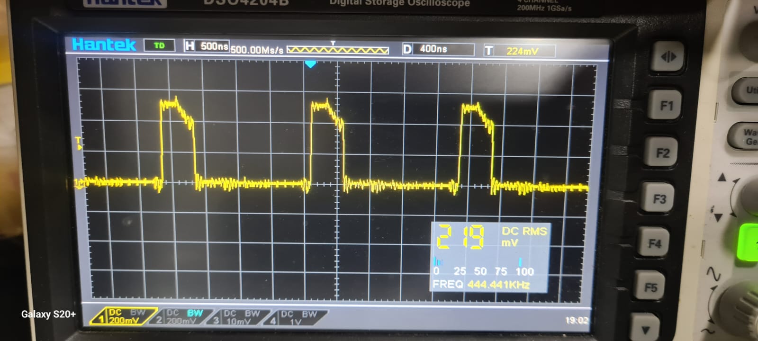
docs/pictures/uart05.jpeg
