ppsilv/Orion68/docs/pictures/uart06.jpeg

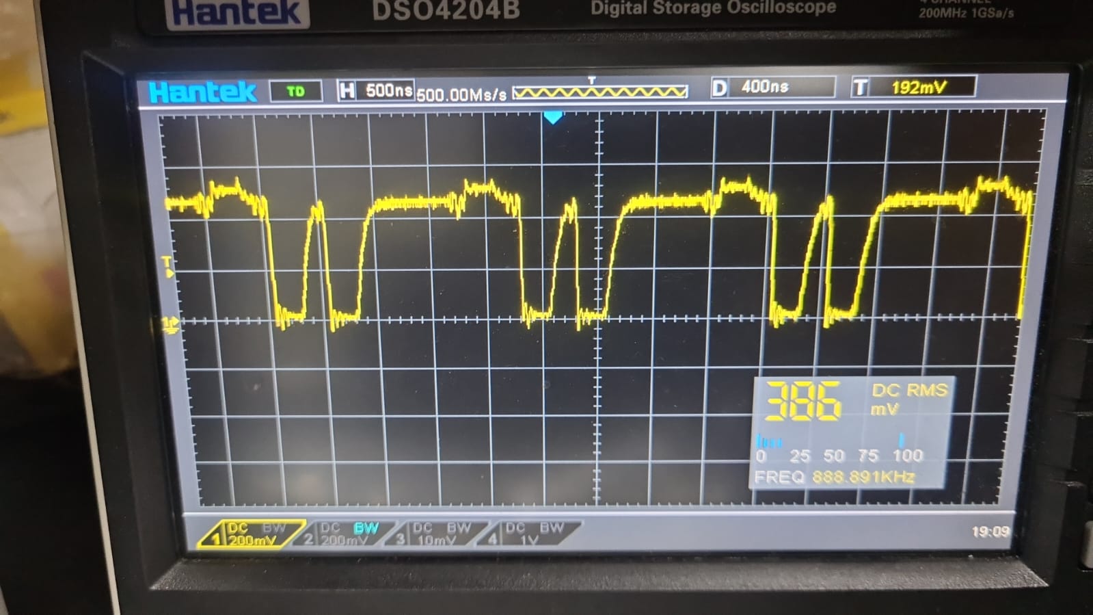
docs/pictures/uart06.jpeg
