ppsilv/Orion68/docs/pictures/uart07.jpeg

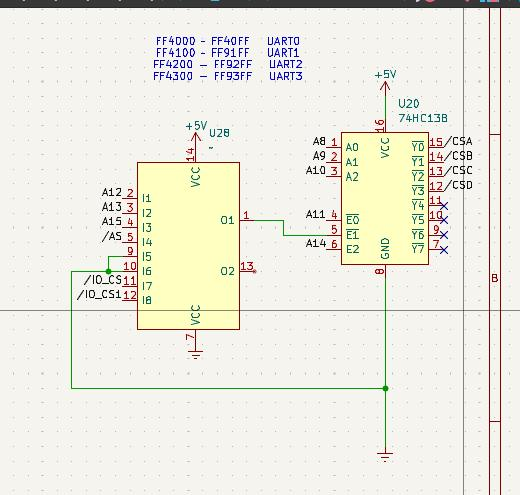
docs/pictures/uart07.jpeg
