ppsilv/Orion68/docs/pinout68000.png

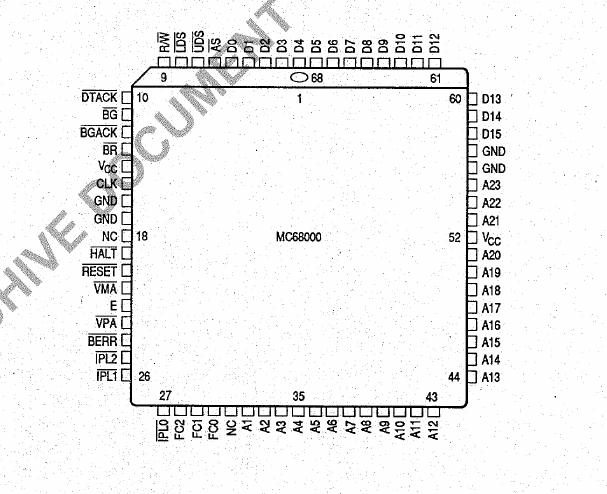
docs/pinout68000.png
