ppsilv/Orion68/docs/pinout_uart16c554.png

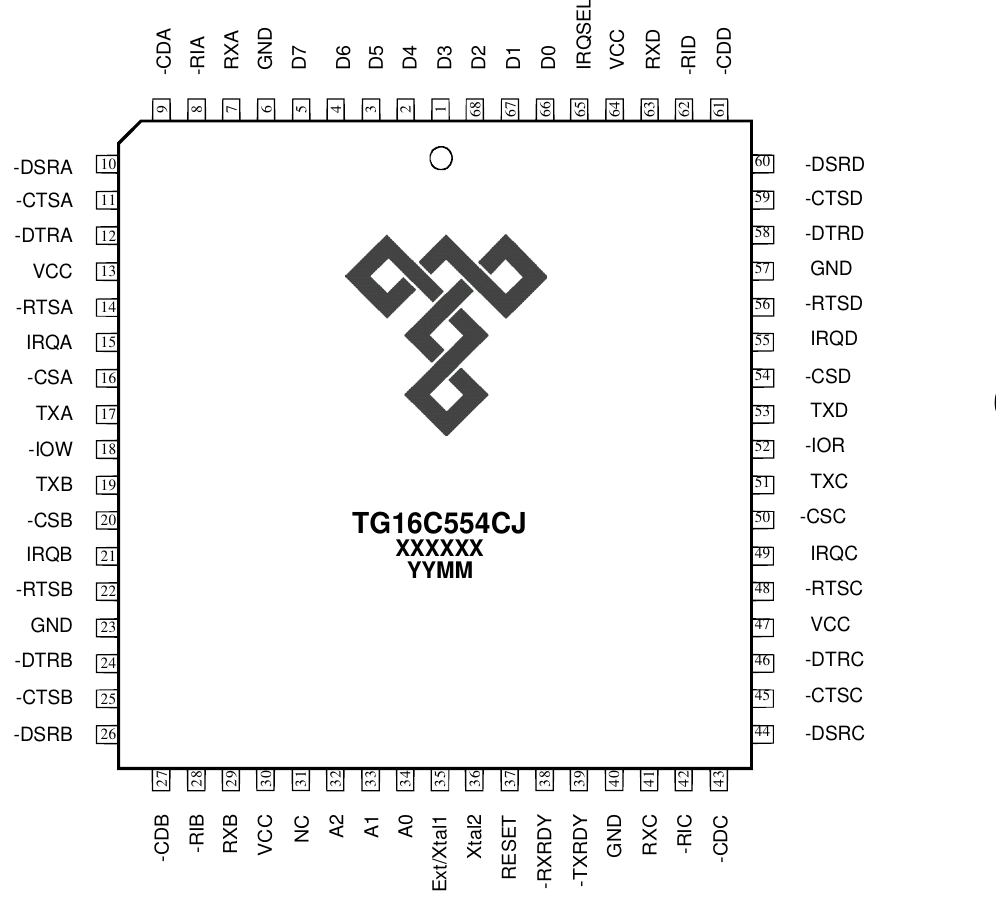
docs/pinout_uart16c554.png
