ppsilv/Orion68/docs/PLCC_68_MC68000.png

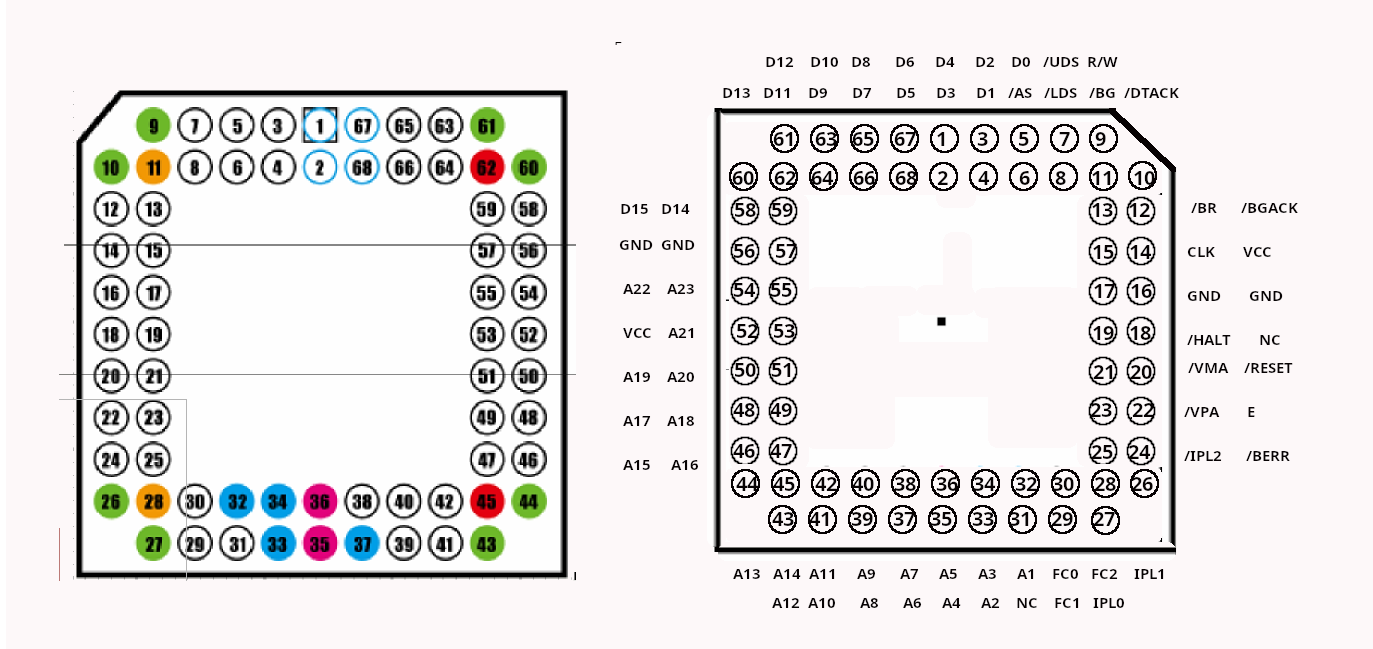
docs/PLCC_68_MC68000.png
