ppsilv/Orion68/docs/ps2comArduino.png

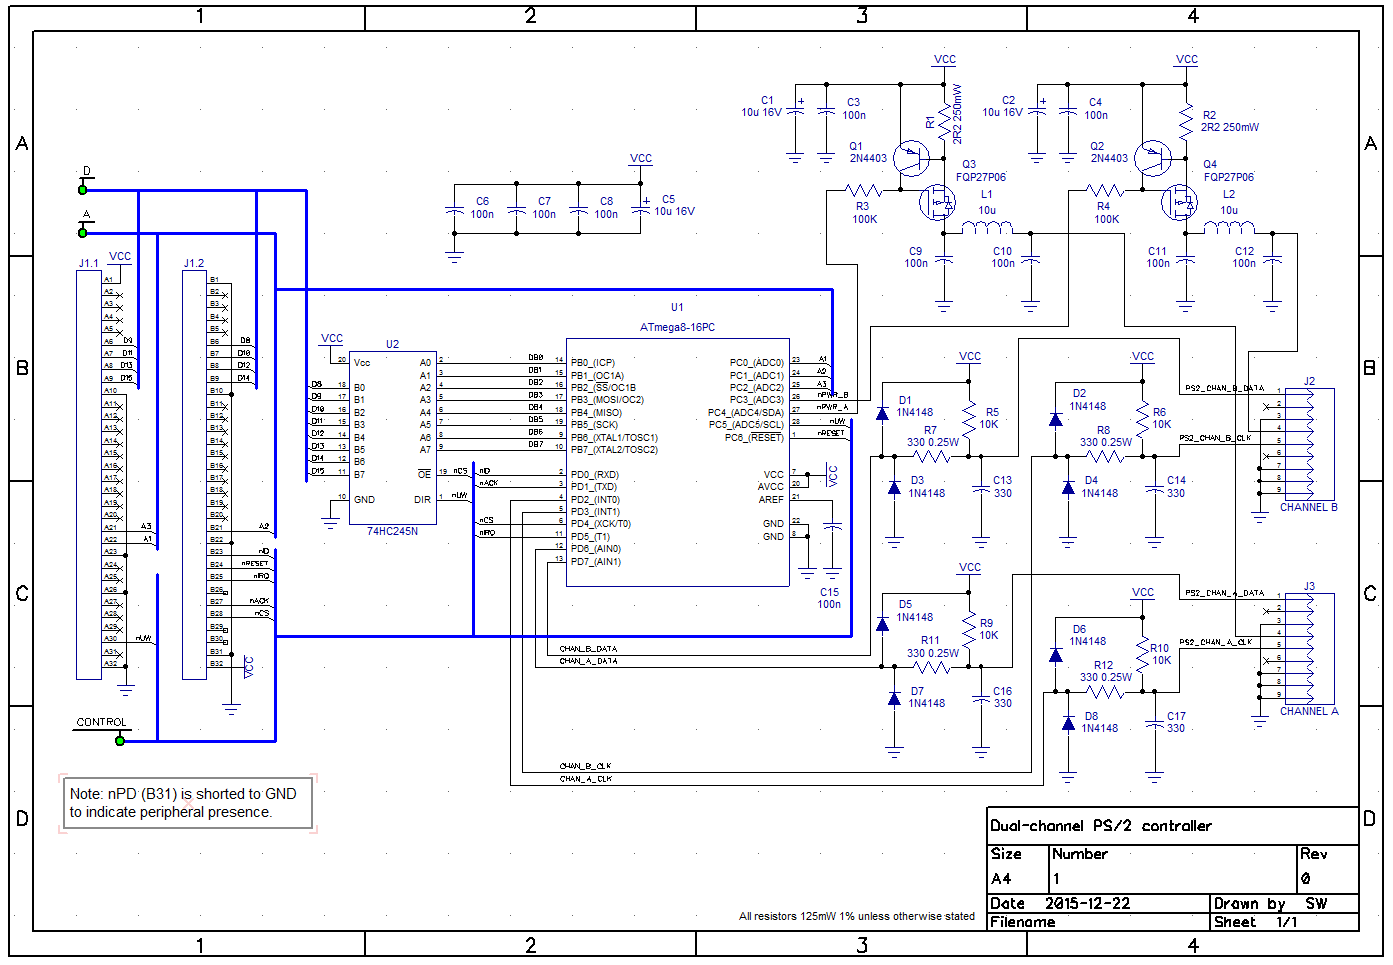
docs/ps2comArduino.png
