ppsilv/Orion68/docs/VGA/dac.jpg

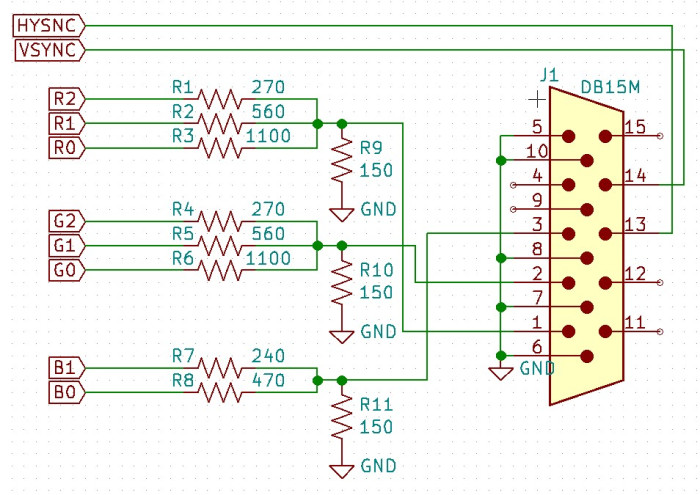
docs/VGA/dac.jpg
