ppsilv/Orion68/docs/VGA/esquema01.png

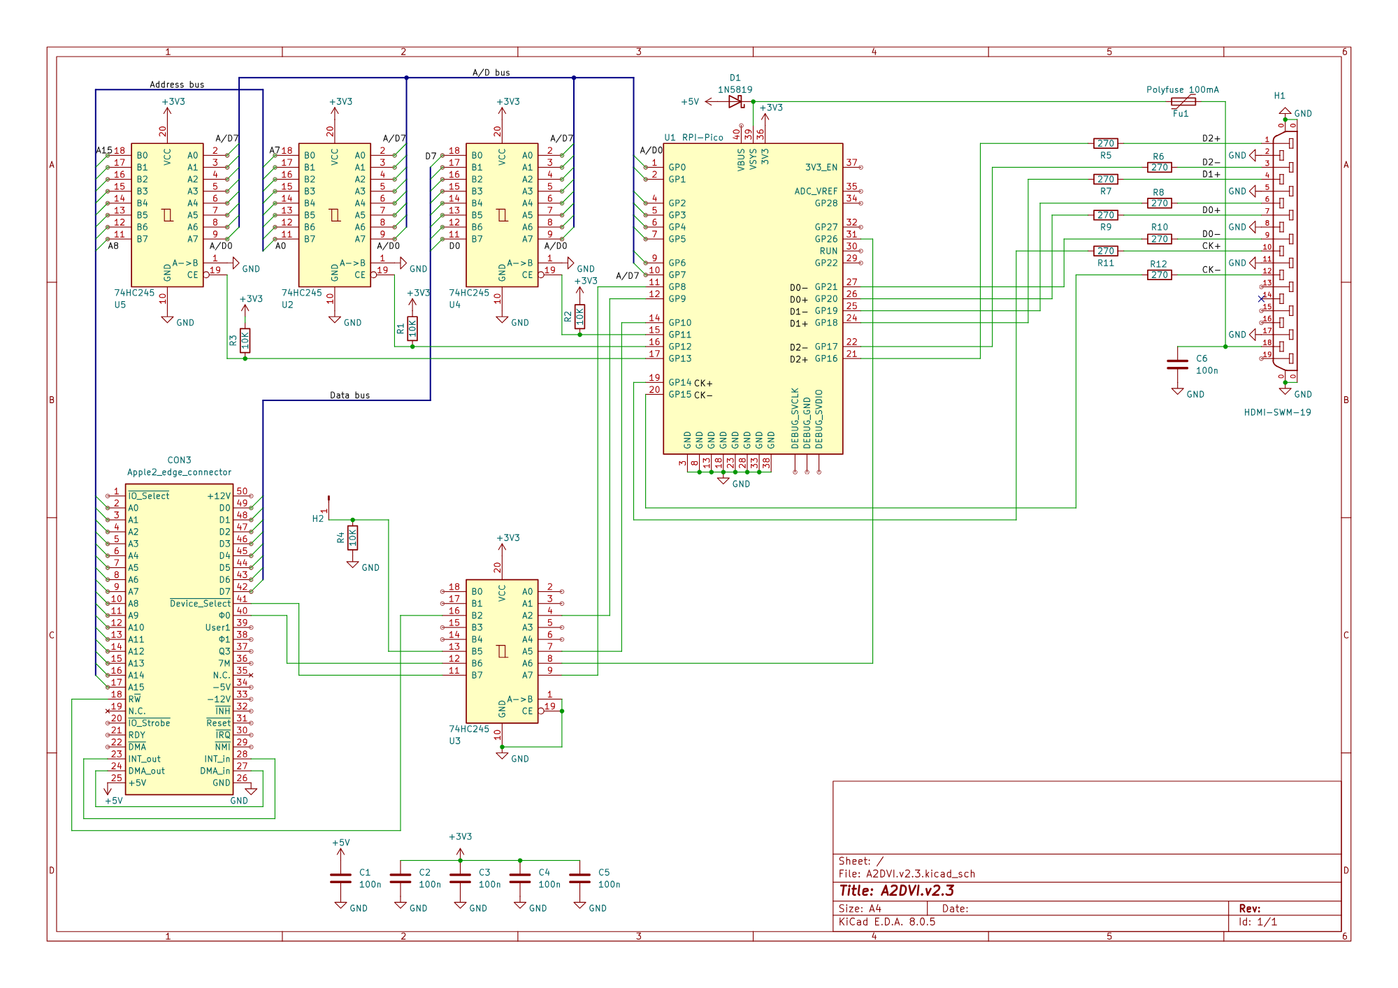
docs/VGA/esquema01.png
