ppsilv/Orion68/hardware/schematics/boards/3d_pds100.jpg

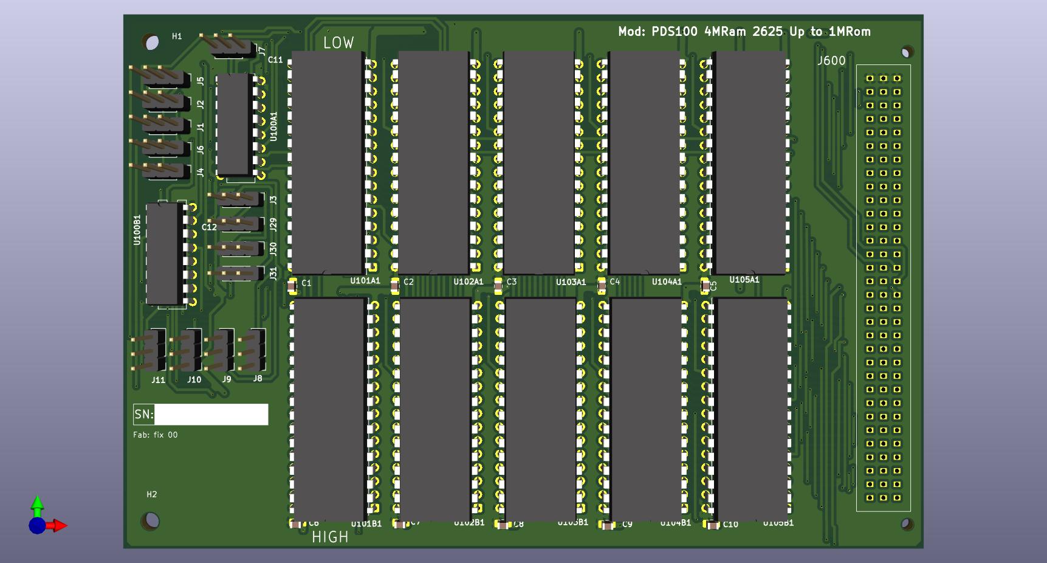
hardware/schematics/boards/3d_pds100.jpg
