ppsilv/Orion68/hardware/schematics/boards/3d_pds100_JMP_detail.png

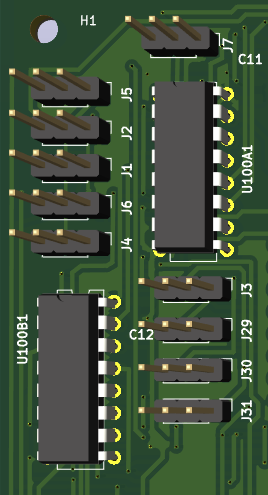
hardware/schematics/boards/3d_pds100_JMP_detail.png
