ppsilv/Orion68/hardware/schematics/boards/3d_pds600.jpg

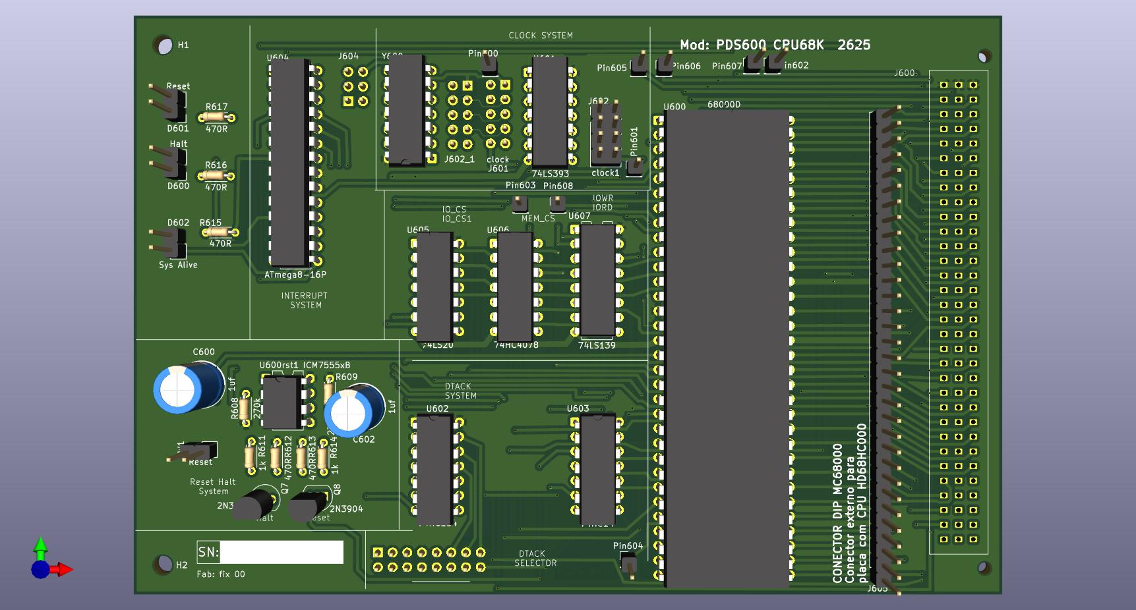
hardware/schematics/boards/3d_pds600.jpg
