ppsilv/Orion68/hardware/schematics/boards/route_complete_pds100.png

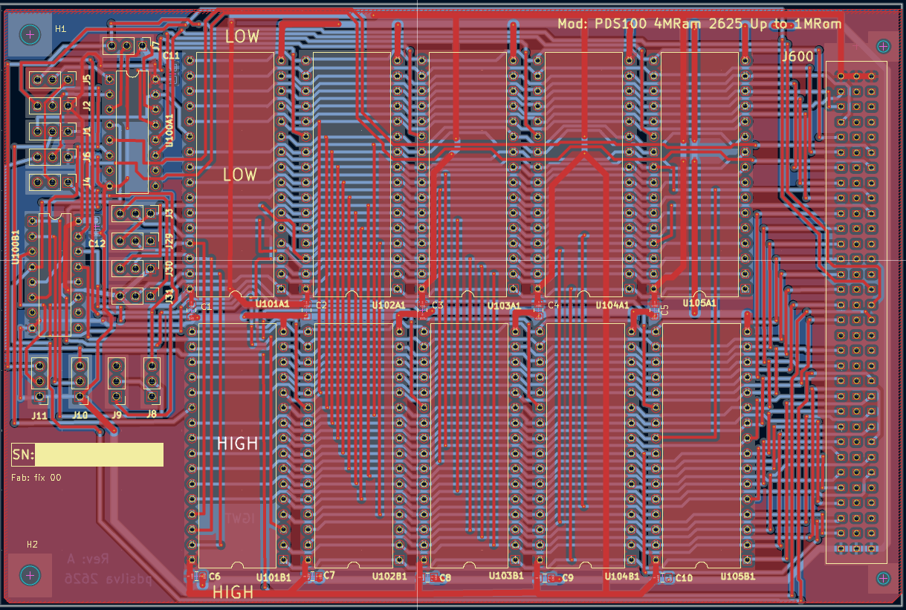
hardware/schematics/boards/route_complete_pds100.png
