ppsilv/Orion68/hardware/schematics/boards/SelectionDetail74hc138.png

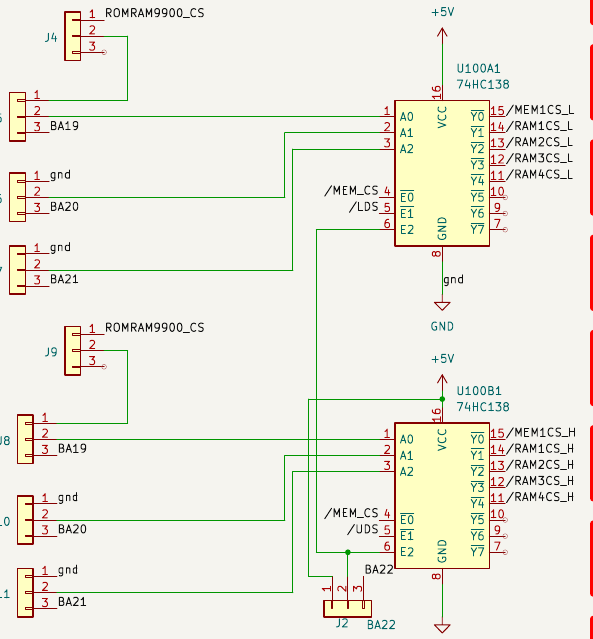
hardware/schematics/boards/SelectionDetail74hc138.png
