ppsilv/Orion68/hardware/schematics/cpu_comp.png

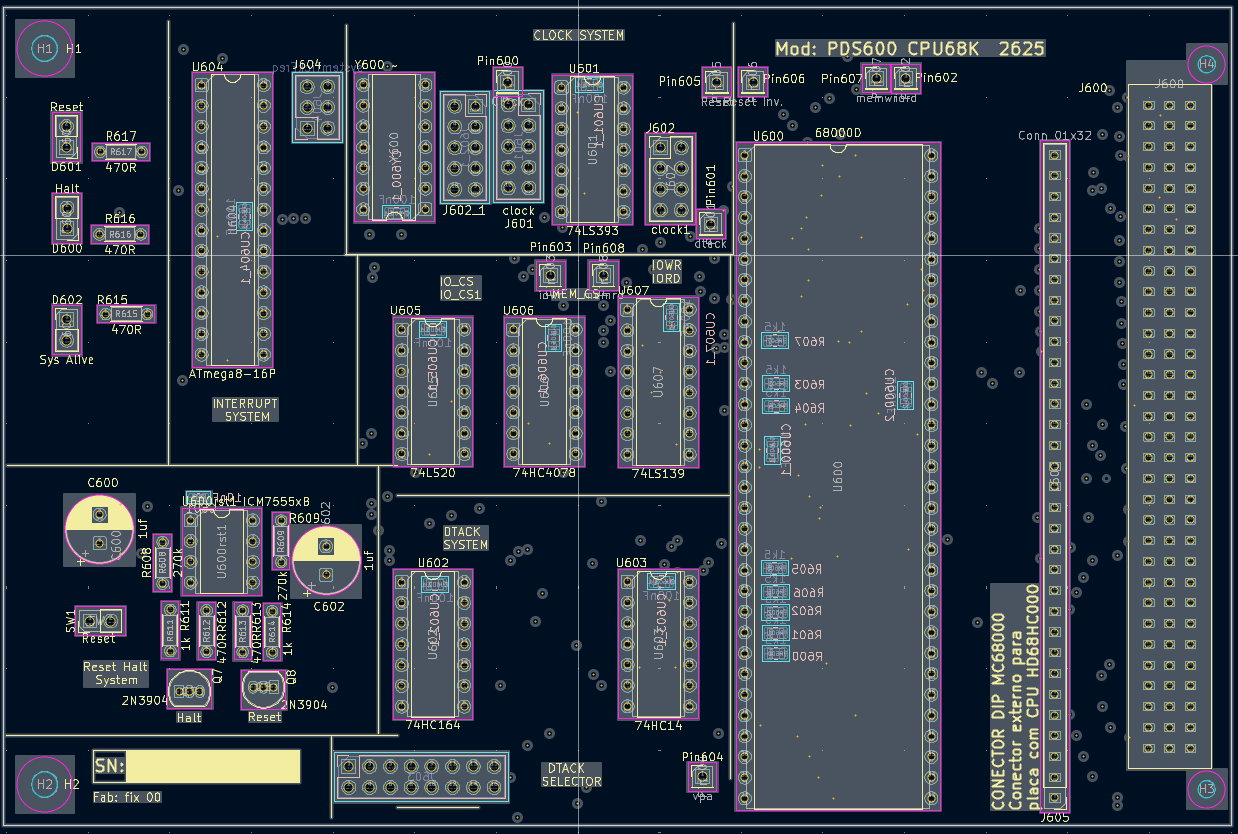
hardware/schematics/cpu_comp.png
