ppsilv/Orion68/hardware/schematics/Din41612_template/TEC-CI-padroes.png

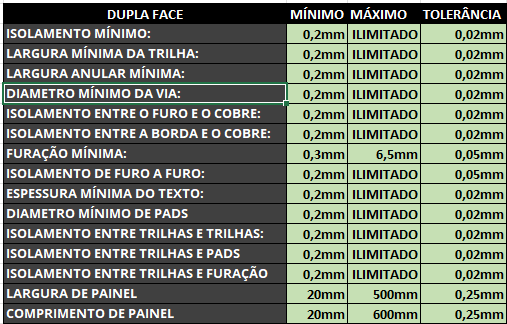
hardware/schematics/Din41612_template/TEC-CI-padroes.png
