ppsilv/Orion68/hardware/schematics/memory_comp.png

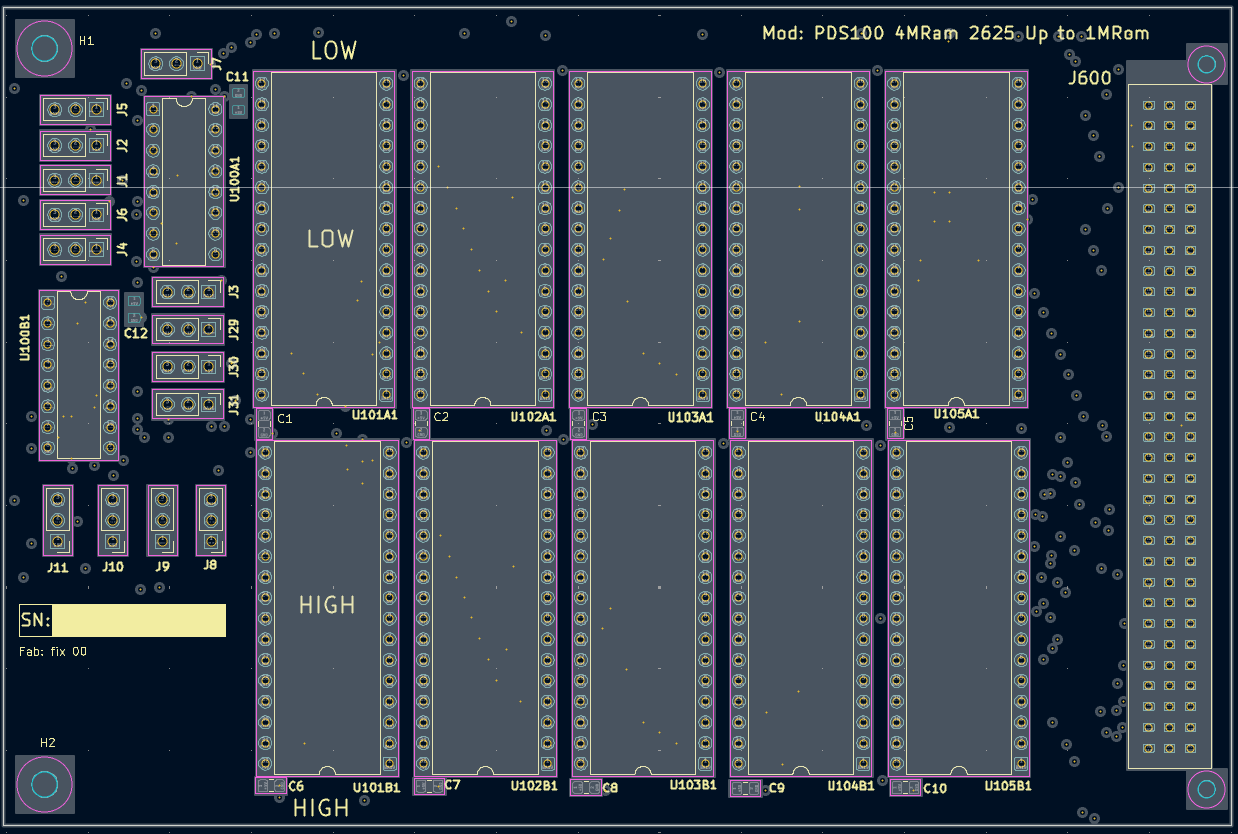
hardware/schematics/memory_comp.png
