ppsilv/Orion68/hardware/schematics/VT82C42N.png

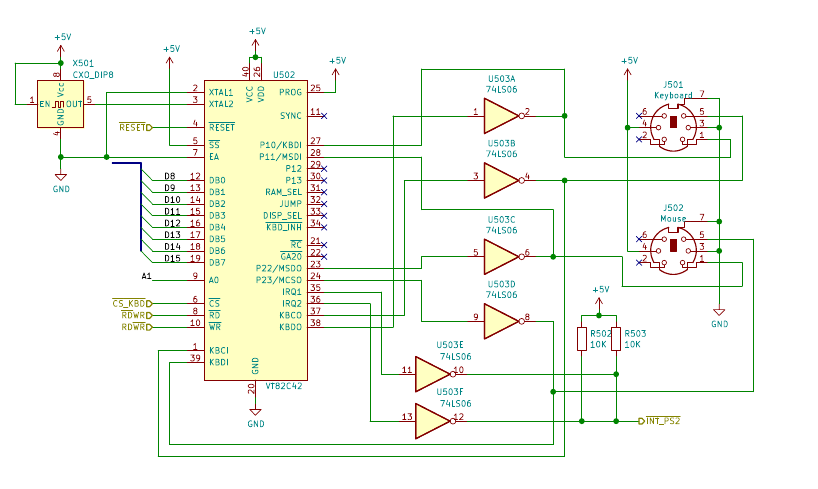
hardware/schematics/VT82C42N.png
