ppsilv/Orion68/software/dev/kernel/Docs/OrionOS.drawio.png

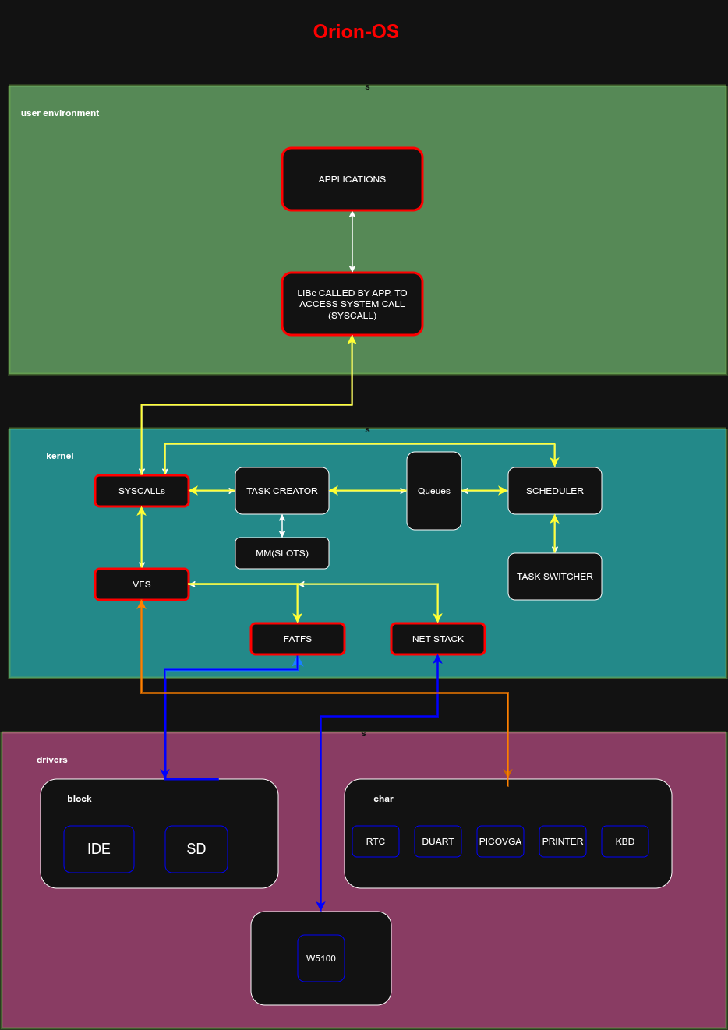
software/dev/kernel/Docs/OrionOS.drawio.png
