ppsilv/Orion68/docs/Manual/pds317.odt

### 1. Visão Geral do Sistema (Aplica o estilo: Título 1)

- 1.1. Introdução à Arquitetura PDS317 (Aplica o estilo: Título 2)
- 1.2. Barramento de Expansão e Backplane DIN 41612 (Estilo: Título 2)

### 2. Módulo CPU - PDS600 (Aplica o estilo: Título 1)

- 2.1. Especificações Técnicas e Processador MC68000 (Estilo: Título 2)
- 2.2. Subsistema de Clock e Sincronismo (Estilo: Título 2)
- 2.3. Lógica de Interrupção e Controle (ATmega8-16P) (Estilo: Título 2)
- 2.4. Circuito de Inicialização (Reset, Halt e MFT555) (Estilo: Título 2)
- 2.5. Configuração de Jumpers da CPU (Estilo: Título 2)

### 3. Módulo de Memória RAM - PDS100 (Aplica o estilo: Título 1)

- 3.1. Arquitetura do Barramento de 16-bits (HIGH / LOW) (Estilo: Título 2)
- 3.2. Dimensionamento das Trilhas de Alimentação (VCC/GND) (Estilo: Título 2) -> Pra deixar registrado o orgulho dos 0,5 mm!
- 3.3. Capacitores de Desacoplamento e Integridade de Sinal (Estilo: Título 2)

### 4. Mapa de Memória e Decodificação de Endereços (Aplica o estilo: Título 1)

- 4.1. Alocação de Espaço de Endereçamento do 68k (Estilo: Título 2)
- 4.2. Lógica de Boot e Espelhamento (Kickstart) (Estilo: Título 2)
- 4.3. Equações Lógicas dos Chips GAL (WinCUPL/GALasm) (Estilo: Título 2)

### 5. Subsistema de Comunicação Serial (Aplica o estilo: Título 1)

- 5.1. Interface UART 16C554 (Estilo: Título 2)
- 5.2. Configuração de Taxa de Transmissão (115200 Baud) (Estilo: Título 2)
