ppsilv/Orion68/hardware/schematics/yddraig-schematic.pdf

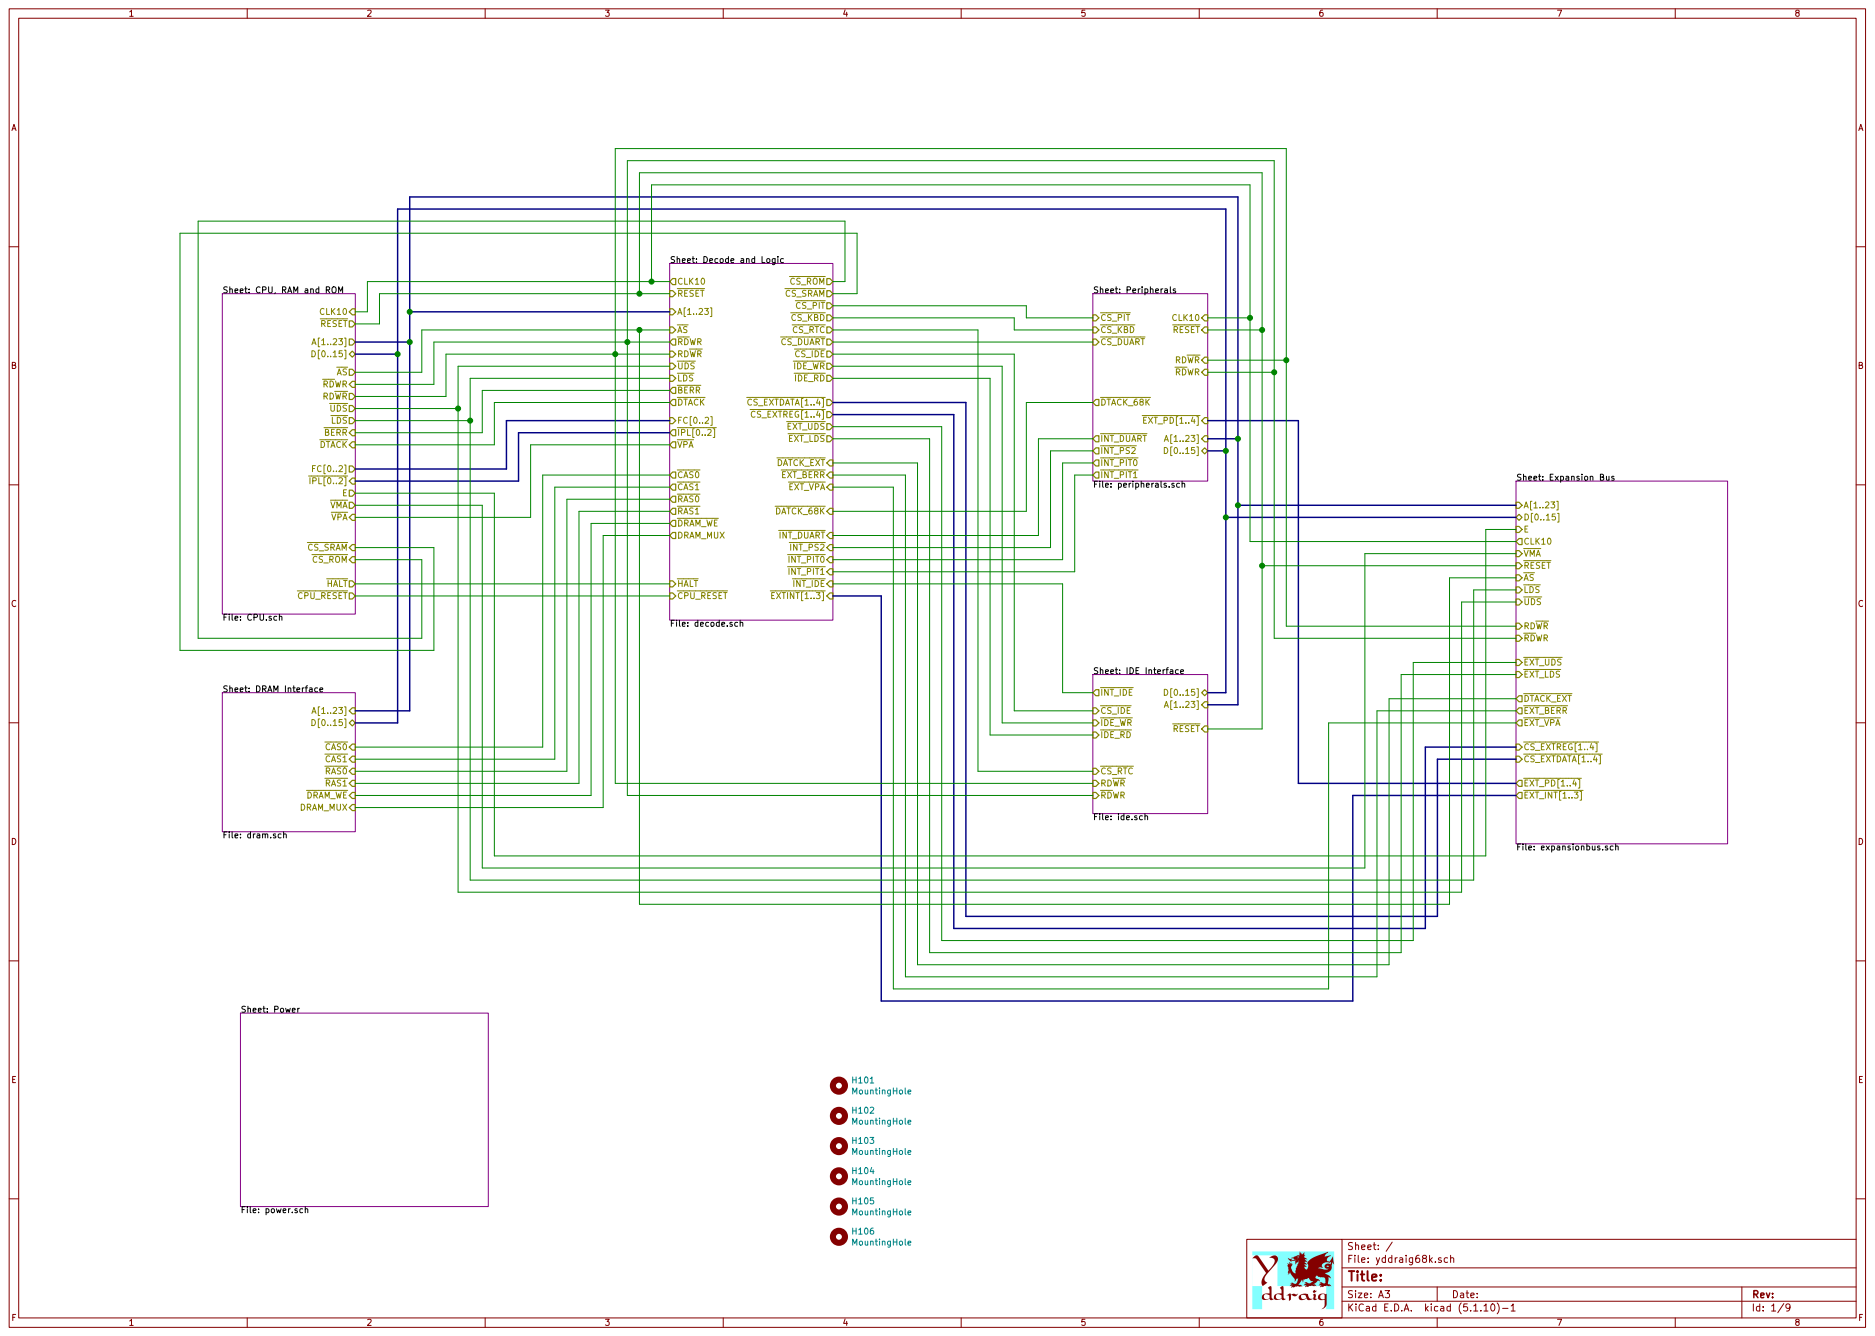
[picture p107: page 1]

Sheet: Decode and Logic File: decode.sch CLK10 RESET A[1..23] ASRDWR

Sheet: CPU, RAM and ROM
CLK10 VPA RESET CS_SRAM
DTACK HALT CPU_RESET RDWR
LDS RDWR

Sheet: Expansion Bus
A[1..23] VMA
File: expansionbus.sch DTACK_EXT D[0..15] CLK10 RESET AS
EXT_VPA E

INT_PIT1 Sheet: Power File: power.sch

H106 MountingHole H105 MountingHole H104 MountingHole H103 MountingHole H102 MountingHole H101 MountingHole

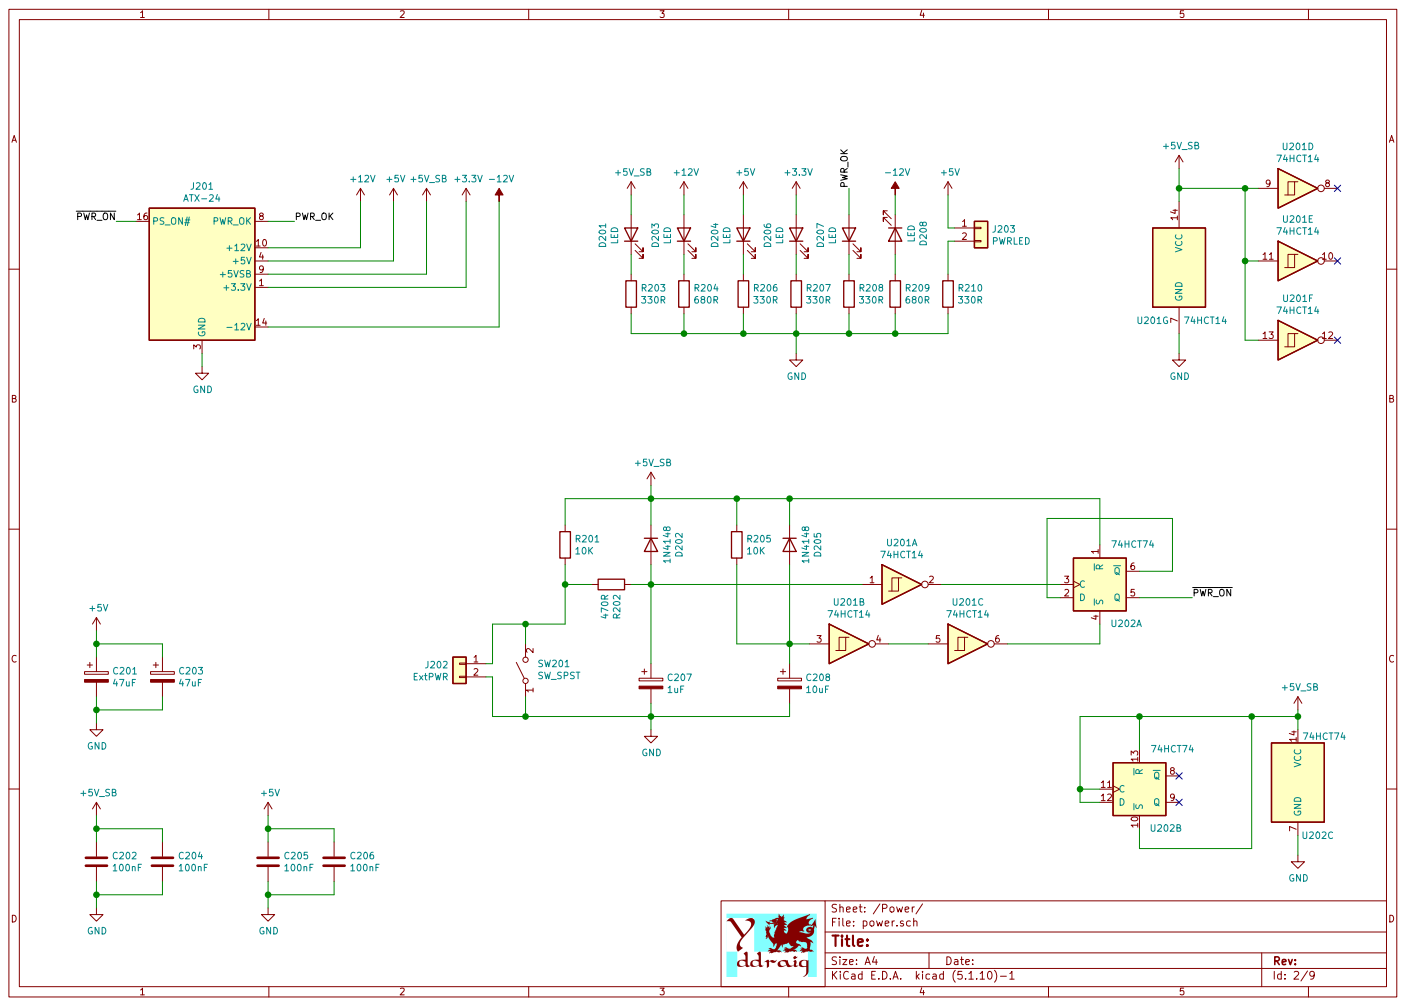
[picture p108: page 2]

File: power.sch Sheet: /Power/
Id: 2/9 Title:

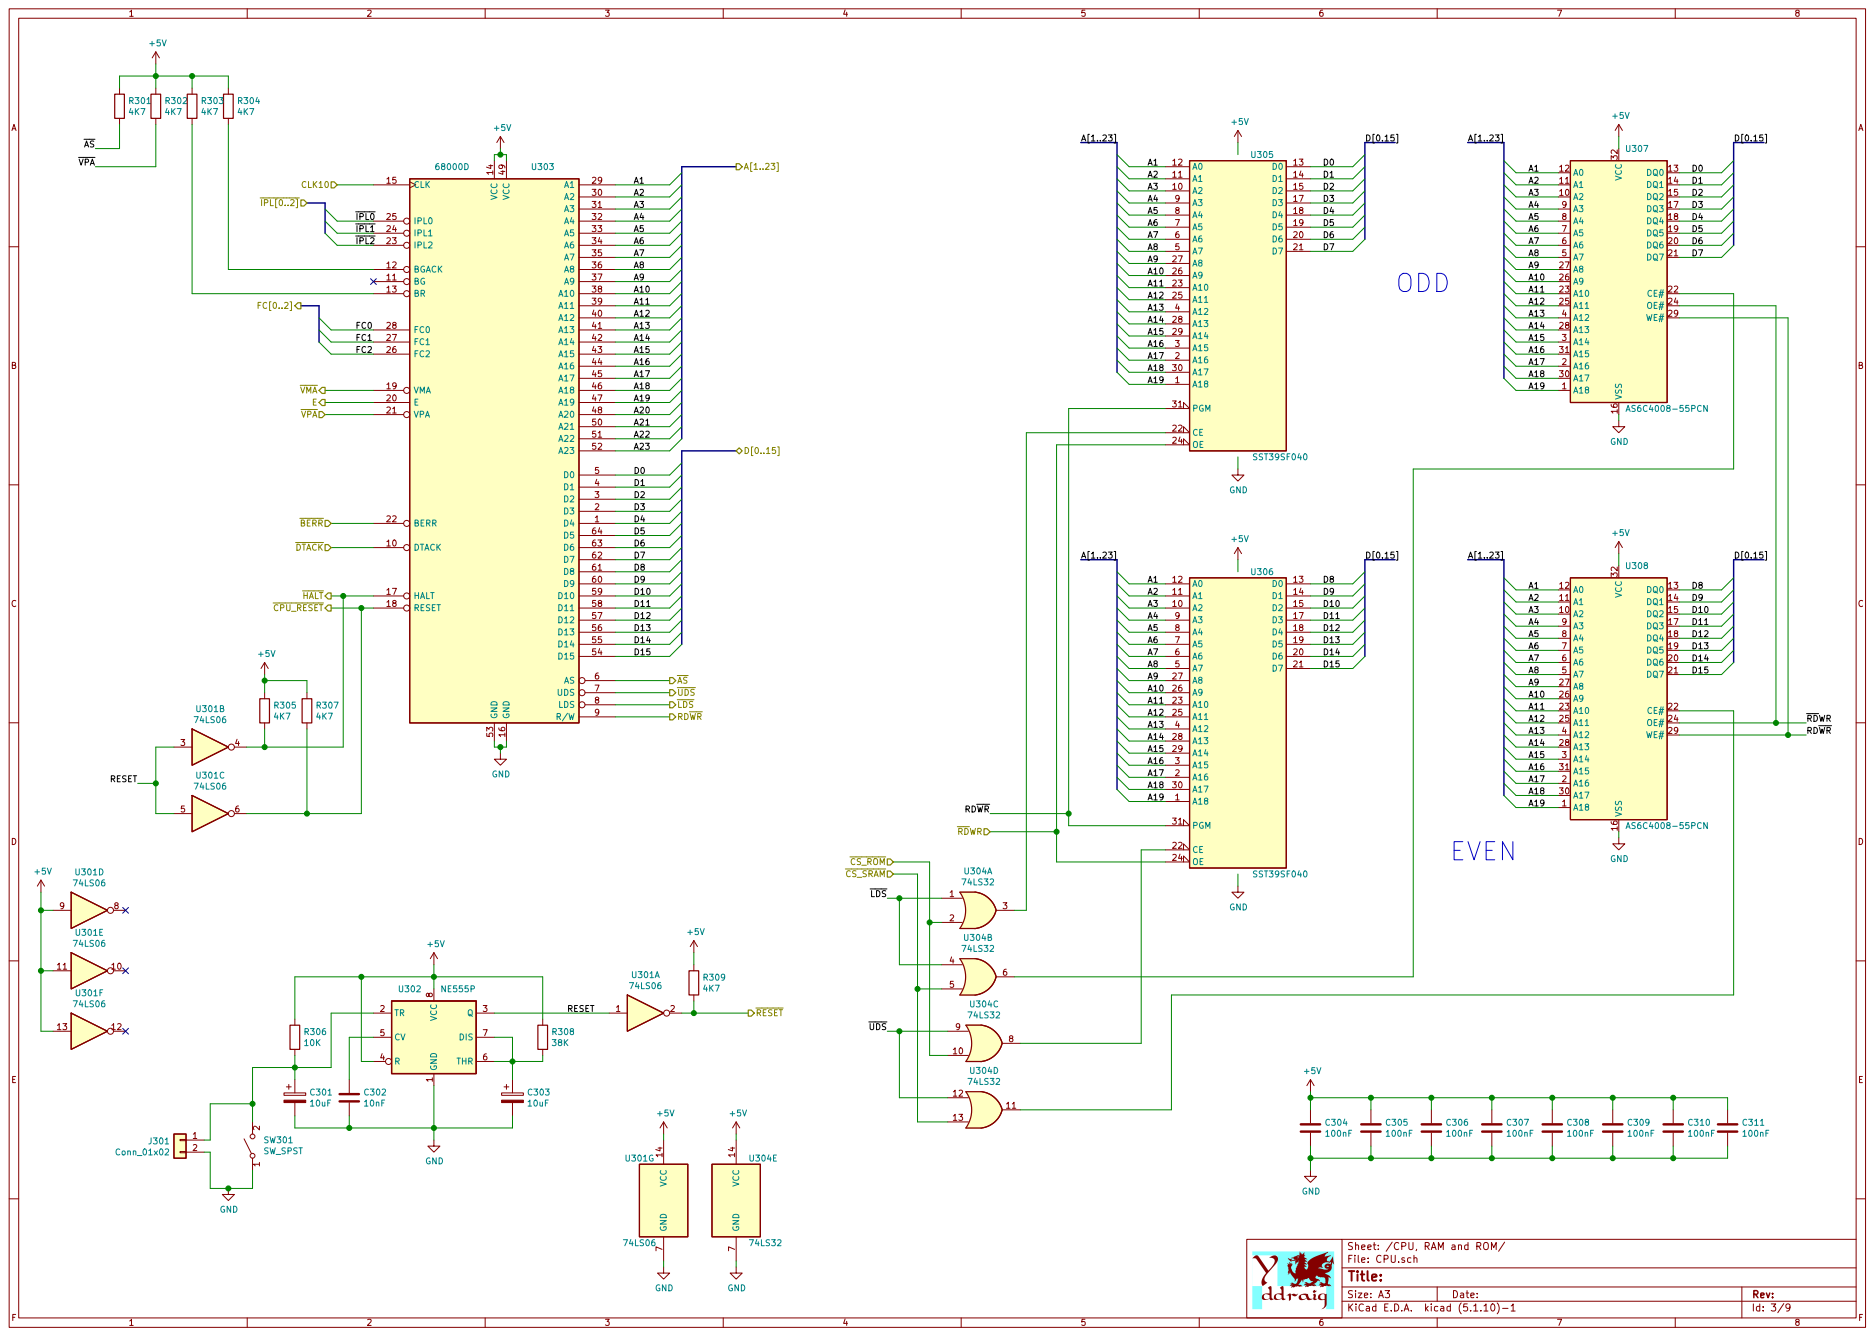
[picture p109: page 3]

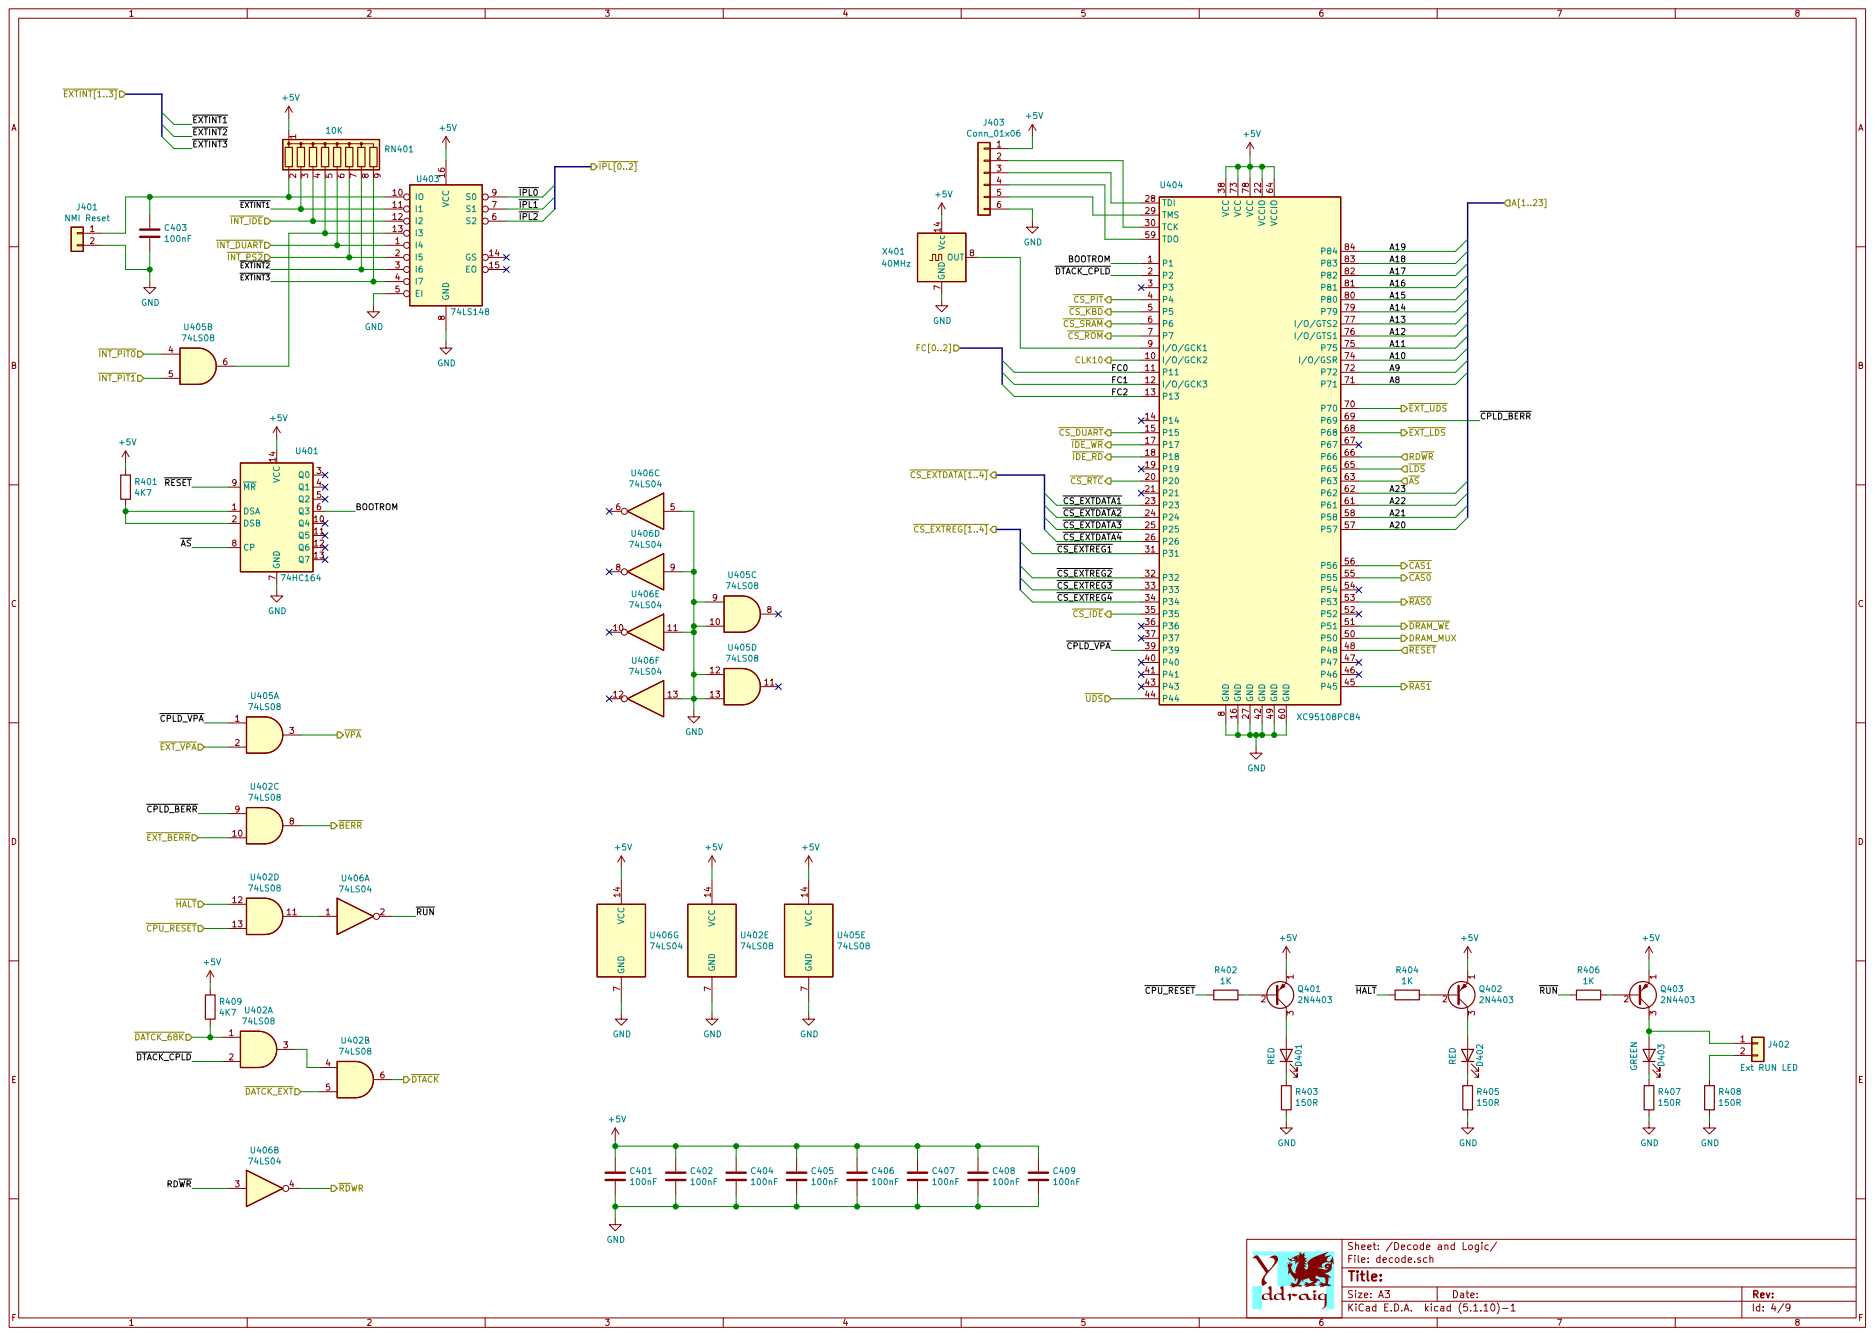
[picture p110: page 4]

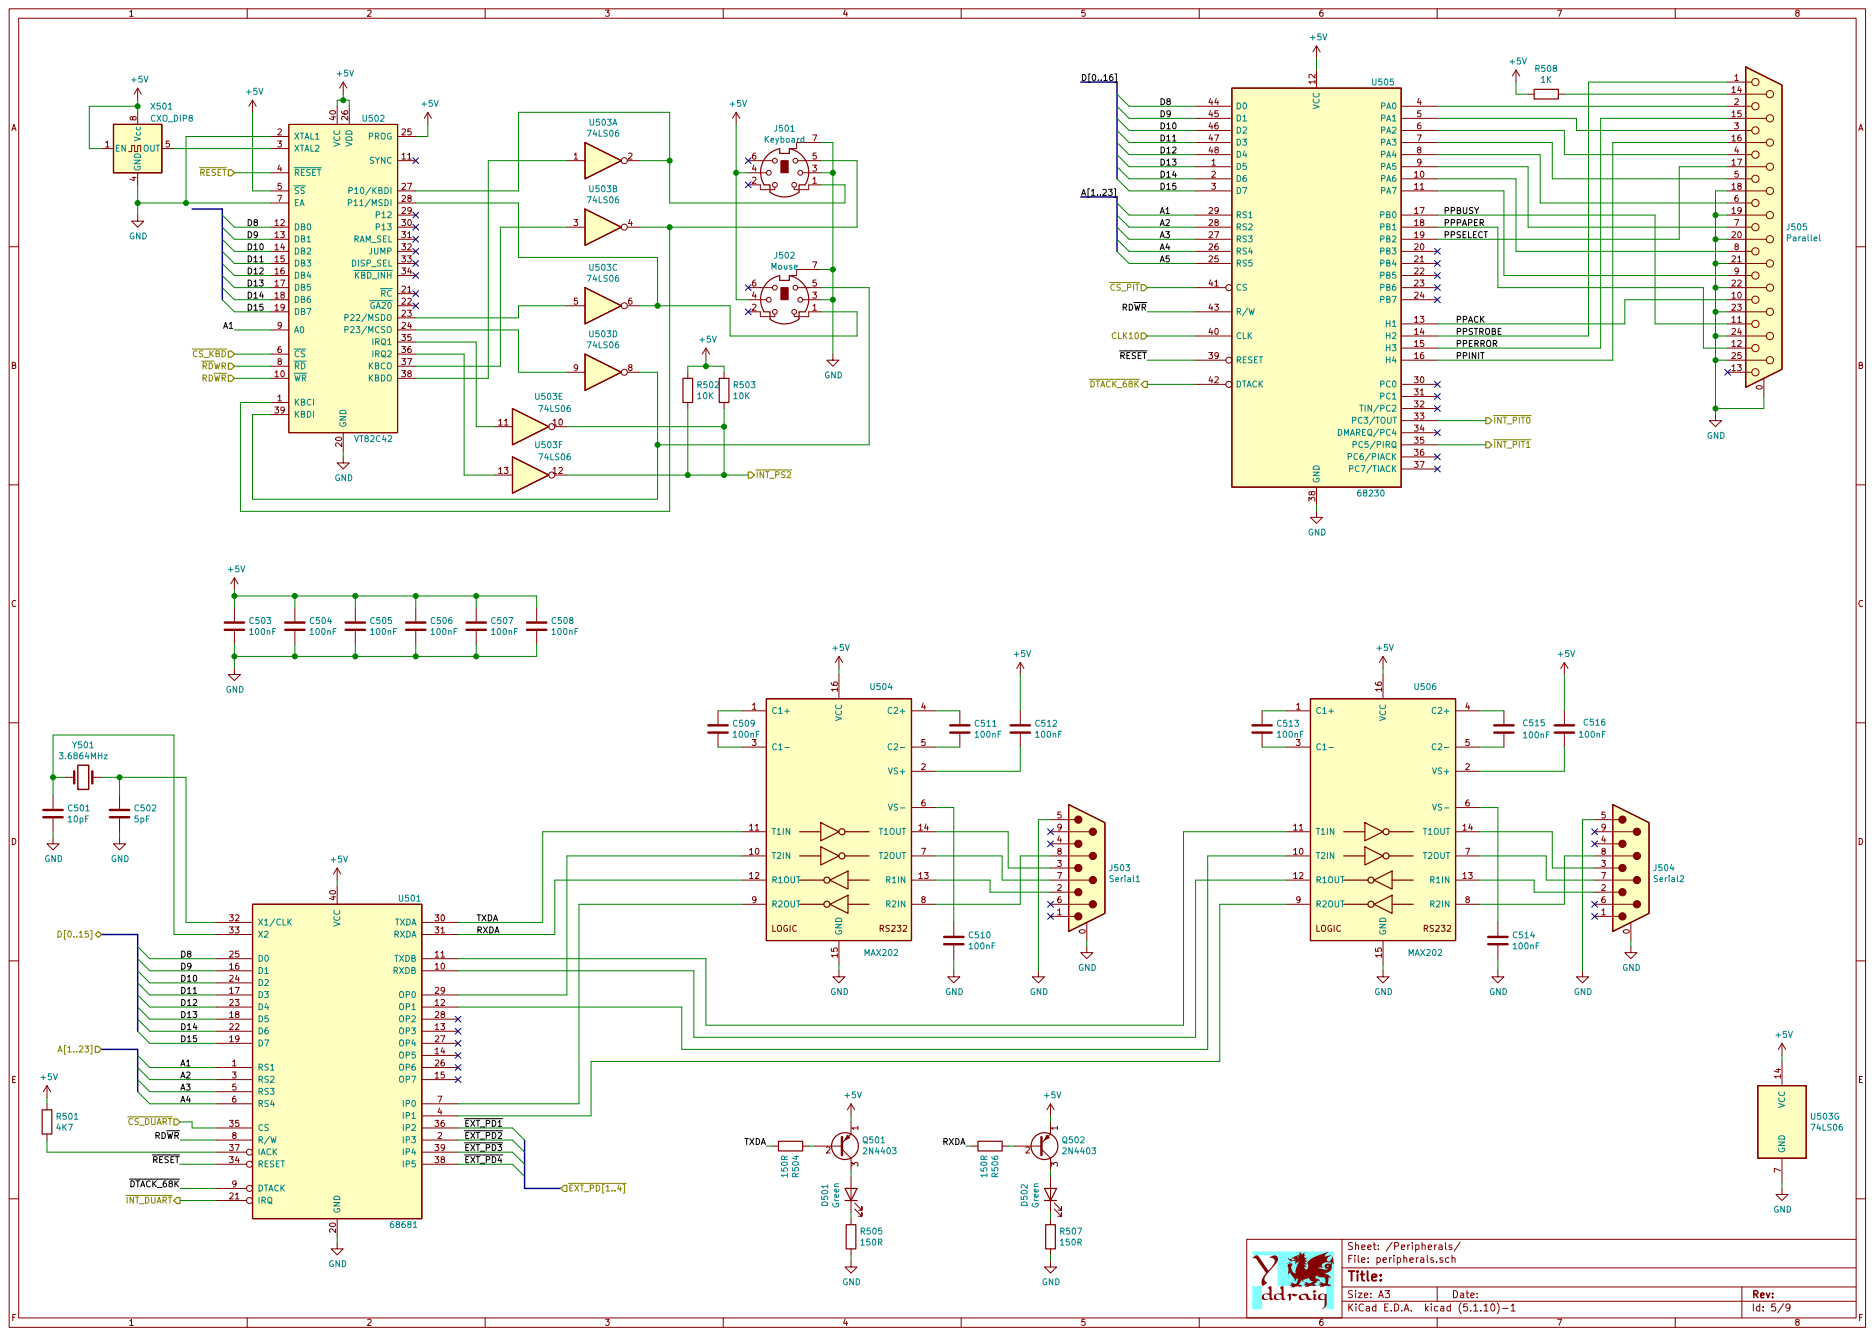
[picture p111: page 5]

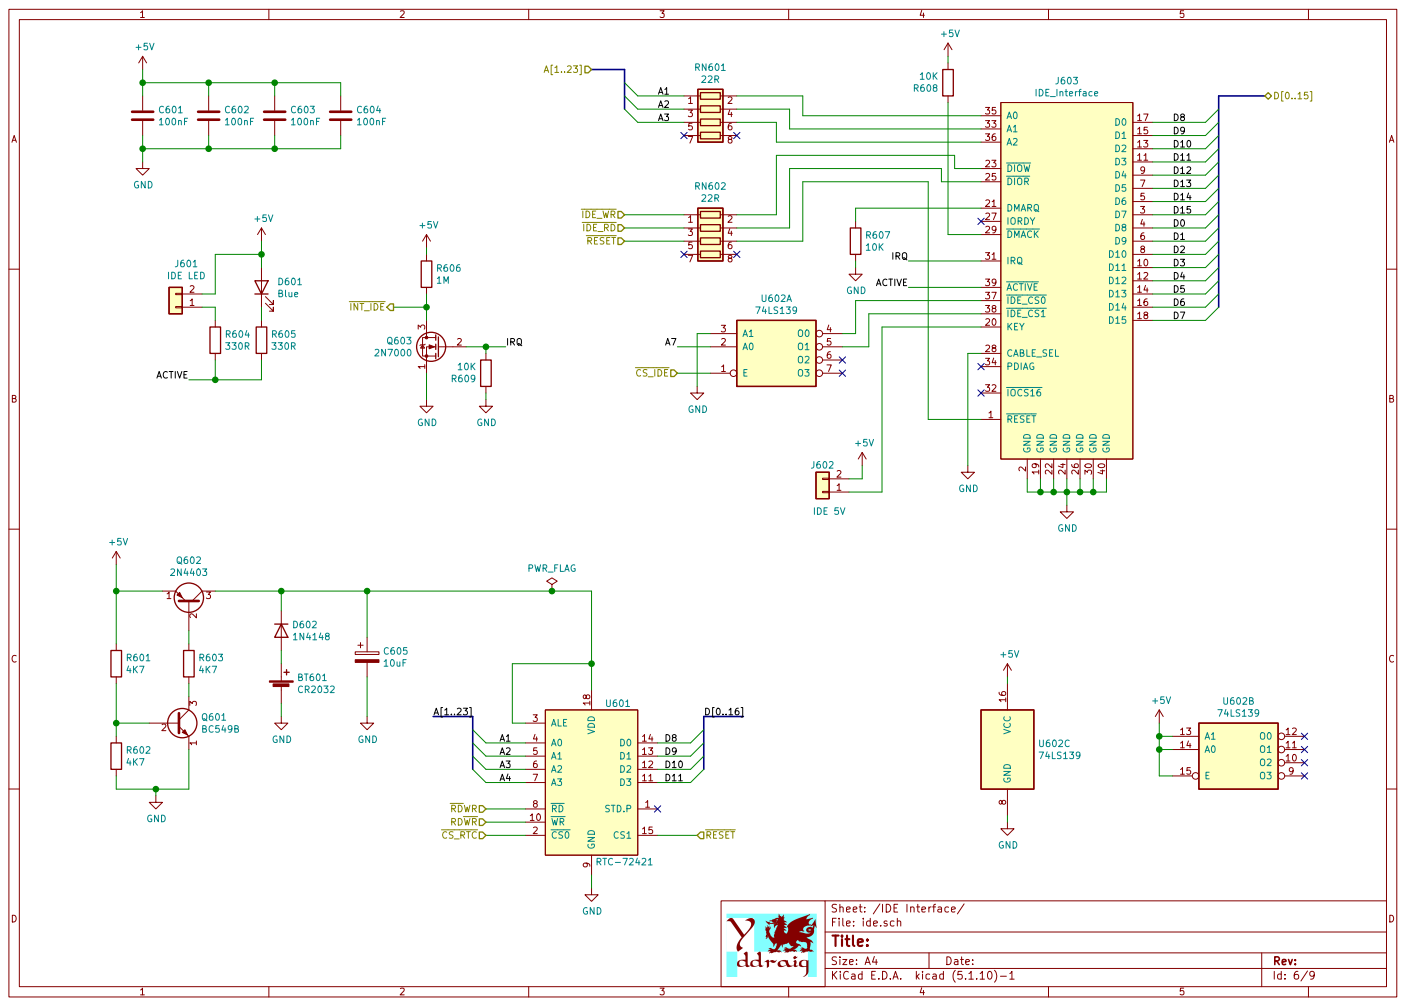
[picture p112: page 6]

2 KEY 20 DMARQ 21 GND 22 DIOW 23 GND 24 DIOR 25 GND 26

Id: 6/9 Title: File: ide.sch Sheet: /IDE Interface/ GND

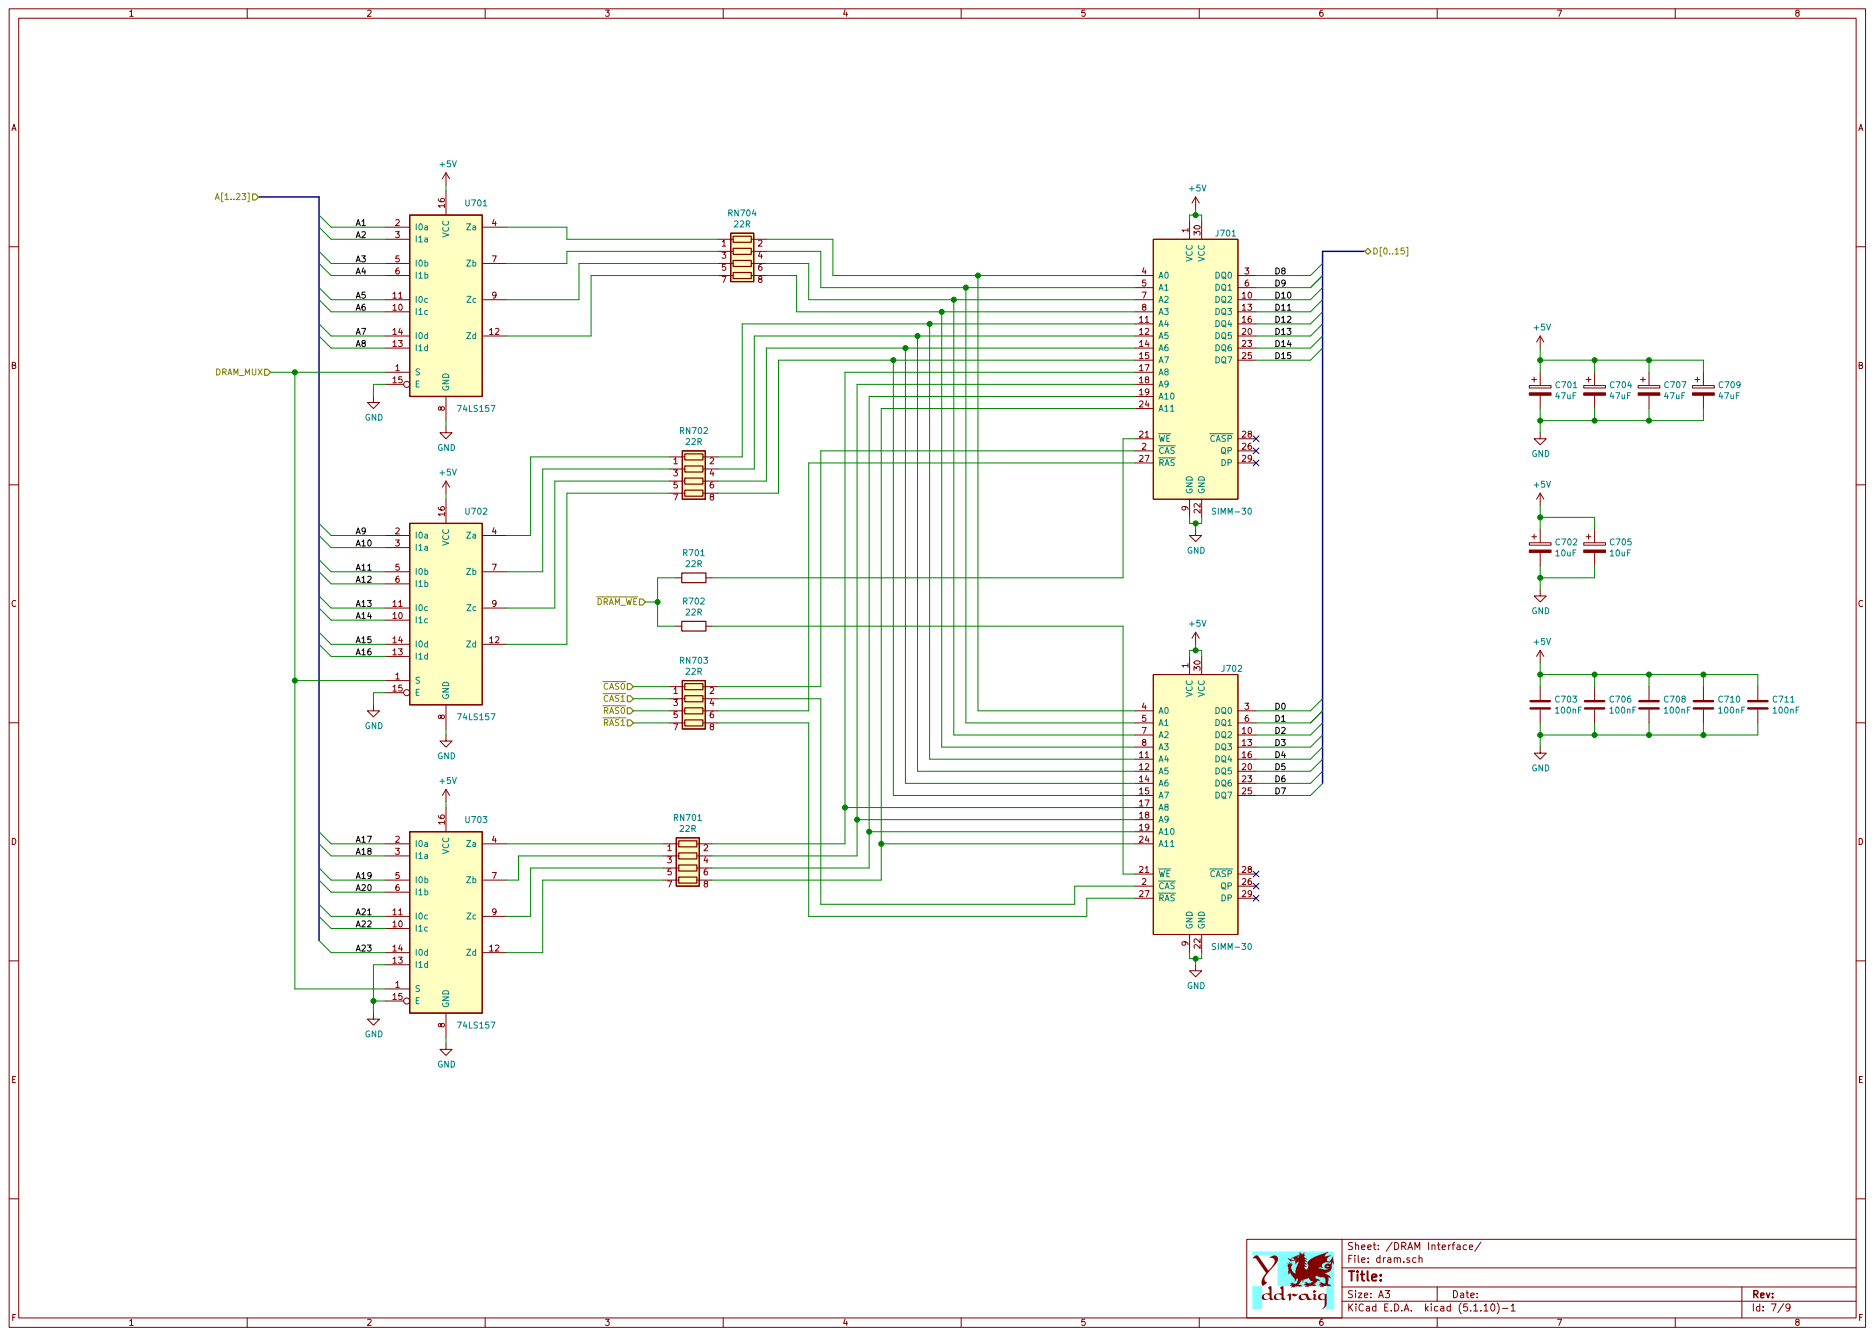
[picture p113: page 7]

Id: 7/9 Title: File: dram.sch Sheet: /DRAM Interface/ S 1

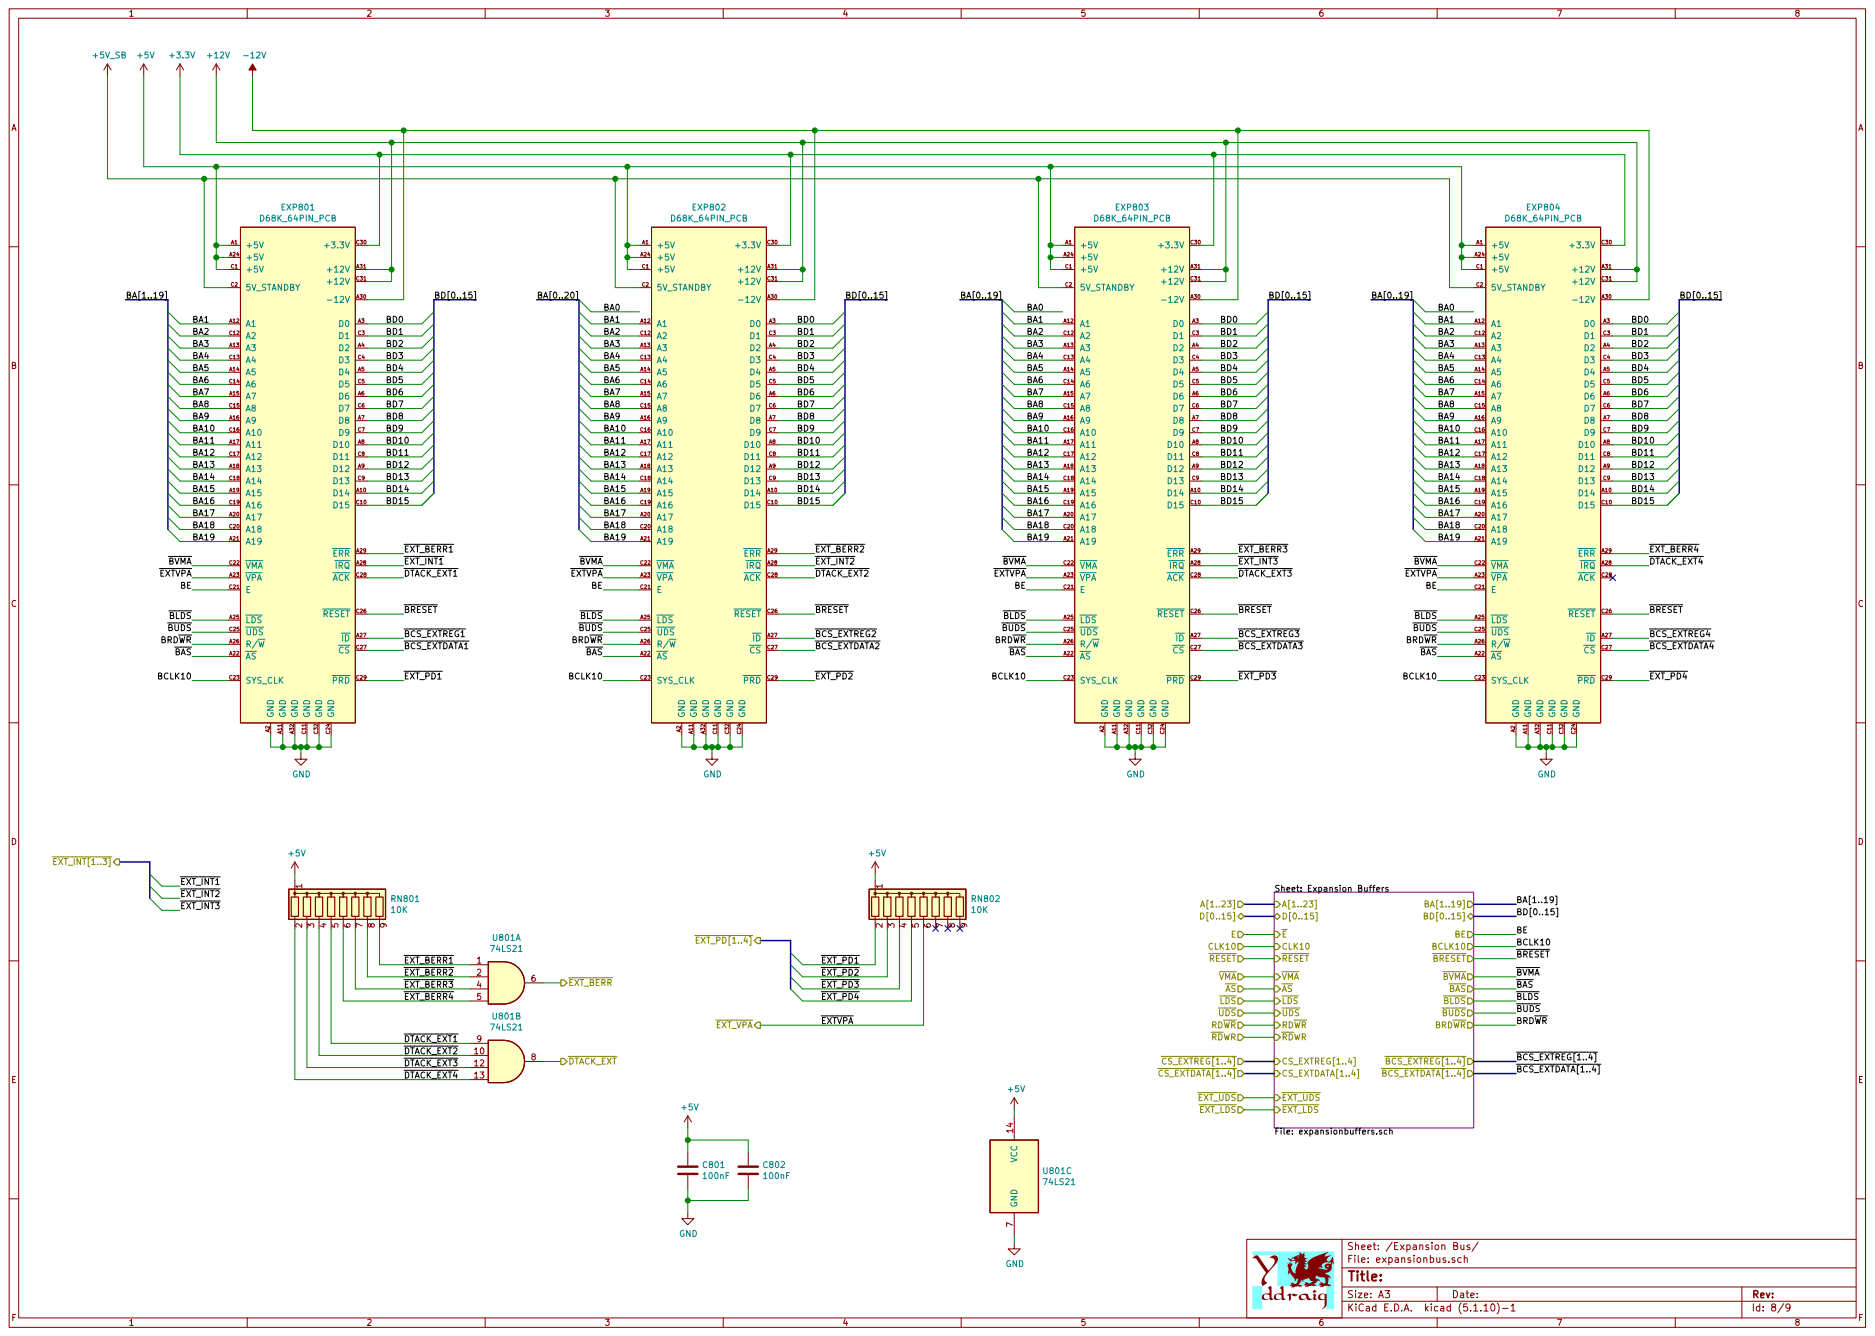
[picture p114: page 8]

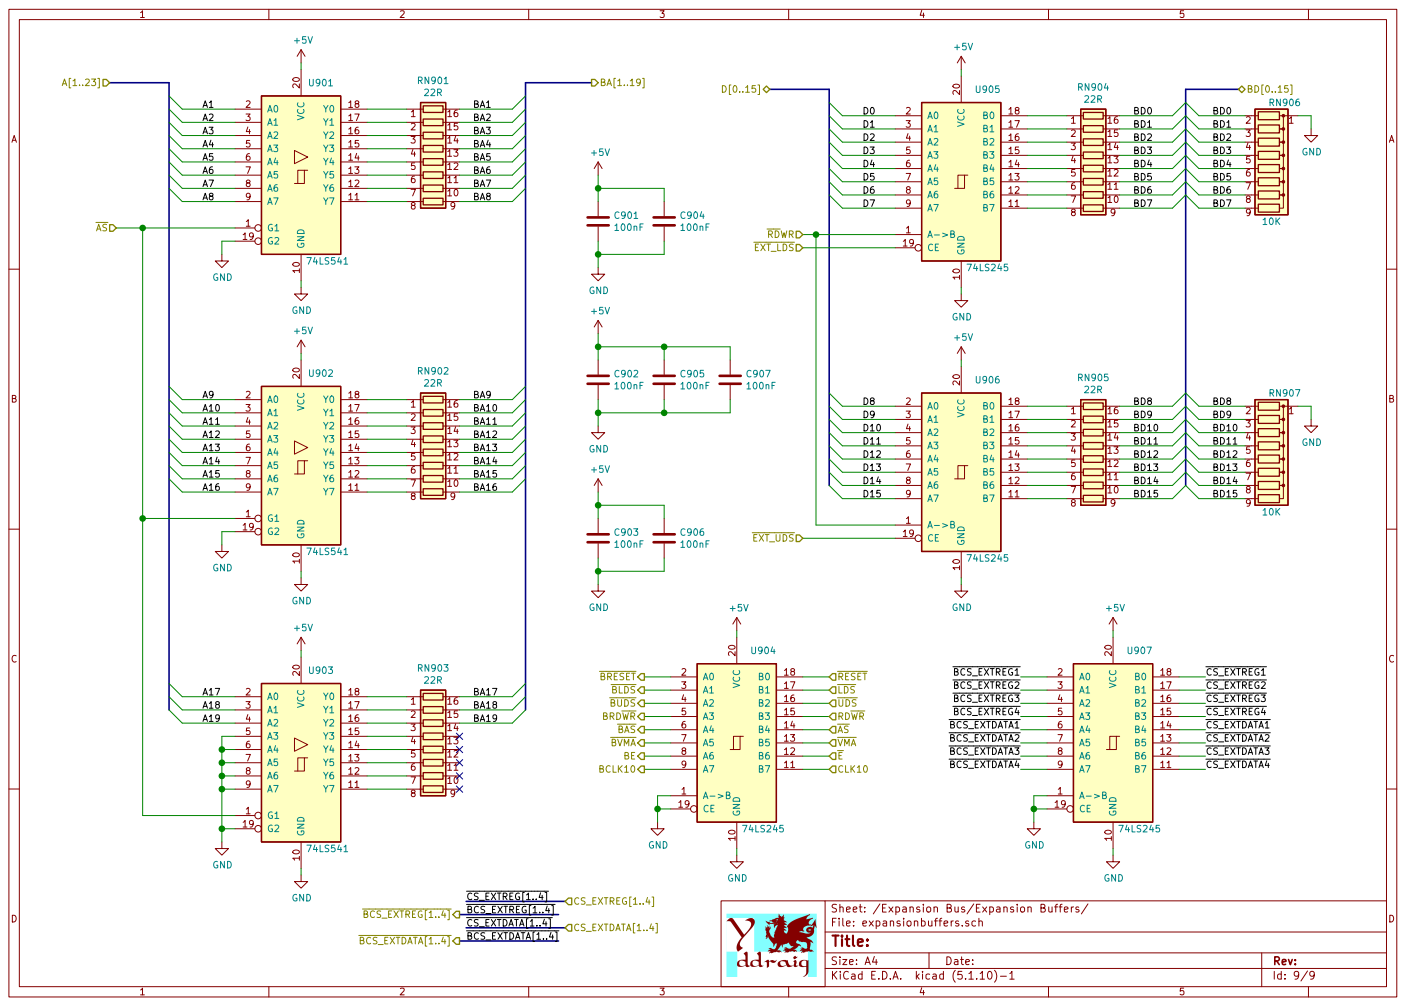
[picture p115: page 9]
