ppsilv/Orion68/docs/CH9350EVT/EVT/CH9350SCH.PDF

# LED

CH9350

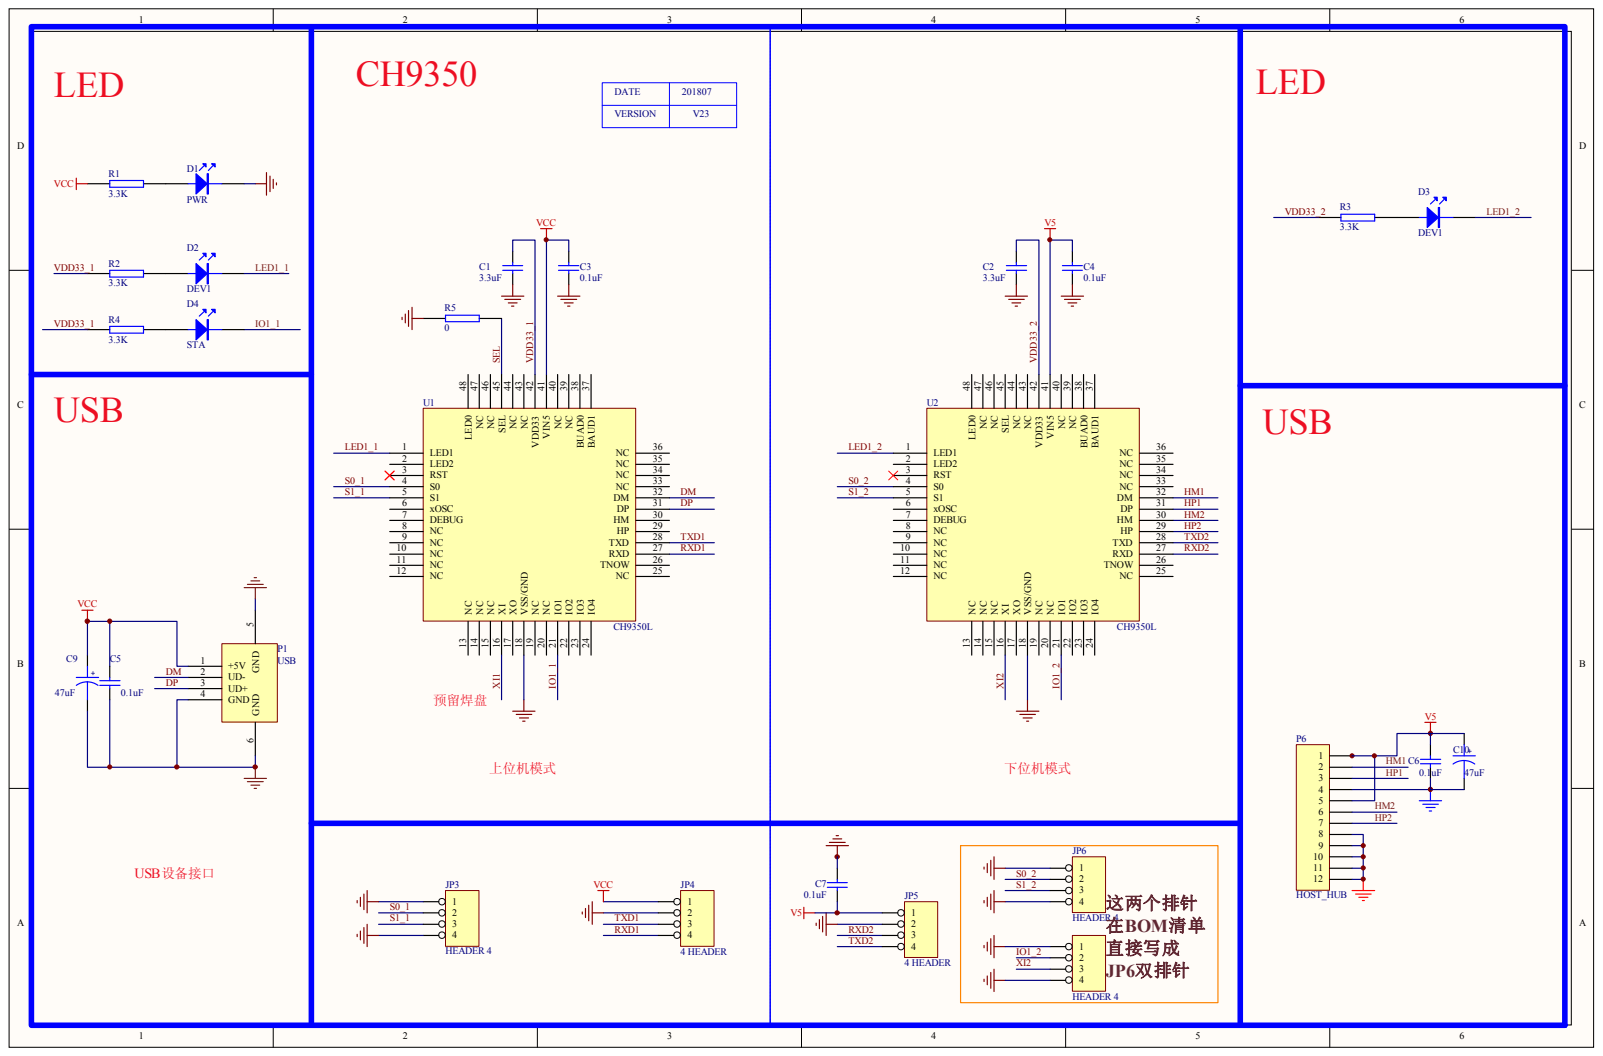
[picture p116: page 1]
