ppsilv/Orion68/software/dev/kernel/Docs/OrionOS.drawio.pdf

# Orion-OS

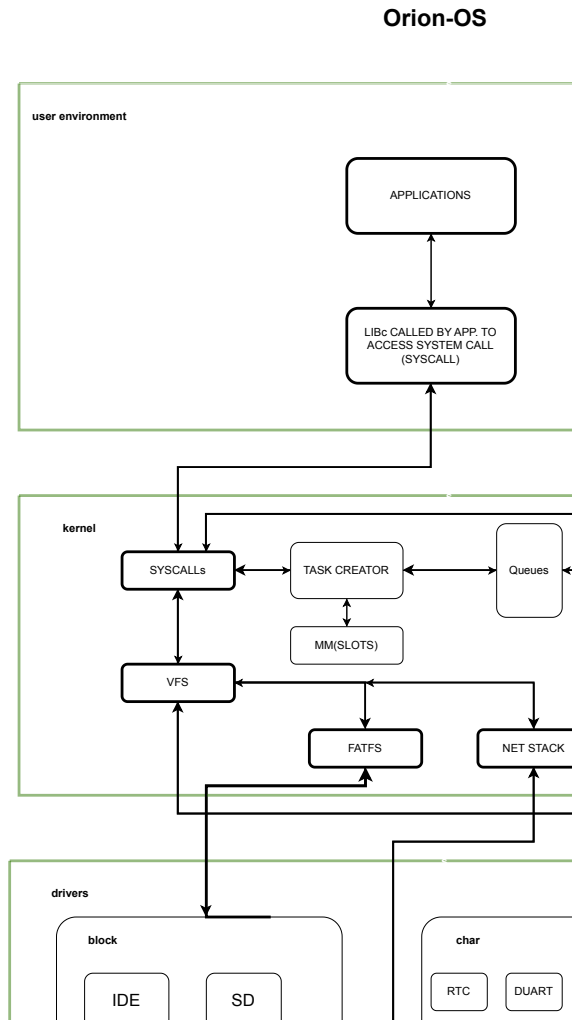
[picture p117: page 3]
drivers; block; IDE; RTC; DUART; char; kernel; SYSCALLs; VFS; MM(SLOTS); TASK CREATOR; Queues; user environment; APPLICATIONS; FATFS; NET STACK

LIBc CALLED BY APP. TO
ACCESS SYSTEM CALL
(SYSCALL)

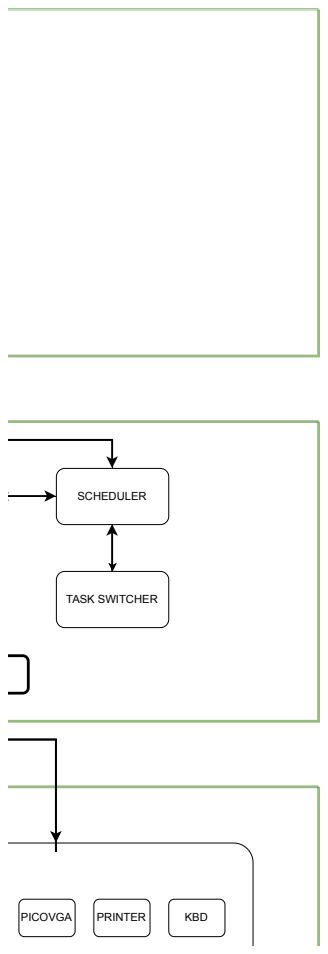
[picture p118: page 4]
PICOVGA; PRINTER; KBD; SCHEDULER; TASK SWITCHER

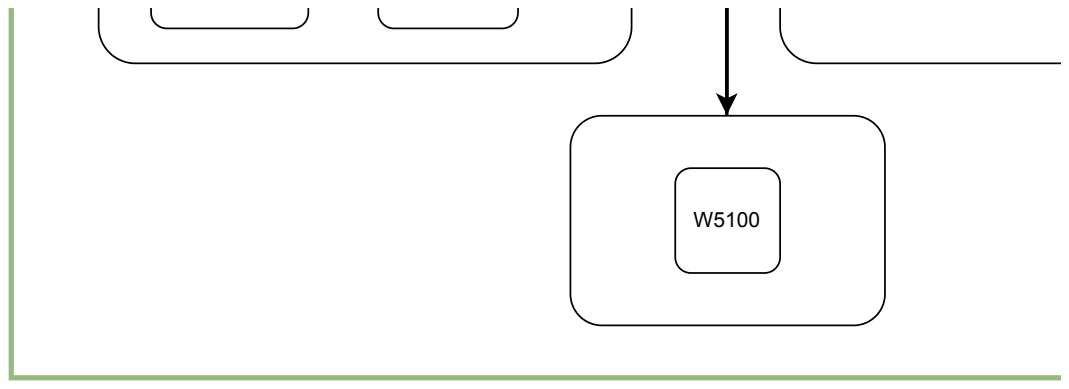
[picture p119: page 5]

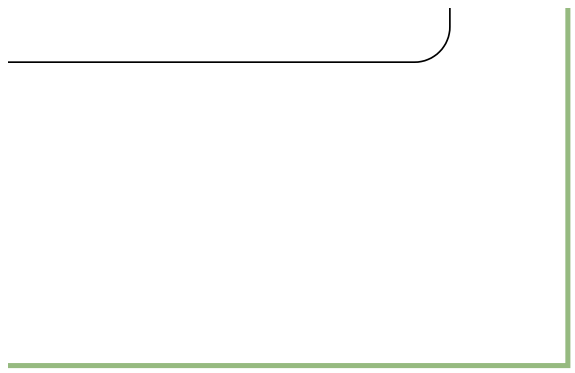
[picture p120: figure]
