ppsilv/Orion68/hardware/schematics/100_mem.pdf

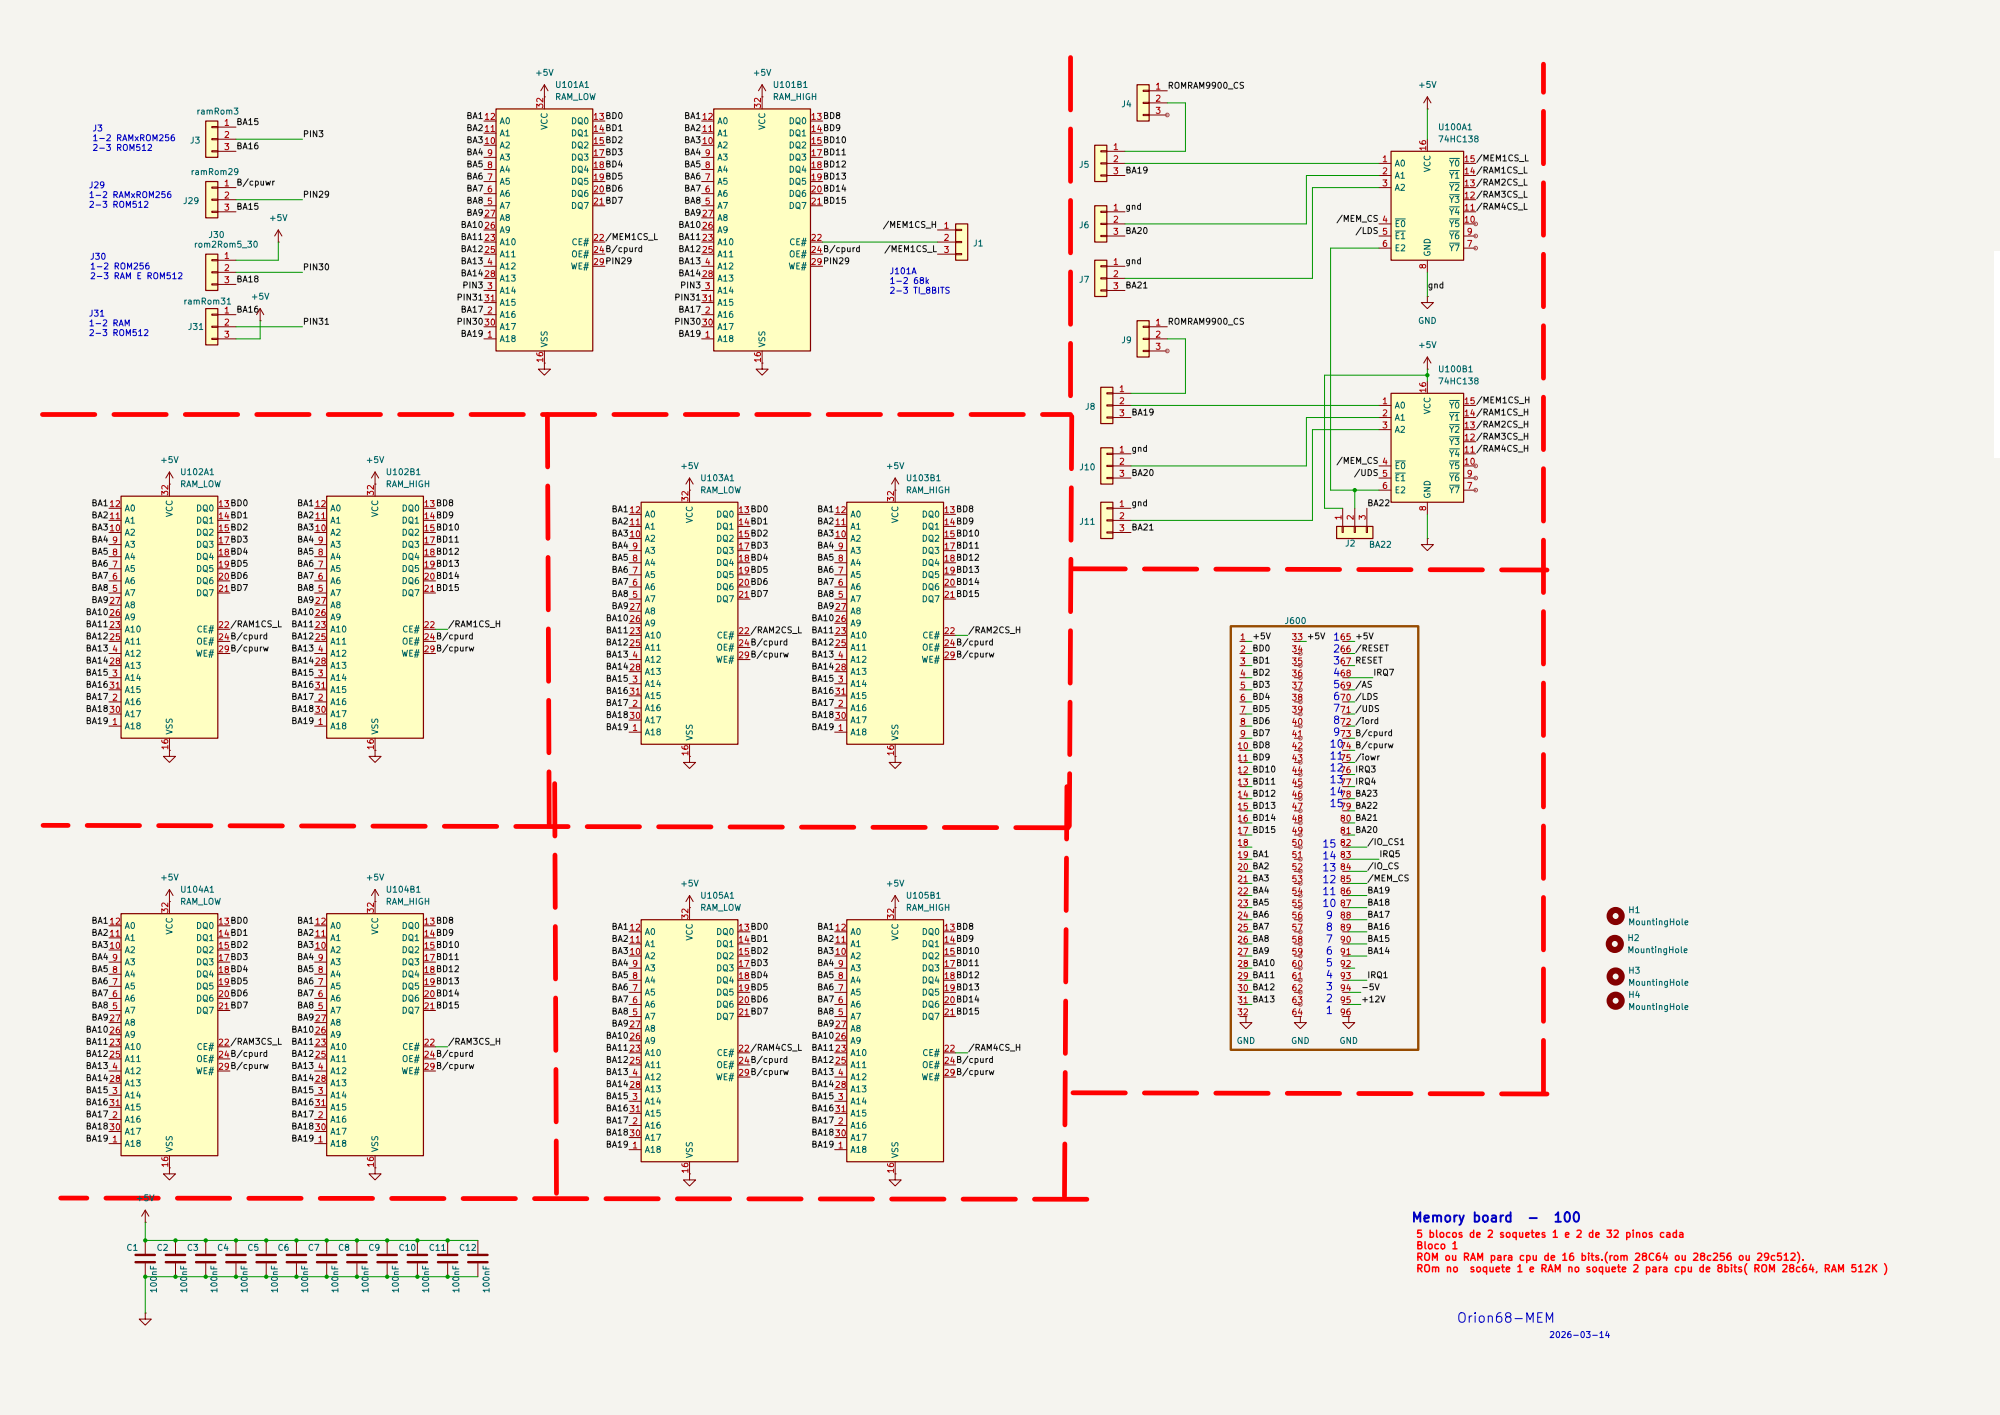
[picture p121: page 1]
