ppsilv/Orion68/hardware/schematics/600_cpu.pdf

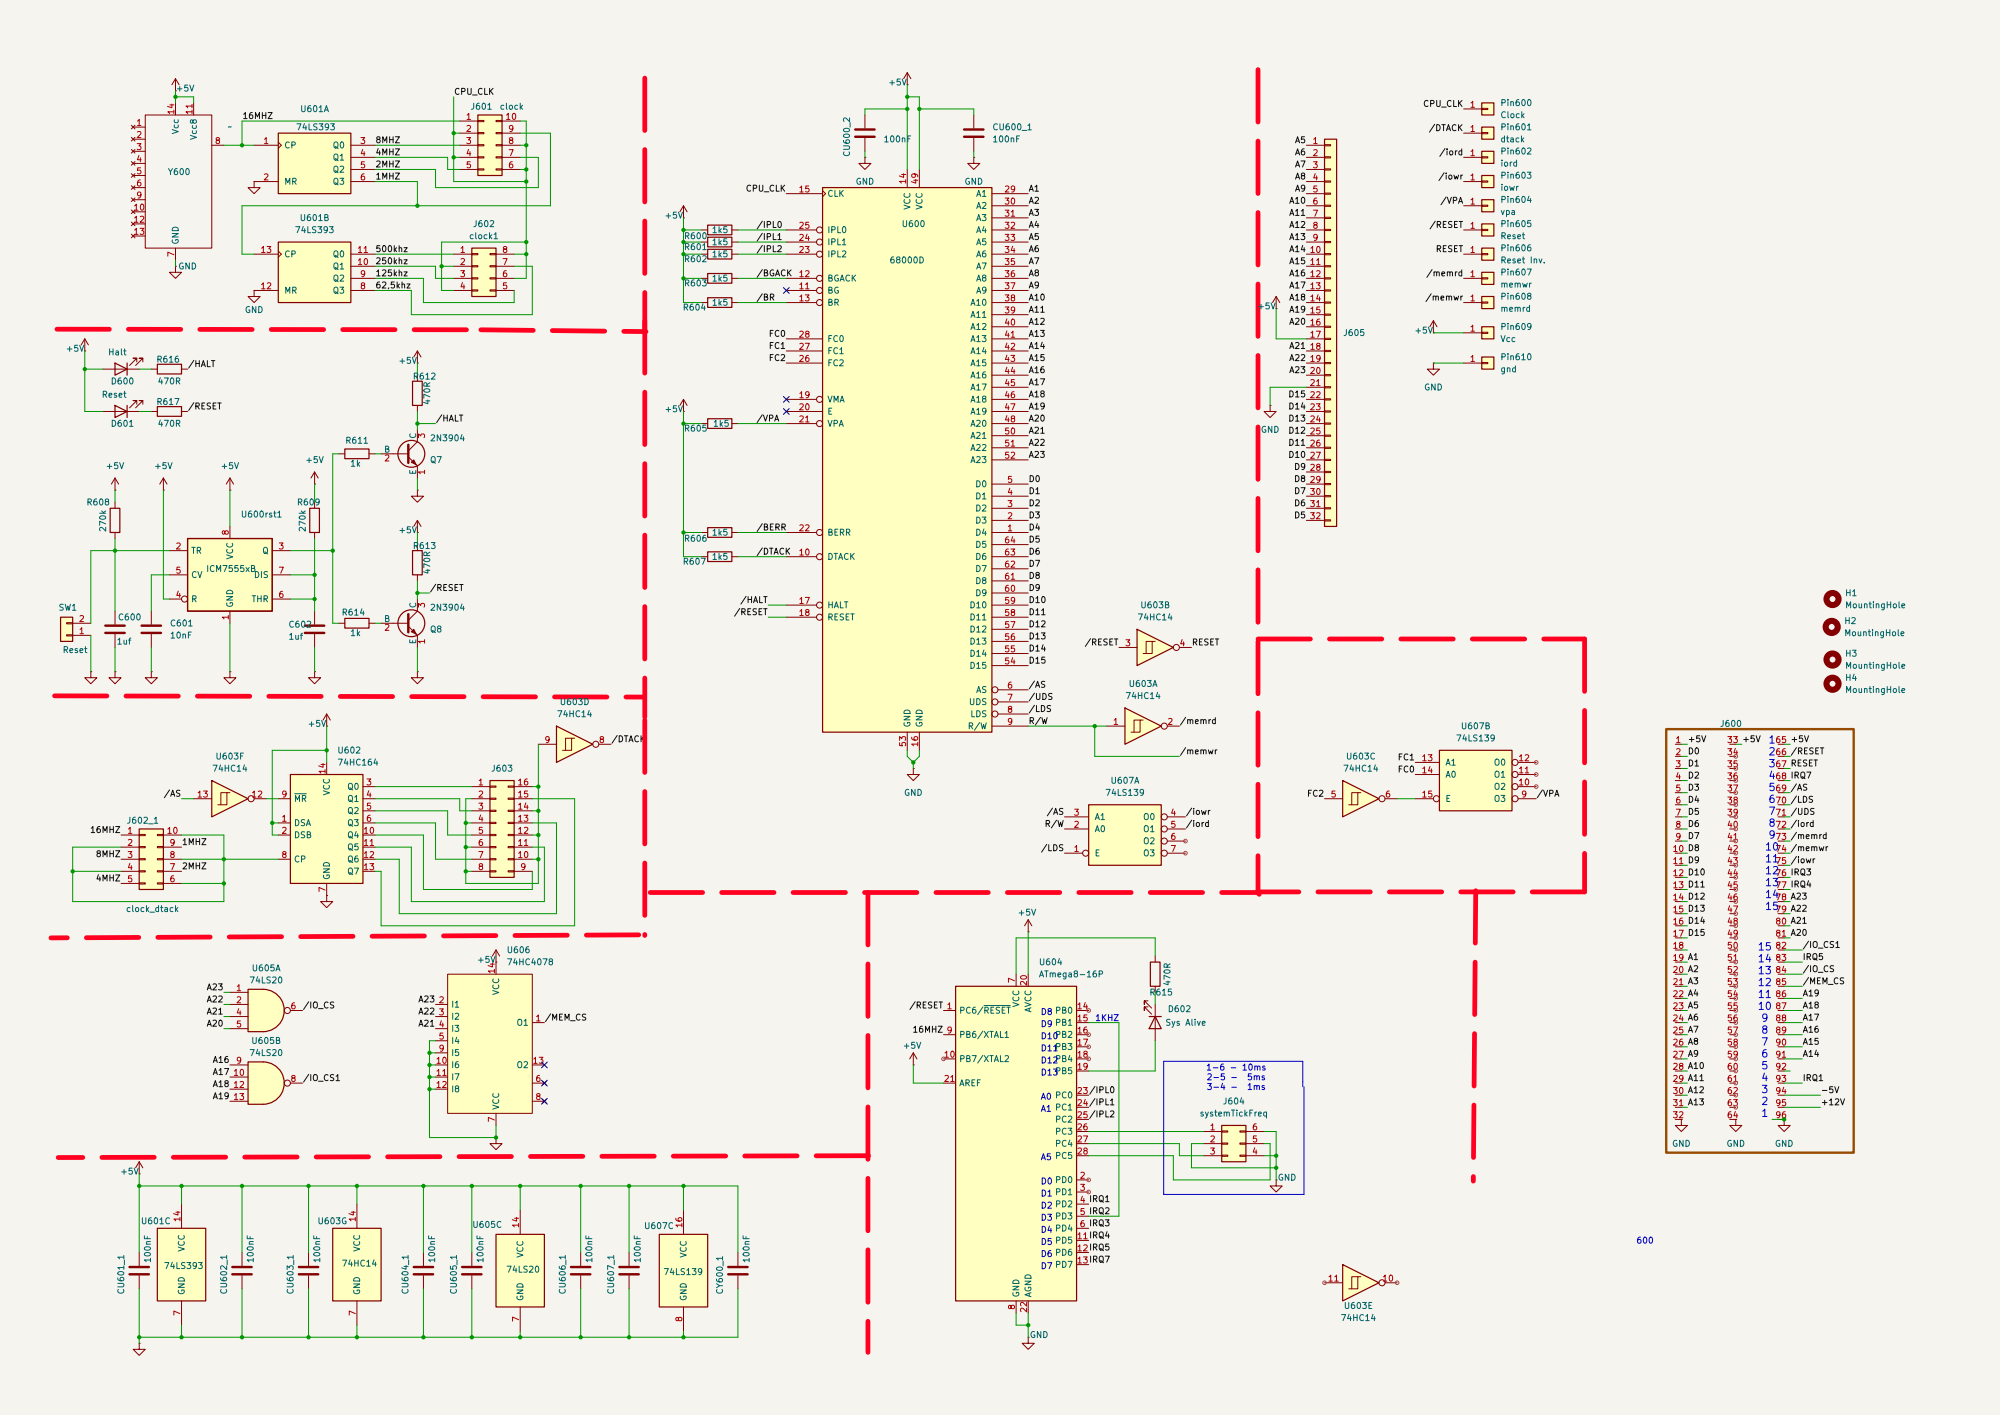
[picture p122: page 1]
