ppsilv/Orion68/hardware/schematics/600_cpu_board_Bot.pdf

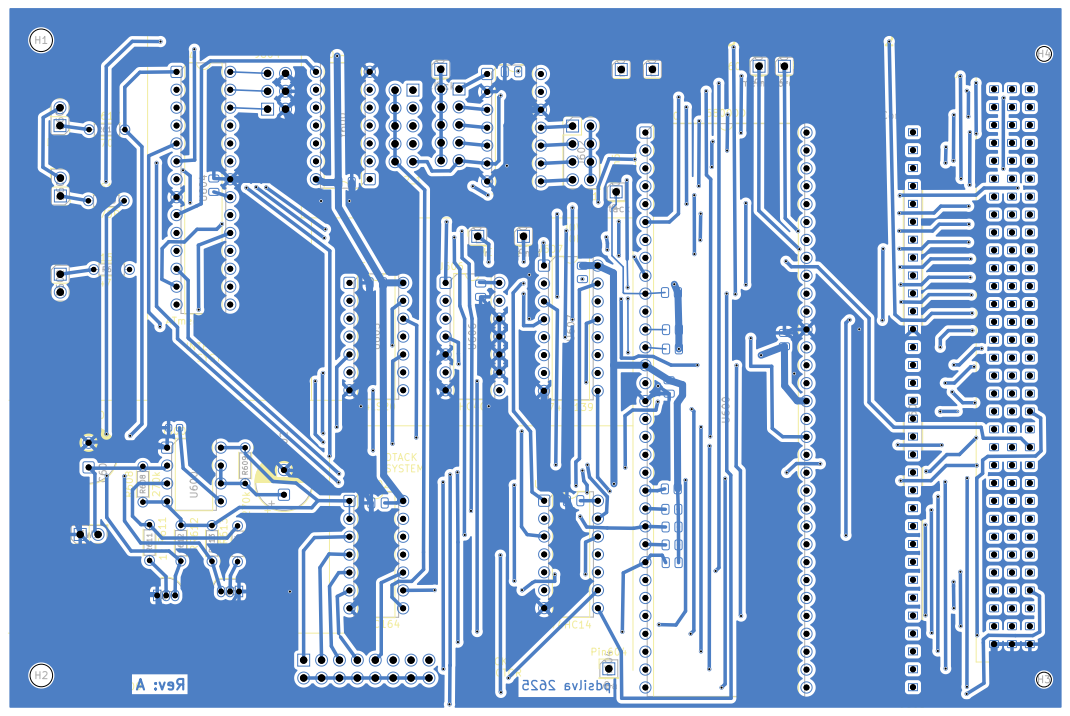
[picture p123: page 1]
