ppsilv/Orion68/hardware/schematics/600_cpu_board_Top.pdf

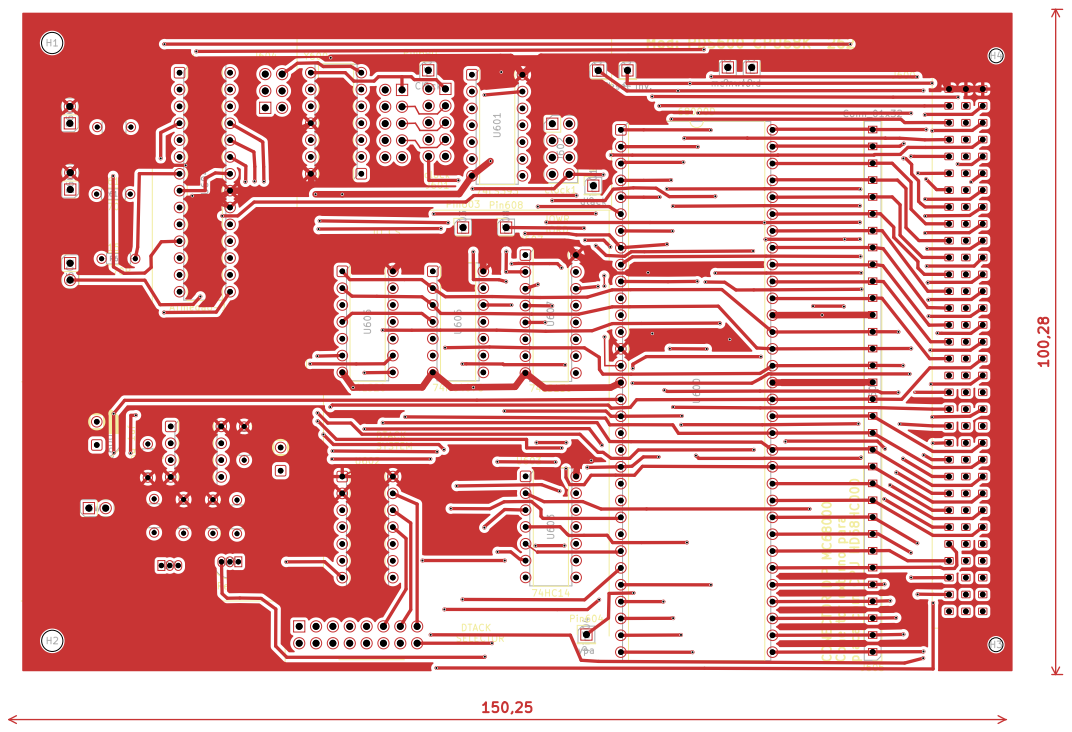
[picture p124: page 1]
