ppsilv/Orion68/hardware/schematics/orion68.pdf

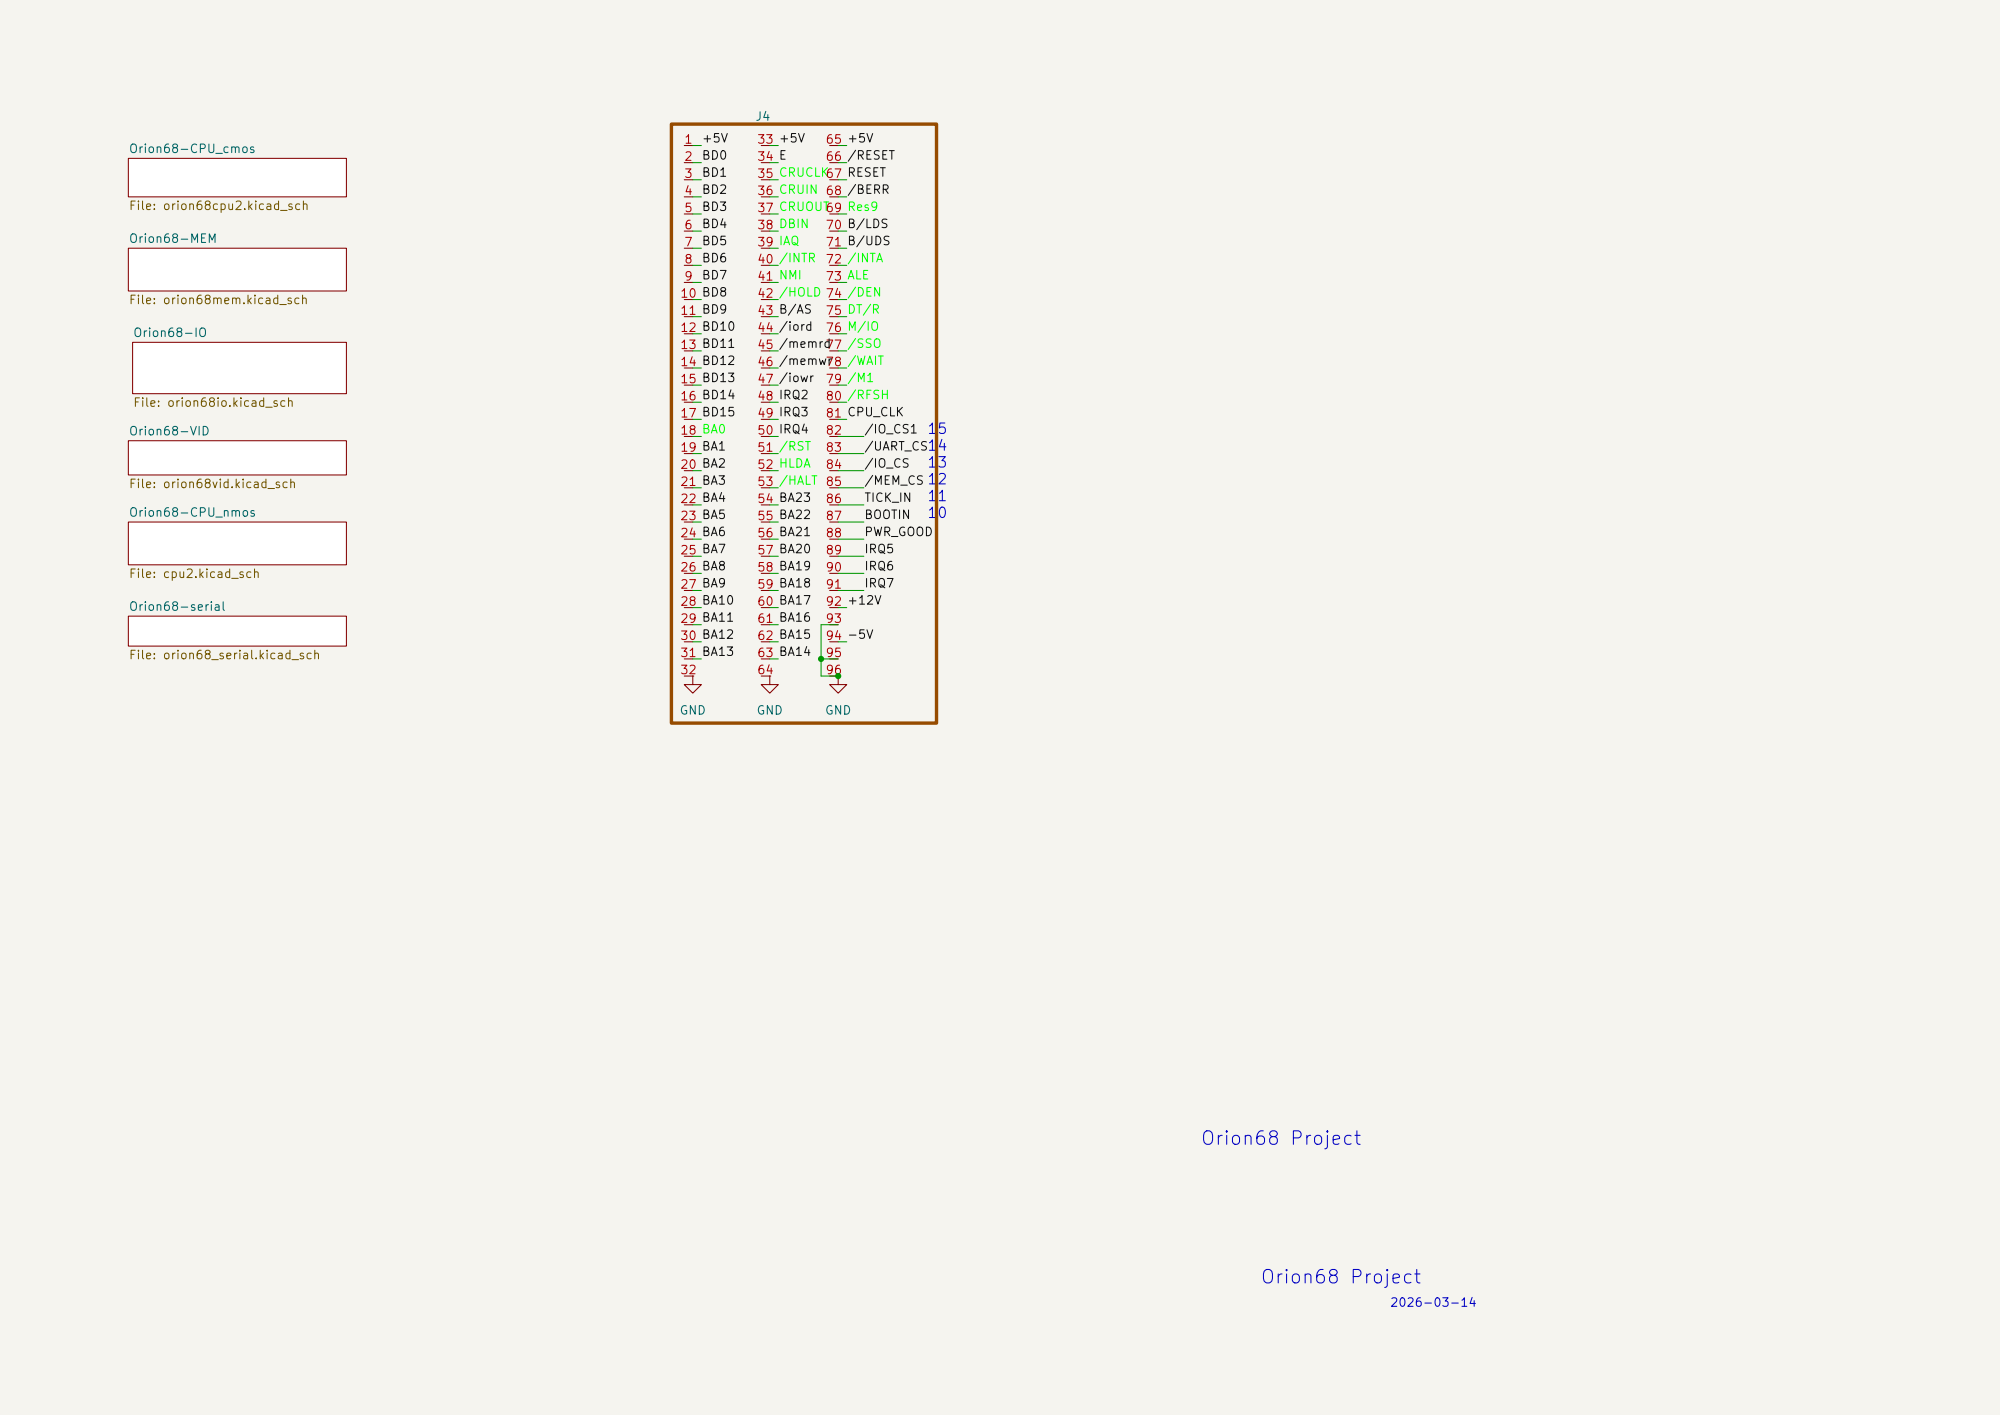
[picture p125: page 1]

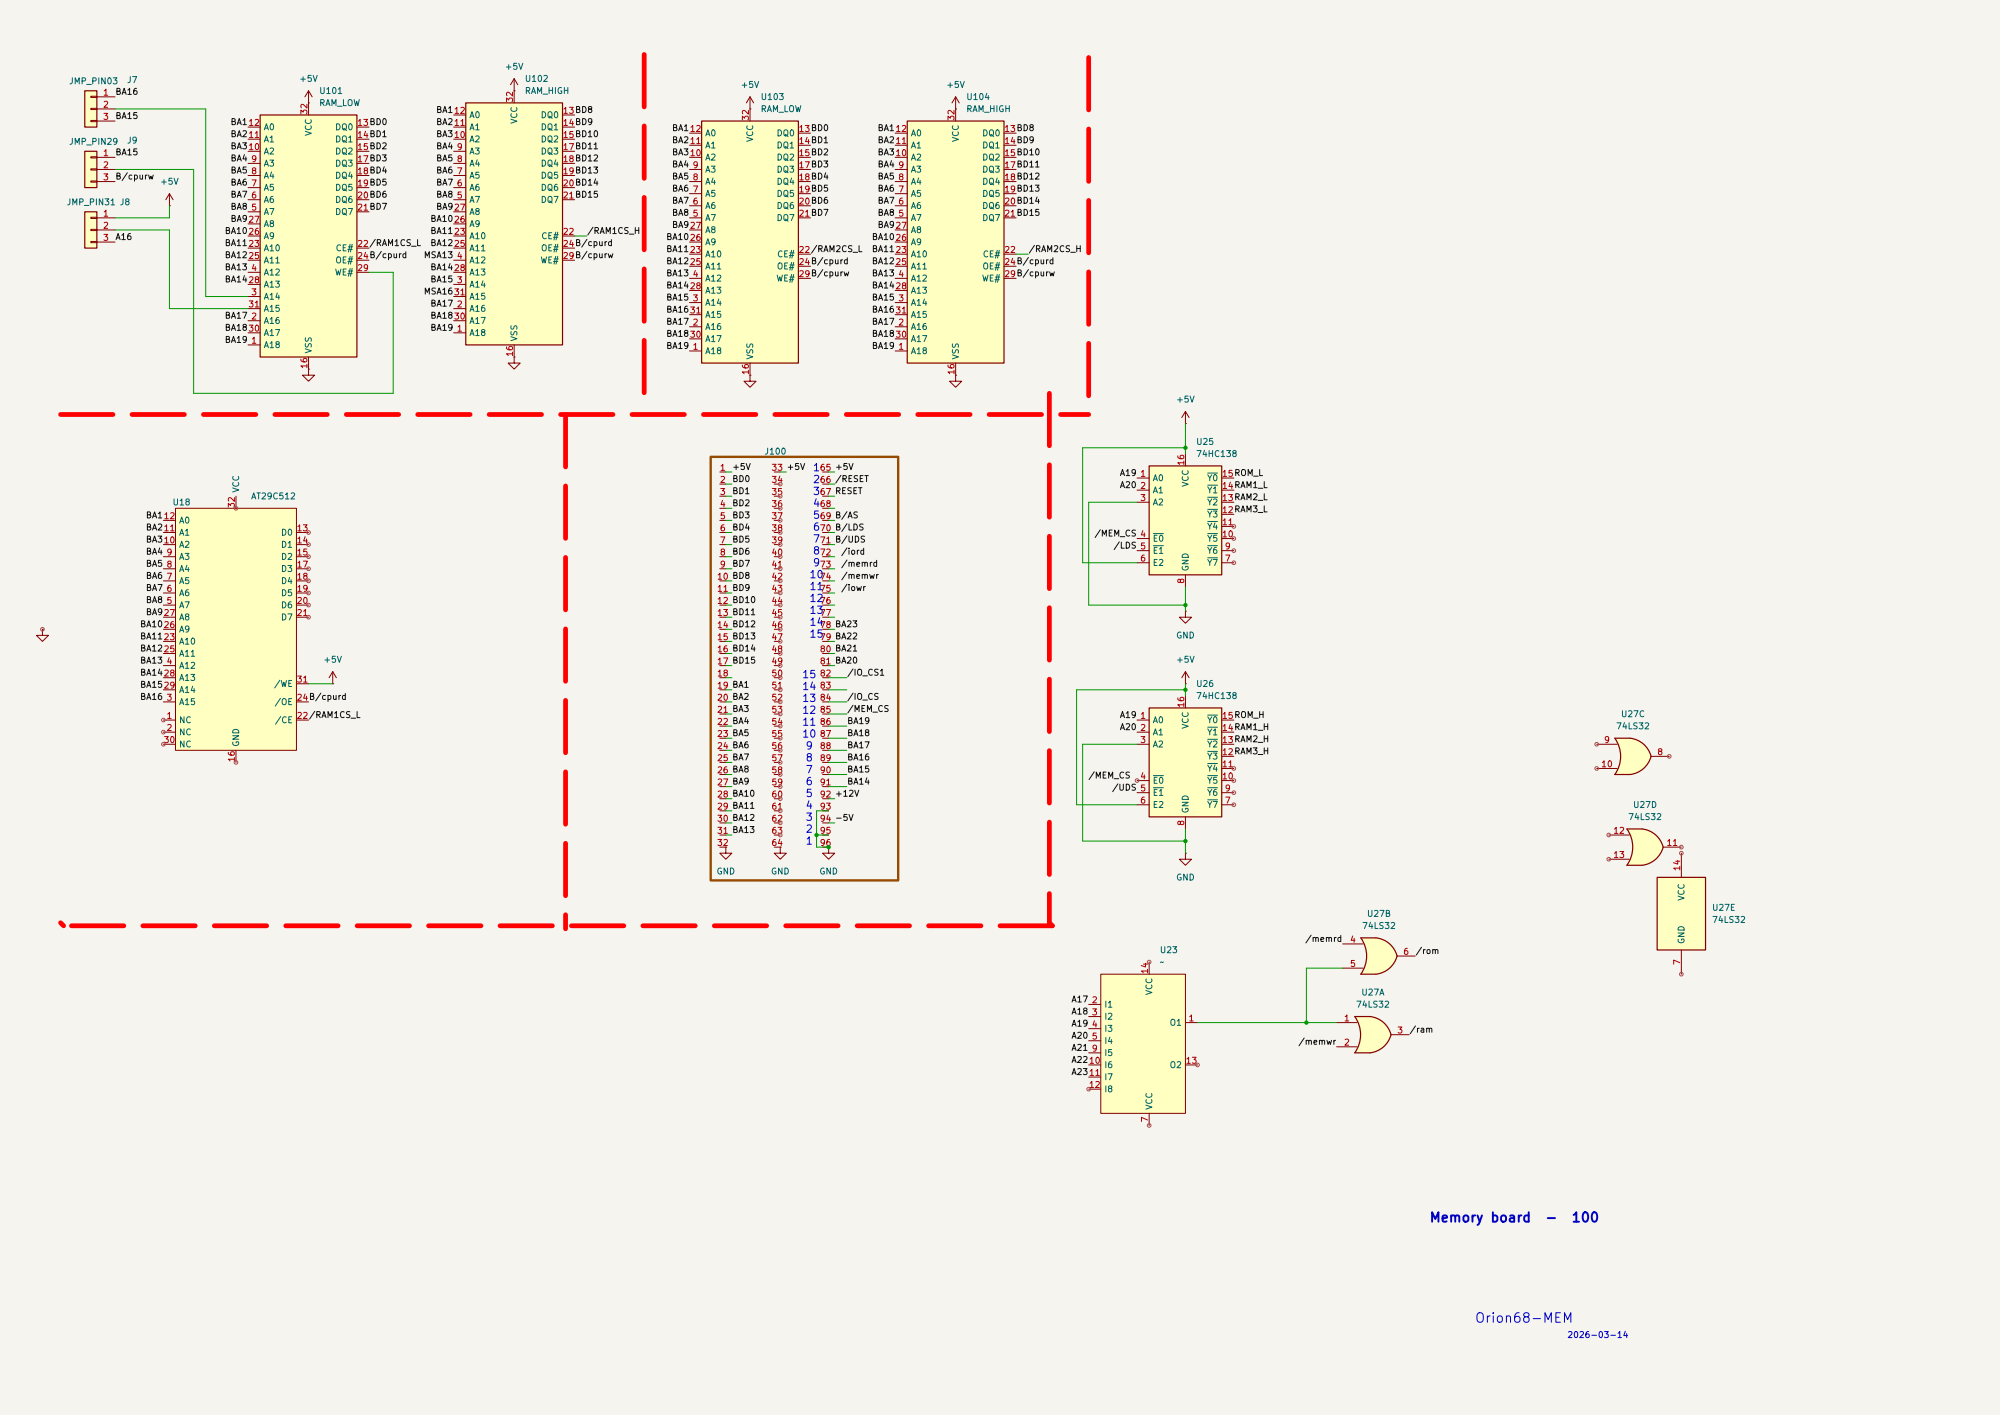
[picture p126: page 2]

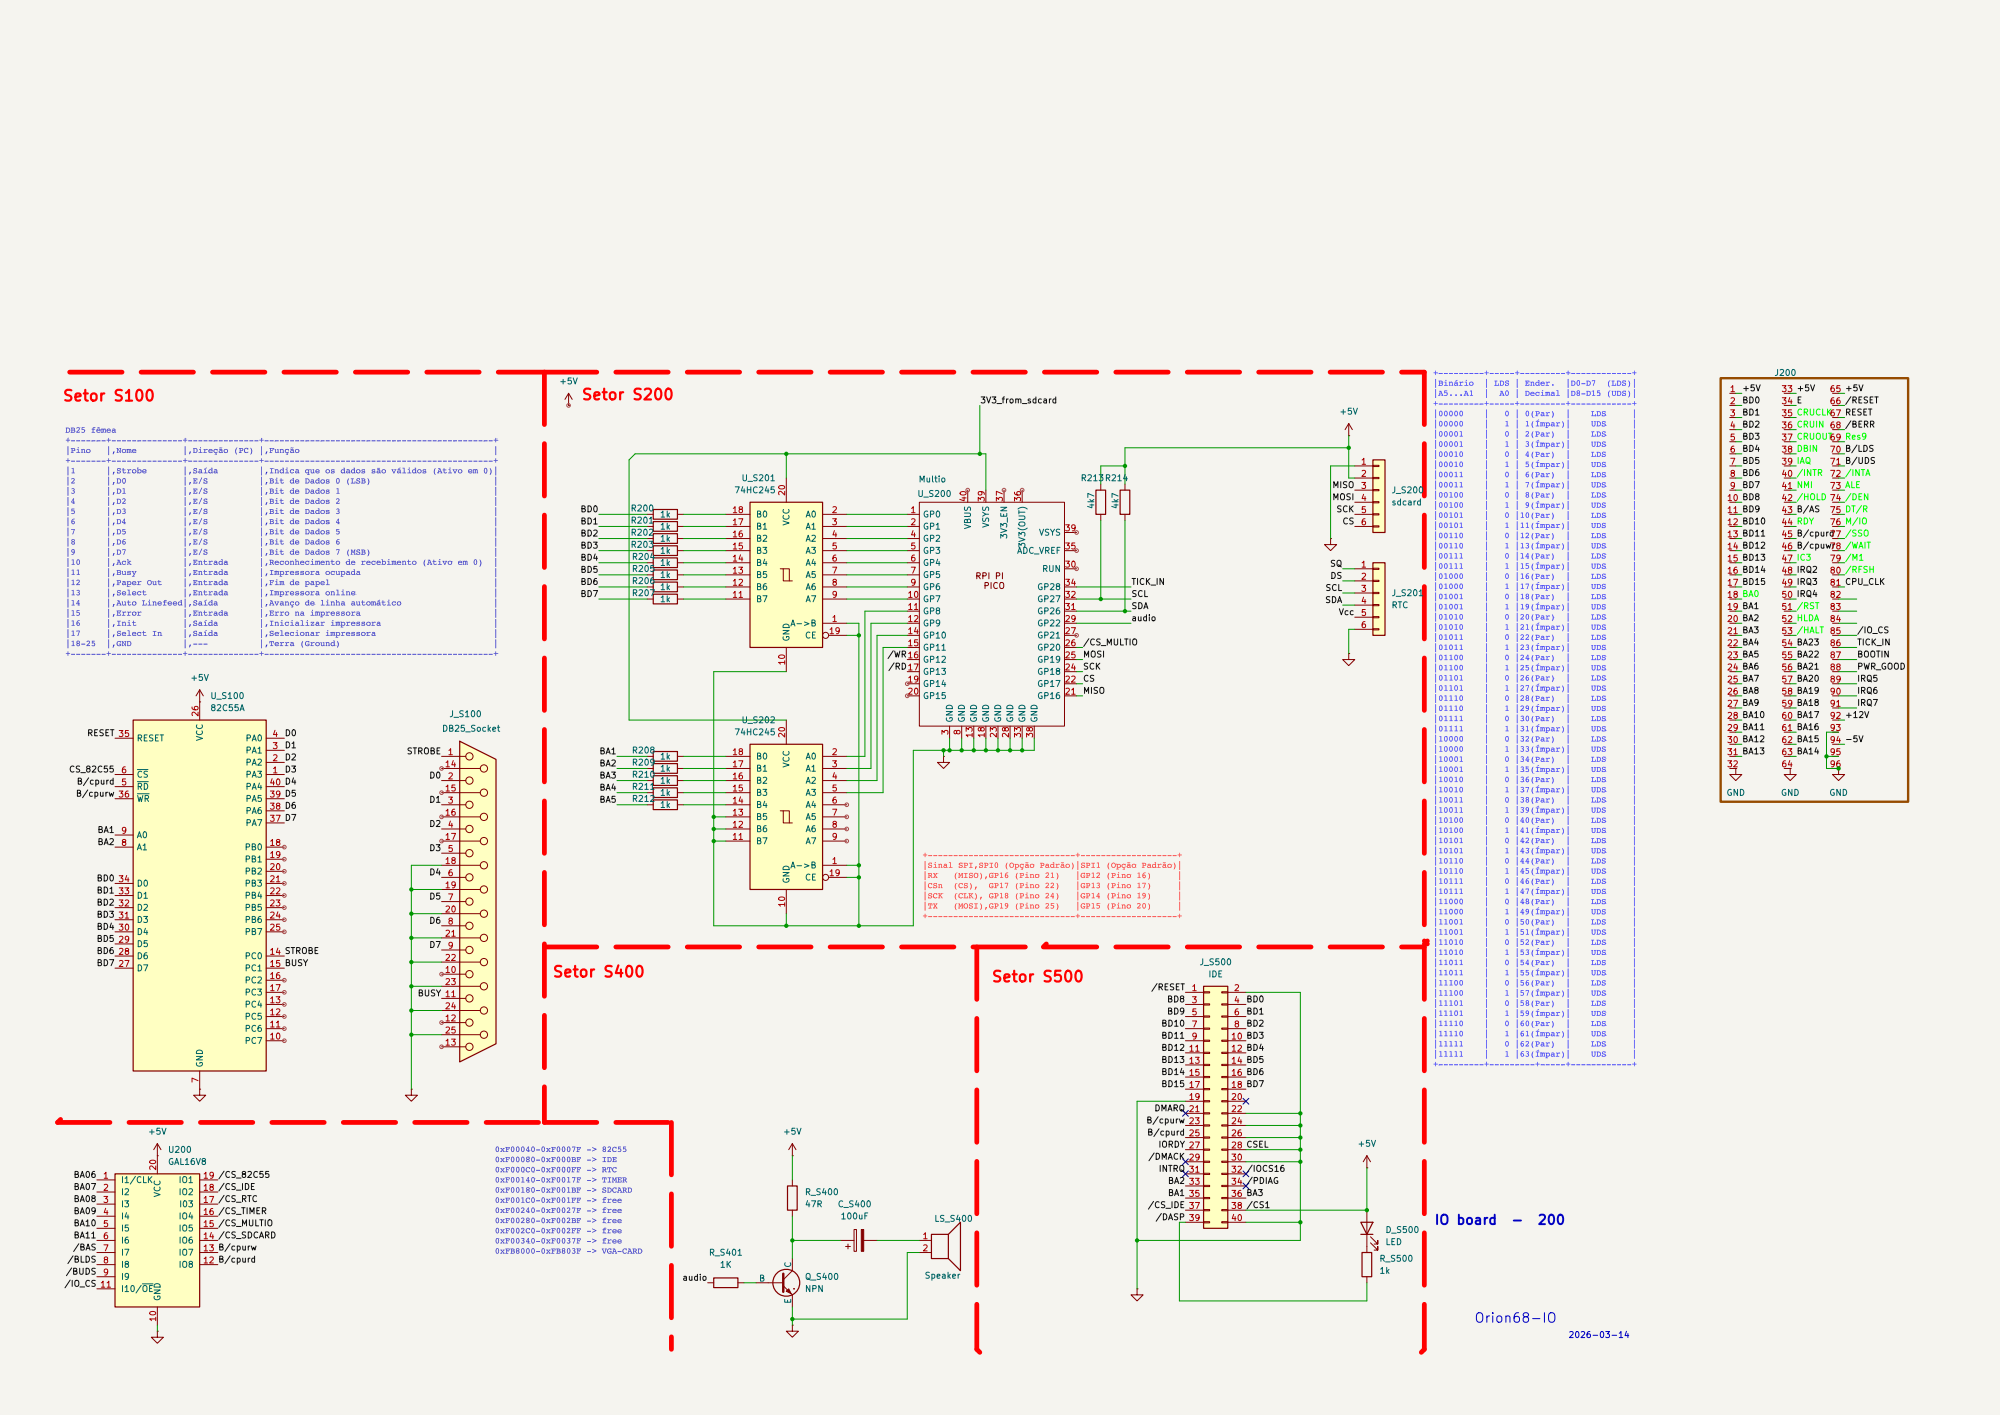
[picture p127: page 3]

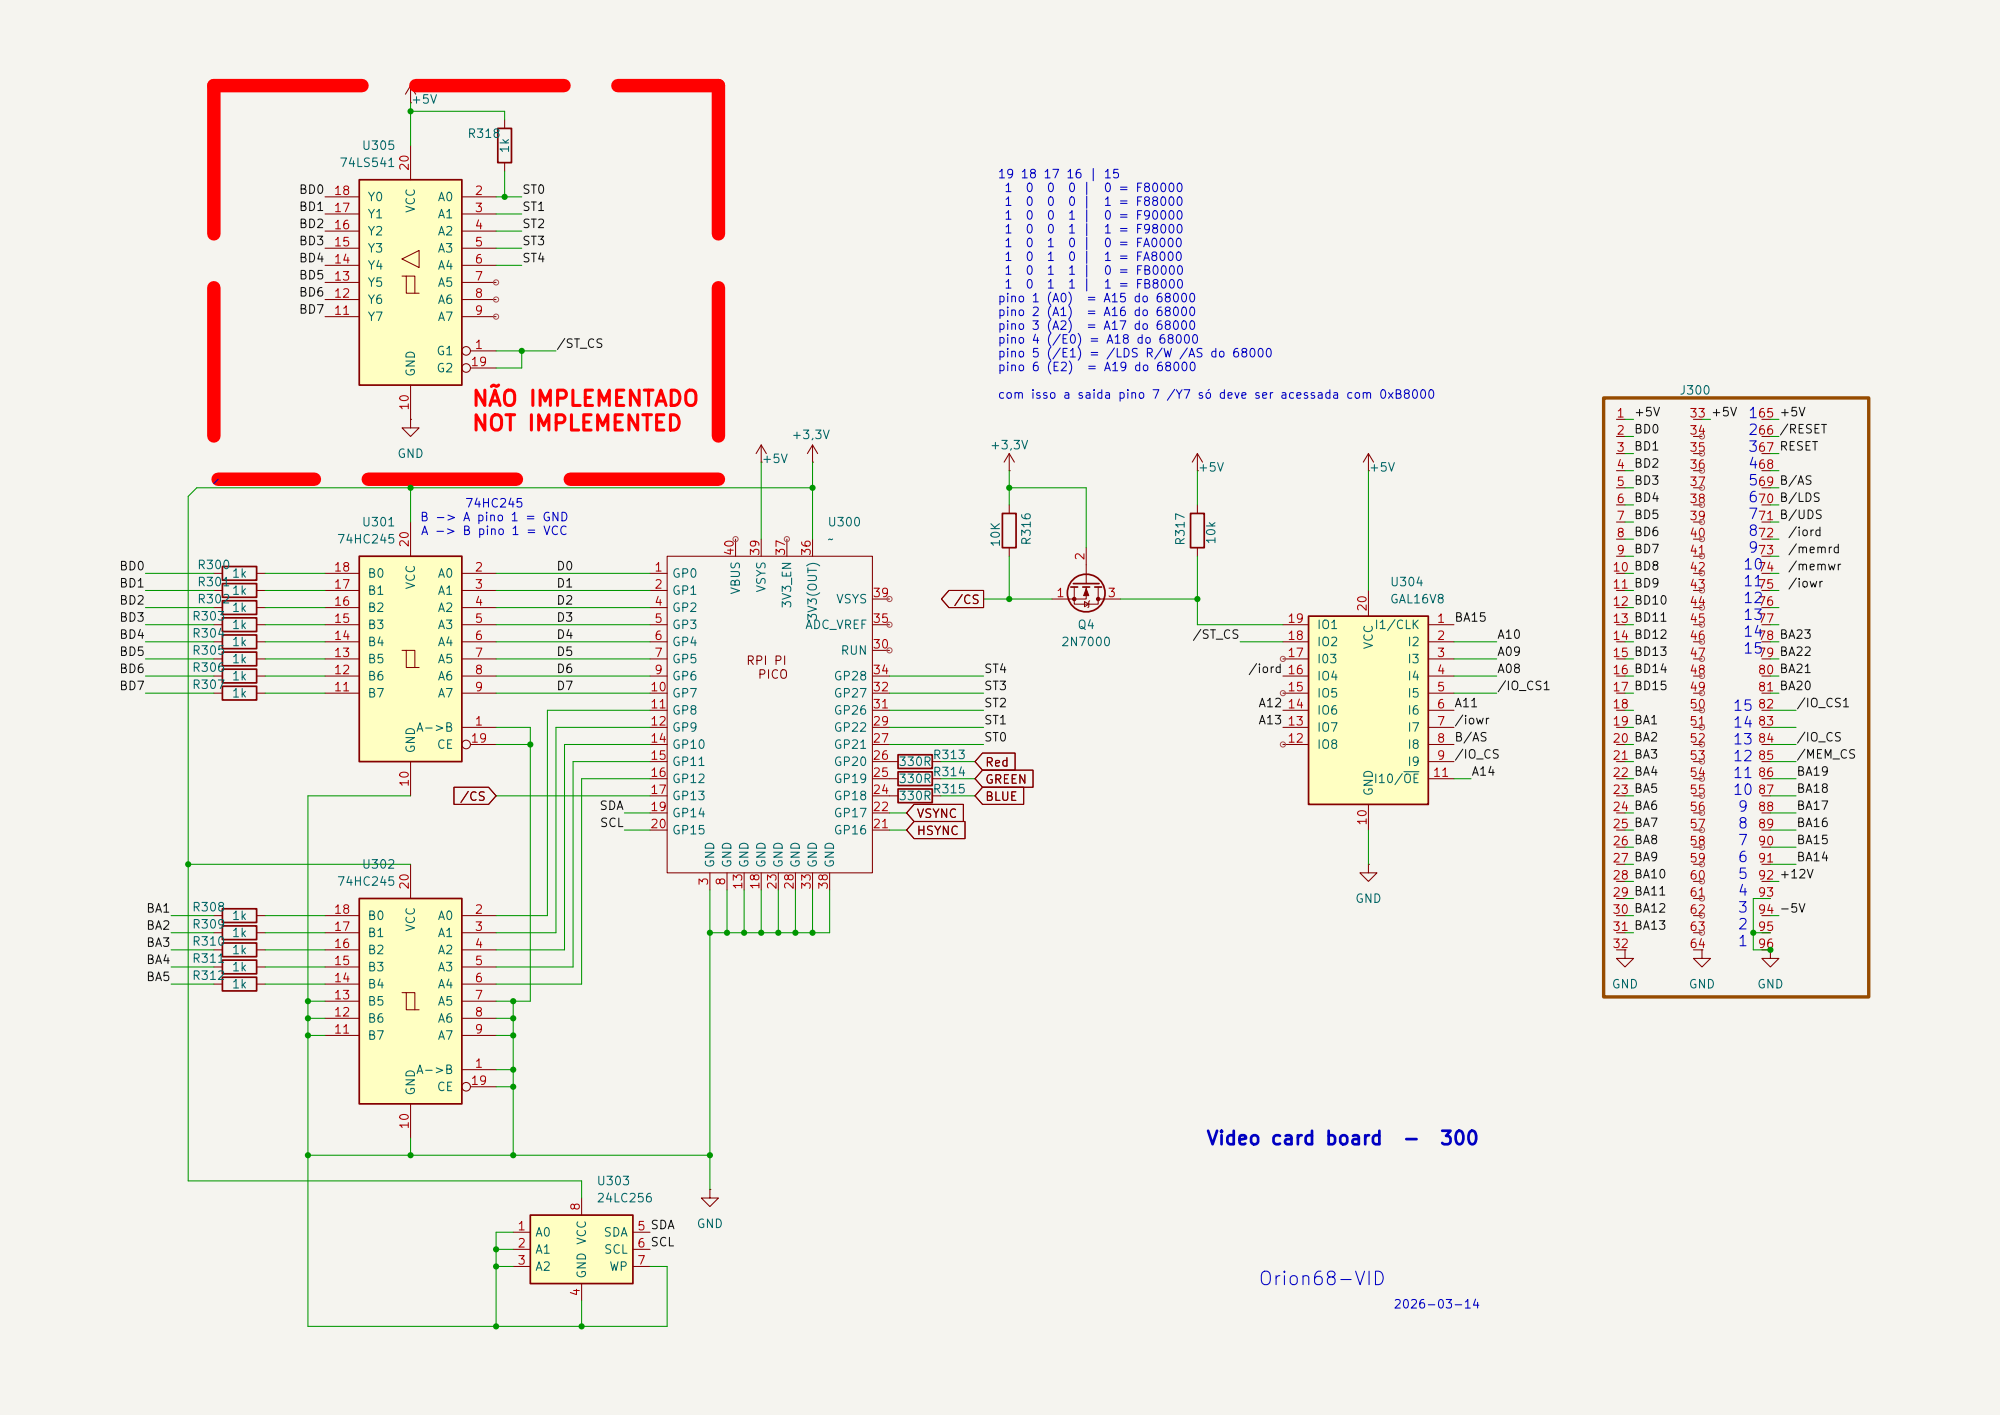
[picture p128: page 4]

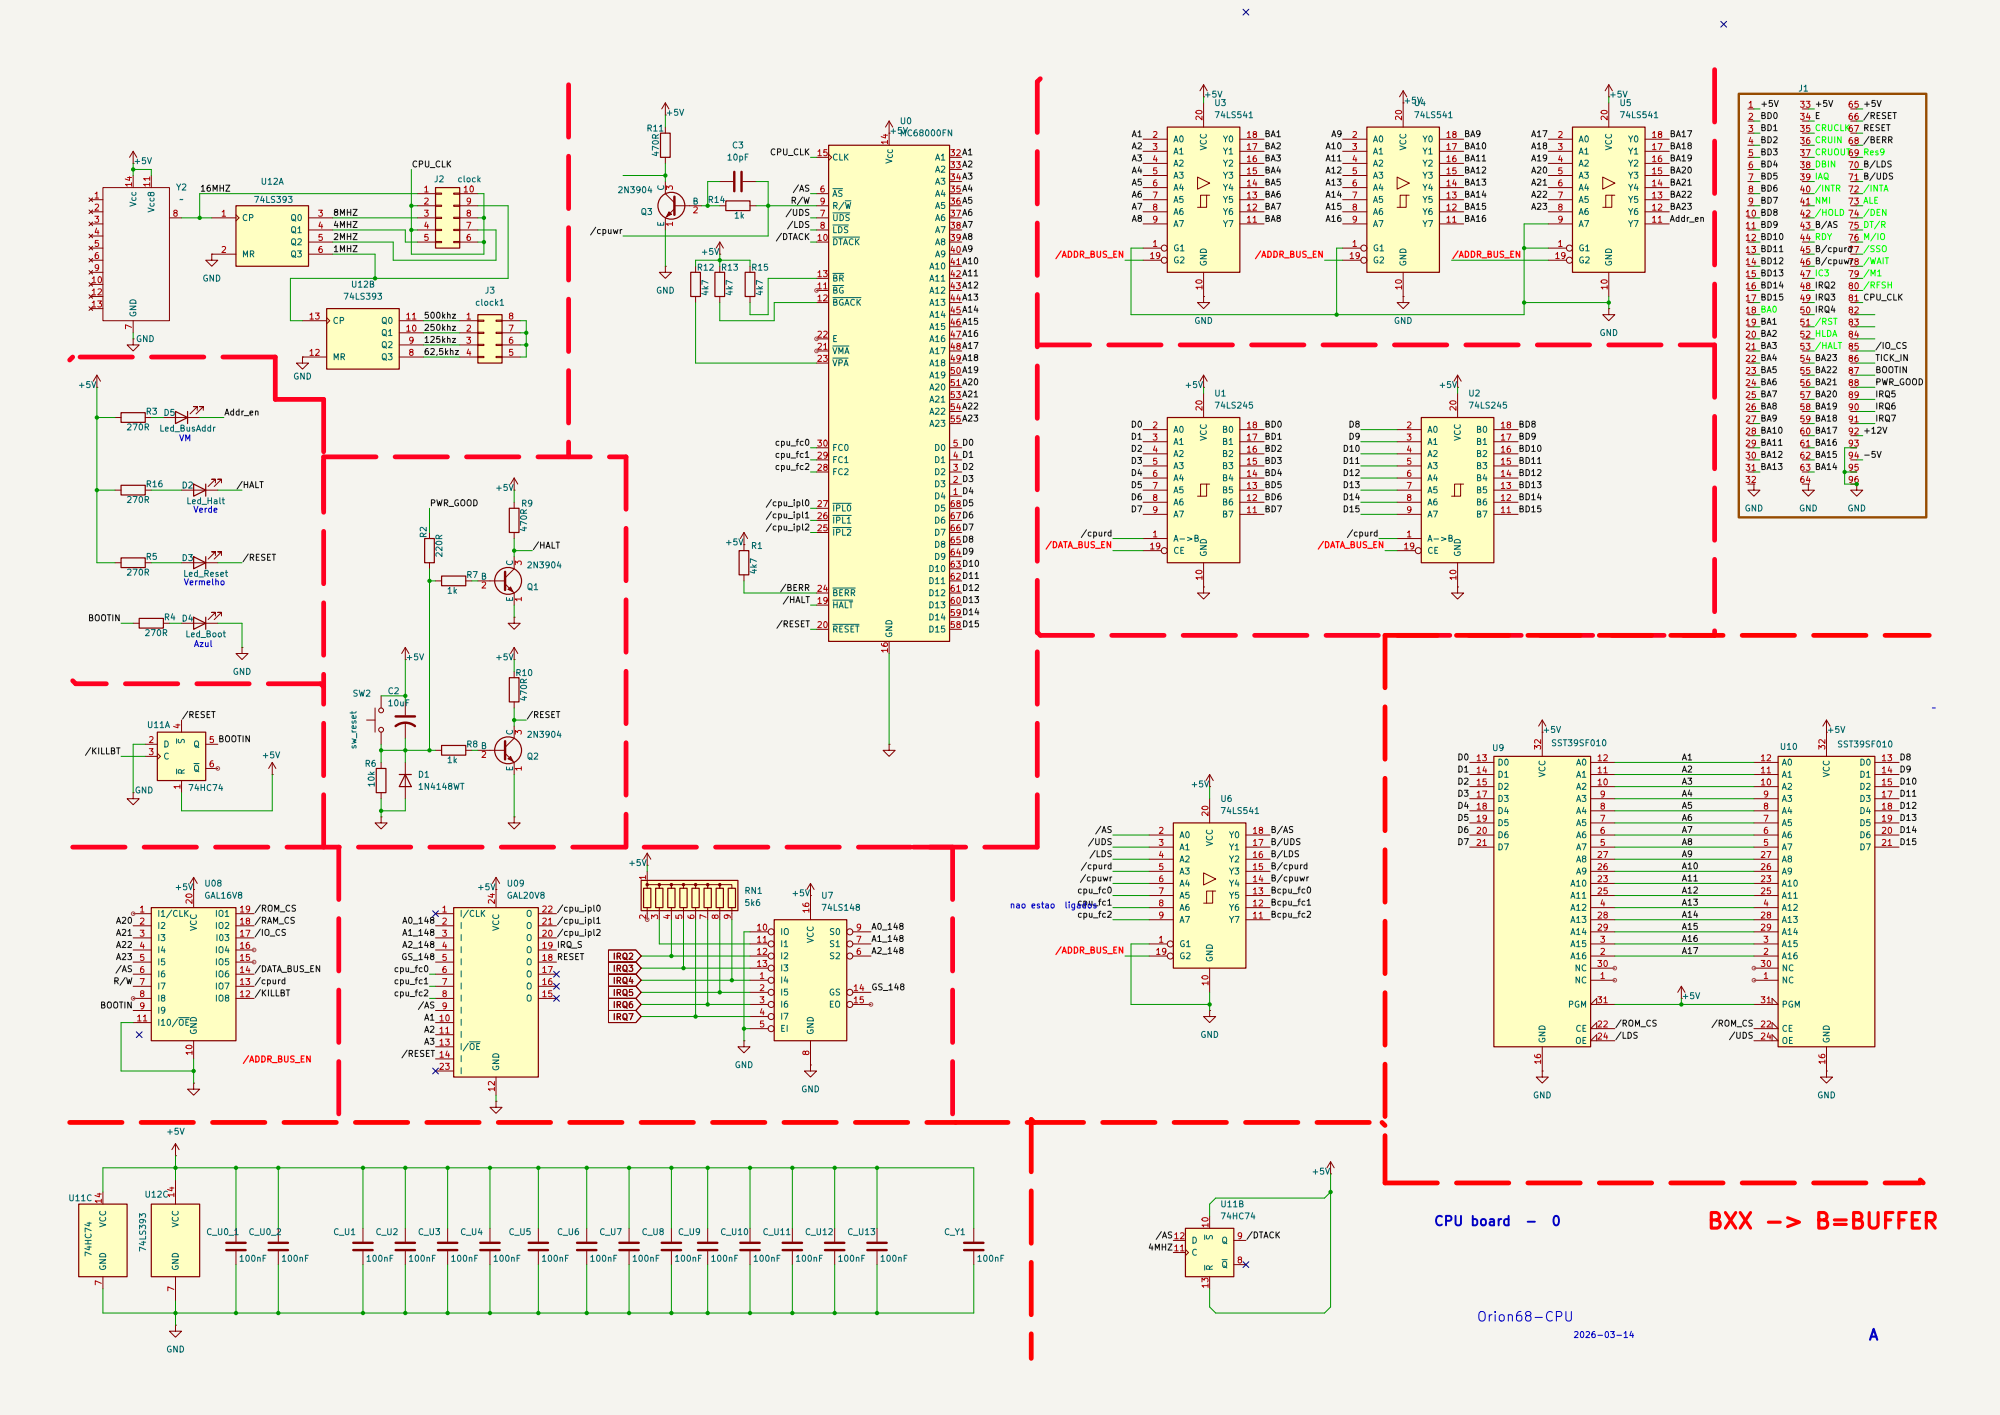
[picture p129: page 5]

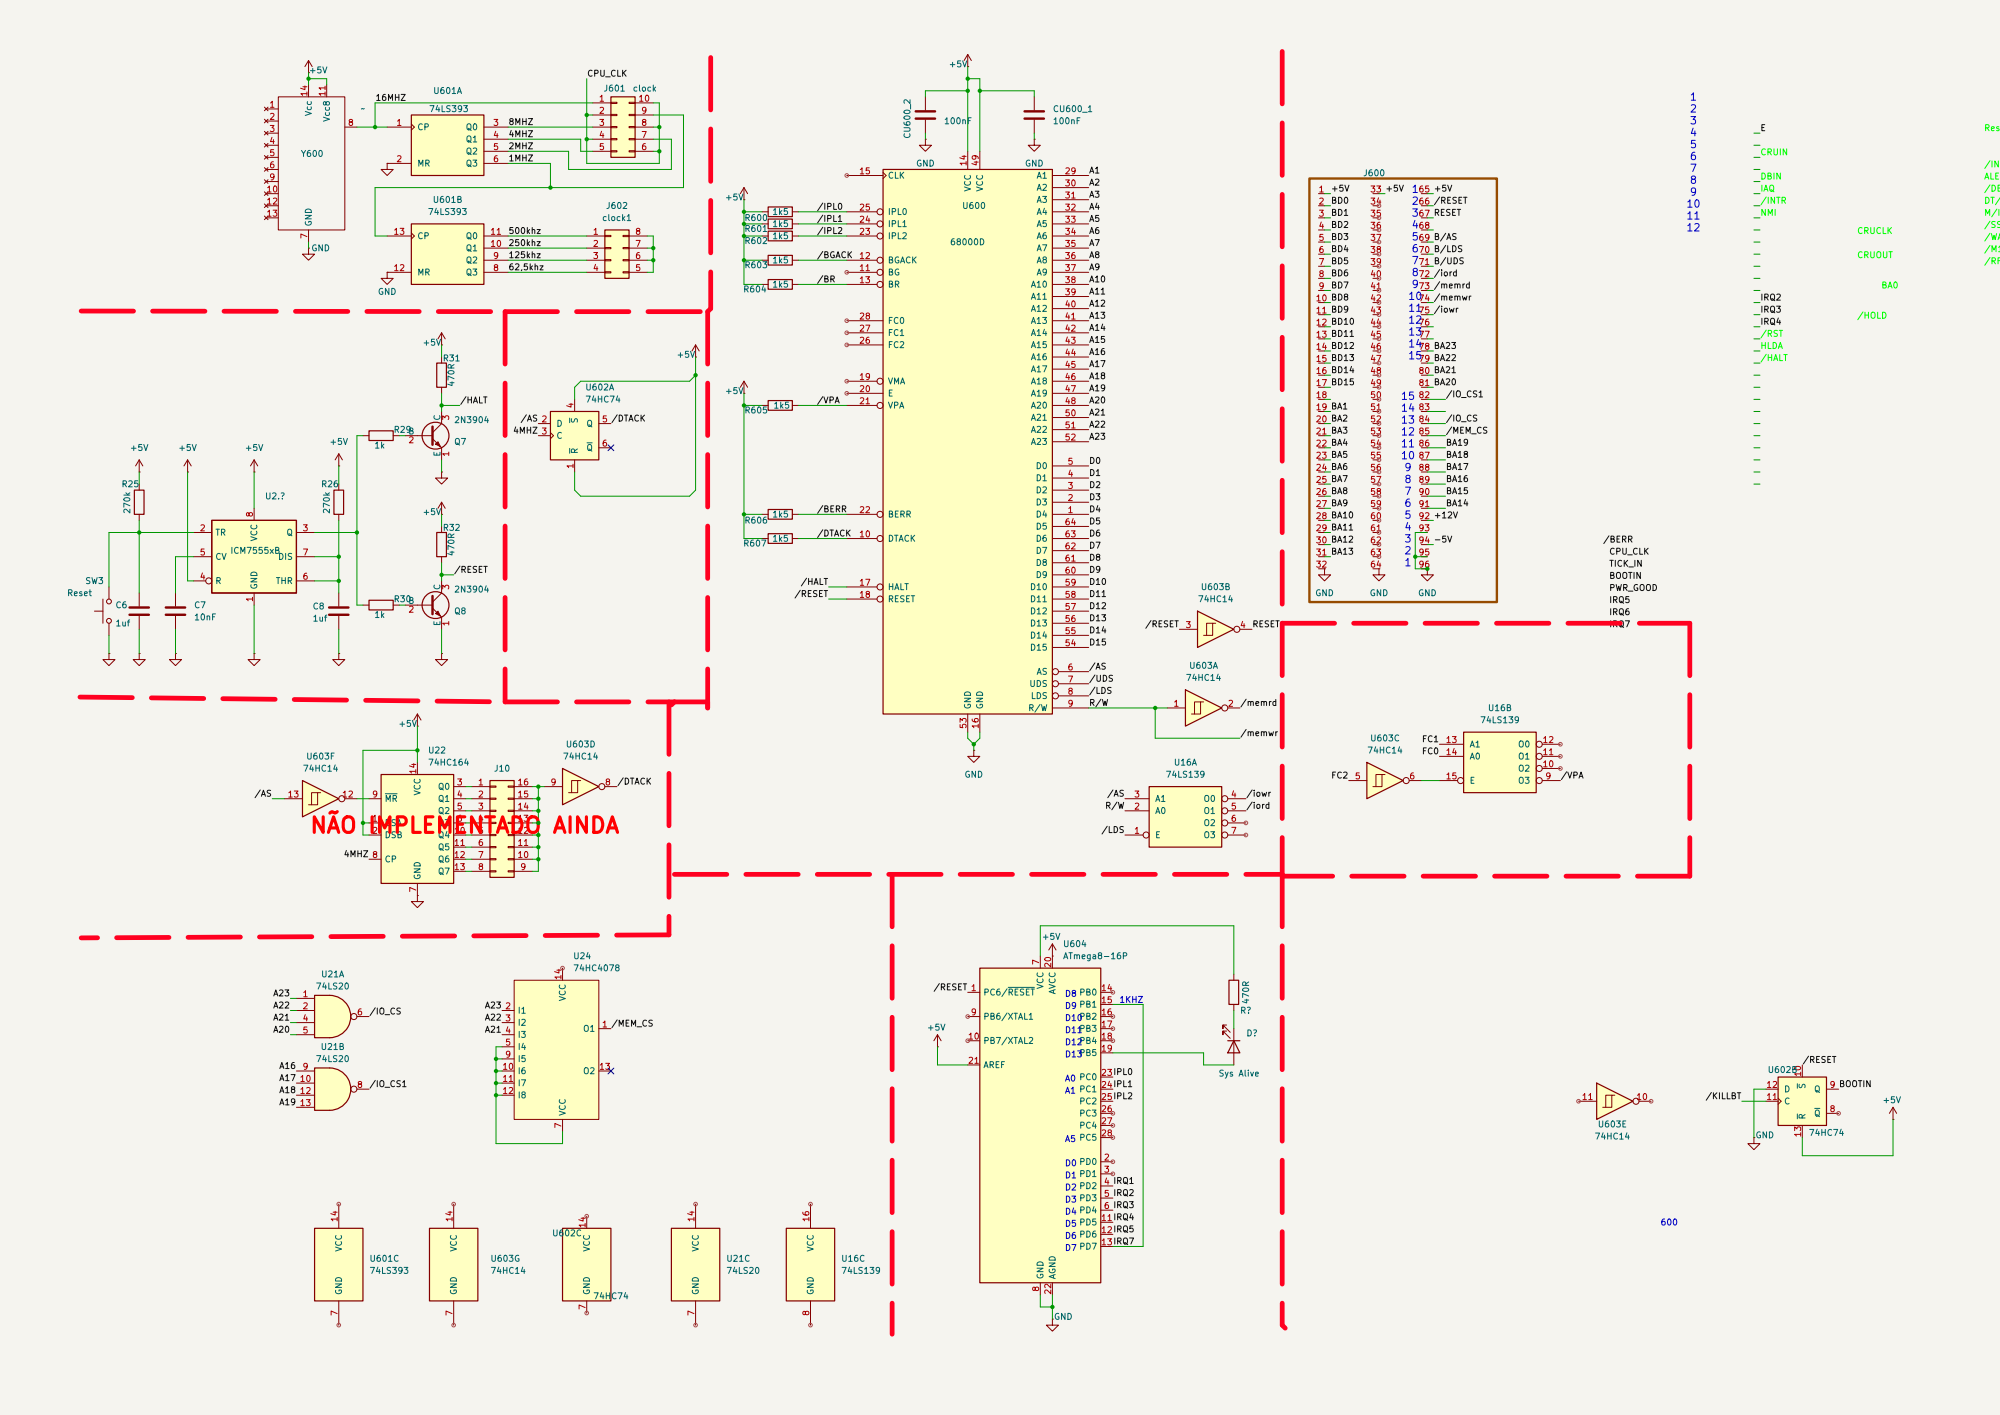
[picture p130: page 6]

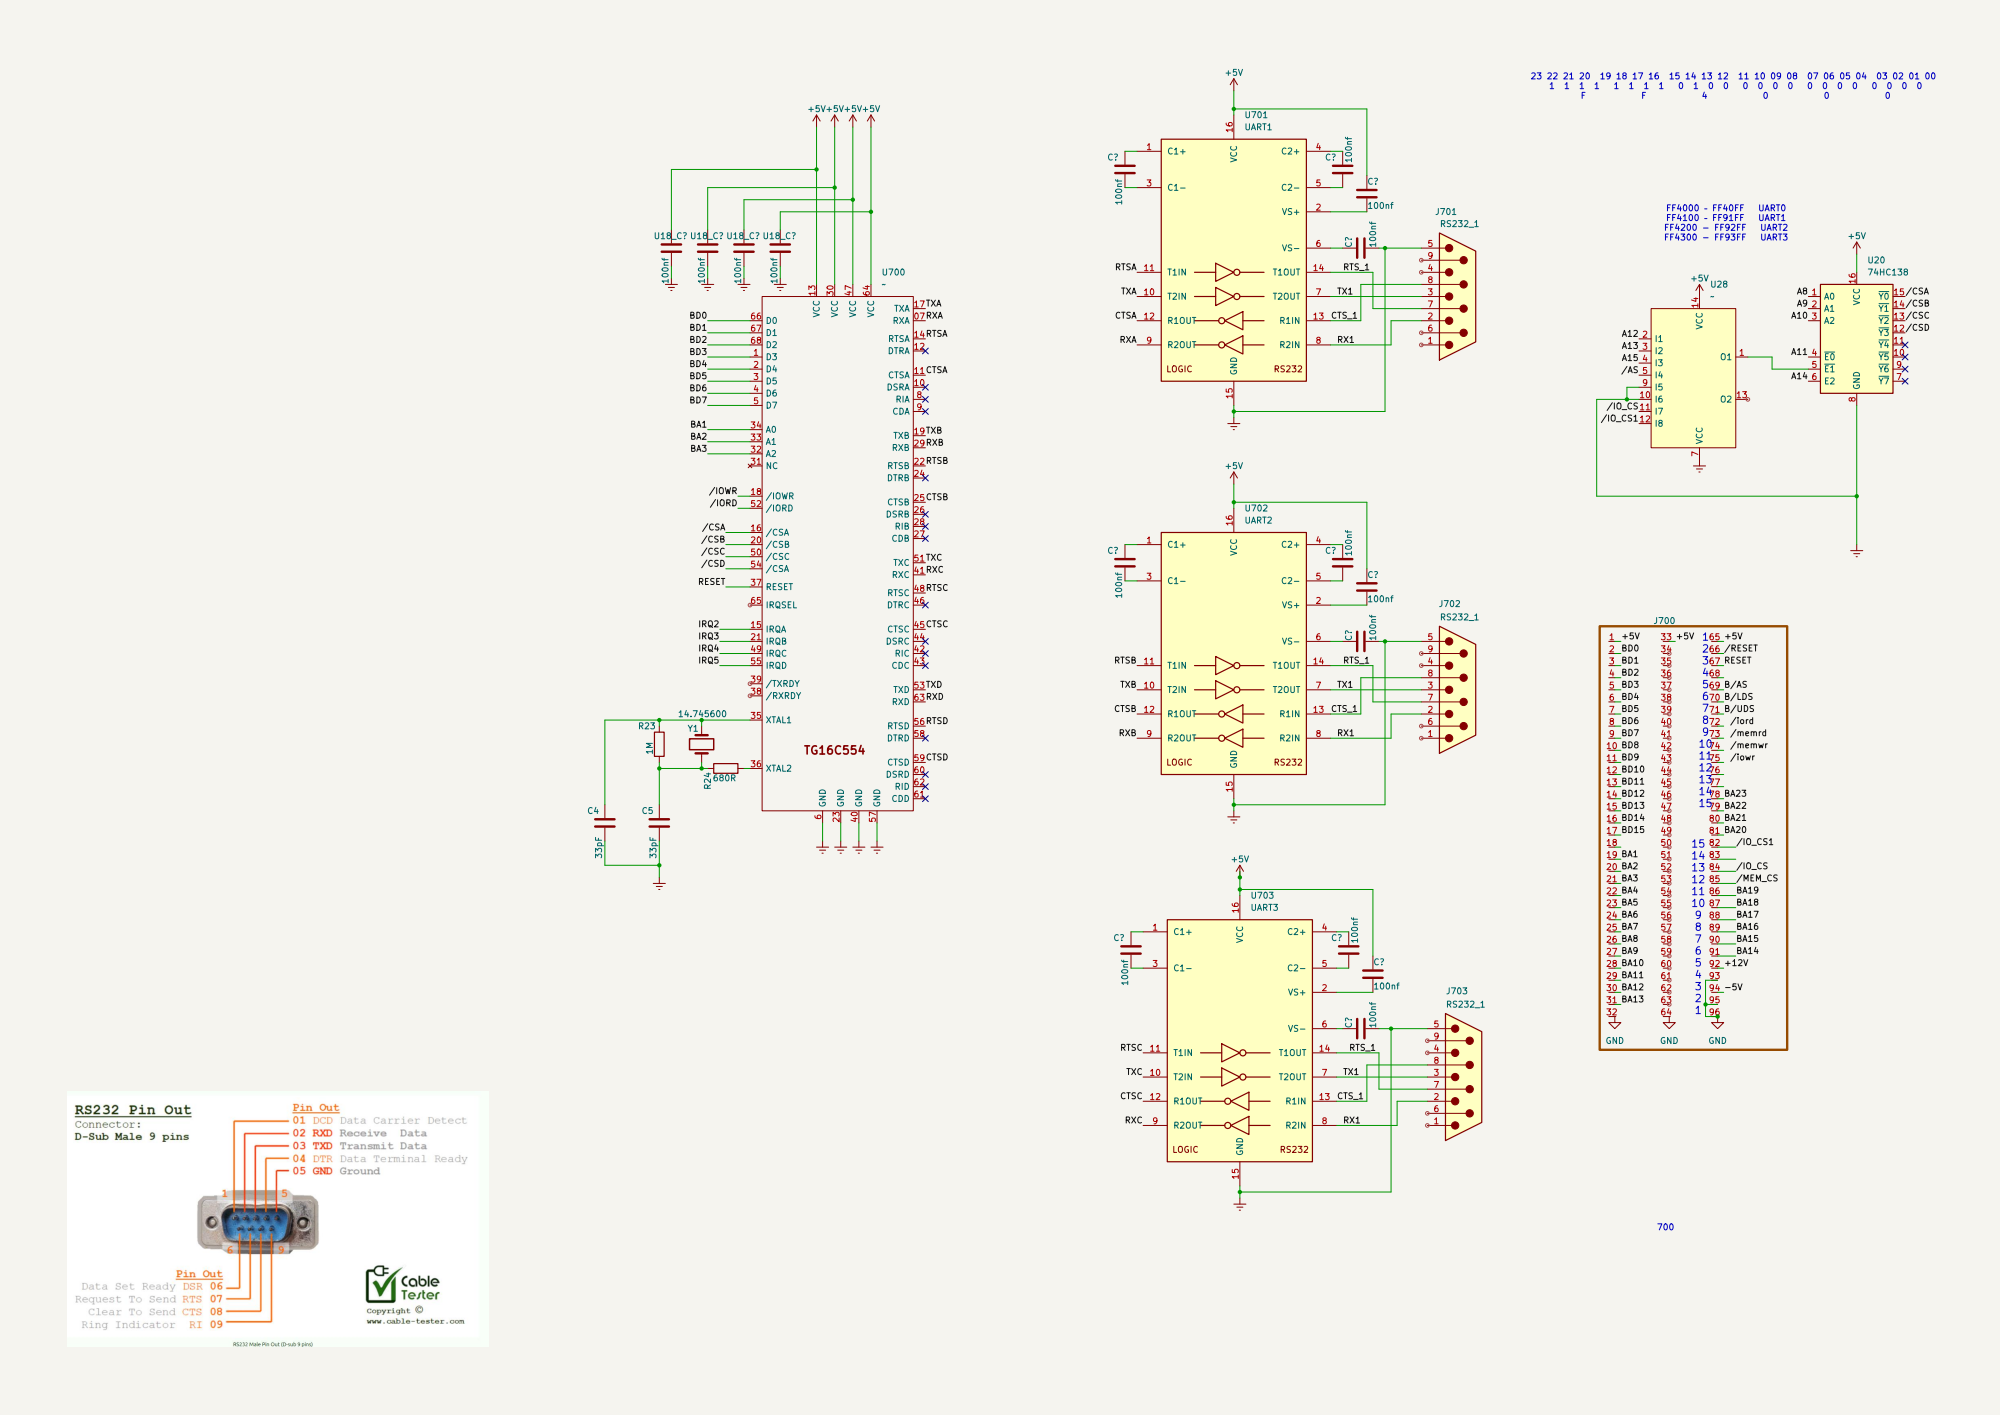
[picture p131: page 7]
