ppsilv/Orion68/hardware/schematics/board_mem/mem_board.kicad_pcb

## KiCad design hardware/schematics/board_mem/mem_board.kicad_pcb (2026-09-06)

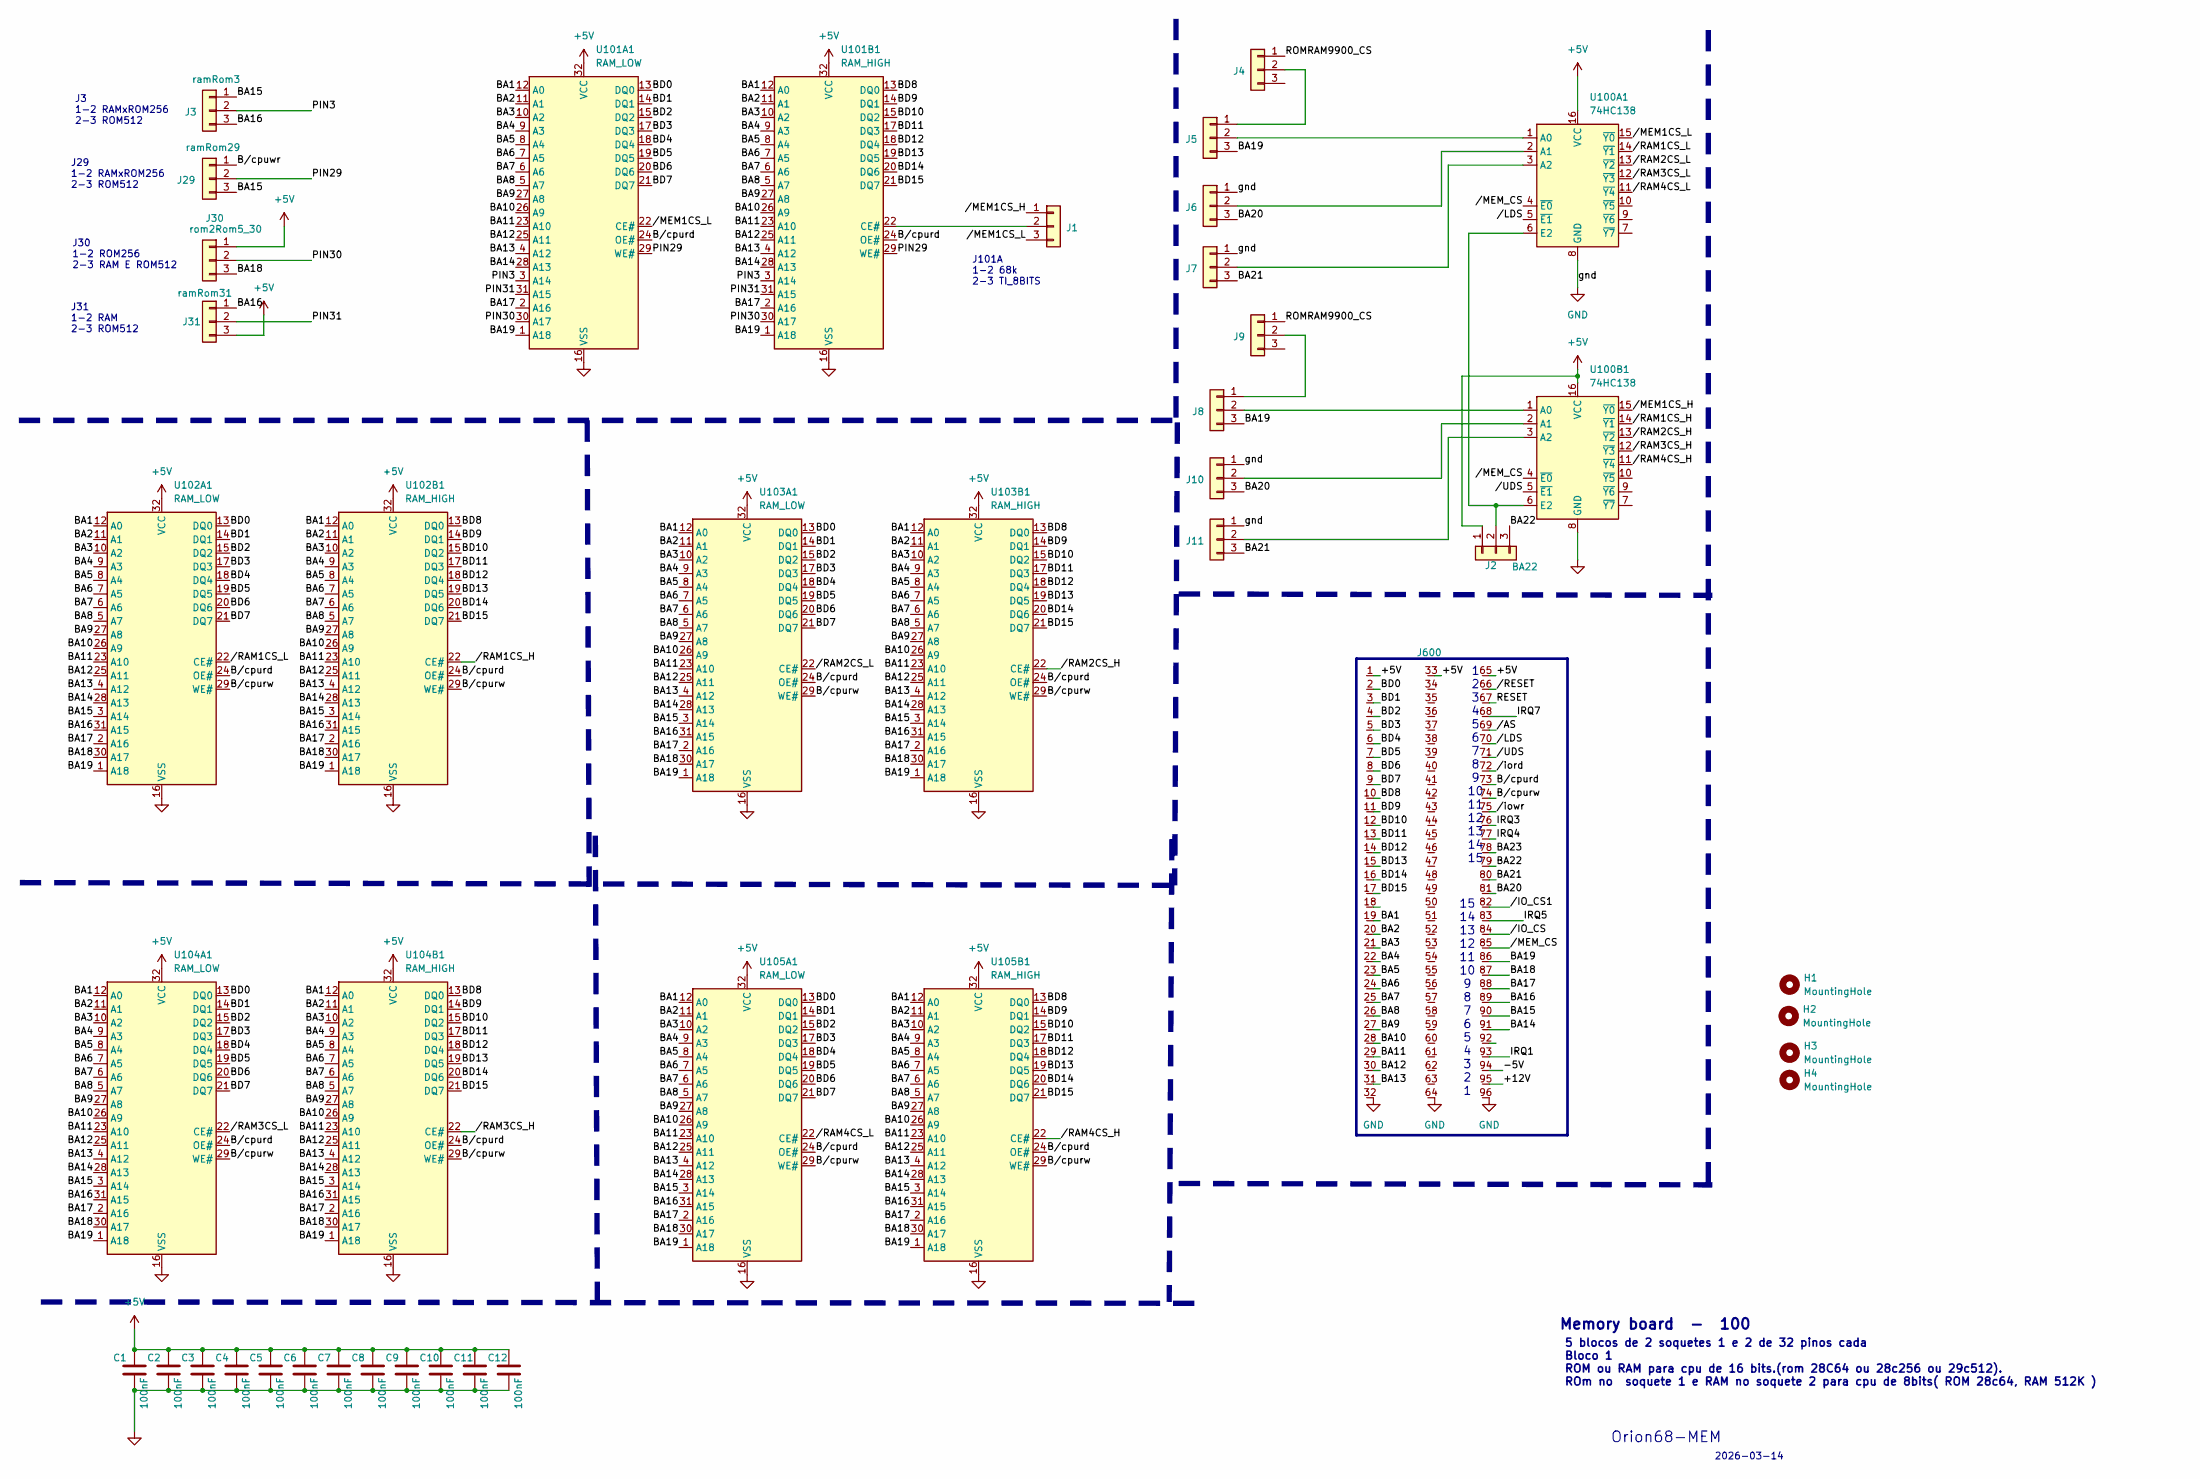
[picture p132: schematic mem_board.kicad_sch]

Parts:
C1, C2, C3, C4, C5, C6, C7, C8, C9, C10, C11, C12: 100nF; C_0805_2012Metric_Pad1.18x1.45mm_HandSolder
H1, H2: MountingHole; MountingHole_3.2mm_M3
H3, H4: MountingHole; MountingHole_2.1mm
J1: J101A; PinHeader_1x03_P2.54mm_Vertical
J2: BA22; PinHeader_1x03_P2.54mm_Vertical
J3: ramRom3; PinHeader_1x03_P2.54mm_Vertical
J4, J5, J8, J9: J100A; PinHeader_1x03_P2.54mm_Vertical
J6, J10: J100B; PinHeader_1x03_P2.54mm_Vertical
J7, J11: J100C; PinHeader_1x03_P2.54mm_Vertical
J29: ramRom29; PinHeader_1x03_P2.54mm_Vertical
J30: rom2Rom5_30; PinHeader_1x03_P2.54mm_Vertical
J31: ramRom31; PinHeader_1x03_P2.54mm_Vertical
J600: Euro96pin; conn_euro96
U100A1, U100B1: 74HC138; DIP-16_W7.62mm
U101A1, U102A1, U103A1, U104A1, U105A1: RAM_LOW; DIP-32_W15.24mm
U101B1, U102B1, U103B1, U104B1, U105B1: RAM_HIGH; DIP-32_W15.24mm

Connections:
+5V: C1.1, C2.1, C3.1, C4.1, C5.1, C6.1, C7.1, C8.1, C9.1, C10.1, C11.1, C12.1, J2.1, J30.1, J31.3, J600.1, J600.33, J600.65, U100A1.16 (VCC), U100B1.16 (VCC), U101A1.32 (VCC), U101B1.32 (VCC), U102A1.32 (VCC), U102B1.32 (VCC), U103A1.32 (VCC), U103B1.32 (VCC), U104A1.32 (VCC), U104B1.32 (VCC), U105A1.32 (VCC), U105B1.32 (VCC)
/+12V: J600.95
/-5V: J600.94
/BA1: J600.19, U101A1.12 (A0), U101B1.12 (A0), U102A1.12 (A0), U102B1.12 (A0), U103A1.12 (A0), U103B1.12 (A0), U104A1.12 (A0), U104B1.12 (A0), U105A1.12 (A0), U105B1.12 (A0)
/BA2: J600.20, U101A1.11 (A1), U101B1.11 (A1), U102A1.11 (A1), U102B1.11 (A1), U103A1.11 (A1), U103B1.11 (A1), U104A1.11 (A1), U104B1.11 (A1), U105A1.11 (A1), U105B1.11 (A1)
/BA3: J600.21, U101A1.10 (A2), U101B1.10 (A2), U102A1.10 (A2), U102B1.10 (A2), U103A1.10 (A2), U103B1.10 (A2), U104A1.10 (A2), U104B1.10 (A2), U105A1.10 (A2), U105B1.10 (A2)
/BA4: J600.22, U101A1.9 (A3), U101B1.9 (A3), U102A1.9 (A3), U102B1.9 (A3), U103A1.9 (A3), U103B1.9 (A3), U104A1.9 (A3), U104B1.9 (A3), U105A1.9 (A3), U105B1.9 (A3)
/BA5: J600.23, U101A1.8 (A4), U101B1.8 (A4), U102A1.8 (A4), U102B1.8 (A4), U103A1.8 (A4), U103B1.8 (A4), U104A1.8 (A4), U104B1.8 (A4), U105A1.8 (A4), U105B1.8 (A4)
/BA6: J600.24, U101A1.7 (A5), U101B1.7 (A5), U102A1.7 (A5), U102B1.7 (A5), U103A1.7 (A5), U103B1.7 (A5), U104A1.7 (A5), U104B1.7 (A5), U105A1.7 (A5), U105B1.7 (A5)
/BA7: J600.25, U101A1.6 (A6), U101B1.6 (A6), U102A1.6 (A6), U102B1.6 (A6), U103A1.6 (A6), U103B1.6 (A6), U104A1.6 (A6), U104B1.6 (A6), U105A1.6 (A6), U105B1.6 (A6)
/BA8: J600.26, U101A1.5 (A7), U101B1.5 (A7), U102A1.5 (A7), U102B1.5 (A7), U103A1.5 (A7), U103B1.5 (A7), U104A1.5 (A7), U104B1.5 (A7), U105A1.5 (A7), U105B1.5 (A7)
/BA9: J600.27, U101A1.27 (A8), U101B1.27 (A8), U102A1.27 (A8), U102B1.27 (A8), U103A1.27 (A8), U103B1.27 (A8), U104A1.27 (A8), U104B1.27 (A8), U105A1.27 (A8), U105B1.27 (A8)
/BA10: J600.28, U101A1.26 (A9), U101B1.26 (A9), U102A1.26 (A9), U102B1.26 (A9), U103A1.26 (A9), U103B1.26 (A9), U104A1.26 (A9), U104B1.26 (A9), U105A1.26 (A9), U105B1.26 (A9)
/BA11: J600.29, U101A1.23 (A10), U101B1.23 (A10), U102A1.23 (A10), U102B1.23 (A10), U103A1.23 (A10), U103B1.23 (A10), U104A1.23 (A10), U104B1.23 (A10), U105A1.23 (A10), U105B1.23 (A10)
/BA12: J600.30, U101A1.25 (A11), U101B1.25 (A11), U102A1.25 (A11), U102B1.25 (A11), U103A1.25 (A11), U103B1.25 (A11), U104A1.25 (A11), U104B1.25 (A11), U105A1.25 (A11), U105B1.25 (A11)
/BA13: J600.31, U101A1.4 (A12), U101B1.4 (A12), U102A1.4 (A12), U102B1.4 (A12), U103A1.4 (A12), U103B1.4 (A12), U104A1.4 (A12), U104B1.4 (A12), U105A1.4 (A12), U105B1.4 (A12)
/BA14: J600.91, U101A1.28 (A13), U101B1.28 (A13), U102A1.28 (A13), U102B1.28 (A13), U103A1.28 (A13), U103B1.28 (A13), U104A1.28 (A13), U104B1.28 (A13), U105A1.28 (A13), U105B1.28 (A13)
/BA15: J3.1, J29.3, J600.90, U102A1.3 (A14), U102B1.3 (A14), U103A1.3 (A14), U103B1.3 (A14), U104A1.3 (A14), U104B1.3 (A14), U105A1.3 (A14), U105B1.3 (A14)
/BA16: J3.3, J31.1, J600.89, U102A1.31 (A15), U102B1.31 (A15), U103A1.31 (A15), U103B1.31 (A15), U104A1.31 (A15), U104B1.31 (A15), U105A1.31 (A15), U105B1.31 (A15)
/BA17: J600.88, U101A1.2 (A16), U101B1.2 (A16), U102A1.2 (A16), U102B1.2 (A16), U103A1.2 (A16), U103B1.2 (A16), U104A1.2 (A16), U104B1.2 (A16), U105A1.2 (A16), U105B1.2 (A16)
/BA18: J30.3, J600.87, U102A1.30 (A17), U102B1.30 (A17), U103A1.30 (A17), U103B1.30 (A17), U104A1.30 (A17), U104B1.30 (A17), U105A1.30 (A17), U105B1.30 (A17)
/BA19: J5.3, J8.3, J600.86, U101A1.1 (A18), U101B1.1 (A18), U102A1.1 (A18), U102B1.1 (A18), U103A1.1 (A18), U103B1.1 (A18), U104A1.1 (A18), U104B1.1 (A18), U105A1.1 (A18), U105B1.1 (A18)
/BA20: J6.3, J10.3, J600.81
/BA21: J7.3, J11.3, J600.80
/BA22: J2.3, J600.79
/BA23: J600.78
/BD0: J600.2, U101A1.13 (DQ0), U102A1.13 (DQ0), U103A1.13 (DQ0), U104A1.13 (DQ0), U105A1.13 (DQ0)
/BD1: J600.3, U101A1.14 (DQ1), U102A1.14 (DQ1), U103A1.14 (DQ1), U104A1.14 (DQ1), U105A1.14 (DQ1)
/BD2: J600.4, U101A1.15 (DQ2), U102A1.15 (DQ2), U103A1.15 (DQ2), U104A1.15 (DQ2), U105A1.15 (DQ2)
/BD3: J600.5, U101A1.17 (DQ3), U102A1.17 (DQ3), U103A1.17 (DQ3), U104A1.17 (DQ3), U105A1.17 (DQ3)
/BD4: J600.6, U101A1.18 (DQ4), U102A1.18 (DQ4), U103A1.18 (DQ4), U104A1.18 (DQ4), U105A1.18 (DQ4)
/BD5: J600.7, U101A1.19 (DQ5), U102A1.19 (DQ5), U103A1.19 (DQ5), U104A1.19 (DQ5), U105A1.19 (DQ5)
/BD6: J600.8, U101A1.20 (DQ6), U102A1.20 (DQ6), U103A1.20 (DQ6), U104A1.20 (DQ6), U105A1.20 (DQ6)
/BD7: J600.9, U101A1.21 (DQ7), U102A1.21 (DQ7), U103A1.21 (DQ7), U104A1.21 (DQ7), U105A1.21 (DQ7)
/BD8: J600.10, U101B1.13 (DQ0), U102B1.13 (DQ0), U103B1.13 (DQ0), U104B1.13 (DQ0), U105B1.13 (DQ0)
/BD9: J600.11, U101B1.14 (DQ1), U102B1.14 (DQ1), U103B1.14 (DQ1), U104B1.14 (DQ1), U105B1.14 (DQ1)
/BD10: J600.12, U101B1.15 (DQ2), U102B1.15 (DQ2), U103B1.15 (DQ2), U104B1.15 (DQ2), U105B1.15 (DQ2)
/BD11: J600.13, U101B1.17 (DQ3), U102B1.17 (DQ3), U103B1.17 (DQ3), U104B1.17 (DQ3), U105B1.17 (DQ3)
/BD12: J600.14, U101B1.18 (DQ4), U102B1.18 (DQ4), U103B1.18 (DQ4), U104B1.18 (DQ4), U105B1.18 (DQ4)
/BD13: J600.15, U101B1.19 (DQ5), U102B1.19 (DQ5), U103B1.19 (DQ5), U104B1.19 (DQ5), U105B1.19 (DQ5)
/BD14: J600.16, U101B1.20 (DQ6), U102B1.20 (DQ6), U103B1.20 (DQ6), U104B1.20 (DQ6), U105B1.20 (DQ6)
/BD15: J600.17, U101B1.21 (DQ7), U102B1.21 (DQ7), U103B1.21 (DQ7), U104B1.21 (DQ7), U105B1.21 (DQ7)
/B/cpurd: J600.73, U101A1.24 (OE#), U101B1.24 (OE#), U102A1.24 (OE#), U102B1.24 (OE#), U103A1.24 (OE#), U103B1.24 (OE#), U104A1.24 (OE#), U104B1.24 (OE#), U105A1.24 (OE#), U105B1.24 (OE#)
/B/cpurw: J600.74, U102A1.29 (WE#), U102B1.29 (WE#), U103A1.29 (WE#), U103B1.29 (WE#), U104A1.29 (WE#), U104B1.29 (WE#), U105A1.29 (WE#), U105B1.29 (WE#)
/B/cpuwr: J29.1
/IRQ1: J600.93
/IRQ3: J600.76
/IRQ4: J600.77
/IRQ5: J600.83
/IRQ7: J600.68
/PIN3: J3.2, U101A1.3 (A14), U101B1.3 (A14)
/PIN29: J29.2, U101A1.29 (WE#), U101B1.29 (WE#)
/PIN30: J30.2, U101A1.30 (A17), U101B1.30 (A17)
/PIN31: J31.2, U101A1.31 (A15), U101B1.31 (A15)
/RESET: J600.67
/ROMRAM9900_CS: J4.1, J9.1
//AS: J600.69
//IO_CS: J600.84
//IO_CS1: J600.82
//LDS: J600.70, U100A1.5 (~E1)
//MEM1CS_H: J1.1, U100B1.15 (~Y0)
//MEM1CS_L: J1.3, U100A1.15 (~Y0), U101A1.22 (CE#)
//MEM_CS: J600.85, U100A1.4 (~E0), U100B1.4 (~E0)
//RAM1CS_H: U100B1.14 (~Y1), U102B1.22 (CE#)
//RAM1CS_L: U100A1.14 (~Y1), U102A1.22 (CE#)
//RAM2CS_H: U100B1.13 (~Y2), U103B1.22 (CE#)
//RAM2CS_L: U100A1.13 (~Y2), U103A1.22 (CE#)
//RAM3CS_H: U100B1.12 (~Y3), U104B1.22 (CE#)
//RAM3CS_L: U100A1.12 (~Y3), U104A1.22 (CE#)
//RAM4CS_H: U100B1.11 (~Y4), U105B1.22 (CE#)
//RAM4CS_L: U100A1.11 (~Y4), U105A1.22 (CE#)
//RESET: J600.66
//UDS: J600.71, U100B1.5 (~E1)
//iord: J600.72
//iowr: J600.75
GND: C1.2, C2.2, C3.2, C4.2, C5.2, C6.2, C7.2, C8.2, C9.2, C10.2, C11.2, C12.2, J6.1, J7.1, J10.1, J11.1, J600.32, J600.64, J600.96, U100A1.8 (GND), U100B1.8 (GND), U101A1.16 (VSS), U101B1.16 (VSS), U102A1.16 (VSS), U102B1.16 (VSS), U103A1.16 (VSS), U103B1.16 (VSS), U104A1.16 (VSS), U104B1.16 (VSS), U105A1.16 (VSS), U105B1.16 (VSS)
unnamed: J1.2, U101B1.22 (CE#)
unnamed: J2.2, U100A1.6 (E2), U100B1.6 (E2)
unnamed: J4.2, J5.1
unnamed: J5.2, U100A1.1 (A0)
unnamed: J6.2, U100A1.2 (A1)
unnamed: J7.2, U100A1.3 (A2)
unnamed: J8.1, J9.2
unnamed: J8.2, U100B1.1 (A0)
unnamed: J10.2, U100B1.2 (A1)
unnamed: J11.2, U100B1.3 (A2)

Notes on the sheet:
J3 1-2 RAMxROM256 2-3 ROM512
J29 1-2 RAMxROM256 2-3 ROM512
15 14 13 12 11 10 9 8 7 6 5 4 3 2 1
Memory board - 100
J31 1-2 RAM 2-3 ROM512
J101A 1-2 68k 2-3 TI_8BITS
2026-03-14
1 2 3 4 5 6 7 8 9 10 11 12 13 14 15
Orion68-MEM
5 blocos de 2 soquetes 1 e 2 de 32 pinos cada Bloco 1 ROM ou RAM para cpu de 16 bits.(rom 28C64 ou 28c256 ou 29c512). ROm no soquete 1 e RAM no soquete 2 para cpu de 8bits( ROM 28c64, RAM 512K )
J30 1-2 ROM256 2-3 RAM E ROM512

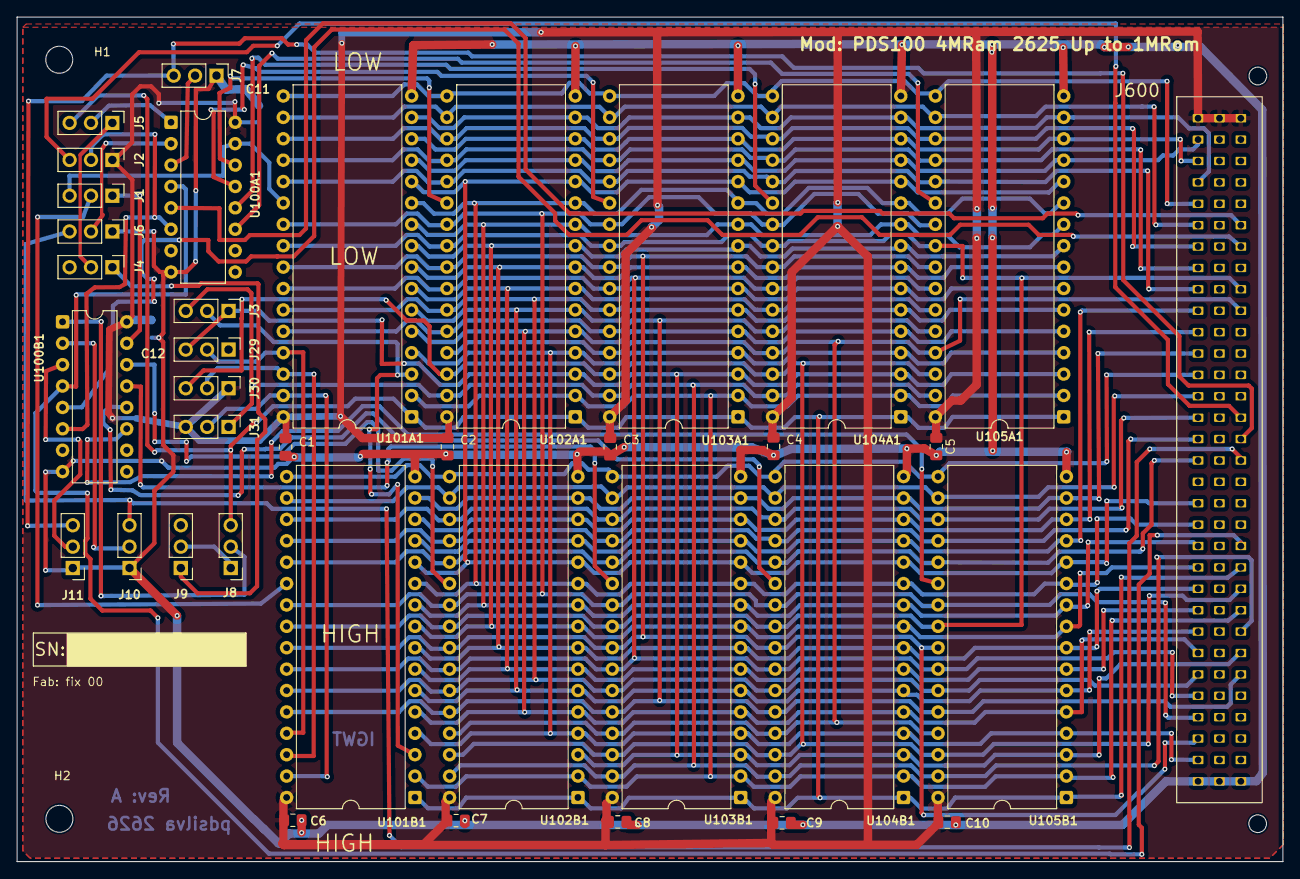
[picture p133: board mem_board.kicad_pcb from above]

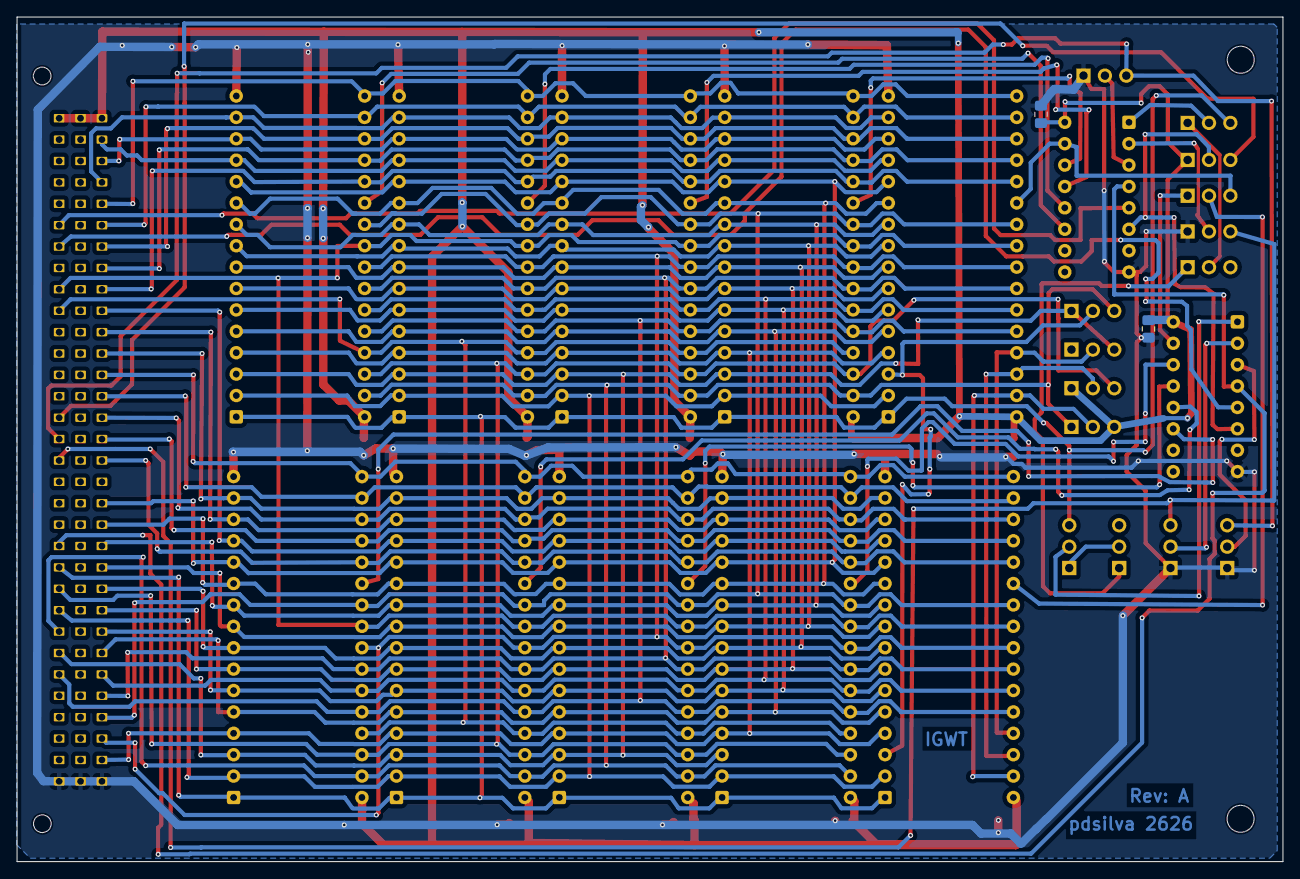
[picture p134: board mem_board.kicad_pcb from below]

Board: 2 copper layers, 150.3 x 100.3 mm, 43 parts (2 on the bottom side), 70 nets.
