ppsilv/Orion68/hardware/schematics/board_cpu/cpu_board.kicad_pcb

## KiCad design hardware/schematics/board_cpu/cpu_board.kicad_pcb (2026-09-06)

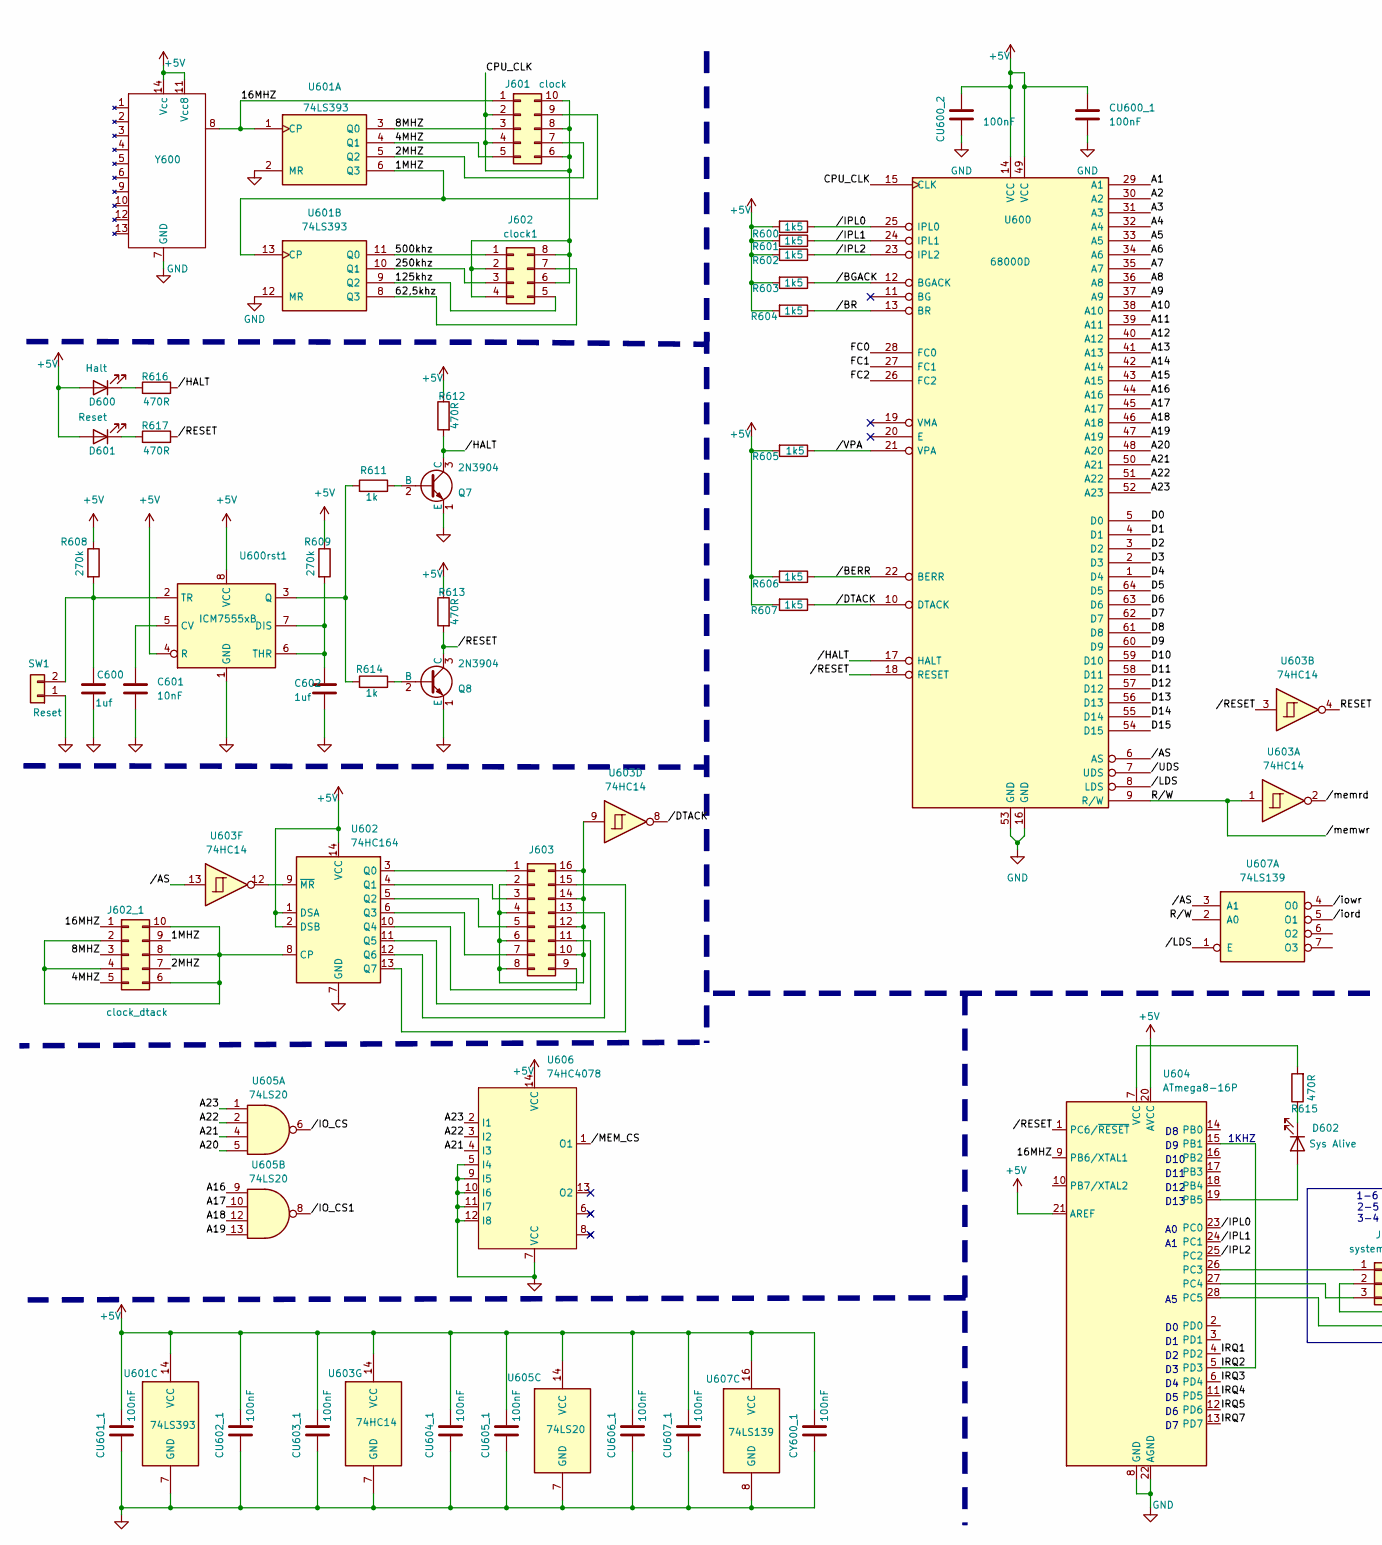
[picture p135: schematic cpu_board.kicad_sch, part in row 1, column 1]

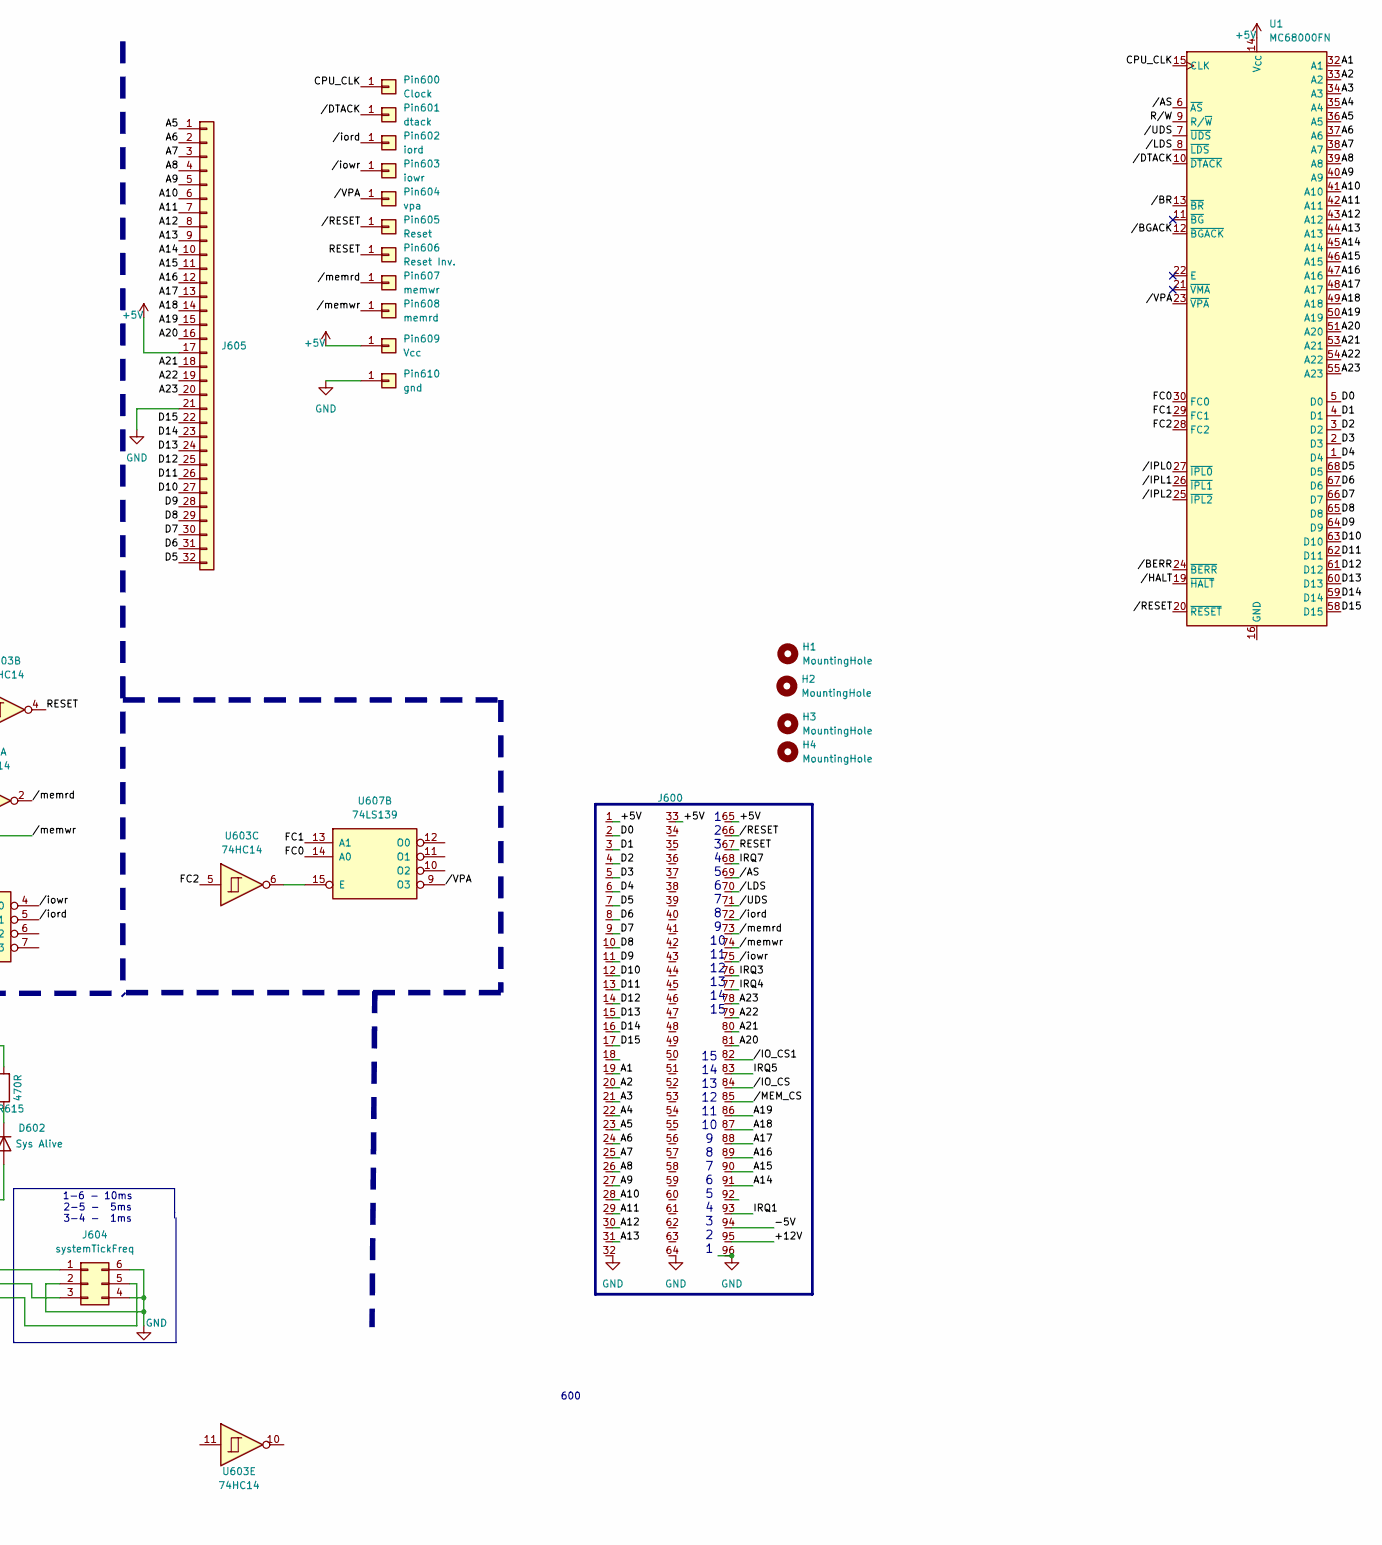
[picture p136: schematic cpu_board.kicad_sch, part in row 1, column 2]

Parts:
C600, C602: 1uf; CP_Radial_D8.0mm_P3.50mm
C601: 10nF; C_0603_1608Metric
CU600_1, CU600_2, CU601_1, CU602_1, CU603_1, CU604_1, CU605_1, CU606_1, CU607_1: 100nF; C_0805_2012Metric
CY600_1: 100nF; C_0805_2012Metric
D600: Halt; PinHeader_1x02_P2.54mm_Vertical
D601: Reset; PinHeader_1x02_P2.54mm_Vertical
D602: Sys Alive; PinHeader_1x02_P2.54mm_Vertical
H1, H2: MountingHole; MountingHole_3.2mm_M3
H3, H4: MountingHole; MountingHole_2.1mm
J600: Euro96pin; conn_euro96
J601: clock; PinHeader_2x05_P2.54mm_Vertical
J602: clock1; PinHeader_2x04_P2.54mm_Vertical
J602_1: clock_dtack; PinHeader_2x05_P2.54mm_Vertical
J603: Conn_02x08_Counter_Clockwise; PinHeader_2x08_P2.54mm_Vertical
J604: systemTickFreq; PinHeader_2x03_P2.54mm_Vertical
J605: Conn_01x32; PinHeader_1x32_P2.54mm_Vertical
Pin600: Clock; PinHeader_1x01_P2.54mm_Vertical
Pin601: dtack; PinHeader_1x01_P2.54mm_Vertical
Pin602: iord; PinHeader_1x01_P2.54mm_Vertical
Pin603: iowr; PinHeader_1x01_P2.54mm_Vertical
Pin604: vpa; PinHeader_1x01_P2.54mm_Vertical
Pin605: Reset; PinHeader_1x01_P2.54mm_Vertical
Pin606: Reset Inv.; PinHeader_1x01_P2.54mm_Vertical
Pin607: memwr; PinHeader_1x01_P2.54mm_Vertical
Pin608: memrd; PinHeader_1x01_P2.54mm_Vertical
Pin609: Vcc; PinHeader_1x01_P2.54mm_Vertical
Pin610: gnd; PinHeader_1x01_P2.54mm_Vertical
Q7, Q8: 2N3904; TO-92_Inline
R600, R601, R602, R603, R604, R605, R606, R607: 1k5; R_0805_2012Metric
R608, R609: 270k; R_Axial_DIN0204_L3.6mm_D1.6mm_P5.08mm_Horizontal
R611, R614: 1k; R_Axial_DIN0204_L3.6mm_D1.6mm_P5.08mm_Horizontal
R612, R613, R615, R616, R617: 470R; R_Axial_DIN0204_L3.6mm_D1.6mm_P5.08mm_Horizontal
SW1: Reset; PinHeader_1x02_P2.54mm_Vertical
U1: MC68000FN; PLCC-68_THT-Socket
U600: 68000D; DIP-64_W22.86mm
U600rst1: ICM7555xB; DIP-8_W7.62mm
U601: 74LS393; DIP-14_W7.62mm
U602: 74HC164; DIP-14_W7.62mm
U603: 74HC14; DIP-14_W7.62mm
U604: ATmega8-16P; DIP-28_W7.62mm
U605: 74LS20; DIP-14_W7.62mm
U606: 74HC4078; DIP-14_W7.62mm
U607: 74LS139; DIP-16_W7.62mm
Y600: DIP-14_W7.62mm

Connections:
+5V: CU600_1.1, CU600_2.1, CU601_1.1, CU602_1.1, CU603_1.1, CU604_1.1, CU605_1.1, CU606_1.1, CU607_1.1, CY600_1.1, D600.2 (A), D601.2 (A), J600.1, J600.33, J600.65, J605.17, Pin609.1, R600.2, R601.2, R602.2, R603.2, R604.2, R605.2, R606.2, R607.2, R608.1, R609.1, R612.1, R613.1, U1.14 (V_{CC}), U1.52 (V_{CC}), U600.14 (VCC), U600.49 (VCC), U600rst1.4 (R), U600rst1.8 (VCC), U601.14 (VCC), U602.1 (DSA), U602.2 (DSB), U602.14 (VCC), U603.14 (VCC), U604.20 (AVCC), U604.21 (AREF), U605.14 (VCC), U606.14 (VCC), U607.16 (VCC), Y600.11 (Vcc8), Y600.14 (Vcc)
/1MHZ: J601.9, J602_1.9, U601.6 (Q3), U601.13 (CP)
/2MHZ: J601.7, J602_1.7, U601.5 (Q2)
/4MHZ: J601.5, J602_1.5, U601.4 (Q1)
/8MHZ: J601.3, J602_1.3, U601.3 (Q0)
/16MHZ: J601.1, J602_1.1, U601.1 (CP), U604.9 (PB6/XTAL1), Y600.8
/62,5khz: J602.7, U601.8 (Q3)
/125khz: J602.5, U601.9 (Q2)
/250khz: J602.3, U601.10 (Q1)
/500khz: J602.1, U601.11 (Q0)
/+12V: J600.95
/-5V: J600.94
/A1: J600.19, U1.32 (A1), U600.29 (A1)
/A2: J600.20, U1.33 (A2), U600.30 (A2)
/A3: J600.21, U1.34 (A3), U600.31 (A3)
/A4: J600.22, U1.35 (A4), U600.32 (A4)
/A5: J600.23, J605.1, U1.36 (A5), U600.33 (A5)
/A6: J600.24, J605.2, U1.37 (A6), U600.34 (A6)
/A7: J600.25, J605.3, U1.38 (A7), U600.35 (A7)
/A8: J600.26, J605.4, U1.39 (A8), U600.36 (A8)
/A9: J600.27, J605.5, U1.40 (A9), U600.37 (A9)
/A10: J600.28, J605.6, U1.41 (A10), U600.38 (A10)
/A11: J600.29, J605.7, U1.42 (A11), U600.39 (A11)
/A12: J600.30, J605.8, U1.43 (A12), U600.40 (A12)
/A13: J600.31, J605.9, U1.44 (A13), U600.41 (A13)
/A14: J600.91, J605.10, U1.45 (A14), U600.42 (A14)
/A15: J600.90, J605.11, U1.46 (A15), U600.43 (A15)
/A16: J600.89, J605.12, U1.47 (A16), U600.44 (A16), U605.9
/A17: J600.88, J605.13, U1.48 (A17), U600.45 (A17), U605.10
/A18: J600.87, J605.14, U1.49 (A18), U600.46 (A18), U605.12
/A19: J600.86, J605.15, U1.50 (A19), U600.47 (A19), U605.13
/A20: J600.81, J605.16, U1.51 (A20), U600.48 (A20), U605.5
/A21: J600.80, J605.18, U1.53 (A21), U600.50 (A21), U605.4, U606.4 (I3)
/A22: J600.79, J605.19, U1.54 (A22), U600.51 (A22), U605.2, U606.3 (I2)
/A23: J600.78, J605.20, U1.55 (A23), U600.52 (A23), U605.1, U606.2 (I1)
/CPU_CLK: J601.2, J601.4, J601.6, J601.8, J601.10, J602.2, J602.4, J602.6, J602.8, Pin600.1, U1.15 (CLK), U600.15 (CLK)
/D0: J600.2, U1.5 (D0), U600.5 (D0)
/D1: J600.3, U1.4 (D1), U600.4 (D1)
/D2: J600.4, U1.3 (D2), U600.3 (D2)
/D3: J600.5, U1.2 (D3), U600.2 (D3)
/D4: J600.6, U1.1 (D4), U600.1 (D4)
/D5: J600.7, J605.32, U1.68 (D5), U600.64 (D5)
/D6: J600.8, J605.31, U1.67 (D6), U600.63 (D6)
/D7: J600.9, J605.30, U1.66 (D7), U600.62 (D7)
/D8: J600.10, J605.29, U1.65 (D8), U600.61 (D8)
/D9: J600.11, J605.28, U1.64 (D9), U600.60 (D9)
/D10: J600.12, J605.27, U1.63 (D10), U600.59 (D10)
/D11: J600.13, J605.26, U1.62 (D11), U600.58 (D11)
/D12: J600.14, J605.25, U1.61 (D12), U600.57 (D12)
/D13: J600.15, J605.24, U1.60 (D13), U600.56 (D13)
/D14: J600.16, J605.23, U1.59 (D14), U600.55 (D14)
/D15: J600.17, J605.22, U1.58 (D15), U600.54 (D15)
/FC0: U1.30 (FC0), U600.28 (FC0), U607.14 (A0)
/FC1: U1.29 (FC1), U600.27 (FC1), U607.13 (A1)
/FC2: U1.28 (FC2), U600.26 (FC2), U603.5
/IRQ1: J600.93, U604.4 (PD2)
/IRQ2: U604.5 (PD3), U604.15 (PB1)
/IRQ3: J600.76, U604.6 (PD4)
/IRQ4: J600.77, U604.11 (PD5)
/IRQ5: J600.83, U604.12 (PD6)
/IRQ7: J600.68, U604.13 (PD7)
/RESET: J600.67, Pin606.1, U603.4
/R/W: J600.74, Pin608.1, U1.9 (R/~W), U600.9 (R/W), U603.1, U607.2 (A0)
//AS: J600.69, U1.6 (~AS), U600.6 (AS), U603.13, U607.3 (A1)
//BERR: R606.1, U1.24 (~BERR), U600.22 (BERR)
//BGACK: R603.1, U1.12 (~BGACK), U600.12 (BGACK)
//BR: R604.1, U1.13 (~BR), U600.13 (BR)
//DTACK: Pin601.1, R607.1, U1.10 (~DTACK), U600.10 (DTACK), U603.8
//HALT: Q7.3 (C), R612.2, R616.2, U1.19 (~HALT), U600.17 (HALT)
//IO_CS: J600.84, U605.6
//IO_CS1: J600.82, U605.8
//IPL0: R600.1, U1.27 (~IPL0), U600.25 (IPL0), U604.23 (PC0)
//IPL1: R601.1, U1.26 (~IPL1), U600.24 (IPL1), U604.24 (PC1)
//IPL2: R602.1, U1.25 (~IPL2), U600.23 (IPL2), U604.25 (PC2)
//LDS: J600.70, U1.8 (~LDS), U600.8 (LDS), U607.1 (E)
//MEM_CS: J600.85, U606.1 (O1)
//RESET: J600.66, Pin605.1, Q8.3 (C), R613.2, R617.2, U1.20 (~RESET), U600.18 (RESET), U603.3, U604.1 (PC6/~RESET)
//UDS: J600.71, U1.7 (~UDS), U600.7 (UDS)
//VPA: Pin604.1, R605.1, U1.23 (~VPA), U600.21 (VPA), U607.9 (O3)
//iord: J600.72, Pin602.1, U607.5 (O1)
//iowr: J600.75, Pin603.1, U607.4 (O0)
//memrd: J600.73, Pin607.1, U603.2
GND: C600.2, C601.2, C602.2, CU600_1.2, CU600_2.2, CU601_1.2, CU602_1.2, CU603_1.2, CU604_1.2, CU605_1.2, CU606_1.2, CU607_1.2, CY600_1.2, J600.32, J600.64, J600.96, J604.2, J604.4, J604.6, J605.21, Pin610.1, Q7.1 (E), Q8.1 (E), SW1.1, U600.16 (GND), U600.53 (GND), U600rst1.1 (GND), U601.2 (MR), U601.7 (GND), U601.12 (MR), U602.7 (GND), U603.7 (GND), U604.8 (GND), U604.22 (AGND), U605.7 (GND), U606.5 (I4), U606.7 (VCC), U606.9 (I5), U606.10 (I6), U606.11 (I7), U606.12 (I8), U607.8 (GND), Y600.7 (GND)
unnamed: D600.1 (K), R616.1
unnamed: D601.1 (K), R617.1
unnamed: D602.2 (A), U604.19 (PB5)
unnamed: D602.1 (K), R615.1
unnamed: J602_1.2, J602_1.4, J602_1.6, J602_1.8, J602_1.10, U602.8 (CP)
unnamed: J603.1, U602.3 (Q0)
unnamed: J603.3, U602.4 (Q1)
unnamed: J603.5, U602.5 (Q2)
unnamed: J603.7, U602.6 (Q3)
unnamed: J603.9, U602.10 (Q4)
unnamed: J603.2, J603.4, J603.6, J603.8, J603.10, J603.12, J603.14, J603.16, U603.9
unnamed: J603.11, U602.11 (Q5)
unnamed: J603.13, U602.12 (Q6)
unnamed: J603.15, U602.13 (Q7)
unnamed: J604.1, U604.26 (PC3)
unnamed: J604.3, U604.27 (PC4)
unnamed: J604.5, U604.28 (PC5)
unnamed: Q7.2 (B), R611.1
unnamed: Q8.2 (B), R614.1
unnamed: C600.1, R608.2, SW1.2, U600rst1.2 (TR)
unnamed: U1.16 (GND), U1.17 (GND), U1.56 (GND), U1.57 (GND)
unnamed: C601.1, U600rst1.5 (CV)
unnamed: C602.1, R609.2, U600rst1.6 (THR), U600rst1.7 (DIS)
unnamed: R611.2, R614.2, U600rst1.3 (Q)
unnamed: U602.9 (~MR), U603.12
unnamed: R615.2, U604.7 (VCC)
unnamed: U603.6, U607.15 (E)

Notes on the sheet:
1 2 3 4 5 6 7 8 9 10 11 12 13 14 15
15 14 13 12 11 10 9 8 7 6 5 4 3 2 1
600
1KHZ
D11
D13
1-6 - 10ms 2-5 - 5ms 3-4 - 1ms
D12
D10

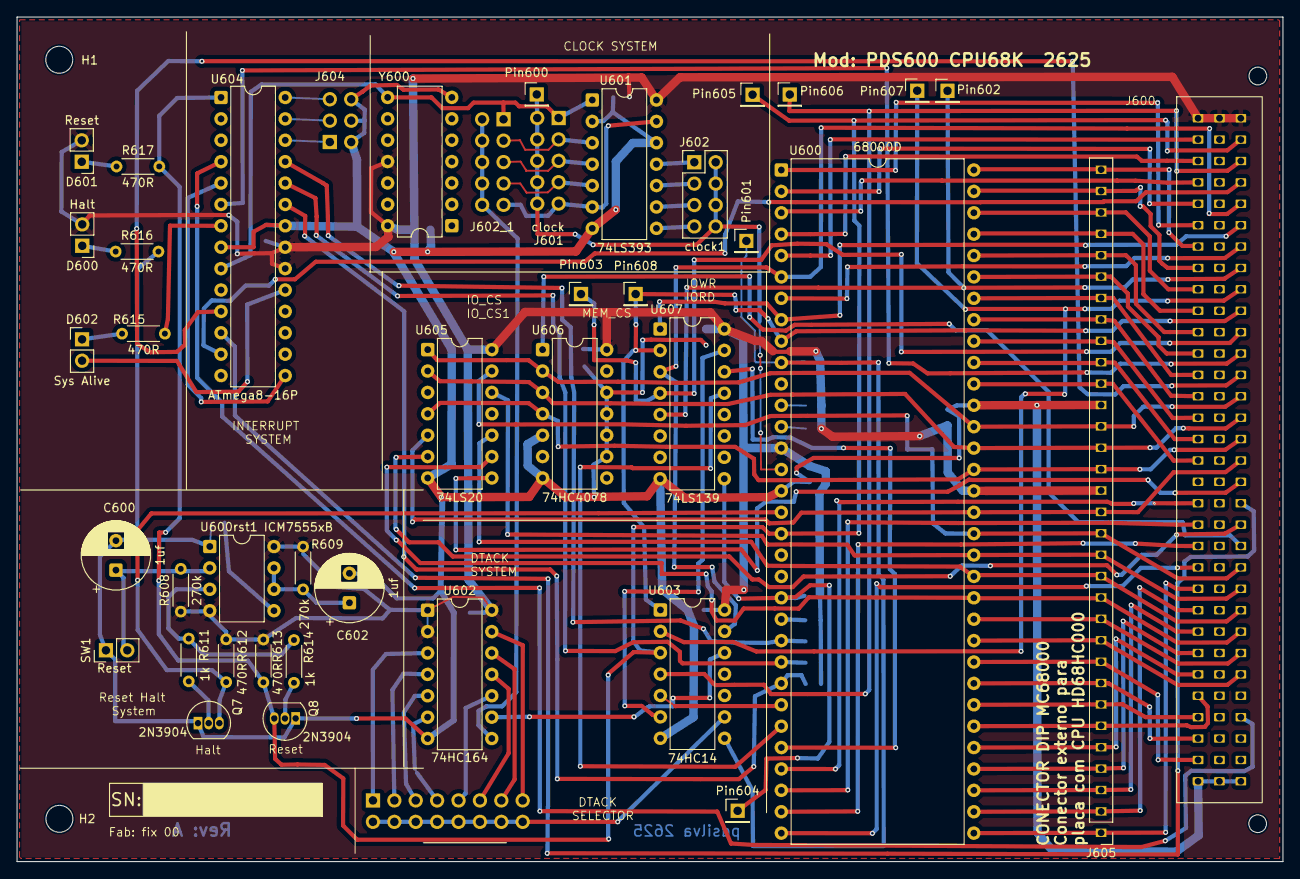
[picture p137: board hardware/schematics/board_cpu/cpu_board.kicad_pcb from above]

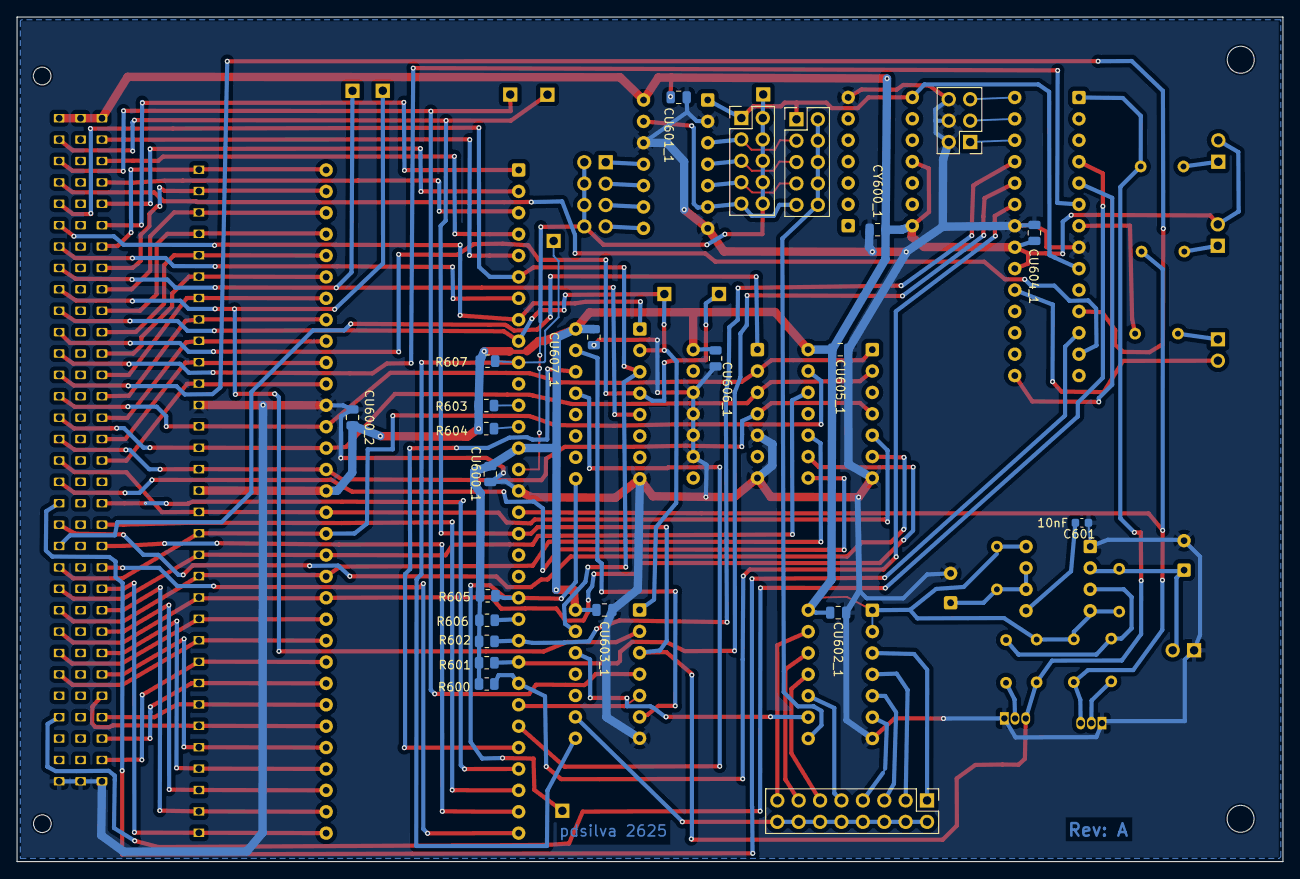
[picture p138: board hardware/schematics/board_cpu/cpu_board.kicad_pcb from below]

Board: 2 copper layers, 150.3 x 100.3 mm, 66 parts (23 on the bottom side), 107 nets.
