ppsilv/Orion68/hardware/schematics/Din41612_template/cpu_board.kicad_pcb

## KiCad design hardware/schematics/Din41612_template/cpu_board.kicad_pcb (2026-09-06)

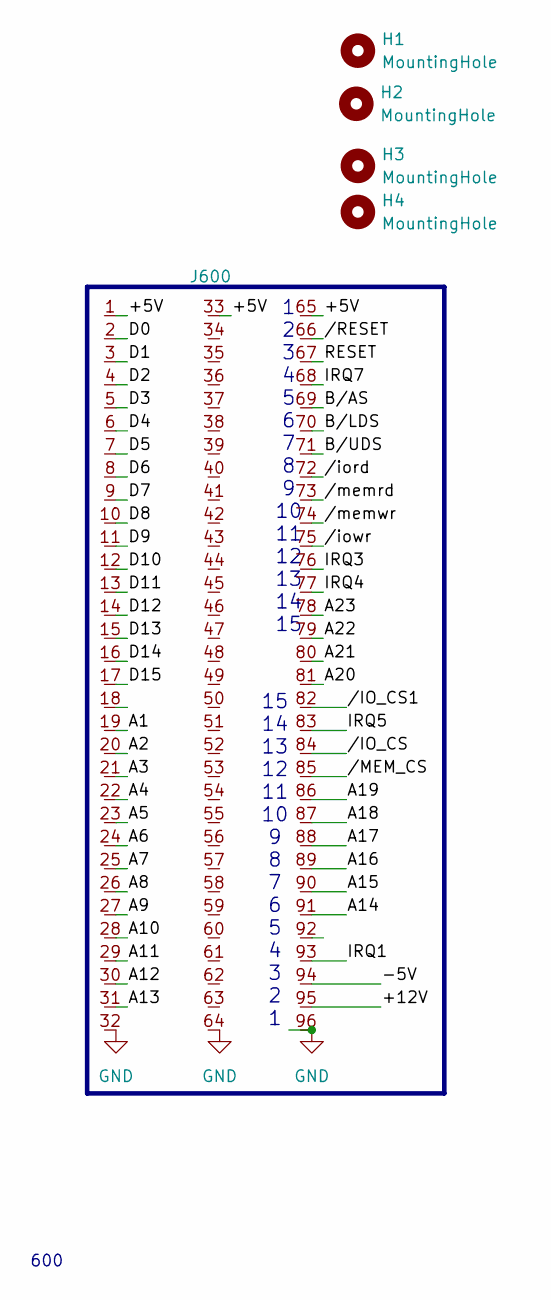
[picture p139: schematic cpu_board.kicad_sch]

Parts:
H1, H2: MountingHole; MountingHole_3.2mm_M3
H3, H4: MountingHole; MountingHole_2.1mm
J600: Euro96pin; conn_euro96

Connections:
/+5V: J600.1, J600.33, J600.65
/+12V: J600.95
/-5V: J600.94
/A1: J600.19
/A2: J600.20
/A3: J600.21
/A4: J600.22
/A5: J600.23
/A6: J600.24
/A7: J600.25
/A8: J600.26
/A9: J600.27
/A10: J600.28
/A11: J600.29
/A12: J600.30
/A13: J600.31
/A14: J600.91
/A15: J600.90
/A16: J600.89
/A17: J600.88
/A18: J600.87
/A19: J600.86
/A20: J600.81
/A21: J600.80
/A22: J600.79
/A23: J600.78
/B/AS: J600.69
/B/LDS: J600.70
/B/UDS: J600.71
/D0: J600.2
/D1: J600.3
/D2: J600.4
/D3: J600.5
/D4: J600.6
/D5: J600.7
/D6: J600.8
/D7: J600.9
/D8: J600.10
/D9: J600.11
/D10: J600.12
/D11: J600.13
/D12: J600.14
/D13: J600.15
/D14: J600.16
/D15: J600.17
/IRQ1: J600.93
/IRQ3: J600.76
/IRQ4: J600.77
/IRQ5: J600.83
/IRQ7: J600.68
/RESET: J600.67
//IO_CS: J600.84
//IO_CS1: J600.82
//MEM_CS: J600.85
//RESET: J600.66
//iord: J600.72
//iowr: J600.75
//memrd: J600.73
//memwr: J600.74
GND: J600.32, J600.64, J600.96

Notes on the sheet:
1 2 3 4 5 6 7 8 9 10 11 12 13 14 15
15 14 13 12 11 10 9 8 7 6 5 4 3 2 1
600

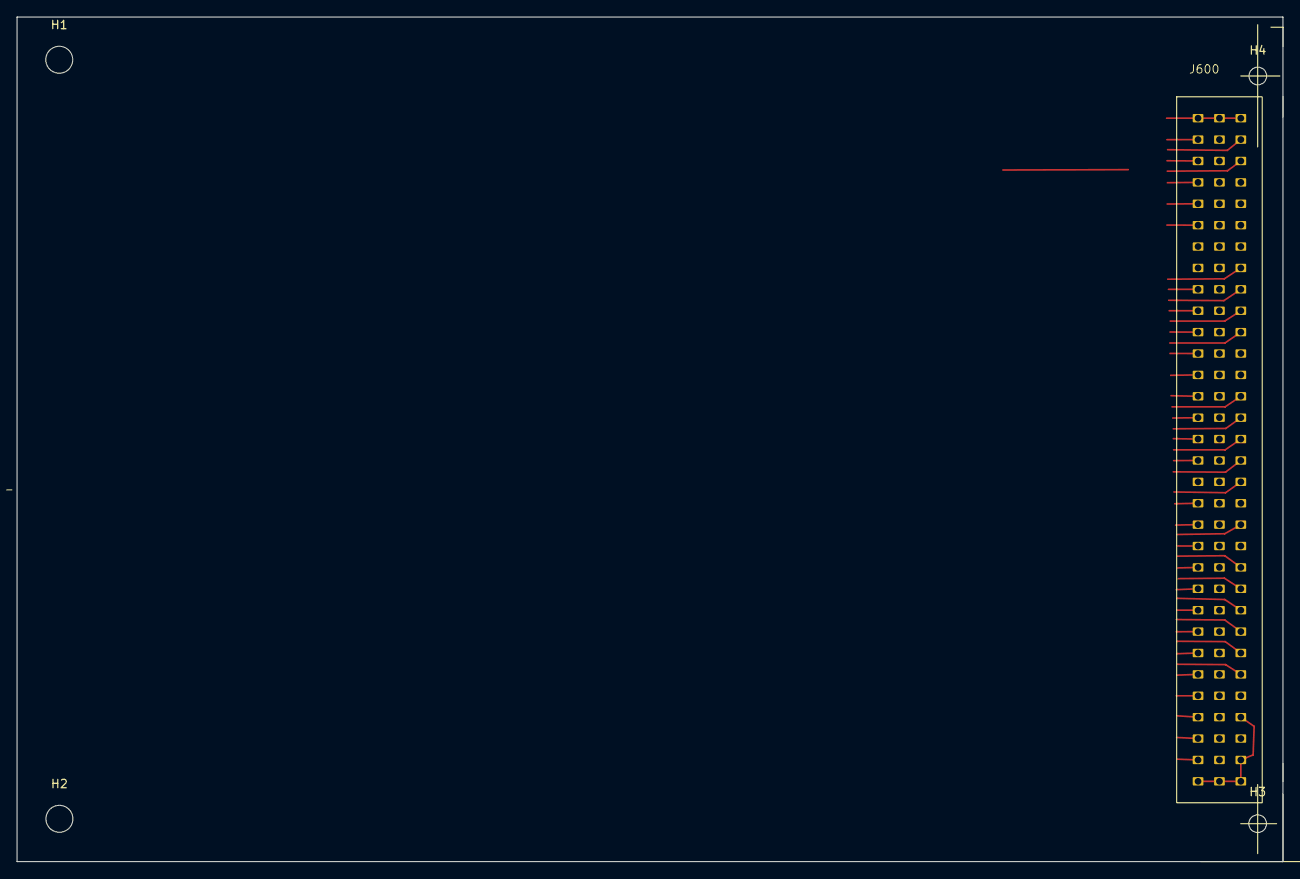
[picture p140: board hardware/schematics/Din41612_template/cpu_board.kicad_pcb from above]

Board: 2 copper layers, 150.3 x 100.3 mm, 5 parts (0 on the bottom side), 2 nets.
