ppsilv/Orion68/hardware/schematics/Orion68/Orion68.kicad_pcb

## KiCad design hardware/schematics/Orion68/Orion68.kicad_pcb (2026-09-06)

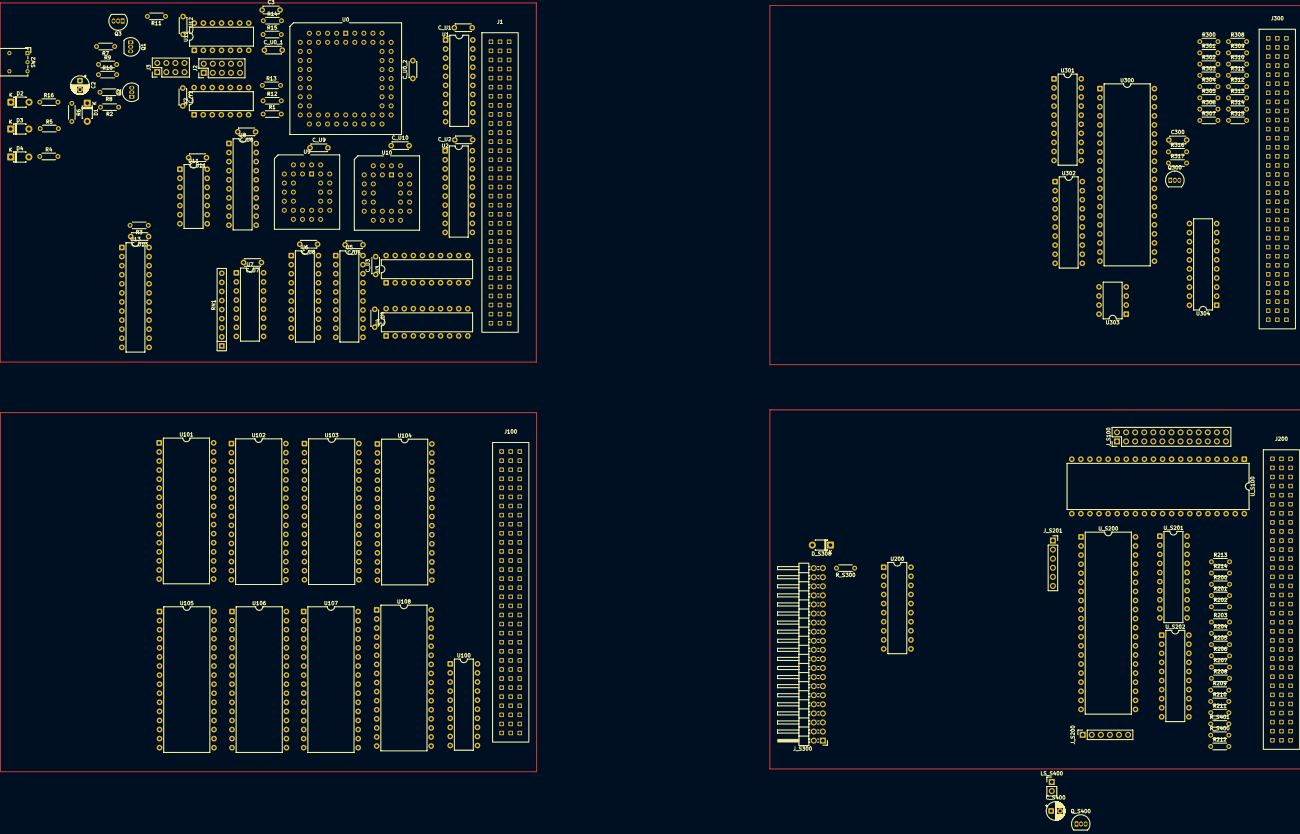
[picture p141: board Orion68.kicad_pcb from above]

Board: 2 copper layers, 129 parts (0 on the bottom side), 328 nets, no tracks yet.

Parts:
C2: 10uF; CP_Radial_D5.0mm_P2.50mm
C3, C300: 10pF; C_Disc_D4.3mm_W1.9mm_P5.00mm
C_S400: 100uF; CP_Radial_D5.0mm_P2.50mm
C_U0_1, C_U0_2, C_U1, C_U2, C_U3, C_U4, C_U5, C_U6, C_U7, C_U8, C_U9, C_U10, C_U11, C_U12, C_U13: 100nF; C_Disc_D4.3mm_W1.9mm_P5.00mm
C_Y1: 100nF; C_Disc_D4.3mm_W1.9mm_P5.00mm
D1: 1N4148WT; D_T-1_P5.08mm_Horizontal
D2: Led_Halt; D_T-1_P5.08mm_Horizontal
D3: Led_Reset; D_T-1_P5.08mm_Horizontal
D4: Led_Boot; D_T-1_P5.08mm_Horizontal
D_S300: LED; D_T-1_P5.08mm_Horizontal
J1, J100, J200, J300: Euro96pin; conn_euro96
J2: clock; PinHeader_2x05_P2.54mm_Vertical
J3: clock1; PinHeader_2x04_P2.54mm_Vertical
J_S100: DB25_Socket; PinHeader_2x13_P2.54mm_Vertical
J_S200: sdcard; PinSocket_1x06_P2.54mm_Vertical
J_S201: RTC; PinSocket_1x06_P2.54mm_Vertical
J_S300: IDE; PinHeader_2x20_P2.54mm_Horizontal
LS_S400: Speaker; PinHeader_1x02_P2.54mm_Vertical
Q1, Q2, Q3, Q300: 2N3904; TO-92_Inline
Q_S400: NPN; TO-92L_Inline
R1, R3, R12, R13, R15, R213, R214: 4k7; R_Axial_DIN0204_L3.6mm_D1.6mm_P5.08mm_Horizontal
R2: 220R; R_Axial_DIN0204_L3.6mm_D1.6mm_P5.08mm_Horizontal
R4, R5, R16: 270R; R_Axial_DIN0204_L3.6mm_D1.6mm_P5.08mm_Horizontal
R6: 10k; R_Axial_DIN0204_L3.6mm_D1.6mm_P5.08mm_Horizontal
R7, R8, R14, R200, R201, R202, R203, R204, R205, R206, R207, R208, R209, R210, R211, R212, R300, R301, R302, R303, R304, R305, R306, R307, R308, R309, R310, R311, R312, R317: 1k; R_Axial_DIN0204_L3.6mm_D1.6mm_P5.08mm_Horizontal
R9, R10, R11, R316: 470R; R_Axial_DIN0204_L3.6mm_D1.6mm_P5.08mm_Horizontal
R313, R314, R315: 330R; R_Axial_DIN0204_L3.6mm_D1.6mm_P5.08mm_Horizontal
RN1: 5k6; R_Array_SIP9
R_S300: 1k; R_Axial_DIN0204_L3.6mm_D1.6mm_P5.08mm_Horizontal
R_S400: 47R; R_Axial_DIN0204_L3.6mm_D1.6mm_P5.08mm_Horizontal
R_S401: 1K; R_Axial_DIN0204_L3.6mm_D1.6mm_P5.08mm_Horizontal
SW2: sw_reset; SW_Lever_1P2T_NKK_GW12LxH
U0: MC68000FN; PLCC-68_THT-Socket
U1, U2: 74LS245; DIP-20_W7.62mm
U3, U4, U5, U6: 74LS541; DIP-20_W7.62mm
U7: 74LS148; DIP-16_W7.62mm
U8, U100, U200, U304: GAL16V8; DIP-20_W7.62mm
U9, U10: SST39SF010; PLCC-32_THT-Socket
U11: 74HC74; DIP-14_W7.62mm
U12: 74LS393; DIP-14_W7.62mm
U13: PAL20RS10; DIP-24_W7.62mm
U101, U103, U105, U107: RAM_LOW; DIP-32_W15.24mm
U102, U104, U106, U108: RAM_HIGH; DIP-32_W15.24mm
U300: DIP-40_W15.24mm
U301, U302: 74HC245; DIP-20_W7.62mm
U303: 24LC256; DIP-8_W7.62mm
U_S100: 82C55A; DIP-40_W15.24mm
U_S200: Multio; DIP-40_W15.24mm
U_S201, U_S202: 74HC245; DIP-20_W7.62mm
Y2: DIP-14_W7.62mm

Connections:
+5V: C2.1, C_U0_1.1, C_U0_2.1, C_U1.1, C_U2.1, C_U3.1, C_U4.1, C_U5.1, C_U6.1, C_U7.1, C_U8.1, C_U9.1, C_U10.1, C_U11.1, C_U12.1, C_U13.1, C_Y1.1, D_S300.2 (A), J1.1, J1.33, J1.65, J100.1, J100.33, J100.65, J200.1, J200.33, J200.65, J300.1, J300.33, J300.65, J_S200.2, J_S300.38, R1.1, R3.1, R5.2, R9.1, R10.1, R11.1, R12.1, R13.1, R15.1, R16.2, R213.1, R214.1, RN1.1 (common), R_S400.1, SW2.2, U0.14 (V_{CC}), U0.52 (V_{CC}), U1.20 (VCC), U2.20 (VCC), U3.20 (VCC), U4.20 (VCC), U5.20 (VCC), U6.20 (VCC), U7.16 (VCC), U8.20 (VCC), U9.31 (PGM), U9.32 (VCC), U10.31 (PGM), U10.32 (VCC), U11.1 (~R), U11.14 (VCC), U12.14 (VCC), U13.24 (VCC), U100.20 (VCC), U101.32 (VCC), U102.32 (VCC), U103.32 (VCC), U104.32 (VCC), U105.32 (VCC), U106.32 (VCC), U107.32 (VCC), U108.32 (VCC), U200.20 (VCC), U300.39 (VSYS), U304.20 (VCC), U_S100.26 (VCC), Y2.11 (Vcc8), Y2.14 (Vcc)
/Orion68-CPU-2/1MHZ: J2.9, U12.6 (Q3), U12.13 (CP)
/Orion68-CPU-2/2MHZ: J2.7, U12.5 (Q2)
/Orion68-CPU-2/4MHZ: J2.5, U8.1 (I1/CLK), U12.4 (Q1)
/Orion68-CPU-2/8MHZ: J2.3, U12.3 (Q0)
/Orion68-CPU-2/16MHZ: J2.1, U12.1 (CP), Y2.8
/Orion68-CPU-2/62,5khz: J3.4, U12.8 (Q3)
/Orion68-CPU-2/125khz: J3.3, U12.9 (Q2)
/Orion68-CPU-2/250khz: J3.2, U12.10 (Q1)
/Orion68-CPU-2/500khz: J3.1, U12.11 (Q0)
/Orion68-CPU-2/<NO NET>: U0.26 (~IPL1), U13.21 (O2)
/Orion68-CPU-2/A0_148: U7.9 (S0), U13.2 (I0)
/Orion68-CPU-2/A1: U0.32 (A1), U3.2 (A0), U9.12 (A0), U10.12 (A0), U13.10 (I8)
/Orion68-CPU-2/A1_148: U7.7 (S1), U13.3 (I1)
/Orion68-CPU-2/A2: U0.33 (A2), U3.3 (A1), U9.11 (A1), U10.11 (A1), U13.11 (I9)
/Orion68-CPU-2/A2_148: U7.6 (S2), U13.4 (I2)
/Orion68-CPU-2/A3: U0.34 (A3), U3.4 (A2), U9.10 (A2), U10.10 (A2), U13.13 (~OE)
/Orion68-CPU-2/A4: U0.35 (A4), U3.5 (A3), U9.9 (A3), U10.9 (A3)
/Orion68-CPU-2/A5: U0.36 (A5), U3.6 (A4), U9.8 (A4), U10.8 (A4)
/Orion68-CPU-2/A6: U0.37 (A6), U3.7 (A5), U9.7 (A5), U10.7 (A5)
/Orion68-CPU-2/A7: U0.38 (A7), U3.8 (A6), U9.6 (A6), U10.6 (A6)
/Orion68-CPU-2/A8: U0.39 (A8), U3.9 (A7), U9.5 (A7), U10.5 (A7)
/Orion68-CPU-2/A9: U0.40 (A9), U4.2 (A0), U9.27 (A8), U10.27 (A8)
/Orion68-CPU-2/A10: U0.41 (A10), U4.3 (A1), U9.26 (A9), U10.26 (A9)
/Orion68-CPU-2/A11: U0.42 (A11), U4.4 (A2), U9.23 (A10), U10.23 (A10)
/Orion68-CPU-2/A12: U0.43 (A12), U4.5 (A3), U9.25 (A11), U10.25 (A11)
/Orion68-CPU-2/A13: U0.44 (A13), U4.6 (A4), U9.4 (A12), U10.4 (A12)
/Orion68-CPU-2/A14: U0.45 (A14), U4.7 (A5), U9.28 (A13), U10.28 (A13)
/Orion68-CPU-2/A15: U0.46 (A15), U4.8 (A6), U9.29 (A14), U10.29 (A14)
/Orion68-CPU-2/A16: U0.47 (A16), U4.9 (A7), U9.3 (A15), U10.3 (A15)
/Orion68-CPU-2/A17: U0.48 (A17), U5.2 (A0), U9.2 (A16), U10.2 (A16)
/Orion68-CPU-2/A18: U0.49 (A18), U5.3 (A1)
/Orion68-CPU-2/A19: U0.50 (A19), U5.4 (A2)
/Orion68-CPU-2/A20: U0.51 (A20), U5.5 (A3), U8.2 (I2)
/Orion68-CPU-2/A21: U0.53 (A21), U5.6 (A4), U8.3 (I3)
/Orion68-CPU-2/A22: U0.54 (A22), U5.7 (A5), U8.4 (I4)
/Orion68-CPU-2/A23: U0.55 (A23), U5.8 (A6), U8.5 (I5)
/Orion68-CPU-2/BA1: J1.19, U3.18 (Y0)
/Orion68-CPU-2/BA2: J1.20, U3.17 (Y1)
/Orion68-CPU-2/BA3: J1.21, U3.16 (Y2)
/Orion68-CPU-2/BA4: J1.22, U3.15 (Y3)
/Orion68-CPU-2/BA5: J1.23, U3.14 (Y4)
/Orion68-CPU-2/BA6: J1.24, U3.13 (Y5)
/Orion68-CPU-2/BA7: J1.25, U3.12 (Y6)
/Orion68-CPU-2/BA8: J1.26, U3.11 (Y7)
/Orion68-CPU-2/BA9: J1.27, U4.18 (Y0)
/Orion68-CPU-2/BA10: J1.28, U4.17 (Y1)
/Orion68-CPU-2/BA11: J1.29, U4.16 (Y2)
/Orion68-CPU-2/BA12: J1.30, U4.15 (Y3)
/Orion68-CPU-2/BA13: J1.31, U4.14 (Y4)
/Orion68-CPU-2/BA14: J1.63, U4.13 (Y5)
/Orion68-CPU-2/BA15: J1.62, U4.12 (Y6)
/Orion68-CPU-2/BA16: J1.61, U4.11 (Y7)
/Orion68-CPU-2/BA17: J1.60, U5.18 (Y0)
/Orion68-CPU-2/BA18: J1.59, U5.17 (Y1)
/Orion68-CPU-2/BA19: J1.58, U5.16 (Y2)
/Orion68-CPU-2/BA20: J1.57, U5.15 (Y3)
/Orion68-CPU-2/BA21: J1.56, U5.14 (Y4)
/Orion68-CPU-2/BA22: J1.55, U5.13 (Y5)
/Orion68-CPU-2/BA23: J1.54, U5.12 (Y6)
/Orion68-CPU-2/BD0: J1.2, U1.18 (B0)
/Orion68-CPU-2/BD1: J1.3, U1.17 (B1)
/Orion68-CPU-2/BD2: J1.4, U1.16 (B2)
/Orion68-CPU-2/BD3: J1.5, U1.15 (B3)
/Orion68-CPU-2/BD4: J1.6, U1.14 (B4)
/Orion68-CPU-2/BD5: J1.7, U1.13 (B5)
/Orion68-CPU-2/BD6: J1.8, U1.12 (B6)
/Orion68-CPU-2/BD7: J1.9, U1.11 (B7)
/Orion68-CPU-2/BD8: J1.10, U2.18 (B0)
/Orion68-CPU-2/BD9: J1.11, U2.17 (B1)
/Orion68-CPU-2/BD10: J1.12, U2.16 (B2)
/Orion68-CPU-2/BD11: J1.13, U2.15 (B3)
/Orion68-CPU-2/BD12: J1.14, U2.14 (B4)
/Orion68-CPU-2/BD13: J1.15, U2.13 (B5)
/Orion68-CPU-2/BD14: J1.16, U2.12 (B6)
/Orion68-CPU-2/BD15: J1.17, U2.11 (B7)
/Orion68-CPU-2/BOOTIN: J1.87, R4.2, U8.9 (I9), U11.5 (Q)
/Orion68-CPU-2/B/AS: J1.43, U6.18 (Y0)
/Orion68-CPU-2/B/LDS: J1.70, U6.16 (Y2)
/Orion68-CPU-2/B/UDS: J1.71, U6.17 (Y1)
/Orion68-CPU-2/B/cpurd: J1.45, U6.15 (Y3)
/Orion68-CPU-2/B/cpuwr: J1.46, U6.14 (Y4)
/Orion68-CPU-2/CPU_CLK: J1.81, J2.2, J2.4, J2.6, J2.8, J2.10, U0.15 (CLK)
/Orion68-CPU-2/D0: U0.5 (D0), U1.2 (A0), U9.13 (D0)
/Orion68-CPU-2/D1: U0.4 (D1), U1.3 (A1), U9.14 (D1)
/Orion68-CPU-2/D2: U0.3 (D2), U1.4 (A2), U9.15 (D2)
/Orion68-CPU-2/D3: U0.2 (D3), U1.5 (A3), U9.17 (D3)
/Orion68-CPU-2/D4: U0.1 (D4), U1.6 (A4), U9.18 (D4)
/Orion68-CPU-2/D5: U0.68 (D5), U1.7 (A5), U9.19 (D5)
/Orion68-CPU-2/D6: U0.67 (D6), U1.8 (A6), U9.20 (D6)
/Orion68-CPU-2/D7: U0.66 (D7), U1.9 (A7), U9.21 (D7)
/Orion68-CPU-2/D8: U0.65 (D8), U2.2 (A0), U10.13 (D0)
/Orion68-CPU-2/D9: U0.64 (D9), U2.3 (A1), U10.14 (D1)
/Orion68-CPU-2/D10: U0.63 (D10), U2.4 (A2), U10.15 (D2)
/Orion68-CPU-2/D11: U0.62 (D11), U2.5 (A3), U10.17 (D3)
/Orion68-CPU-2/D12: U0.61 (D12), U2.6 (A4), U10.18 (D4)
/Orion68-CPU-2/D13: U0.60 (D13), U2.7 (A5), U10.19 (D5)
/Orion68-CPU-2/D14: U0.59 (D14), U2.8 (A6), U10.20 (D6)
/Orion68-CPU-2/D15: U0.58 (D15), U2.9 (A7), U10.21 (D7)
/Orion68-CPU-2/GS_148: U7.14 (GS), U13.5 (I3)
/Orion68-CPU-2/PWR_GOOD: J1.88, R2.1
/Orion68-CPU-2/RESET: J1.67, U8.14 (IO6)
/Orion68-CPU-2/R/W: C3.2, R14.2, U0.9 (R/~W), U6.6 (A4)
/Orion68-CPU-2/TICK_IN: J1.86, R3.2, U13.1 (CLK)
/Orion68-CPU-2/cpu_fc0: U0.30 (FC0), U6.7 (A5), U13.6 (I4)
/Orion68-CPU-2/cpu_fc1: U0.29 (FC1), U6.8 (A6), U13.7 (I5)
/Orion68-CPU-2/cpu_fc2: U0.28 (FC2), U6.9 (A7), U13.8 (I6)
/Orion68-CPU-2//AS: U0.6 (~AS), U1.19 (CE), U2.19 (CE), U3.1 (G1), U4.1 (G1), U5.1 (G1), U6.1 (G1), U6.2 (A0), U8.6 (I6)
/Orion68-CPU-2//BERR: J1.68, R1.2, U0.24 (~BERR)
/Orion68-CPU-2//DTACK: U0.10 (~DTACK), U8.13 (IO7)
/Orion68-CPU-2//HALT: D2.1 (K), J1.53, Q1.3 (C), R9.2, U0.19 (~HALT)
/Orion68-CPU-2//IO_CS: J1.85, U8.17 (I03)
/Orion68-CPU-2//KILLBT: U8.16 (IO4), U11.3 (C)
/Orion68-CPU-2//LDS: U0.8 (~LDS), U6.4 (A2), U9.24 (OE)
/Orion68-CPU-2//RESET: D3.1 (K), J1.66, Q2.3 (C), R10.2, U0.20 (~RESET), U8.8 (I8), U11.4 (~S)
/Orion68-CPU-2//ROM_CS: U8.19 (IO1), U9.22 (CE), U10.22 (CE)
/Orion68-CPU-2//UDS: U0.7 (~UDS), U6.3 (A1), U10.24 (OE)
/Orion68-CPU-2//bus_enable: U3.19 (G2), U4.19 (G2), U5.19 (G2), U6.19 (G2), U8.12 (IO8)
/Orion68-CPU-2//cpu_ipl0: U0.27 (~IPL0), U13.22 (O1)
/Orion68-CPU-2//cpu_ipl2: U0.25 (~IPL2), U13.20 (O3)
/Orion68-CPU-2//cpurd: Q3.3 (C), R11.2, U1.1 (A->B), U2.1 (A->B), U6.5 (A3)
/Orion68-IO/3V3_from_sdcard: U_S200.39 (VSYS), U_S201.20 (VCC), U_S202.20 (VCC)
/Orion68-IO/BA1: J200.19, J_S300.35, R208.1, U_S100.9 (A0)
/Orion68-IO/BA2: J200.20, J_S300.33, R209.1, U_S100.8 (A1)
/Orion68-IO/BA3: J200.21, J_S300.36, R210.1
/Orion68-IO/BA4: J200.22, R211.1
/Orion68-IO/BA5: J200.23, R212.1
/Orion68-IO/BD0: J200.2, J_S300.4, R200.1, U_S100.34 (D0)
/Orion68-IO/BD1: J200.3, J_S300.6, R201.1, U_S100.33 (D1)
/Orion68-IO/BD2: J200.4, J_S300.8, R202.1, U_S100.32 (D2)
/Orion68-IO/BD3: J200.5, J_S300.10, R203.1, U_S100.31 (D3)
/Orion68-IO/BD4: J200.6, J_S300.12, R204.1, U_S100.30 (D4)
/Orion68-IO/BD5: J200.7, J_S300.14, R205.1, U_S100.29 (D5)
/Orion68-IO/BD6: J200.8, J_S300.16, R206.1, U_S100.28 (D6)
/Orion68-IO/BD7: J200.9, J_S300.18, R207.1, U_S100.27 (D7)
/Orion68-IO/BD8: J200.10, J_S300.3
/Orion68-IO/BD9: J200.11, J_S300.5
/Orion68-IO/BD10: J200.12, J_S300.7
/Orion68-IO/BD11: J200.13, J_S300.9
/Orion68-IO/BD12: J200.14, J_S300.11
/Orion68-IO/BD13: J200.15, J_S300.13
/Orion68-IO/BD14: J200.16, J_S300.15
/Orion68-IO/BD15: J200.17, J_S300.17
/Orion68-IO/BUSY: J_S100.11, U_S100.15 (PC1)
/Orion68-IO/B/cpurd: J200.45, J_S300.25, U200.12 (IO8), U_S100.5 (~RD)
/Orion68-IO/B/cpurw: J200.46, J_S300.23, U200.13 (IO7), U_S100.36 (~WR)
/Orion68-IO/CS: J_S200.6, U_S200.22 (GP17)
/Orion68-IO/D0: J_S100.2, U_S100.4 (PA0)
/Orion68-IO/D1: J_S100.3, U_S100.3 (PA1)
/Orion68-IO/D2: J_S100.4, U_S100.2 (PA2)
/Orion68-IO/D3: J_S100.5, U_S100.1 (PA3)
/Orion68-IO/D4: J_S100.6, U_S100.40 (PA4)
/Orion68-IO/D5: J_S100.7, U_S100.39 (PA5)
/Orion68-IO/D6: J_S100.8, U_S100.38 (PA6)
/Orion68-IO/D7: J_S100.9, U_S100.37 (PA7)
/Orion68-IO/MISO: J_S200.3, U_S200.21 (GP16)
/Orion68-IO/MOSI: J_S200.4, U_S200.25 (GP19)
/Orion68-IO/RESET: J200.67, U_S100.35 (RESET)
/Orion68-IO/SCK: J_S200.5, U_S200.24 (GP18)
/Orion68-IO/SCL: J_S201.3, R213.2, U_S200.32 (GP27)
/Orion68-IO/SDA: J_S201.4, R214.2, U_S200.31 (GP26)
/Orion68-IO/STROBE: J_S100.1, U_S100.14 (PC0)
/Orion68-IO/TICK_IN: J200.86, U_S200.34 (GP28)
/Orion68-IO/audio: R_S401.1, U_S200.29 (GP22)
/Orion68-IO//CS_IDE: J_S300.37, U200.18 (IO2)
/Orion68-IO//CS_MULTIO: U200.15 (IO5), U_S200.26 (GP20)
/Orion68-IO//DASP: J_S300.39, R_S300.2
/Orion68-IO//IO_CS: J200.85, U200.11 (I10/~OE)
/Orion68-IO//RESET: J200.66, J_S300.1
/Orion68-MEM/BA1: J100.19, U101.12 (A0), U102.12 (A0), U103.12 (A0), U104.12 (A0), U105.12 (A0), U106.12 (A0), U107.12 (A0), U108.12 (A0)
/Orion68-MEM/BA2: J100.20, U101.11 (A1), U102.11 (A1), U103.11 (A1), U104.11 (A1), U105.11 (A1), U106.11 (A1), U107.11 (A1), U108.11 (A1)
/Orion68-MEM/BA3: J100.21, U101.10 (A2), U102.10 (A2), U103.10 (A2), U104.10 (A2), U105.10 (A2), U106.10 (A2), U107.10 (A2), U108.10 (A2)
/Orion68-MEM/BA4: J100.22, U101.9 (A3), U102.9 (A3), U103.9 (A3), U104.9 (A3), U105.9 (A3), U106.9 (A3), U107.9 (A3), U108.9 (A3)
/Orion68-MEM/BA5: J100.23, U101.8 (A4), U102.8 (A4), U103.8 (A4), U104.8 (A4), U105.8 (A4), U106.8 (A4), U107.8 (A4), U108.8 (A4)
/Orion68-MEM/BA6: J100.24, U101.7 (A5), U102.7 (A5), U103.7 (A5), U104.7 (A5), U105.7 (A5), U106.7 (A5), U107.7 (A5), U108.7 (A5)
/Orion68-MEM/BA7: J100.25, U101.6 (A6), U102.6 (A6), U103.6 (A6), U104.6 (A6), U105.6 (A6), U106.6 (A6), U107.6 (A6), U108.6 (A6)
/Orion68-MEM/BA8: J100.26, U101.5 (A7), U102.5 (A7), U103.5 (A7), U104.5 (A7), U105.5 (A7), U106.5 (A7), U107.5 (A7), U108.5 (A7)
/Orion68-MEM/BA9: J100.27, U101.27 (A8), U102.27 (A8), U103.27 (A8), U104.27 (A8), U105.27 (A8), U106.27 (A8), U107.27 (A8), U108.27 (A8)
/Orion68-MEM/BA10: J100.28, U101.26 (A9), U102.26 (A9), U103.26 (A9), U104.26 (A9), U105.26 (A9), U106.26 (A9), U107.26 (A9), U108.26 (A9)
/Orion68-MEM/BA11: J100.29, U101.23 (A10), U102.23 (A10), U103.23 (A10), U104.23 (A10), U105.23 (A10), U106.23 (A10), U107.23 (A10), U108.23 (A10)
/Orion68-MEM/BA12: J100.30, U101.25 (A11), U102.25 (A11), U103.25 (A11), U104.25 (A11), U105.25 (A11), U106.25 (A11), U107.25 (A11), U108.25 (A11)
/Orion68-MEM/BA13: J100.31, U101.4 (A12), U102.4 (A12), U103.4 (A12), U104.4 (A12), U105.4 (A12), U106.4 (A12), U107.4 (A12), U108.4 (A12)
/Orion68-MEM/BA14: J100.63, U101.28 (A13), U102.28 (A13), U103.28 (A13), U104.28 (A13), U105.28 (A13), U106.28 (A13), U107.28 (A13), U108.28 (A13)
/Orion68-MEM/BA15: J100.62, U101.3 (A14), U102.3 (A14), U103.3 (A14), U104.3 (A14), U105.3 (A14), U106.3 (A14), U107.3 (A14), U108.3 (A14)
/Orion68-MEM/BA16: J100.61, U101.31 (A15), U102.31 (A15), U103.31 (A15), U104.31 (A15), U105.31 (A15), U106.31 (A15), U107.31 (A15), U108.31 (A15)
/Orion68-MEM/BA17: J100.60, U101.2 (A16), U102.2 (A16), U103.2 (A16), U104.2 (A16), U105.2 (A16), U106.2 (A16), U107.2 (A16), U108.2 (A16)
/Orion68-MEM/BA18: J100.59, U101.30 (A17), U102.30 (A17), U103.30 (A17), U104.30 (A17), U105.30 (A17), U106.30 (A17), U107.30 (A17), U108.30 (A17)
/Orion68-MEM/BA19: J100.58, U101.1 (A18), U102.1 (A18), U103.1 (A18), U104.1 (A18), U105.1 (A18), U106.1 (A18), U107.1 (A18), U108.1 (A18)
/Orion68-MEM/BA20: J100.57, U100.1 (I1/CLK)
/Orion68-MEM/BA21: J100.56, U100.2 (I2)
/Orion68-MEM/BA22: J100.55, U100.3 (I3)
/Orion68-MEM/BA23: J100.54, U100.4 (I4)
/Orion68-MEM/BD0: J100.2, U101.13 (DQ0), U103.13 (DQ0), U105.13 (DQ0), U107.13 (DQ0)
/Orion68-MEM/BD1: J100.3, U101.14 (DQ1), U103.14 (DQ1), U105.14 (DQ1), U107.14 (DQ1)
/Orion68-MEM/BD2: J100.4, U101.15 (DQ2), U103.15 (DQ2), U105.15 (DQ2), U107.15 (DQ2)
/Orion68-MEM/BD3: J100.5, U101.17 (DQ3), U103.17 (DQ3), U105.17 (DQ3), U107.17 (DQ3)
/Orion68-MEM/BD4: J100.6, U101.18 (DQ4), U103.18 (DQ4), U105.18 (DQ4), U107.18 (DQ4)
/Orion68-MEM/BD5: J100.7, U101.19 (DQ5), U103.19 (DQ5), U105.19 (DQ5), U107.19 (DQ5)
/Orion68-MEM/BD6: J100.8, U101.20 (DQ6), U103.20 (DQ6), U105.20 (DQ6), U107.20 (DQ6)
/Orion68-MEM/BD7: J100.9, U101.21 (DQ7), U103.21 (DQ7), U105.21 (DQ7), U107.21 (DQ7)
/Orion68-MEM/BD8: J100.10, U102.13 (DQ0), U104.13 (DQ0), U106.13 (DQ0), U108.13 (DQ0)
/Orion68-MEM/BD9: J100.11, U102.14 (DQ1), U104.14 (DQ1), U106.14 (DQ1), U108.14 (DQ1)
/Orion68-MEM/BD10: J100.12, U102.15 (DQ2), U104.15 (DQ2), U106.15 (DQ2), U108.15 (DQ2)
/Orion68-MEM/BD11: J100.13, U102.17 (DQ3), U104.17 (DQ3), U106.17 (DQ3), U108.17 (DQ3)
/Orion68-MEM/BD12: J100.14, U102.18 (DQ4), U104.18 (DQ4), U106.18 (DQ4), U108.18 (DQ4)
/Orion68-MEM/BD13: J100.15, U102.19 (DQ5), U104.19 (DQ5), U106.19 (DQ5), U108.19 (DQ5)
/Orion68-MEM/BD14: J100.16, U102.20 (DQ6), U104.20 (DQ6), U106.20 (DQ6), U108.20 (DQ6)
/Orion68-MEM/BD15: J100.17, U102.21 (DQ7), U104.21 (DQ7), U106.21 (DQ7), U108.21 (DQ7)
/Orion68-MEM/BOOTIN: J100.87, U100.8 (I8)
/Orion68-MEM/B/AS: J100.43, U100.5 (I5)
/Orion68-MEM/B/LDS: J100.70, U100.6 (I6)
/Orion68-MEM/B/UDS: J100.71, U100.7 (I7)
/Orion68-MEM/B/cpurd: J100.45, U101.24 (OE#), U102.24 (OE#), U103.24 (OE#), U104.24 (OE#), U105.24 (OE#), U106.24 (OE#), U107.24 (OE#), U108.24 (OE#)
/Orion68-MEM/B/cpurw: U101.29 (WE#), U102.29 (WE#), U103.29 (WE#), U104.29 (WE#), U105.29 (WE#), U106.29 (WE#), U107.29 (WE#), U108.29 (WE#)
/Orion68-MEM//RAM1CS_H: U100.18 (IO2), U102.22 (CE#)
/Orion68-MEM//RAM1CS_L: U100.19 (IO1), U101.22 (CE#)
/Orion68-MEM//RAM2CS_H: U100.16 (IO4), U104.22 (CE#)
/Orion68-MEM//RAM2CS_L: U100.17 (I03), U103.22 (CE#)
/Orion68-MEM//RAM3CS_H: U100.14 (IO6), U106.22 (CE#)
/Orion68-MEM//RAM3CS_L: U100.15 (IO5), U105.22 (CE#)
/Orion68-MEM//RAM4CS_H: U100.12 (IO8), U108.22 (CE#)
/Orion68-MEM//RAM4CS_L: U100.13 (IO7), U107.22 (CE#)
/Orion68-VID/BA1: J300.19, R308.1
/Orion68-VID/BA2: J300.20, R309.1
/Orion68-VID/BA3: J300.21, R310.1
/Orion68-VID/BA4: J300.22, R311.1
/Orion68-VID/BA5: J300.23, R312.1
/Orion68-VID/BD0: J300.2, R300.1
/Orion68-VID/BD1: J300.3, R301.1
/Orion68-VID/BD2: J300.4, R302.1
/Orion68-VID/BD3: J300.5, R303.1
/Orion68-VID/BD4: J300.6, R304.1
/Orion68-VID/BD5: J300.7, R305.1
/Orion68-VID/BD6: J300.8, R306.1
/Orion68-VID/BD7: J300.9, R307.1
/Orion68-VID/SCL: U300.20 (GP15), U303.6 (SCL)
/Orion68-VID/SDA: U300.19 (GP14), U303.5 (SDA)
BA15: J300.62, U304.1 (I1/CLK)
BA16: J300.61, U304.2 (I2)
BA17: J300.60, U304.3 (I3)
BA18: J300.59, U304.4 (I4)
BA19: J300.58, U304.5 (I5)
B/AS: J300.43, U304.8 (I8)
B/LDS: J300.70, U304.6 (I6)
B/cpuwr: J300.46, U304.7 (I7)
GND: C_U0_1.2, C_U0_2.2, C_U1.2, C_U2.2, C_U3.2, C_U4.2, C_U5.2, C_U6.2, C_U7.2, C_U8.2, C_U9.2, C_U10.2, C_U11.2, C_U12.2, C_U13.2, C_Y1.2, D1.2 (A), D4.1 (K), J1.32, J1.64, J1.93, J1.95, J1.96, J100.32, J100.64, J100.93, J100.95, J100.96, J200.32, J200.64, J200.93, J200.95, J200.96, J300.32, J300.64, J300.93, J300.95, J300.96, J_S100.18, J_S100.19, J_S100.20, J_S100.21, J_S100.22, J_S100.23, J_S100.24, J_S100.25, J_S200.1, J_S201.6, J_S300.2, J_S300.19, J_S300.22, J_S300.24, J_S300.26, J_S300.28, J_S300.30, J_S300.40, LS_S400.2, Q1.1 (E), Q2.1 (E), Q3.1 (E), Q300.1 (E), Q_S400.3 (E), R6.2, U0.16 (GND), U0.17 (GND), U0.56 (GND), U0.57 (GND), U1.10 (GND), U2.10 (GND), U3.10 (GND), U4.10 (GND), U5.10 (GND), U6.10 (GND), U7.5 (EI), U7.8 (GND), U7.10 (IO), U8.10 (GND), U8.11 (I10/~OE), U9.16 (GND), U10.16 (GND), U11.2 (D), U11.7 (GND), U12.2 (MR), U12.7 (GND), U12.12 (MR), U13.12 (GND), U100.10 (GND), U101.16 (VSS), U102.16 (VSS), U103.16 (VSS), U104.16 (VSS), U105.16 (VSS), U106.16 (VSS), U107.16 (VSS), U108.16 (VSS), U200.10 (GND), U304.10 (GND), U_S100.7 (GND), U_S200.3 (GND), U_S200.8 (GND), U_S200.13 (GND), U_S200.18 (GND), U_S200.23 (GND), U_S200.28 (GND), U_S200.33 (GND), U_S200.38 (GND), U_S201.1 (A->B), U_S201.10 (GND), U_S201.19 (CE), U_S202.1 (A->B), U_S202.10 (GND), U_S202.11 (B7), U_S202.12 (B6), U_S202.13 (B5), U_S202.19 (CE), Y2.7 (GND)
IRQ2: J1.48, RN1.4 (R3), U7.12 (I2)
IRQ3: J1.49, RN1.5 (R4), U7.13 (I3)
IRQ4: J1.50, RN1.9 (R8), U7.1 (I4)
IRQ5: J1.89, RN1.8 (R7), U7.2 (I5)
IRQ6: J1.90, RN1.7 (R6), U7.3 (I6)
IRQ7: J1.91, RN1.6 (R5), U7.4 (I7)
unnamed: C_S400.2, LS_S400.1
unnamed: C2.2, D1.1 (K), R2.2, R6.1, R7.2, R8.2, SW2.1
unnamed: D2.2 (A), R16.1
unnamed: D3.2 (A), R5.1
unnamed: D4.2 (A), R4.1
unnamed: D_S300.1 (K), R_S300.1
unnamed: J3.5, J3.6, J3.7, J3.8
unnamed: Q1.2 (B), R7.1
unnamed: Q2.2 (B), R8.1
unnamed: C3.1, Q3.2 (B), R14.1
unnamed: C300.1, Q300.2 (B), R317.1
unnamed: Q_S400.2 (B), R_S401.2
unnamed: C_S400.1, Q_S400.1 (C), R_S400.2
unnamed: RN1.3 (R2), U7.11 (I1)
unnamed: R13.2, U0.12 (~BGACK)
unnamed: R15.2, U0.13 (~BR)
unnamed: R12.2, U0.23 (~VPA)
unnamed: R316.1, U300.36 (3V3(OUT)), U301.20 (VCC), U302.20 (VCC), U303.8 (VCC)
unnamed: U300.1 (GP0), U301.2 (A0)
unnamed: U300.2 (GP1), U301.3 (A1)
unnamed: U300.4 (GP2), U301.4 (A2)
unnamed: U300.5 (GP3), U301.5 (A3)
unnamed: U300.6 (GP4), U301.6 (A4)
unnamed: U300.7 (GP5), U301.7 (A5)
unnamed: U300.9 (GP6), U301.8 (A6)
unnamed: U300.10 (GP7), U301.9 (A7)
unnamed: U300.11 (GP8), U302.2 (A0)
unnamed: U300.12 (GP9), U302.3 (A1)
unnamed: U300.14 (GP10), U302.4 (A2)
unnamed: U300.15 (GP11), U302.5 (A3)
unnamed: U300.16 (GP12), U302.6 (A4)
unnamed: R315.1, U300.24 (GP18)
unnamed: R314.1, U300.25 (GP19)
unnamed: R313.1, U300.26 (GP20)
unnamed: U300.3 (GND), U300.8 (GND), U300.13 (GND), U300.18 (GND), U300.23 (GND), U300.28 (GND), U300.33 (GND), U300.38 (GND), U301.1 (A->B), U301.10 (GND), U301.19 (CE), U302.1 (A->B), U302.7 (A5), U302.8 (A6), U302.9 (A7), U302.10 (GND), U302.11 (B7), U302.12 (B6), U302.13 (B5), U302.19 (CE), U303.1 (A0), U303.2 (A1), U303.3 (A2), U303.4 (GND), U303.7 (WP)
unnamed: R300.2, U301.18 (B0)
unnamed: R301.2, U301.17 (B1)
unnamed: R302.2, U301.16 (B2)
unnamed: R303.2, U301.15 (B3)
unnamed: R304.2, U301.14 (B4)
unnamed: R305.2, U301.13 (B5)
unnamed: R306.2, U301.12 (B6)
unnamed: R307.2, U301.11 (B7)
unnamed: R308.2, U302.18 (B0)
unnamed: R309.2, U302.17 (B1)
unnamed: R310.2, U302.16 (B2)
unnamed: R311.2, U302.15 (B3)
unnamed: R312.2, U302.14 (B4)
unnamed: C300.2, R317.2, U304.19 (IO1)
unnamed: U_S200.1 (GP0), U_S201.2 (A0)
unnamed: U_S200.2 (GP1), U_S201.3 (A1)
unnamed: U_S200.4 (GP2), U_S201.4 (A2)
unnamed: U_S200.5 (GP3), U_S201.5 (A3)
unnamed: U_S200.6 (GP4), U_S201.6 (A4)
unnamed: U_S200.7 (GP5), U_S201.7 (A5)
unnamed: U_S200.9 (GP6), U_S201.8 (A6)
unnamed: U_S200.10 (GP7), U_S201.9 (A7)
unnamed: U_S200.11 (GP8), U_S202.2 (A0)
unnamed: U_S200.12 (GP9), U_S202.3 (A1)
unnamed: U_S200.14 (GP10), U_S202.4 (A2)
unnamed: U_S200.15 (GP11), U_S202.5 (A3)
unnamed: R200.2, U_S201.18 (B0)
unnamed: R201.2, U_S201.17 (B1)
unnamed: R202.2, U_S201.16 (B2)
unnamed: R203.2, U_S201.15 (B3)
unnamed: R204.2, U_S201.14 (B4)
unnamed: R205.2, U_S201.13 (B5)
unnamed: R206.2, U_S201.12 (B6)
unnamed: R207.2, U_S201.11 (B7)
unnamed: R208.2, U_S202.18 (B0)
unnamed: R209.2, U_S202.17 (B1)
unnamed: R210.2, U_S202.16 (B2)
unnamed: R211.2, U_S202.15 (B3)
unnamed: R212.2, U_S202.14 (B4)
/CS: Q300.3 (C), R316.2, U300.17 (GP13)
/IO_CS: J300.85, U304.9 (I9)
