ppsilv/Orion68/software/dev/kernel/vfs/vfs_drivers.c

#include <sys/vfs.h>

/*
 *
Forma 1 — a que eu mostrei nos exemplos genéricos (com device_register)

c
device_t *device_table[MAX_DEVICES];
void device_register(device_t *dev) {
    device_table[device_count++] = dev;
}

Aqui, a tabela é preenchida em tempo de execução, chamando uma função no boot pra cada driver.

Forma 2 — a que você realmente usa no oriondos

c
DeviceDriver drivers[] = {
    {"/dev/tty", tty_open, ...},
    {"/dev/null", null_open, ...},
    {"/dev/serial0", serial_open, ...},  // já "registrado" aqui
    {NULL, ...}
};

Aqui, a tabela já nasce pronta, escrita como array literal direto no código-fonte. Não existe um passo de "registro" separado — o simples fato de você escrever a linha na array já é o registro.
 *
 */

// ============================================
// DECLARAÇÕES EXTERNAS DOS DRIVERS
// ============================================
extern int tty_open(File *file, const char *path, int flags);
extern int tty_read(File *file, void *buffer, size_t size);
extern int tty_write(File *file, const void *buffer, size_t size);
extern int tty_close(File *file);
extern int tty_ioctl(File *file, int cmd, void *arg);
extern size_t tty_lseek(File *file, size_t offset, int whence);

extern int null_open(File *file, const char *path, int flags);
extern int null_read(File *file, void *buffer, size_t size);
extern int null_write(File *file, const void *buffer, size_t size);
extern int null_close(File *file);
extern size_t null_lseek(File *file, size_t offset, int whence);

extern int zero_open(File *file, const char *path, int flags);
extern int zero_read(File *file, void *buffer, size_t size);
extern int zero_write(File *file, const void *buffer, size_t size);
extern int zero_close(File *file);
extern size_t zero_lseek(File *file, size_t offset, int whence);

extern int proc_meminfo_open(File *file, const char *path, int flags);
extern int proc_cpuinfo_open(File *file, const char *path, int flags);
extern int proc_uptime_open(File *file, const char *path, int flags);
extern int proc_read(File *file, void *buffer, size_t size);
extern int proc_close(File *file);
extern size_t proc_lseek(File *file, size_t offset, int whence);
/*Nova entrada*/
extern int serial_open(File *file, const char *path, int flags);
extern int serial_read(File *file, void *buffer, size_t size);
extern int serial_write(File *file, const void *buffer, size_t size);
extern int serial_close(File *file);
extern size_t serial_lseek(File *file, size_t offset, int whence);


extern int duartA_open(File *file, const char *path, int flags);
extern int duartA_read(File *file, void *buffer, size_t size);
extern int duartA_write(File *file, const void *buffer, size_t size);
extern int duartA_ioctl(File *file, int cmd, void *arg);
extern int duartA_close(File *file);
extern size_t duartA_lseek(File *file, size_t offset, int whence);

// ============================================
// TABELA DE DRIVERS
// ============================================
/*
DeviceDriver drivers[] = {
    {"/dev/tty",      tty_open,          tty_read,    tty_write,    tty_close,    tty_ioctl,    tty_lseek},
    {"/dev/null",     null_open,         null_read,   null_write,   null_close,   NULL,         null_lseek},
    {"/dev/zero",     zero_open,         zero_read,   zero_write,   zero_close,   NULL,         zero_lseek},
    {"/proc/meminfo", proc_meminfo_open, proc_read,   NULL,         proc_close,   NULL,         proc_lseek},
    {"/proc/cpuinfo", proc_cpuinfo_open, proc_read,   NULL,         proc_close,   NULL,         proc_lseek},
    {"/proc/uptime",  proc_uptime_open,  proc_read,   NULL,         proc_close,   NULL,         proc_lseek},
    {NULL, NULL, NULL, NULL, NULL, NULL, NULL}
};
*/
DeviceDriver drivers[] = {
    {"/dev/tty",      tty_open,          tty_read,    tty_write,    tty_close,    tty_ioctl,    tty_lseek},
    {"/dev/null",     null_open,         null_read,   null_write,   null_close,   NULL,         null_lseek},
    {"/dev/zero",     zero_open,         zero_read,   zero_write,   zero_close,   NULL,         zero_lseek},
    {"/dev/serial0",  serial_open,       serial_read, serial_write, serial_close, NULL,         serial_lseek},  // <-- nova linha
    {"/proc/meminfo", proc_meminfo_open, proc_read,   NULL,         proc_close,   NULL,         proc_lseek},
    {"/proc/cpuinfo", proc_cpuinfo_open, proc_read,   NULL,         proc_close,   NULL,         proc_lseek},
    {"/proc/uptime",  proc_uptime_open,  proc_read,   NULL,         proc_close,   NULL,         proc_lseek},
    {"/dev/tty0",     duartA_open,       duartA_read, duartA_write, duartA_close, duartA_ioctl, duartA_lseek},
    {"/dev/console",  duartA_open,       duartA_read, duartA_write, duartA_close, duartA_ioctl, duartA_lseek},
    {NULL, NULL, NULL, NULL, NULL, NULL, NULL}
};
