ppsilv/Orion68/(commit log)

2026-09-09 New orioncor programming eeprom via ob.elf
    [cpu2.kicad_sch]
2026-09-12 Code running well after clean-up
    [orion68io.kicad_sch]
